mrehkopf/sd2snes/www/themes/editor/img/1.png

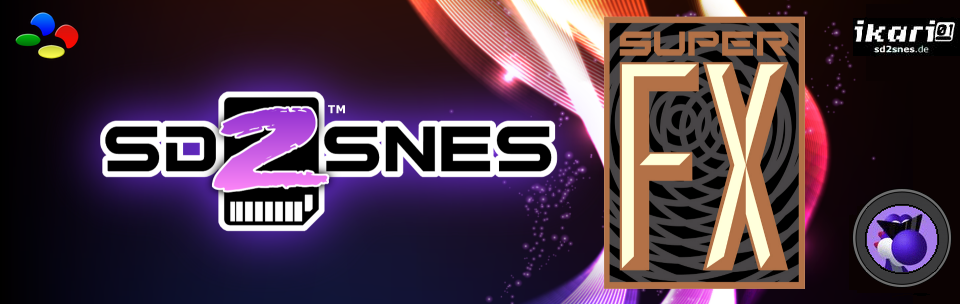
www/themes/editor/img/1.png
