mrehkopf/sd2snes/cic/supercic/1chip-5060-back.jpg

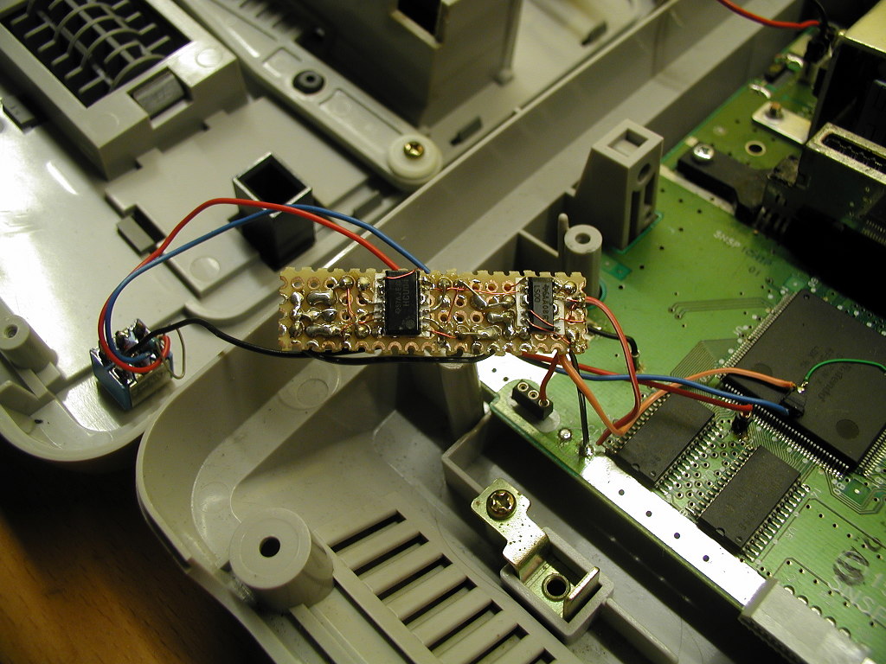
cic/supercic/1chip-5060-back.jpg
