mrehkopf/sd2snes/README.md

sd2snes
=======

SD card based multi-purpose cartridge for the SNES

See [FURiOUS's README](README.Savestates.FURiOUS.md) for information on Save States!
