mrehkopf/sd2snes/pcb/kicad/prod/sd2snes2A_2NEW/README.txt

sd2snes-PCB_Edges.gbr is the PCB outline file.
