mrehkopf/sd2snes/cic/supercic/1chip-5060-front.jpg

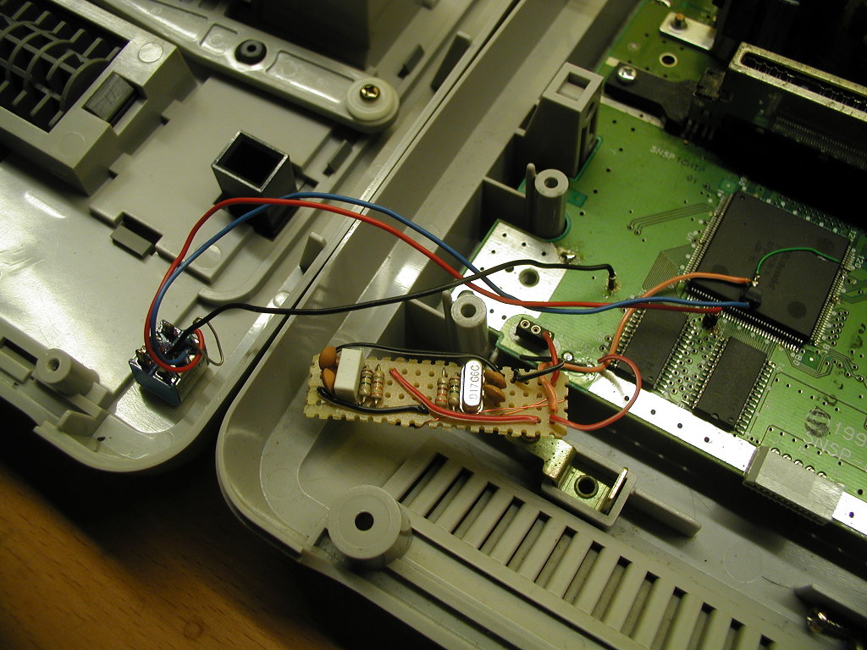
cic/supercic/1chip-5060-front.jpg
