mrehkopf/sd2snes/cic/supercic/supercic-snes.jpg

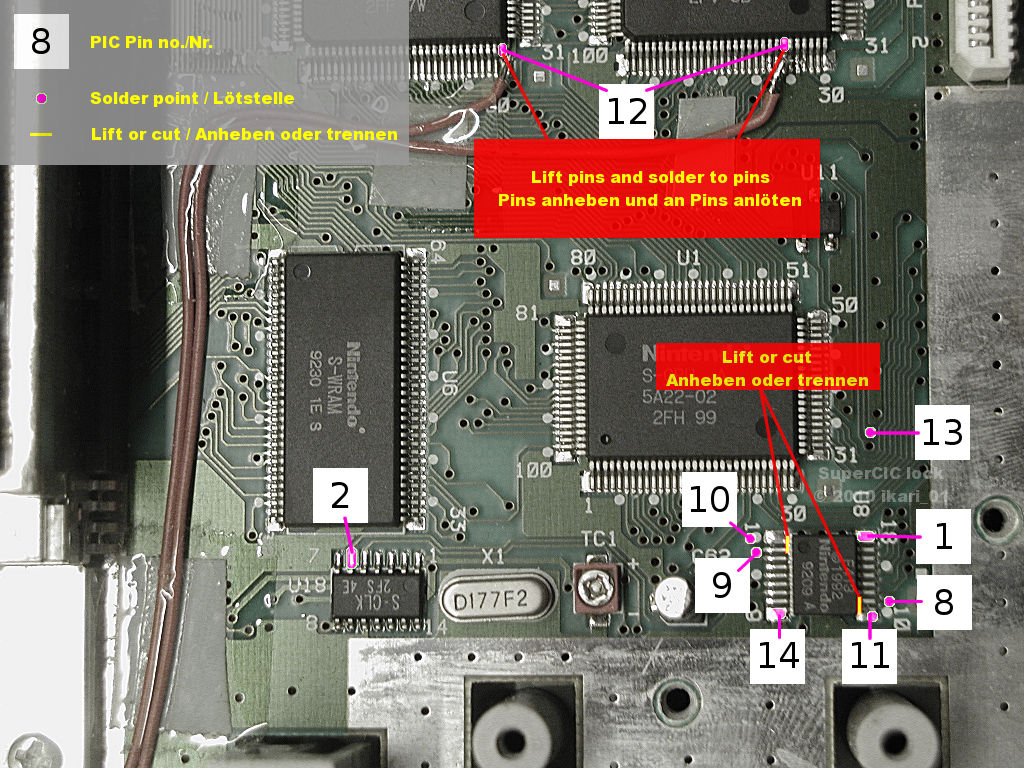
cic/supercic/supercic-snes.jpg
