mrehkopf/sd2snes/cic/supercic/supercic.png

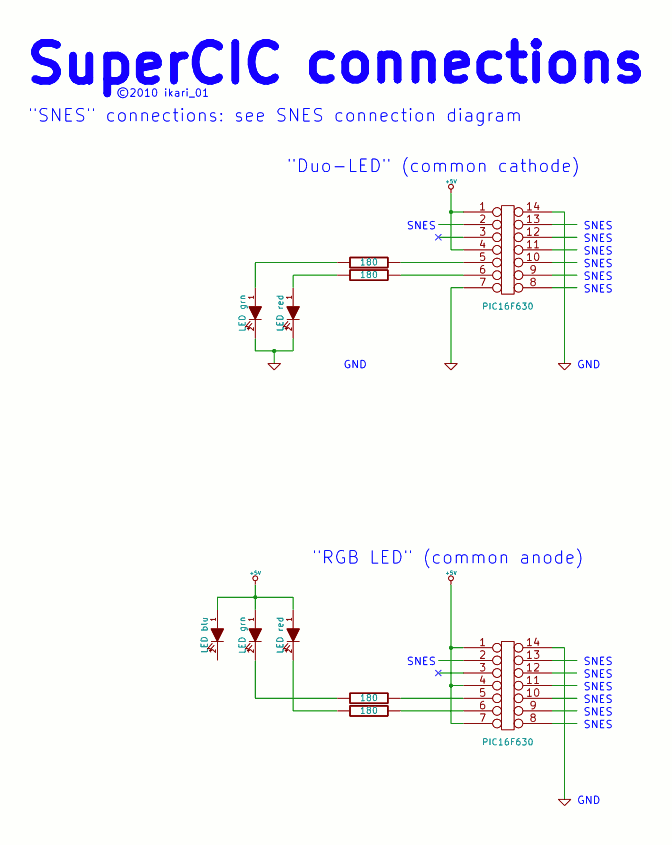
cic/supercic/supercic.png
