mrehkopf/sd2snes/www/themes/editor/img/3.jpg

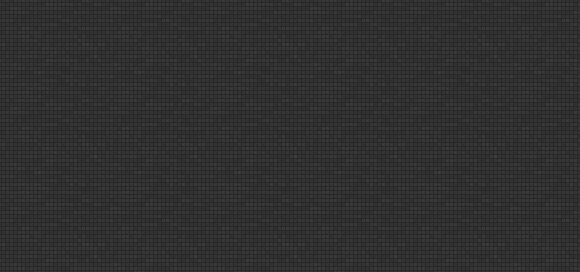
www/themes/editor/img/3.jpg
