mrehkopf/sd2snes/www/themes/editor/img/text_file_1.png

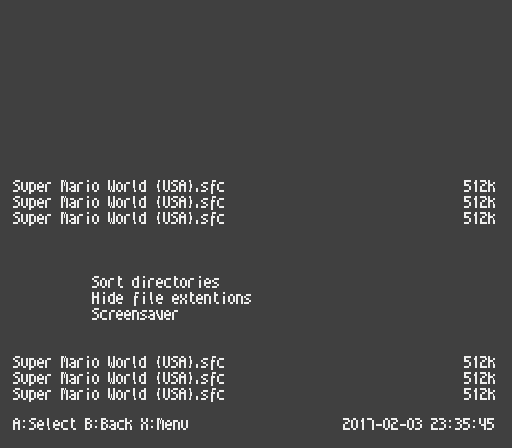
www/themes/editor/img/text_file_1.png
