mrehkopf/sd2snes/www/themes/editor/img/text_folder_1.png

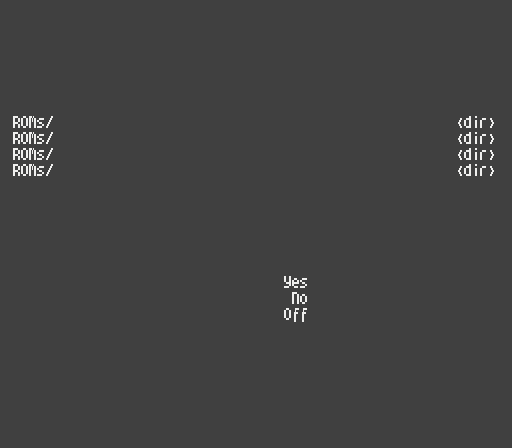
www/themes/editor/img/text_folder_1.png
