mrehkopf/sd2snes/www/themes/editor/img/text_menu_1.png

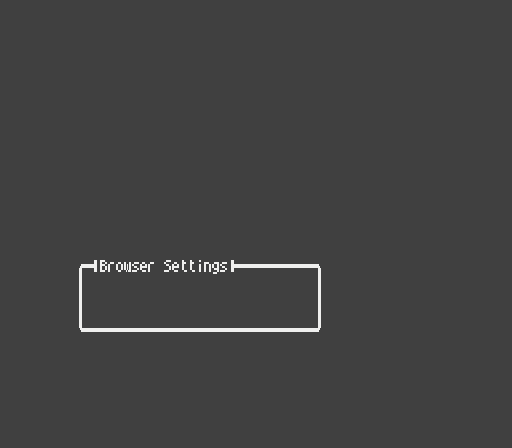
www/themes/editor/img/text_menu_1.png
