mrehkopf/sd2snes/www/themes/editor/img/text_unfocused_3.png

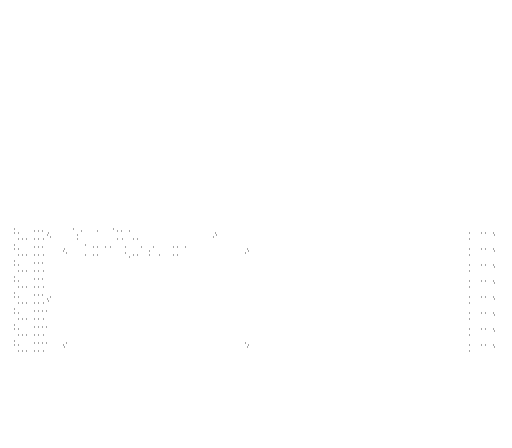
www/themes/editor/img/text_unfocused_3.png
