mrehkopf/sd2snes/www/themes/img/2.png

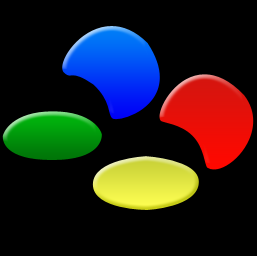
www/themes/img/2.png
