mrehkopf/sd2snes/pcb/kicad/RevF/sd2snes-BOM.ods

sd2snes – bill of materials |  |  |  | Rev.F
open | Suppliers: | CSD | http://www.csd-electronics.de |  |  |  |  | Enter Qty:
in cart |  | Digikey | http://digikey.com
ordered |  | FutE | http://www.futureelectronics.com |  |  |  |  | 1
shipped |  | Reichelt | http://www.reichelt.de
in stock |  | RS | http://rsonline.de
 |  | PCBCart | http://www.pcbcart.com
Designator | Package | Quantity | Designation | Manufacturer | Supplier1 | Ref1 | Supplier2 | Ref2 | Qty (1 pcs.)
BT351 | BT_KEYSTONE_1059_20MM | 1 | Keystone_1059 | Keystone or other | Reichelt | KZH20PCB | Digikey | 1059K-ND | 1
C128,C127,C126,C125,C124,C123,C122,C121,C408,C409 | SM0805_FIXEDMASK | 10 | 10p | * | CSD | 115-08C010 |  |  | 10
C301,C303,C304,C322,C312,C321,C311 | SM0805_FIXEDMASK | 7 | 4.7u X5R/X7R | * | Reichelt | X7R-G0805 4,7/16 |  |  | 7
C302,C347,C349 | SM0805_FIXEDMASK | 3 | 10n | * | CSD | 115-08N010 |  |  | 3
C333,C332 | SM0805_FIXEDMASK | 2 | 100p | * | CSD | 115-08C100 |  |  | 2
C342 | SM0805_FIXEDMASK | 1 | 1u X5R/X7R | * | CSD | 115-08R001 |  |  | 1
C348,C346 | SM0805_FIXEDMASK | 2 | 3.3u X5R/X7R | * | RS | 698-3560 |  |  | 2
C407,C406 | SM0805_FIXEDMASK | 2 | 33p | * | CSD | 115-08C033 |  |  | 2
C411,C344,C345 | SM0805_FIXEDMASK | 3 | 10u X5R | * | Reichelt | X5R-G0805 10/16 |  |  | 3
C412,C405,C502,C511,C501,C116,C115,C114,C103,C102,C101,C341,C331,C222,C221,C213,C212,C211,C210,C208,C207,C206,C205,C204,C203,C202,C201,C223,C224,C401,C402,C403,C404,C343,C104,C105,C106,C113,C112,C111,C214,C209,C231,C215,C232,C233,C234 | SM0805_FIXEDMASK | 47 | 100n | * | CSD | 115-08N100 |  |  | 47
D401 | LED-3MM-FIXED | 1 | LED_2mA_1.9V,_green | Kingbright | Reichelt | LED 3MM 2MA GN | other low current types ok |  | 1
D402 | LED-3MM-FIXED | 1 | LED_2mA_1.8V,_yellow | Kingbright | Reichelt | LED 3MM 2MA GE | other low current types ok |  | 1
D403 | LED-3MM-FIXED | 1 | LED_2mA_1.7V,_red | Kingbright | Reichelt | LED 3MM 2MA RT | other low current types ok |  | 1
D401, D402, D403 | SPACER | 3 | LED SPACER .250“ T1 | Keystone or other | Digikey | 7358K-ND |  |  | 3
D511 | SOT23EBC | 1 | BAT54C | Fairchild or other | Reichelt | BAT 54C SMD |  |  | 1
FB341 | SM0805_FIXEDMASK | 1 | LF0805A252R-10 | Laird | Digikey | 240-2563-1-ND |  |  | 1
J411 | HRS-DM1AA | 1 | DM1AA-SF-PEJ(21) | Hirose | RS | 502-5004 |  |  | 1
J421 | USB-MINIB | 1 | 690-005-299-043 | EDAC | Digikey | 151-1206-1-ND | Reichelt | USB BWM SMD | 1
JP341 | SM0603 (Ferrite bead!) | 1 | HZ0603A252R-10 | Laird | Digikey | 240-2561-1-ND |  |  | 1
L302,L301 | SM1210L_NEW | 2 | LQH32PN1R0NN0L | Murata | Digikey | 490-5334-1-ND |  |  | 2
Q301 | SOT23DGS | 1 | IRLML6402PbF | IR | FutE | 1012640 |  |  | 1
Q511,Q101 | SOT23EBC | 2 | MMBT2222A | Fairchild or other | Reichelt | 2N 2222A SMD |  |  | 2
R101 | SM0805_FIXEDMASK | 1 | 270 | * | CSD | 10-080270 |  |  | 1
R301,R511 | SM0805_FIXEDMASK | 2 | 20k | * | CSD | 10-08K020 |  |  | 2
R331,R403,R401,R402,R332,R333 | SM0805_FIXEDMASK | 6 | 680 | * | CSD | 10-080680 |  |  | 6
R343,R341 | SM0805_FIXEDMASK | 2 | 470 | * | CSD | 10-080470 |  |  | 2
R404,R344,R342,R407 | SM0805_FIXEDMASK | 4 | 10k | * | CSD | 10-08K010 (reel) |  |  | 4
R406,R405 | SM0805_FIXEDMASK | 2 | 100 | * | CSD | 10-080100 |  |  | 2
R421,R422 | SM0805_FIXEDMASK | 2 | 33 | * | CSD | 10-080033 |  |  | 2
R423 | SM0805_FIXEDMASK | 1 | 1.5k | * | CSD | 10-08K001,5 |  |  | 1
R512,R103 | SM0805_FIXEDMASK | 2 | 4k7 | * | CSD | 10-08K004,7 |  |  | 2
R513,R102 | SM0805_FIXEDMASK | 2 | 100k | * | CSD | 10-08K100 (reel) |  |  | 2
RA101,RA102,RA105,RA106,RA107,RA108,RA109,RA110,RA111,RA112,RA113,RA114 | RA4_1206 | 12 | 4x100R_parallel | e.g. Rohm | Digikey | RHM1594CT-ND |  |  | 12
RA103,RA104 | FB4_1206 | 2 | BK32164M241-T | Taiyo Yuden | Digikey | 587-2690-1-ND |  |  | 2
U101,U103,U102 | TSSOP48 | 3 | 74ALVC164245DGG | TI, NXP | Digikey | 568-1377-5-ND | RS | 662-6374 | 3
U201 | PQFP208 | 1 | XC3S400-PQ208 | Xilinx | Digikey | 122-1519-ND |  |  | 1
U301 | QFN10-2x2 | 1 | MIC23250-S4YMT | Micrel | FutE | 5760004 | Digikey | 576-3561-1-ND | 1
U311 | SOT23-5 | 1 | MCP1824T-1802E/OT | Microchip | Digikey | MCP1824T-1802E/OTCT-ND |  |  | 1
U321 | SOT23-5 | 1 | MCP1824T-2502E/OT | Microchip | Digikey | MCP1824T-2502E/OTCT-ND |  |  | 1
U331 | DIP-8__300 | 1 | PIC12F629I/P | Microchip | Reichelt | PIC 12F629-I/P |  |  | 1
U341 | TSSOP10 | 1 | CS4344-CZZ | Cirrus | Digikey | 598-1051-5-ND | CSD | 21455 | 1
U401 | LQFP80-.5 | 1 | LPC1754FBD80 | NXP | Digikey | 568-4790-ND | FutE |  | 1
U501 | VFBGA54 | 1 | MT45W8MW16BGX-701WT/IT | Micron | Digikey | 557-1444-1-ND |  |  | 1
U511 | TSOPII-32 | 1 | CY62148EV30LL-45ZSXI | Cypress | FutE |  |  |  | 1
X401 | HC49USMD | 1 | ATS12ASM-1 | CTS-Frequency Controls or other | Digikey | CTX1079CT-ND | Reichelt | 12,0000- HC49-SMD | 1
X402 | XTAL_SMD_05019 | 1 | ABS10-32.768KHZ-9-T | Abracon Corporation or other 9pF | Digikey | 535-9538-1-ND | Reichelt | 32,768 CC4V-9 | 1
L391 | SM1210L_NEW | 1 | LQH32CN100K23 | Murata | Digikey | 587-2679-1-ND |  |  | 1
C391 | SM1210 | 1 | GRM31CR60J107ME39L | Murata | Digikey | 490-4539-1-ND |  |  | 1
