mrehkopf/sd2snes/(threads)

Thread 11 (2012-04-04):

Satellaview hardware seems to interfere with compatibility.

KiddoCabbusses, 2012-04-04:
I've discussed this with ikari_01 over IRC already, but here it is up here so anyone else who wants to discuss it may know.

Certain ROMs may behave differently depending on whether or not the sd2snes is connected to a Super Famicom with a Satellaview hardware base attached, or a more standard setup.
Currently the known examples are the "BS The Legend of Zelda: Ancient Stone Tablets" ROM hacks, where they operate as expected on a sd2snes, but bug out when a Satellaview hardware base is plugged in.
I will note that on my previous ROM loader, the SFC Neo Myth, whether or not the Satellaview hardware was plugged in had no effect on the compatibility.

http://z9.invisionfree.com/bszelda/index.php?showtopic=1275&view=findpost&p=22000060

mrehkopf, 2016-06-20:
Super Bomberman has been fixed in the meantime, the cause being that the BSX BIOS itself crashes when attempting to load games to PSRAM from Type 2 packs (seriously).
The fix was to implement Type 1 packs instead. The light on the base unit lighting up was probably just a rogue write carried out by the crashing BIOS.
Do any issues remain with the base unit attached? The only thing I could do about it would be to disable all base unit related features on the sd2snes when a real base unit is detected. It will affect compatibility though (clock packets etc.)

mrehkopf, 2018-04-13:
Bump

mrehkopf, 2018-12-19:
#106

Closed 2018-12-19.

Thread 28 (2012-09-23):

Part-size BS-X games might not have their checksum calculated correctly

redeemer665, 2012-09-23:
When checking and calculating the checksum of BS-X software upon booting it should be done only on the data banks indicated by the size byte at 0x7FD0 (or 0xFFD0), instead of simply summing all bytes in the ROM image. This is especially crucial with 8M cartridge images which have more than one program.

However there might be something else as well as I did a quick test with "BS Satesupo  DX Dai-4-Gou" (MD5: 442384ED70AF69F594C8CEC93E6DE81E) which has a size byte of 07h meaning the data is in the first three banks (3 Mb). Checksum is correct but it won't boot on sd2snes, it isn't giving me "Error 09" though.

When I change the internal size (0x7FD0) to FFh, ROM type byte (0x7FD9) to Full size (10h) and calculate a new checksum (5AD2, inverse A52D) everything works perfectly.

mrehkopf, 2016-09-21:
The standalone 3ji no Wide Shou dump is an interesting case - it has a seemingly invalid header (vector table is filled with 0xffff) but the BSX BIOS knows how to run it anyway. sd2snes currently doesn't detect a valid header (every possible header locations gets a score of 0 due to the invalid vector table) and runs it as fallback (plain LoROM, no BSX). Needless to say that doesn't work either. ;) I tweaked header detection a bit to allow for detection, hopefully with no impact on other (mostly PD) ROM detection.

@LuigiBlood - have you seen something like it? How does the BSX BIOS know how to run such a game?

LuigiBlood, 2016-09-21:
It's a ROM that runs on BS-X's script system.
The header has the info, after "01", you see 0x00000100 (in little endian). That's what tells the BS-X it is a script-based software.

Closed 2018-11-20.

Thread 31 (2012-10-20):

Feature request: Favorites list

magu, 2012-10-20:
It would be awesome to have the possibility to flag certain roms as favorites, and then to be able to filter by that. This would significantly help when browsing a large rom collection, so you could just flag what you for example currently play to find it quickly in the list instead of moving stuff around physically on the file system to a "currently playing" or favorites folder.

Easy way to implement this UI-wise would be to for example toggle favorite status with one button in the file browser, and then have another button switch between the file browser and a sorted list of favorites. Favorite status could be indicated with anything subtile in the file browser, like a small asterisk next to rom size, or anything similar. Toggling favorite status wile browsing the favorites list would also remove the rom from the list instantaneously.

(By the way, the sd2snes is awesome! Got mine yesterday and couldn't be more satisfied.)

mrehkopf, 2021-08-02:
Integrated in v1.11.0b1 :)

Closed 2021-08-02.

Thread 32 (2012-10-20):

Feature request: Force region of sd2snes menu

magu, 2012-10-20:
My SNES is a PAL one with SuperCIC and IGR installed. The SuperCIC is wired with REG_TIMEOUT set to high, and i normally use it with force 60 Hz. Since the sd2snes detects the SNES as being a PAL one (I assume) it identifies as a PAL game, thus making the timeout trigger and show the sd2snes menu in 50 Hz for ~9 seconds on every boot.

This is quite annoying, and it would be awesome to be able to force the sd2snes menu to identify as a particular region, through a menu item or the like. (I could of course open the SNES up and rewire REG_TIMEOUT to low, but I quite like it this way when playing original cassettes.)

I assume this is sort of related to "supports software 50/60Hz switching on SuperCIC enhanced consoles only (to be performed by sd2snes firmware, not yet implemented there)", and perhaps will get added when that is implemented.

magu, 2015-09-19:
Am I correct in noting that this is now implemented in 0.1.7pre4? I've set the config file to force 60 Hz/60 Hz, and never see the abominable 50 Hz stripes any more.

mrehkopf, 2015-09-20:
Yes, if you also set PairModeAllowed to true it will do that exactly. ;)

magu, 2015-09-20:
Yup, I had done that. This makes me happy, and my 5 years old son less confused. Thanks a bunch!

mrehkopf, 2016-06-20:
Implemented and integrated in v0.1.7b

Closed 2016-06-20.

Thread 33 (2012-10-22):

Disable automatic region patching on Ultra16 consoles

mrehkopf, 2012-10-22:
The Ultra16 has its own region patching circuitry that the sd2snes interferes with, producing an Error 6 or Error 7 on startup. This does not harm normal operation and can be safely ignored, but is annoying.
Detect the Ultra16 hardware and disable the sd2snes's region patching accordingly.

mrehkopf, 2016-09-09:
AFAIK we have this in working condition now? U16 doesn't spew any more errors. :)

Closed 2016-09-09.

Thread 39 (2013-08-06):

Feature request: cheat code support

sammargh, 2013-08-06:
It would be nice if SD2SNES would support PAR/GG codes on games. Krikzz has been also implementing a load cheats from txt file on his everdrives as of recent which is extremely handy for lengthy codes. What would be ideal would be to setup a large flat file with identifiers such as the CRC or the header content and use YAML or something similar to have something much easier to manage.

mrehkopf, 2015-06-22:
Actually there seem to be two different versions of the CHT format. The one that says "FE FC" has 20 character descriptions. There is another one with different values that only has 13 character descriptions. I never saw that one in the wild but zsnes source code suggests its existence.

sammargh, 2015-06-22:
Maybe it'd be better to use the DSTwo CHT format as it's more human-readable and won't require hex editors to create:
https://gbatemp.net/threads/guide-make-snes-cht-files-for-the-dstwo.263113/

Would require manually converting GG codes but it would at least allow for a single file for all roms. This also would get around the limitation of figuring out which rom to use as it is up to the user to identify or to add a CRC field in the GameInfo portion if you want to limit the usage.

sammargh, 2015-06-22:
Ah, whoops. Looks like the emulator CATSFC switched to BSNES-style cheats. Pretty clean format, XML driven using SHA256 for rom identification:
```xml
<cartridge sha256="44428a3d1c796fbd41da7620e321c45f11cd80a0e5f4ab8c48177106cb960d77">
<name>Wolverine - Adamantium Rage (USA)</name>
<cheat>
<description>Invincibility</description>
<code>7E00B8FF</code>
</cheat>
</cartridge>
```

mrehkopf, 2015-06-22:
Checksum driven auto game matching isn't very feasible on the sd2snes. Finding cheats for a given ROM might be ok as you only need to calc the ROM checksum (but still need to scan through the whole cheats file).
Finding a ROM based on a given checksum is impossible, all ROMs would have to be scanned and calculated. Takes hours at best ;)
I think I'll stick with the "one file per ROM" method. I'm not a big fan of the SNES .CHT format anymore though - the description text is so limited, and it doesn't support multiple codes per cheat.
I like a format like this, it's simple to parse and still somewhat editable by hand:
```
7e00b8ff Invincibility
7e0f34ff, 7e0f35ff, 7e0f36ff Highscore On
ec8ad793 Jump
```
I could also stick to an existing format used by a flash cart but I think neither SNES Powerpak nor Super Everdrive actually save codes to card?

sammargh, 2015-06-22:
I know the super everdrive supports loading cheats from a txt file however it's GG only and pretty limited in how it works. Basically you make a text file with only the GG code in it and the Everdrive loads it. Not very elegant and your solution would work better plus those codes could easily be converted and adapted to your format.

One thing that would be nice but not necessary is if you could have a sub-directory to your roms for the cheats to be loaded from to keep things organized

mrehkopf, 2015-06-23:
I see. I might release an intermediate version with a "text-file only" cheat interface and of course I'd like to re-use that format for the GUI controlled cheats later. Another proposal, this would be a disabled cheat:
```
#7e00b8ff Invincibility
```
Actually I would regard any line that doesn't start with a parseable hex number as disabled/invalid.
Also I would like to support both GG and PAR codes for manual input. They can be distinguished by the '-' character in the middle.
I also want to allow GG and PAR codes in the GUI but always handle them as PAR codes internally (and save them to the text file that way too).
Oh, and I forgot to mention - I was actually going to put the cheat files in a separate folder (like /sd2snes/cheats) with <romname.cht> or similar.
As I am now going to use my own format for the cheats, do you think it would be better to choose a different file extension, too? .cht is kind of reserved for the original CHT format. Just .txt maybe? But then it's not very clear that the files are meant to contain cheats.... hm.

sammargh, 2015-06-23:
Probably would be wise to use a different format for the extension so people don't confuse the type. One last consideration which may or may not be possible is to use YAML for the codes as that would make editing them and reading them quite easy for a human as well as parsing but I'm not sure how powerful the FPGA is or if it is even capable of parsing/editing YAML. An example could be as such:

Filename: Example Rom (USA).sfc
Cheat name: cheats/Example Rom (USA).yml
```yaml
---
- Name: Invincibility
  Code:
   AAAA-AAAA
   BBBB-BBBB
  Enabled:
   True
- Name: Infinite Money
  Code:
   12345678
  Enabled:
   False
```

Then to enable/disable it requires changing the boolean flag on each code.

Also be sure that whatever filename matching you are using is not prone to the 8.3 bug that SRAM lookup has where if you have multiple files it doesn't assume the first of multiple files by not using the long name.

mrehkopf, 2015-06-23:
YAML seems like a sane choice, very readable (as opposed to say XML) and easy to parse. I think I'll go for that. Also it has been suggested by two people now ;)
I have proper LFN support in place so there should never be any file name mismatches.

magu, 2015-06-24:
+1 YAML, makes it three.

mrehkopf, 2015-06-24:
YAML it is, then.

mrehkopf, 2015-06-24:
The parser/generator will be minimalist, probably even supporting only even a subset of the eYAML parser proposed here: https://github.com/yaml/YAML2/wiki/eYAML
Advanced features of YAML aren't required for storing the cheat data.

sammargh, 2015-06-24:
Sounds good! When you have the support finalized I'd like to know so I can begin work on some python scripts to handle creating codes.

Using BSNES' system I should be able to handle implementing codes from existing packs pretty easily for any game regardless of knowing the file name since they're identified by sha256 and reformat codes accordingly.

mrehkopf, 2015-07-10:
Generic parser is done, now to bolt on the specifics for cheat files.

mrehkopf, 2016-06-20:
Cheats via YAML files are implemented since v0.1.7. Stay tuned for the cheat menu in v0.1.8 ;)

Closed 2016-06-20.

Thread 51 (2015-03-31):

Acoustic warning on in-game file system errors

mrehkopf, 2015-03-31:
Many sd2snes sold on the market have shells that conceal the LEDs so the LED blink codes cannot be seen. Attempt to play an acoustic warning when auto-saving fails for some reason.

TheShadowRunner, 2017-03-28:
I think this would be most suited :)
[LTTP_Error.zip](https://github.com/mrehkopf/sd2snes/files/876929/LTTP_Error.zip)

ramapcsx2, 2017-04-12:
On that note ( :p ), some kind of SRAM backup would be nice to have as well. When saving fails for some reason, it can wipe out hours of gameplay. It'd be great to have some backup then to go back to.

Thread 53 (2015-04-20):

No sound in MSU1 video player on higan 094 + fix ;-)

Ramsis-SNES, 2015-04-20:
I noticed that the MSU1 video player included in the sd2snes source package doesn't work correctly on higan 094 (there's no sound to be heard). This seems due to the fact that the code doesn't set the volume.

Adding these lines somewhere in the `msu1init` routine (e.g. after line 15) fixed it:

```
    lda #$FF
    sta MSU_VOLUME
```

We should be aware that this means there exists a discrepancy in MSU1 implementation between sd2snes (where the music is played even without the volume register being set) and higan 094. ;-)

mrehkopf, 2015-04-20:
http://forums.nesdev.com/viewtopic.php?p=125863&sid=9d0f832d4cee24791dae503c8187089b#p125863
1st paragraph
Initial volume is kind of mushy in the standard. ;)

mrehkopf, 2015-04-20:
Nevertheless, I agreed upon initial volume 0 and the player will be fixed accordingly

Ramsis-SNES, 2015-04-20:
Cool, thank you! :-)

mrehkopf, 2015-06-22:
This change is now implemented on sd2snes and will be in the 0.1.7 release.

Ramsis-SNES, 2015-06-22:
Sounds good! :D

borti4938, 2015-09-01:
There are several MSU1 videos out there who are not setting the volume register. Hence, with the current implementation you hear nothing as the initial volume is 0.
This 'opposed issue' was reported to me by a snesfreaks-user. I undo commit 412127ed5f71848490c0ac73486f0348d44ae619 for him which resolves his 'problem'.
Maybe it could be useful to set the initial volume using the sd2snes-config

mrehkopf, 2015-09-02:
I'm sort of opposed to going the MS way of supporting all old cruft :D But I'll see to getting a fixed version of my player binary out in a timely manner. So far I know only of my code being affected.

mrehkopf, 2016-10-06:
"timely manner" he said 👍 💯 With the sample rate now fixed at 44100Hz the audio tracks would need to be resampled too! Oh, what to do...

Closed 2018-11-20.

Thread 55 (2015-05-12):

tetris attack, flickering in 1 player stage clear mode

mrbrianedwards, 2015-05-12:
n Tetris Attack, in 1 Player Stage Clear mode, there is a wild flickering while you play, it’s strange, ’cause some foreground elements stay normal, while the background and other parts flicker. Only happens in this 1 Player Stage Clear.

All other modes look fine.

It’s reproducible.

I don’t have a real Tetris Attack cart to compare.

Seems strange, this is the only game I’ve play on SD2SNES that has weird flicker issues.

I'm using this firmware:
Firmware v0.1.7 preview 3

mrehkopf, 2015-05-12:
Thanks for reporting. I'm quite sure it is caused by the IRQ hook routines for in-game buttons and cheats. I'm going to publish a less invasive version shortly which should improve it. Ultimately some games won't like the hook routines at all so I will make an option to disable them.
Meanwhile they can be disabled by pressing L+R+Start+Y at runtime (at least 10 seconds into the game).

crispycritter911, 2015-05-14:
It is because of the in game routines. I've been only able to play it by using an older firmware or disabling the in game routines.

mrehkopf, 2015-06-22:
Cannot be ultimately fixed as long as the in-game routines are in place. v0.1.7 will have an option to disable them by default.

mrehkopf, 2016-02-23:
Menu option to disable in-game hooks has been implemented in 10e9429 and 926673e.

Closed 2016-02-23.

Thread 58 (2015-06-22):

Reset line pulling does not work with Nintendo Super System

mrehkopf, 2015-06-22:
The sd2snes currently resets the SNES after loading a game (and at reset before it is ready) by pulling the /RESET line low on the cartridge slot. This does not successfully reset the Nintendo Super System, crashing it instead. It works after another manual reset carried out on the system itself.
Maybe come up with a different way of resetting into the game (and back into the sd2snes menu) so sd2snes becomes usable on the NSS.

Thread 59 (2015-07-02):

Mario Kart run off course when it is not off course

RockinKat, 2015-07-02:
In Mario Kart, if you get too far off the course, a turtle in a flying cloud will hook you on a fishing line and return you to the center of the track. Playing the game on the sd2snes, the game activates this even if you're still within the track or just over the border. Comparing it to playing with the regular game cartridge, it is not working properly as when playing from the regular game cartridge it is no where near as sensitive letting you drive off-road along the track a lot more.

running 0.1.6

mrehkopf, 2015-07-02:
I've had rare occurrences of this behavior. v0.1.7 will have a reworked bus sampling which looks promising in development stage.

mrehkopf, 2015-08-20:
Please check if this has improved with v0.1.7pre4.

mrehkopf, 2016-02-23:
Very likely finally fixed in 688bd5d.

RockinKat, 2016-04-27:
Hi,

I had to pack up all my things due to a move and haven't had a lot of time to deal with other things...

I recently broke out my SNES and SD2SNES and I updated to v0.1.7b today and tried out Mario Kart and it's still doing it.

https://youtu.be/ltJY250CS_w

crash at 1:55: https://youtu.be/ltJY250CS_w?t=1m55s

off course at 2:38, followed by a crash later on same race. https://youtu.be/ltJY250CS_w?t=2m38s
https://youtu.be/ltJY250CS_w?t=2m58s

crash at 3:50 https://youtu.be/ltJY250CS_w?t=3m50s

off course on first corner repeated at 4:50 https://youtu.be/ltJY250CS_w?t=4m50s
followed by crash at 5:10 https://youtu.be/ltJY250CS_w?t=5m10s

mrehkopf, 2016-04-27:
Just to be sure, is your dsp1b.bin completely intact? ;)

RockinKat, 2016-04-28:
Yes, dsp1b.bin is present in the sd2snes folder.

This is the file copied from the SD card: http://www.thecowsaysmoo.org/rockinkat/files/dsp1b.bin

ramapcsx2, 2016-06-01:
From your video, it looks like you're running a PAL rom?
You can see a glitch on Toad in the intro. That happens when you run the wrong region of the game.

RockinKat, 2016-07-05:
Ah. PAL vs NTSC... I found a different rom set and the issues are gone. Derp. Thank you.

Closed 2016-02-23.

Thread 61 (2015-08-04):

SSF2 glitchy sprites

dasi, 2015-08-04:
Hello. I'm getting jerky, glitchy character graphics on SSF2. I'm using an unmodified 1CHIP-03 Super Famicom with SD2SNES #123 (which I bought back in 2012 but have only just got around to trying out). It happens in both firmware 1.6 and 1.7 preview 3. I've checked the ROM and it's good. Strangely, sometimes if I load another game first and then load SSF2 after, it'll run without glitching. I haven't seen anything similar occur in the dozen or so other games I've tried.

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

mrehkopf, 2015-08-05:
Oh dear, that sure looks like the SNES DMA engine is acting up again. Nawww.
I still don't know why exactly but sometimes the SNES just doesn't carry out DMA transfers (CPU is halted for a few cycles after DMA is triggered, then just continues normal execution as if nothing happened).
This seemed to happen when initializing DMA registers without using them, then pulling the /RESET line to reset the console.(there was severe sprite corruption in Super Ghouls N Ghosts because of that - you might want to check on it, it will occur as soon as level 1 starts.). Using HDMA together with general purpose DMA seems to play a role as well. I'm not sure how I can solve this, the sd2snes menu itself makes heavy use of (H)DMA so hm. Guess I'll try and reproduce it at first.

dasi, 2015-08-05:
)-: Yes, I see the same thing in Super Ghouls'n Ghosts and SF2 Turbo as well. If I can help with testing in any way let me know.

dasi, 2015-08-14:
Hmm. There's sometimes also glitching of the file name text as it appears on screen when using the d-pad to scroll through or switch pages in the sd2snes menu.

mrehkopf, 2015-08-15:
Yes, that is part of the same issue. DMA updates just don't work sometimes. I kind of hate to ask but did you double-check that the firmware upgrade actually worked? Firmware version is displayed in the "System Information" screen, accessible via menu (X button). This should really have been fixed since v0.1.4a.

dasi, 2015-08-15:
Hi mrehkopf . Yes, "Firmware version: 0.1.6".

I bought another Super Famicom last week, a 1CHIP-02 this time, and after some testing the 1CHIP-02 doesn't appear to suffer from the glitching/DMA issue. Another thing I noticed was that the 1CHIP-02 doesn't suffer from the RF-like interference pattern that I see on my 1CHIP-03, either. As presumably you haven't had any other reports of this issue since it was fixed in 0.1.4a, perhaps it's just this particular 1CHIP-03 Super Famicom that's a bit finicky, but then it appears to work fine otherwise. What I ought to do is test it with an actual SSF2 cart and see if it still occurs.

DoctorDan1986, 2015-08-15:
I'm wondering if there's an actual hardware issue with your particular SNES.  Just as an idle curiosity, have you run the SNES test cartridge ROM on that system, and seen if all the checks pass?  I've come across a few SNESes that have failed the APU, and one that had bad work RAM.

dasi, 2015-08-16:
Hi Doc. I've run the SNES Test Cart Ver1.03 burn-in test on my 1CHIP-03 for an hour and everything passes.

mrehkopf, 2015-08-31:
I moved some DMA stuff around and reverted it to "after the 0.1.4a fix, before cleaning up":
https://sd2snes.de/files/v0.1.7pre4-dma-201508311325/menu.bin
Can you overwrite your menu.bin with this and retest?

mrehkopf, 2015-09-03:
Another user who just reported the same problem with a Jr. reported that it has been fixed with the menu.bin posted above. So I'm closing this issue for the time being, please re-test when you get around to it :)

dasi, 2015-09-03:
Hi mrehkopf. I haven't been able to reproduce the problem when using the new menu.bin. Nice work.

mrehkopf, 2015-10-02:
I needed to change the DMA init a bit and would like to make sure it doesn't break this issue again.
Could you re-test for sprite corruption with this menu.bin?
https://sd2snes.de/files/v0.1.7pre4-dma-201510021116/menu.bin
That would be great :)

dasi, 2015-10-10:
Hi mrehkopf. Sorry for the delay. I haven't seen any glitching while testing with the menu.bin above.

mrehkopf, 2015-10-21:
Thanks :)
Hopefully finally fixed in a81dffd.

Closed 2015-10-21.

Thread 62 (2015-08-19):

cx4 register file error / glitchy megaman x2

hippie131, 2015-08-19:
Im using a 1chip-01 north american snes. When I run Megaman x2 on my sd2snes rev F i get glitchy sprites as well as a glitchy title screen and the health bar as well. I also get the register file error when I load the game. On 0.1.6 i still got the error but the game played fine but on 0.1.7 preview 4 i get these glitchy graphics. I got my sd2snes from stoneagegamer almost a year ago.

mrehkopf, 2015-08-20:
I added some multi-cycle constraints to the Cx4 core so it would meet timing. I guess one or more of them are still hazardous.

mrehkopf, 2015-08-20:
Can you replace sd2snes/fpga_cx4.bit with this file and see if it works better?
https://sd2snes.de/files/v0.1.7pre4-cx4-201508200644/fpga_cx4.bit
I tightened a constraint regarding transfer to the register file.

hippie131, 2015-08-20:
Just tried the replacement fpga_cx4.bit file and it fixed the register file error but now I get an immediate rom error (tested on multiple cx4 roms) and the graphics are even more glitchy

mrehkopf, 2015-08-20:
Bugger :) OK, I'll try something else...

hippie131, 2015-08-20:
ah i got the revision wrong. Sorry, it is rev E1 but that is just the sticker on  the back of the cartrage stoneagegamer put on. does that matter at all? is there an easy way to determine this info from the GUI or would I need to open it?

hippie131, 2015-08-20:
Just did more research. I see rev F fixed some 1chip issues. Could this be the problem?

mrehkopf, 2015-08-21:
Most likely not, it was a fix for some analog noise but otherwise shouldn't have any impact.

mrehkopf, 2015-08-21:
https://sd2snes.de/files/v0.1.7pre4-cx4-201508210642/fpga_cx4.bit
Try again please? ;)

hippie131, 2015-08-21:
that fixes the glitchy graphics on both x2 and x3. Thanks. I still get the register file error on both and the immediate rom error on x3 only.

mrehkopf, 2015-08-21:
Hm, better than nothing I guess... going to look further.

mrehkopf, 2015-08-21:
What SNES master clock frequency is shown on the "System Information" screen?

hippie131, 2015-08-21:
21477746Hz

mrehkopf, 2015-08-21:
Good, so it's not like the FPGA is running faster than spec (due to detuned quartz or something).
Still trying to achieve timing closure...

mrehkopf, 2015-08-22:
https://sd2snes.de/files/v0.1.7pre4-cx4-201508221116/fpga_cx4.bit
This one meets timing with some margin, without any multicycle constraints in the Cx4 core. If this doesn't work properly something else must be wrong =)

hippie131, 2015-08-22:
That fixed the immediate rom error on x3 still no glitchy graphics. Both x2 and x3 still have the register file error. Thanks for all the help. The register file error was there in 0.1.6 so do you think its fixable?

mrehkopf, 2015-08-23:
Honestly I don't know at this point :) I need to determine possible causes for the error but I cannot reproduce it on any of my sd2sneses or SNESes. So it might take a while. Do the games work perfectly otherwise?

hippie131, 2015-08-23:
They do seem to

Ripthorn, 2015-08-23:
SNES 1CHIP-03 and SD2SNES Rev E here.
No issues for me on both games with the preview 4.
Faulty SD2SNES maybe?

hippie131, 2015-08-23:
Could be but i cant dish out another 300 bucks to get another. Dont think i can get an exchange either since ive had it over a year. Plus everything seems to work fine. Just that error. Game plays fine.

hippie131, 2015-08-23:
Also the first replacment fpga file fixed the register file error but the glitchy stuff remained

mrehkopf, 2015-08-24:
Do you get a "REGISTER FILE ERROR" on every boot or just when you run the full Cx4 test (hold B on controller 2)? I think the game only runs the IMMEDIATE REGISTER and IMMEDIATE ROM tests otherwise but I'm not 100% sure...

hippie131, 2015-08-24:
Every time i boot a cx4 game

mrehkopf, 2015-08-26:
https://sd2snes.de/files/sd2snes_firmware_v0.1.7pre4cx4_1.zip
I changed more stuff around so multiple files are affected this time... please unpack this like installing a regular firmware update.

mrehkopf, 2015-08-26:
(please verify version "0.1.7 preview 4cx4_1" in system information)

hippie131, 2015-08-26:
that fixes megaman x2 and x3. they both work perfectly without errors. I noticed that obc1 was also altered so i tested metal combat too. it seems there are no sprites. I can hear the music and see the background moving and can hear and see myself getting damaged but no enemies.

mrehkopf, 2015-08-26:
Well, that's good to hear about Cx4 at least :)
Hm. Can you confirm that fpga_obc1.bit is present and intact on card (some 70kB) and that OBC1 works with "vanilla" v0.1.7pre4?

hippie131, 2015-08-26:
confirmed fpga_obc1.bit is indeed on the card at 71kb. obc1 does work with the vanilla v0.1.7pre4.

mrehkopf, 2015-08-27:
I see... maybe I should use the amended data line sampling on the other fpga files too.
Does Mario Kart work properly? Or are the drivers disappearing, jumping around, etc.?

hippie131, 2015-08-27:
Whoa its working fine now. Obc1 works cx4 works perfectly. Everything is good now. Mustve not copied properly. Sorry and thanks for all your help and work on this.

Closed 2015-08-27.

Thread 64 (2015-10-08):

Intermittent SPC playback problems

BMF54123, 2015-10-08:
After upgrading to 0.1.7 pre4 recently, I've experienced some intermittent issues when playing SPCs with the built-in player that, as far as I'm aware, did not exist in 0.1.6. I've observed notes playing at the wrong pitch and samples looping improperly (e.g. a drum sample loops when it shouldn't, causing a machine gun-like effect), primarily in the U.N. Squadron set. Backing out and reloading the SPC (or loading another one) usually fixes the problem, though I believe there was one instance where switching to a different game's set caused the issue to reoccur. This was observed on both an SNS-CPU-RGB-02 and an SNS-CPU-GPM-?? (don't recall the number, and the console is currently in use so I can't check). I haven't experienced any problems loading actual games.

Could this be related to the uninitialized APU RAM issue that was fixed recently?

mrehkopf, 2015-10-08:
The APU init commit is ahead of v0.1.7pre4 so it must be something else... I'll check for any potentially harmful changes.

mrehkopf, 2015-10-08:
APU RAM init might fix the issue though, or at least make it more reproducible. Can you test with this menu.bin? https://sd2snes.de/files/v0.1.7pre4-dma-201510021116/menu.bin

mrehkopf, 2016-10-03:
Figured it out most likely, it was a bug in the bulk RAM transfer routine in the SPC player code. It didn't account for the SNES CPU getting stalled by HDMA and has been present ever since the SPC player has been around ;)

mrehkopf, 2016-10-03:
5335990 addresses this issue and hopefully fixes it.

mrehkopf, 2016-10-06:
Integrated in v0.1.7d

Closed 2016-10-06.

Thread 65 (2015-11-11):

Saves folder for .SRM Files

OverloadedRAM, 2015-11-11:
I was wondering if it would be possible to make the .srm files save to and load from a specific folder instead of the same location of the rom and if the folder doesn't exist it creates one automatically. This feature would be nice if it's possible because things can get a bit cluttered after a while.

xadox-1st, 2015-11-12:
I would also like such an option.

Ramsis-SNES, 2015-11-12:
Seconded. :-)

mrehkopf, 2015-11-12:
Can we implement this statically or do we need it as an option?

Am 12. Nov. 2015 19:45, um 19:45, Ramsis <notifications@github.com> schrieb:
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

MatthewCallis, 2015-11-12:
Sounds like a breaking change for anyone already using saves if you went with it statically. It would leave a much cleaner directory structure though, :+1: statically.

magu, 2015-11-12:
Indeed statically!

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

OverloadedRAM, 2015-11-12:
Statically.

Ramsis-SNES, 2015-11-12:
Make it an option. (Don't get me wrong -- I'd prefer it implemented statically myself, but you'd definitely set the cat among the pigeons if you did. ;-) )

borti4938, 2015-11-13:
Nice idea :)
+1 for a static

Maybe a useful and very userfriendly implementation could be something like:
* look for *filename*.srm in /sd2snes/srm/
  * if present:
    * load it
    * end here
  * if not present:
    * look in folder of loaded game file for *filename*.srm
      * if present:
        * copy it to /sd2snes/srm/
        * delete old file
        * load the new one
        * end here
      * if not present:
        * create new *filename*.srm in /sd2snes/srm/

Quite a long checking chain, but the user don't have to copy all of his save games spreaded over the entiere SD card to a single folder. He don't have to care about this change and proceed as always with a firmware update.

mrehkopf, 2015-11-13:
Get out of my head :D

borti4938, 2015-11-13:
:grin: :sweat_smile:

xadox-1st, 2015-11-13:
An automatic move function would be great, but for start I would already be happy with a non automatic static srm folder.

borti4938, 2015-11-27:
My trail: [Downloadlink] (https://dl.dropboxusercontent.com/u/18680455/SNES-Projects/sd2snes_nightly/sd2snes_v017pre4.3.zip)
If somebody wants to test it, go ahead. *Please forward any bugs regarding the common srm-folder to me.*
It's a current build of my fork with some minor changes as discussed here. (just seven lines of new code: new SRM-Files are created in /sd2snes/saves/ and if not present old ones are tried to move)

xadox-1st, 2015-12-14:
Tested with around 10-20 games. Working fine for me.

OverloadedRAM, 2015-12-24:
same here

Ramsis-SNES, 2016-01-04:
@borti4938, I've only tried your build with a couple games, but it seems to work as expected. :D

I wonder though what happens if there are multiple ROMs with the same name spread over several directories, e.g. like this:

\mama\zelda3.sfc
\papa\zelda3.sfc
\kevin tigris\zelda3.sfc
\vanessa lavinia\zelda3.sfc

In case everyone shares the SRM that was loaded last, I could imagine a domestic occurring rather soon. :D

mrehkopf, 2016-01-04:
An alternative would be to recreate the full ROM path under the SRM
folder. But would that really still be an advantage over putting the
SRMs with the ROMs?

borti4938, 2016-02-12:
Reproducing the folder structure within the /sdsnes/saves/ folder would be nonsense in my point of view.
Actually I do like the option to share SRM-files with my implementation. Now I do have multiple copies of some games in different folders because I can fit it in multiple categories (my folder structure).
If a family uses the same sd2snes with the same SD card (how often does that appear???) and if they don't want to share the SRM file, they do have the option to slightly rename their game copies.

mrehkopf, 2016-02-15:
Requesting pull request :D

mrehkopf, 2016-06-20:
Implemented in v0.1.7b. (with bug #77)

Closed 2016-06-20.

Thread 68 (2016-02-11):

Freeze when user attempts to load a game from the "Recent Games" list that was deleted or moved

Ramsis-SNES, 2016-02-11:
Title says it all, the system just freezes on the "Loading" message. Tapping Reset will mess up the menu, a real power-cycle is needed.

One solution would be to just display a "File not found" error message. Or even more convenient, have no longer valid entries simply vanish from the list. :)

borti4938, 2016-02-11:
you are right - good find on that. I would prefer a validity check after each new power cycle before the list is dumped for the SNES. Not that hard to implement. I gave that one a try ;)

mrehkopf, 2016-02-11:
How slow is it? ;)

borti4938, 2016-02-11:
I don't feel a difference between with and without that check even with a full list.

borti4938, 2016-02-11:
I see: one could change the running order in the middle loop: https://github.com/borti4938/sd2snes/commit/1150572944bf3b79eae54277772b23506735929d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
Might be confusing if someone think about why to run backwards there. It was from my first idea, where I wanted to reuse the cfg_add_last_game()-function.
Should be no differnce though.

Ramsis-SNES, 2016-02-11:
I hardly understand a word that's been said, but I'm glad this is being taken care of, anyway. :D

mrehkopf, 2016-02-15:
Requesting pull request ;)

mrehkopf, 2016-03-14:
There might be an off-by-one in there :D
`file_open (/demos/elix-smashit-pal.sfc, 01) = 0
[...]
file_open (/msu1/[krom]/Touhou-BadApple!30FPS4ColInterlace/Touhou-BadApple!30FPS4ColInterlace.sfc, 01) = 0
file_open (/msu1/sndtest/msu1snd.sfc, 01) = 0
file_open («Ý¿ï‚Wp]µÙÝ;L¤þznÿ¨!)j_óÿe«Md_ëýû¨%B§Í{•äð`Þ+ÿO‚@îbîŸxdˆ„Ÿ¿}¹, 01) = 6`

borti4938, 2016-03-21:
I had something like that implemented incl. a backup-file creation (just in case). But I never tested it so far. I'll try to do that this evening.

Closed 2016-06-20.

Thread 74 (2016-04-27):

USB Mini Type B THT in BOM file, but revF appears to be SMD/SMT

zeruel85, 2016-04-27:
Reading the BOM file in revF directory, it appears that we have to use a Mini USB Type B Through-Hole Technology, but viewing the design in KiCad or in Gerber View, it appears to be a SMD/SMT one.

ccoulton, 2016-09-30:
Also the BOM has a obsolete part that has no optional part, it's the sram, digikey 557-1444-1-ND.

Closed 2016-10-03.

Thread 75 (2016-05-17):

Random characters flashing on the System Information screen

Ramsis-SNES, 2016-05-17:
Go to Main Menu/Settings, wait 'til it's finished calculating disk space and measuring SD access time, and then just stare at your TV without blinking. ;)
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

Tested with a 2-PPU-SNES (PAL, SuperCIC-modded, 50 and 60 Hz mode).

mrehkopf, 2016-06-20:
A little race condition between the string creation (MCU side) and printing (SNES side). Fixed by reordering the string creation.

Closed 2016-09-10.

Thread 78 (2016-07-18):

NES backward-compatibility

eadmaster, 2016-07-18:
A [software solution for this was discussed some years ago in this forum](http://forums.nesdev.com/viewtopic.php?t=5826).

Btw recently many NES implementations in FPGA come up, so it may possible to reuse some of their code and add NES backward-compatibility by emulating the missing chips in hardware?

mrehkopf, 2016-07-23:
I wouldn't say this is generally impossible, though it might be impossible to reach 100% compatibility. Using the 65816 emulation mode should work in most cases unless a game uses 6502 illegal opcodes.
APU can be emulated by the FPGA and output directly via the sd2snes DAC (normally used for MSU1 audio) so that is out of the way.
The trickiest part is getting any picture out of the system. When using the FPGA to emulate a NES PPU and render the picture, the SNES data bus bandwidth becomes the bottleneck. It is impossible to stream a NES resolution picture to VRAM at 60fps.
Alternatively the FPGA could provide a sort of compatibility layer, acting as a PPU to NES code but translating the PPU state so it becomes usable by the S-PPU. In this case it would be necessary to periodically interrupt the CPU to update sprite tables, possible preload some HDMA tables for the upcoming frame, map the rest of the registers accordingly etc. I do not know enough about the NES architecture to answer this thoroughly right now, though ;)

ramapcsx2, 2016-07-23:
Hmm, didn't SuperFX games render on the cartridge and the SNES just pulled the picture in intervals?

mrehkopf, 2016-07-23:
Yes, and so does the Super Gameboy. But both use either lower number of colors, lower resolution, lower framerate, or any combination of the three ;)

mrehkopf, 2016-07-23:
CHR bank switching will probably kill the idea (there are games with more CHR ROM than the SNES has VRAM).

eadmaster, 2016-07-26:
Having 100% compabilibility is not really important for me.
if i get it right, it would be possible to suuport only games having CHR<=128kb in [this list](http://tuxnes.sourceforge.net/nesmapper.txt).
Alternatively, can't you store CHR in the FPGA?

juef17, 2021-08-02:
So this is not exactly a sd2snes feature, but still related to this request: https://github.com/Myself086/Project-Nested

Thread 80 (2016-07-23):

Fix saving for MSU games.

DieKatzchen, 2016-07-23:
I've noticed that all the MSU enhanced games I've seen have required you to reset the system to write the saves to disk. I assume this is because the MSU is using save ram as work ram. Is it possible to add the ability to force a write via some signal the game modder can add to the save code? It could also be used to patch in support for original games which require this workaround.

mrehkopf, 2016-07-23:
The reason it can't save is that the MSU1 system claims the SD Card at all times. (Especially for the MSU data extension it is important that a game can be served data at any time because the MSU1 standard has no flow control mechanism).
I'm not opposed to a feature like this at all but I doubt byuu will allow something like it into the MSU1 standard (which he de-facto "owns")...

DoctorDan1986, 2016-07-24:
I’m going to assume that saving works more or less the same in all games.  So why not have it set up so that when saving occurs, MSU-1 functionality is suspended or stopped until the save is complete, whereupon it is restored?  Yeah, the best that we can hope for is to restart the MSU-1 track, but it’s still a thought.
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

qwertymodo, 2016-08-05:
Would it be possible to wait until bits 6 and 7 of the status register were clear, set both of those bits to mark the MSU-1 as busy, write the save, then clear those flags, and allow the MSU-1 to continue?  Granted, this would basically mean you could only save between track changes, which isn't ideal, but it's a thought.  Or, I believe you currently have the "last game loaded" saved in a config file, would it be possible to use that to have it save the battery-backed SRAM out to the last loaded game file upon power up?  Or is the CMOS battery only used for the RTC and not for the SRAM?  Just a few ideas...

mrehkopf, 2016-09-12:
The secondary RAM on the sd2snes is battery backed but currently unused =) It is intended to serve exactly the purpose you describe.

The other method can be unreliable. Occasional audio dropouts aren't that much of a problem, it's the data extension where things get ugly.
Once a data offset has been requested and the busy flag is cleared, it can never be set again because the MSU1 is designed that way - the SNES program will NEVER check again if data is ready for reading, it just assumes it can go on forever at full DMA speed. This means that if data has been requested even once it will hog the card forever. If we save inbetween and the game decides to continue streaming data just then, it will run into a buffer underrun, reading old buffer contents repeatedly. Depending on the kind of data this might result in anything from an intermittent graphical glitch to a full crash.

I can think of some heuristics however. If the MSU file size is 0 bytes the data extension will never be used. If a game only uses the data extension to play an opening FMV and nothing else, the file read pointer will be at the end of the MSU file when it's done. These are cases when we can assume that the data extension is not going to be used subsequently.
Super Road Blaster frequently requests new data offsets for each corresponding video clip so that can actually work "by design".

qwertymodo, 2018-03-22:
Would it at least be possible to commit the SRAM to the card on a short reset, and not just the long reset that takes you back to the menu?  I've lost more than one save due to forgetting that it has to be the long reset, so I short reset, confirm that the save is there, and power off, only to discover that it never actually wrote the save to the card.

mrehkopf, 2019-06-18:
Surprised I didn't reply to this yet... you're making valid points. I fear Super Road Blaster will have to increase its MSU1 failure timeout from 100ms to something longer ;)
I'll need to make a checklist with all the occasions to sneak in a save.

codemann8, 2020-01-02:
I noticed a couple commits were made around this issue.  Is this close to release-ready?

qwertymodo, 2020-03-14:
I had a couple of thoughts about this today. If the .msu file is 0 bytes, then you can commit the save file on every write to $2005 while the audio busy flag is high, and if no track is currently playing, you can commit it on any write to $2003 while the data busy flag is high. Now there's a chance that a track has been loaded but not started, or else paused when the second case occurs, but that can be mitigated by just latching any writes to $2007 during the save commit and executing them as soon as it's done.

mrehkopf, 2023-03-07:
I did something to that effect but now some games don't like it :) Super Road Blaster actually fails with an MSU1 timeout; Also #155. Appears to need some polish still.

Thread 82 (2016-09-30):

Micron SRAM Obsolete :PCB Question:

ccoulton, 2016-09-30:
I have a Digikey cart I can share of the whole SMT components, however, there is a small hitch.  The SRAM is no seems to be unavailable.  I can share this for anyone in the US for a build, however i'm not sure if any 8x10 pin ram should work, or if there is a reason for that chip directly.

mrehkopf, 2016-10-03:
Unfortunately there is no drop-in replacement for the PSRAM part used. Sorry about that!
ISSI started making PSRAM chips but they are only half the capacity so two would have to be used, requiring new PCB layout and FPGA code.
Alternatively SDRAM could be used but that too would require a new PCB design and significant changes to the FPGA cores, with increased resource requirements.
That said, chip brokers (and alibaba dealers) still seem to have the part available.

ccoulton, 2016-10-04:
found it on alibaba as well soon after... I need to decide if i'm jump off and try and hand solder this project... or learn how to dyi reflow.

Closed 2016-10-03.

Thread 83 (2016-11-29):

0.1.7.d background corruption in Justice League Task Force

rimaille, 2016-11-29:
Hi Ikari, (thanks for your hard and amazing work, really appreciate my sd2snes!)

Using 0.1.7d, i noticed a corruption of background in Justice League Task Force , this issue always occure after a full combat, and return on player selection screen. Sometimes this affects character selection screen, sometimes it is battle background that is flickering.
After choosing character / finishing the round, everything turn back OK. This is not really a problem, the game is  still very playable.

(comments are closed on your site, that's why i post here instead of in game hook compatibility page)

respects,
ekyo

mrehkopf, 2016-11-29:
Thanks for reporting, I'll check and add it to the list!
On a side note, comments aren't closed generally. But the spam filter seems eager to sieve out old user agents, more specifically IE8 on Windows XP. Are you using that? If not, please let me know.

rimaille, 2016-11-30:
You probably found the problem : my user agent is "Mozilla/5.0 (X11; Linux x86_64; rv:50.0) Gecko/20100101 Firefox/50.0" maybe this is too new or too anecdotal for the spam plugin :)
I'll try with a user agent changer plugin to find if it's OK with that (when i'll have something to say)

mrehkopf, 2016-12-03:
Would you mind posting another comment? Anything will do. I enabled temporary logging of blocked comments so I can get a reason code for your comment being blocked.

rimaille, 2016-12-04:
Just did, 2015/12/04 17h57 on the https://sd2snes.de/blog/compatibility/in-game-hook-compatibility#respond page.
Got "ERROR: Comments have been temporarily disabled to prevent spam. Please try again later."
My only addon uBlock Origin was disabled.

rimaille, 2016-12-04:
I changed my referer to send a chrome / windows string, same result.

mrehkopf, 2016-12-04:
Got it:
```
Failed Test Codes:      ['REVD4110']
```
Plugin source:
```
        $banned_tor_exit_nodes = array(
                /* Banned Tor Exit Nodes */
[...]
        "REVD4110" => "~\.proxad\.net$~",
[...]
```
Looks like the spam filter don't like proxad one bit. 😅 IMHO it's a bit far-fetched to consider all proxad.net IPs Tor exit nodes but they seem to be notorious for spam or worse.

rimaille, 2016-12-04:
Thanks for watching your spam plugin traces.
Proxad, is the 2nd internet provider in France (via Free), and they also provide rented servers (via online.net).
I agree with you, it's a bit far fetched =)

mrehkopf, 2016-12-05:
Can you try posting again? I disabled that specific filter.

rimaille, 2016-12-05:
Thanks Ikari, i left a comment successfully (no error message), but as coments are moderated, i can't see yet if it worked.

Closed 2018-11-20.

Thread 85 (2017-03-22):

Autoboot feature for a pre-selected ROM

mrehkopf, 2017-03-22:
Implement a feature to have the sd2snes boot a pre-selected ROM automatically on boot, without user interaction and without showing the menu.
Possible scenarios:
- Interactively select a file for subsequent auto-booting with a bail-out button combination to go back to the menu (more complex solution)
- Just expect a fixed filename (e.g. `autoboot.sfc`) and always boot that file if it exists (simple solution)

MatthewCallis, 2017-03-22:
The second / simple solution leaves the user with no possible way to get out of that game without access to a machine that can read and manipulate the filesystem to change the name of the `autoboot.sfc` or remove it.

mrehkopf, 2017-03-22:
To be fair they'd also need access to such a machine to put the file there in the first place though.

MatthewCallis, 2017-03-22:
Sure, but going to an Expo or something where you want it to autoboot then its over and you just want free play you're stuck.

magu, 2017-03-22:
With the bailout key combination, do you mean escaping from mid game out to menu or sequence to press while booting?

Simplest solution I can figure out would be just turning the SNES on with the A—or even just any—button pressed to clear the auto boot setting and revert to menu. Doesn't have to be any more sophisticated than that.

Optiroc, 2017-03-23:
This is actually a feature I would want to use at home since I usually play just one title until I'm done with it, and skipping going through the menu at each "cold start" would be a win.

Here's my simple suggestion: Have a toggle in settings called "autoboot into latest file" (or preferably something more succinct! "autoboot", "kiosk mode", "kids mode"...). When that is set SD2SNES will always automatically load the last file except when holding a certain button combination. Preferably something easy enough to press using only the right hand so you simultaneously can press `reset` without using your foot. `R + X` or possibly `R + X + A` are my suggestions.

ramapcsx2, 2017-03-28:
Simple solution is the autoboot.sfc + force enabled ingame key hooks + a memory resident flag that an autoboot game ran once. A user that enabled the feature is surely able to remember the back to menu key combo.
May I also suggest mapping the start button to acknowledge, so that starting the last loaded game is a simple double tap on start? This works great in Everdrives :)

DieKatzchen, 2017-08-06:
I dunno, I like Magu's suggestion best. Forcing ingame hooks obviously prevents using this feature with any game that has trouble with ingame hooks. Nintendo has a long tradition of holding a button while booting, though.

rarn, 2017-08-10:
Someone using autoboot will not go back to the menu often. In fact going back often means changing rom, which contradicts the need of autoboot. So I'd say there's no need for fancy bailout thing.
If the long reset could ignore the autoboot flag that would be the easiest, I think.

dhincardoso, 2017-09-25:
Man! Implement the simple solution, it's enough for now for most of us, leave the complicated stuff for later, better have an option, even a simple one, than none. I absolutely agree with @rarn

DhinCardoso, 2017-09-25:
Man! Implement the simple solution, it's enough for now for most of us, leave the complicated stuff for later, better have an option, even a simple one, than none. I absolutely agree with @rarn

DhinCardoso, 2017-10-11:
@tandraschko why you referenced this request to the #86 and then referenced #86 back to #85? =/

2dcomplex, 2020-07-13:
It looks like it's been a couple years since any activity has been posted. Just wanted to chime in and say this would still be a great feature and am in full support of it getting implemented if at all possible.

DhinCardoso, 2020-07-14:
> It looks like it's been a couple years since any activity has been posted. Just wanted to chime in and say this would still be a great feature and am in full support of it getting implemented if at all possible.

Agreed!

CianMclennan, 2023-12-10:
Just to keep this alive. I would also like this feature.

masterquest91, 2024-07-09:
2024 checkpoint. I would use this feature.

AkimSALADIN, 2025-03-22:
Hello! I need this feature, please !

@mrehkopf, can you contact me via Twitter or Discord? I need your help creating this feature.
Just give me the path to and I make the changes.

Basically, load "autoboot.sfc" located in the root of the storage and boot it directly without going through the SD2SNES menu.

Thank you !

Ramsis-SNES, 2025-03-23:
> The second / simple solution leaves the user with no possible way to get out of that game without access to a machine that can read and manipulate the filesystem to change the name of the `autoboot.sfc` or remove it.

8 years later, I strongly agree with @MatthewCallis. :-)

AkimSALADIN, 2025-03-23:
Yes, I know, but I need this functionality for personal purposes, so I would like to know where (in the source code) should go to add this feature please ?

Btw, It's just a suggestion but to avoid being stuck with the "autoboot.sfc" file, we can imagine doing a manipulation that allows you to skip the automatic loading of "autoboot.sfc", for example, start the console and hold the R button on SLOT1 (or SLOT2).
This would allow you to load the SD2SNES menu and then disable the feature in the menu.

mektrix, 2025-06-19:
This would be useful for the Burn-in Test diagnostics rom, I'd love to use my sd2snes for this so I don't have to buy another cart.

Thread 86 (2017-07-06):

Feature request

marvelus10, 2017-07-06:
A one time boot of a rom image, select rom in menu - power off - power on and rom is booted instead of SD2SNES menu. This would be beneficial for loading test roms on broken consoles that will not load games or SD2SNES for that matter. You could select test rom for one time boot and after power off place SD2SNES in broken console and power on.

tandraschko, 2017-10-11:
Sounds like https://github.com/mrehkopf/sd2snes/issues/85

Closed 2017-10-12.

Thread 87 (2017-12-09):

Continue in previous directory instead of dropping to root directory on reset to menu

mrehkopf, 2017-12-09:

TheShadowRunner, 2018-03-20:
Oh nice, nifty request, seconded!

tjstogy, 2018-06-25:
Thirded!

James-F2, 2018-07-25:
With hundreds of roms in one folder, "standing on" the last rom after reset is also important.
The implementation needs to be bug free, in case the user powers off the console in the middle gameplay and deletes the folder/rom from the SD.

This is indeed and important and overlooked feature, hope to see it soon on the SD2SNES.

impetus-maximus, 2021-12-30:
can we please get this implemented? it's hard coming from a Everdrive-N8 Pro with the feature (highlights last ROM), to the FXPAK Pro without it.

Thread 88 (2018-02-11):

LED Brightness

kylophone, 2018-02-11:
The LEDs can be overbearingly bright during use. It'd be nice if there was a configuration to either control the brightness of the LEDs, or to turn them off completely.

mrehkopf, 2018-07-17:
Conveniently the firmware can already do this. Now I just need to expose it via a configuration option.

kylophone, 2018-07-18:
Awesome. This is a simple little feature, and it would be much appreciated!

ramapcsx2, 2018-07-18:
In some cases (cart shells I mean :p), the LED is not exposed and has to shine through the plastic.
If I wanted to make it brighter, I realize I would have to change the current limiting resistor.
Is there some value on how low one can go for these?

@kylophone If the LED is too bright on a product, may I suggest the good old CD marker? :)

mrehkopf, 2018-07-18:
I am not sure what type of LED krikzz is using, I think he recently switched to a very bright type with no diffusion (clear body).
Resistors are 680 Ohms by default, I had originally used low power LEDs @2mA each.
You could also thin the cart shell a bit from the inside =)

mrehkopf, 2018-07-18:
Seems that fairly bright LEDs (900-2800mcd) have a forward voltage of around 1.85-2V at 20mA, so if you calculate your resistor to drop 1.5V (3.3V-1.5V=1.8V) you should be fine. So the smallest "safe" resistor should be around 1.5V/.02A = 75 Ohms.
However, at the full 20mA the LEDs will contribute significantly to the total power consumption of the sd2snes (~100-120mA).

ramapcsx2, 2018-07-18:
Thanks!
I appreciate the formula and ballpark figure for the resistor :)
The shell has already been thinned out and it only helped a little. The LED can be seen in low light conditions now.
I'll try to get the LED current to maybe 5 to 10mA and see if that's enough for daylight visibility.
By the way, I'm only interested in the save / load LED. It's nice to see at what point a game actually writes out a save game :)

kylophone, 2018-08-14:
@mrehkopf, I can take a crack at this myself. Is there a place in the code I should be looking at?

Closed 2018-12-18.

Thread 90 (2018-03-21):

Feature request: auto-play a .spc in the menu from cold boot

TheShadowRunner, 2018-03-21:
As I'd love to switch on the SD2SNES to the tune of the Nintendo Power menu music xD
In this case the spc player wouldn't be displayed, the track just playing in the background.
I hope this is eventually possible (especially if it only takes 3 seconds to load... ^^)

devinacker, 2018-03-23:
I wonder if this could be combined with the auto-boot feature proposed in #85? i.e. instead of automatically loading a ROM, just load a SPC but keep the normal player GUI hidden.

vince94, 2018-04-04:
Relevant: https://www.youtube.com/watch?v=K1Jgv78WCOA

Ramsis-SNES, 2018-04-04:
@vince94
Ooooh, awesome, thanks for posting a link! Matthew Valente is a true genius indeed. :D

Thread 91 (2018-04-01):

MSU-1 seek to current offset cache behavior

qwertymodo, 2018-04-01:
I haven't had a chance to dig into the verilog to determine whether or not this is already implemented this way, so if it is, I apologize. Executing an MSU-1 data seek to the same offset that is currently loaded should essentially be a no-op that immediately returns ready, or else if the read buffer isn't full, it should report busy but continue filling the buffer from its current position and not flush the buffer (i.e. don't actually perform a seek, but just report the buffer busy state as if you did). The reason for this is to allow re-syncing video DMA in the case of a buffer underflow by keeping track of the expected offset in the video player code and executing a seek every single frame. This method would not be feasible if seeking to the current offset actually performed a full seek with buffer flush because you'd incur the full seek and buffer time penalty every time, but if the cache was smart enough not to do that, the best case scenario of performing that seek when no desync had occurred would be essentially free, and so it would be able to continue normally.

mrehkopf, 2018-04-01:
Such optimizations are in place :) See src/msu1.c, function prepare_data (ll. 66)
Cache is only refilled if the address requested is outside the range represented by the current cache page. The busy flag is set by the FPGA and reset by the MCU upon completion so it will remain set for a very short time (probably a couple of S-CPU cycles only).

qwertymodo, 2018-04-01:
Fantastic. I'll try modifying my Chrono Trigger FMV player to implement this.  It's always a bummer trying to show it off only to have it crash halfway through into a seizure-inducing acid trip.

mrehkopf, 2018-04-02:
I don't recall the FMV patch well - are you using your own player or my example player? The latter got an update to hopefully help with erratic DMA behaviour.
If you are using your own - are you using HDMA to set forced blanking ($2100)? The DMA engine doesn't seem to like that very much, dropping DMA transfers at random...

qwertymodo, 2018-04-02:
I'm using my own player code which just sets the forced blanking on a busy loop that just reads the current scanline to wait for the start and end of the force blank period.  Probably not the most efficient way of doing it, but the CPU isn't doing anything else...

I've never had any issues on my smaller (~4GB) SD cards, so I just have one of those dedicated to my FMV games, but I'd like to figure out a solution for the larger cards, and I think this just might do it.

Closed 2018-04-02.

Thread 93 (2018-05-15):

Make default reset behaviour configurable

mrehkopf, 2018-05-15:
Add an option so tapping the reset button can either reset to the game or back to the sd2snes menu.

borti4938, 2018-05-19:
Suggestion: https://github.com/borti4938/sd2snes/commit/5e2da6a78f997372a148542a0aeca2f07540f485

mrehkopf, 2018-07-17:
Cherry-picked, thanks :)

Closed 2018-12-18.

Thread 98 (2018-06-29):

Fire Emblem Issues

mbreeding3, 2018-06-29:
To whom it may concern,

I am trying attempting to play Fire Emblem: Genealogy of the Holy War on my SD2SNES. It works fine up until the prologue is about to begin, at which time the screen goes to black. Is there anything that I can do to fix this?

DieKatzchen, 2018-06-29:
Have you tried disabling in-game hooks? That's always the best place to start.

Optiroc, 2018-06-29:
And remember: if you're playing an old unfinished fan translation *all bets are off*. More often than not these are not properly tested on real hardware.

mbreeding3, 2018-06-29:
@DieKatzchen Yes, that is what I tried first. It still goes out right as the text introducing the Prologue appears on the screen. The text disappears, and then the map never appears. The music continues to play, but nothing happens. The rom works fine on snes9x, just not on SD2SNES.

@Optiroc Right; this is an original Japanese rom that has been patched with the project Naga translation, which is the only completed English translation of the game. Just to make sure that it was not something wrong with the patch, I tried the Japanese rom without the patch, and it still messes up at the same place.

Would it help you guys if I recorded a video of the issue?

mbreeding3, 2018-06-29:
Here is a clip of me running into the issue during a stream yesterday: https://clips.twitch.tv/BoredMiniatureOrcaNotATK

Ramsis-SNES, 2018-06-30:
Hi, I tried the original Japanese ROM just now, and it seems to work just fine. My guess would be that you might have a corrupt ROM file. Have you tried it on higan/bsnes? Also, you might want to post the MD5 sum of your file for comparison (don't forget to remove any 512-byte-long copier header, if present). Mine is d044f97be5fc00bd5e02c935f7e88058.

mbreeding3, 2018-06-30:
Here is my MD5 sum: d044f97be5fc00bd5e02c935f7e88058. It looks identical. Did you try going to the specific point in the game that I am talking about? My rom works perfectly up until then. And there are no issues at all when I play it on snes9x.

Ramsis-SNES, 2018-06-30:
Hi, yes, I started a new game and it got past the prologue screen without issue. Another thing to check would be your SD file system. If you have a different card on hand, try that as well. Also, remove/rename the SRM file of the game and see if that changes anything. Lastly, make sure you have all files from the current v1.8.0 firmware correctly installed in the sd2snes system folder. If if still doesn't work, I'd check out the SD2SNES diagnostics firmware on ikari's website as your PSRAM could be faulty. (Is FE4 the only game that causes trouble?)

mbreeding3, 2018-06-30:
Gotcha, that gives me some stuff to try. I did update to the v1.8.0 firmware last night, but I have not tried any of the other things that you mentioned. Yes, FE4 is the only game that causes trouble.

Thank you for your help; I will try to delve further into this issue tonight. I have plenty of different things to try now, and for that reason I am going to go ahead and close this thread.

Closed 2018-06-30.

Thread 99 (2018-07-04):

Super CIC pair mode not fully working on 0.1.8

josete2k, 2018-07-04:
There are some issues in pair mode with this firmware.

0.1.7e is OK

TheLordkahless214, 2018-07-04:
Also having this issue, system Information reports "SuperCIC Detected, not used" "enhanced" or Pair mode last working correctly for me on 1.7 Preview 4 firmware.

mrehkopf, 2018-07-14:
Thanks for checking @Ramsis-SNES, works fine for me, too.
@josete2k @TheLordkahless214 Are you using a menu.bin from a previous firmware release (due to the custom theme hack)? Did you enable SuperCIC in the configuration menu -> SuperCIC settings?

Ramsis-SNES, 2018-07-14:
Das macht alles keinen Sinn.

TheLordkahless214, 2018-07-14:
I have tried a fresh installation, with new SD card and nothing but the new firmware folder, enabled SuperCIC from the configuration menu still shows "SuperCIC detected, not used"

mrehkopf, 2018-07-14:
Even after another power cycle?

TheLordkahless214, 2018-07-14:
Yes, and it still doesn't work I'm not sure what else to try

mrehkopf, 2018-07-14:
Might be a good idea to downgrade the firmware step by step and see if it actually still works with an older version (unless you did exactly that recently to determine it worked with 0.1.7b).

TheLordkahless214, 2018-07-14:
I updated my post above with photos, I did exactly that and it stops working at 1.7c

mrehkopf, 2018-07-14:
Thanks, I'll see what I can make of that.

TheLordkahless214, 2018-07-14:
You're welcome, and thanks for looking into this, hopefully it's an easy fix

mrehkopf, 2018-07-14:
What exact model is your SNES?

mrehkopf, 2018-07-14:
Found the problem.
In v0.1.7c the CPU clock was raised back from 86MHz to 96MHz. There is a count loop to determine the CIC status (it measures the toggle frequency of a status output pin on the SuperCIC key). It is a simple loop with a fixed number of iterations without any real time control.
The value read back depends on the CPU frequency of the sd2snes and also on the CIC clock frequency coming from the SNES.
The SNES CIC frequency can be:

- 4.000MHz (first models)
- 3.58MHz (NTSC models that run the CIC on the chroma subcarrier frequency)
- 3.54MHz (PAL models that run the CIC on a "fake" chroma subcarrier frequency)
- 3.072MHz (models that run the CIC on a clock output of the SPC700 sound chip)

The firmware needs at least 2500 toggles per measurement to detect SuperCIC enhanced mode.
On a "3.54MHz" sd2snes that I have, the measured toggles at 96MHz CPU frequency are around 2775.
I do not have a SuperCIC modded "3.072MHz" SNES but in proportion I am expecting the readout to be 2775 * 3.072 / 3.54 = **2408** which is less than 2500 and will prevent SuperCIC pair mode detection.
I need to make some more measurements and will then adjust the threshold value so it can detect reliably.

mrehkopf, 2018-07-16:
Fixed in b702b16

Closed 2018-12-18.

Thread 101 (2018-07-17):

"blue flash" when moving my character ...

theDarkFrenchy, 2018-07-17:
Hi !
First my configuration

- 32 inch Samsung 1080p TV set,
- a super nt analogue (last firmware 4.5)
- an SD2SNES (last firmware 1.8.0).
- an SD with roms + MSU 1 versions

trouble : **"blue flash" when you move your character. you can see this flash when go up and down in the game. No blue flash when you stop character.**  the colour of "decor" is correct, only when you are not moving. It's "subtle but the " blue effect" is there !

Which games ?
- secret of evemore (when you move your character in the jungle, up and down...)
- Shadowrun  (when you move your character, up and down, in the near the park, in the beginning of the game...)

I tried the normal rom  and also the MSU 1 version of the games. I didn't try other games (I own physically secret of evemore  and shadowrun..).
I post this issues on the super NT analogue  forums.
Since Sd2snes changed its firmware , I guess it's maybe coming from the new firmware ???

I don't know if I can "degrade" my sd2snes from 1.8.0 to previous one (0.1.7e ) ?

I didn't try to use the EXPERIMENTAL brightness patching for S-CPUN based consoles (1CHIP/Jr).
My system is a super nt analogue  and not a 1CHIP (I sold mine .. so i can't compare or try on a real SNES...).

mrehkopf, 2018-07-17:
It's very likely to be an artifact of your TV's LCD screen (overshoot from overdrive to improve response time). sd2snes couldn't cause this by accident, much less in multiple games.

FiZiX, 2018-07-17:
> I tried the normal rom and also the MSU 1 version of the games. I didn't try other games (I own physically secret of evemore and shadowrun..).

Do you have the same issue when playing the physical copies?

theDarkFrenchy, 2018-07-17:
Ok, first I want to say : my Issue is gone.
my Problem is SOLVED !

Yes I had the same issue with my physical copies !
Everything came from **the settings of  TV Set** : one of  friend who is "geek" , tweaked the settings , "in order to improve the picture quality" .
I'm no geek regarding TV LCD, so....
My problems came from the the "**100 Hz Motion +**" setting...
As soon as I reverted the setting to "OFF" everything was ok ! no more "blue flash"....  :-)

Sorry to bother you...   :-(
Thanks for your help !

mrehkopf, 2018-07-17:
Case closed, issue closed ;-)

Closed 2018-07-17.

Thread 102 (2018-07-17):

S-RTC not detected by homebrew software

Ramsis-SNES, 2018-07-17:
In my [current homebrew RPG build](https://github.com/Ramsis-SNES/furryrpg/blob/ded9a32a167a2f4c0ffd32b871bb80a0877799a1/furryrpg.sfc), S-RTC is ignored, although it all works fine on higan (with a proper manifest.bml, of course). What am I doing wrong?

mrehkopf, 2018-07-17:
Cartridge type 02 does not enable S-RTC - try using 55 :)

Ramsis-SNES, 2018-07-18:
Ouch, totally forgot about the internal SNES ROM "header". ;-) Still no luck though ... What's even more strange, even higan ignores the RTC with cart type $55 (and without the manifest.bml). This is weird ...

Ramsis-SNES, 2018-07-19:
Converting the ROM to ExHiROM (48 Mbit) at least seems to satisfy icarus' heuristics, i. e. the ROM runs correctly on higan even without a manifest file. Gonna test the expanded ROM on my sd2snes later tonight and report back if it makes any change there, too. :)

Ramsis-SNES, 2018-07-19:
And sadly, sd2snes does not acknowledge the S-RTC with the 48 Mbit ROM (and cart type $55), either. :( So apparently, either one of the implementations of detecting S-RTC presence is bugged:

- higan doesn't detect S-RTC in cart type $55, unless ROM makeup is $35 (ExHiROM) (no manifest.bml in both cases)
- sd2snes never detects/supports S-RTC, regardless of cart type/ROM makeup bytes

According to Fullsnes,

> The sequence for setting, and then reading the time is

... something. Why on earth would I want to set the time **before** reading it, anyway?

I did a tracelog on the DKmono 2 intro, and a) it revealed a considerably different codeflow than what Fullsnes suggests, and b) in sd2snes's time.a65 (``gettime`` function), a #$0D command is issued to $2801 right before reading the time, which I duplicated for my own project (even though Fullsnes never mentions it) and which was what it made it work on higan in the first place.

This is silly (just like DKmono 2's intro tune). -_-

For testing purposes, I created a save with DKmono 2 on higan, and sure enough, it works just fine on sd2snes too (i. e., after the "Press Start" screen I get a save selection screen with the RTC running as it should).

Please don't get me wrong @mrehkopf -- not trying to blame your implementation here, but for a developer, it's just so frustrating to see completely opposite results on accurate emus like higan, and real hardware implementations like yours.

Apart from that, I still think that the problem sits in front of the workstation here. XD It'd be nice though if any of you SNES hardware gurus could chime in (BTW, is byuu even on GitHub?), and point me in the right direction.

Thanks, as always! :D

Ramsis-SNES, 2018-07-19:
Okay, quick and interesting correction/update:

- With a ROM bloated to 48 Mbit with Lunar Address, the RTC seems to work, but MSU1 is broken (no bird singing in area $0003)
- With an expanded ROM with my manual workaround (which might be faulty, as Fullsnes is extremely court on ExHiROM, but which is necessary as WLA DX doesn't support ExHiROM natively [yet?]), MSU1 still works but S-RTC is ignored.

Yay.

This is still very silly. :D

mrehkopf, 2018-07-19:
Well for one thing ExHiROM has two headers (one per A23 selected ROM) so make sure to set the cart type byte in both. (sd2snes prefers the one at 0x40ffc0 in the ROM file if it's present)

mrehkopf, 2018-07-19:
How can I check for S-RTC in the build you linked?

Ramsis-SNES, 2018-07-20:
> Well for one thing ExHiROM has two headers

Yep, I was/am aware of that.

> How can I check for S-RTC in the build you linked?

Sorry for my dumbness, but can you please rephrase the question?

BTW, I did some more testing, and it appears the Lunar Expand version 64M indeed behaves as described in my previous comment, but ... the Ramsis™ one actually behaves like this:

1. Upon loading the ROM, no RTC support, but full MSU1 support
2. Upon issuing a reset (either via LRSelStart or the Reset button when in-game hooks are disabled) both RTC and MSU1 support
3. Upon issuing a second reset ... Repeat from step 1.

This isn't just silly, this is absolutely stunning. :D

Here are the two different ROMs in case you don't believe me and/or still have the patience to try it out for yourself:

[https://manuloewe.de/snestuff/temp/furry64.7z](url)

Ramsis-SNES, 2018-07-22:
I did some (read: a ton) more testing/research, and by now I'm pretty sure it's all to do with the way how sd2snes detects MSU1/(and/or)SpecialChip™ presence. Proof-of-concept: Have two identcal ExHiROM ROMs with identical SRM files, but one has a 0-byte .MSU file and at least one PCM track to go with it while the other doesn't, and S-RTC support will oscillate between resets as described above.

Ramsis-SNES, 2018-07-23:
Okay, just to see if my presumption was right, I created a 0-byte MSU file for DKmono2, and tadaa, the RTC on the save selection screen remains at 0:0:0. :) After a reset, it seems to work (it took me to the stupid clock setting screen instead of the save selection though), and after another reset, it didn't work again (0:0:0).

mrehkopf, 2018-07-23:
Nice find! I assume that the reset handler for the MSU1 game loop doesn't reset the S-RTC state as opposed to the "normal" game loop...

Ramsis-SNES, 2018-07-23:
Should be an easy fix, right?

Ramsis-SNES, 2018-07-24:
Yay, thank you so much! :D

Ramsis-SNES, 2018-08-02:
Redguys SA-1 beta firmware incorporates your fix, and it's still kind of broken: When you launch the game from the menu, the RTC isn't detected/working. After 1+ resets, it works (and stays working).

Ramsis-SNES, 2018-12-23:
With the v1.9.0 release, it's still broken, as described in my last post. (Short version: On a 48 Mbit ExHiROM game with MSU-1 and S-RTC, the latter is only detected/used after at least one console reset either via in-game-hook-based button combo or plain old Reset button.)

mrehkopf, 2019-01-15:
I'll scrap the intermediate stuff and do the final FPGA side resetting... could you give me your current test ROM (that presumably somehow displays whether RTC was detected)?

Ramsis-SNES, 2019-01-16:
Sure, just grab the ROM from here: https://github.com/Ramsis-SNES/furryrpg/raw/master/furryrpg.sfc

On first start-up without an SRM file, the game will perform a CRC check, so you might have to wait for that to complete. As soon as the debug menu appears, it should immediately show the current time in the lower right corner of the screen.

mrehkopf, 2021-08-02:
Sorry I was behind the curve for a while. The time shows correctly for me (last tested on v1.11.0b1); are there still any issues?

Ramsis-SNES, 2021-08-02:
Thanks, it seems to have been working as expected since v1.10-ish, so I guess it's time to close this at last. ;-)

Closed 2021-08-02.

Thread 104 (2018-08-03):

Tales of Phantasia random freezes

josete2k, 2018-08-03:
I can play this game with no issues in 0.1.7c but in 1.8.0 it freezes at the intro or in battle.

Jap, Dejap and spanish translation have been tested with same results.

1chip pal supercic console and REV E2 -> REV H moded sd2snes.

Ramsis-SNES, 2018-08-03:
You do realize that with your ridiculous opening random issues just because YOU are having problems, you're effectively thwarting any real progress, do you?

josete2k, 2018-08-04:
I'm not the one with this issues.

0.1.7c is working fine.

Why newer firmwares doesn't?

mrehkopf, 2018-08-04:
So it breaks from v0.1.7c to v0.1.7d, correct?
Did you try the diagnostic firmware already? https://sd2snes.de/blog/cool-stuff/sd2snes-diagnostics

mrehkopf, 2018-08-04:
I just noticed: Rev. E2? Is there a hand written serial number (s/n) on the circuit board? Or does it say manufactured by sd2snes.net on the circuit board?

josete2k, 2018-08-04:
The diagnostics are all passed except CIC not use, USB and DAC.

I had RTC issues once I moded the cart to REVH with Borti's pcb but they're gone by resoldering some components. I have the inductor and capacitor for REVF too.

As I said, the 0.1.7c is fully working and maybe not all pcbs are affected by this issue but I have some friends with same issues and same results.

A fullfilled 00 sram may help but it's strange that some carts are affected a other aren't.

If it was a faulty Drive, it shouldn't work in older firmwares, I think...

And about downgrading, there are some firmwares that can ve reverted for from an actual firmware. If I install 0.1.7 from 0.1.8sa1 I get (not always) an error code on screen, but if I install 0.1.6 and then 0.1.7 there are no problems.

mrehkopf, 2018-08-04:
What error message are you getting? Usually anything to anything should work fine...

Ramsis-SNES, 2018-08-04:
Maybe it's the new voltage regulator in the SNES ...?

josete2k, 2018-08-04:
Not sure... The 0.1.7c still works fine

josete2k, 2018-08-04:
The code (only happen with 0.1.7)

[img]https://www.subeimagenes.com/img/img-20180804-232737-249-1920822.jpg[/img]

I've also made a few videos with firmware 0.1.7e, 0.1.7c and the sa-1 beta.

Let me a few minutes to upload them

josete2k, 2018-08-04:
0.1.7e without any srm files in saves folder...

https://youtu.be/BVsK1N7xrWg

ToP starts the intro sequence, you ca hear some of the first Worlds and freezes.

Star Ocean freezes at the Enix logo (its brighter just at the freeze).

josete2k, 2018-08-04:
0.1.7c

https://youtu.be/nvqzacrXNc0

All working fine. Even with the saves folder empty.

josete2k, 2018-08-04:
0.1.8 sa-1 beta

https://youtu.be/FXdmfQ35Z0o

srm files (00) in saves folder.

Star Ocean seems to be ok.
Tales of Phantasia freezes at the intro (not shown in the video, sorry... it freezes at the end).

josete2k, 2018-08-05:
Yes I hope so.

Some people in forums had same problem with DKC and they fixed it with the 00 srm file.

Maybe is a faulty hardware, but as the 0.1.7c is working I think it can be fixed with software.

josete2k, 2018-08-05:
Little update.

I've tested two NTSC-U snes.

First one has glitches on Mario rpg and Tales Refuse to run...

As this con el nsole has glitches on sa-1 games I think that this is not the best testing console I can use.

The Second one is a snes mini tha has same problem that my 1chip pal.

https://youtu.be/NJTJlb2eMCk

Ramsis-SNES, 2018-08-05:
Oh really. :D

josete2k, 2018-08-05:
test_log

https://pastebin.com/26WjaYg1

ramapcsx2, 2018-08-06:
So it's the SD2SNES itself, probably related to what goes on on SRAM accesses.

Funky how that Tales hang causes that "dynamic audio driver" to not update. It creates a similar sound to really old SNES emulators that didn't implement this properly: Sound effects become a barking dog xD

josete2k, 2018-08-06:
Yes, it seems that it's an sd2snes issue... But where?

I hope it could be fixed in new firmwares as the 0.1.7c is working fine.

PD: I've been playing SMRPG about 2 hours without any issue. So I asume my sd2snes is not "much" faulty. XD

Oh, I forgot to mention... Star Ocean freezes at all too, after the intro sequence.

mrehkopf, 2018-08-06:
[fpga_base.zip](https://github.com/mrehkopf/sd2snes/files/2264002/fpga_base.zip)
Does this work any better? (Copy over a v1.8.0 firmware install, overwrite fpga_base.bit in the sd2snes folder. Only for non-custom-chip games at the moment.)

josete2k, 2018-08-06:
@DoctorDan1986  thanks for the tip.
I've formatted the SD whith SDformatter and I have same results (in a few SD and microSD cards).

@mrehkopf, sorry same issue. I've placed a new sd2snes folder with 1.8.0 files and your fpga_base.bit...

https://www.youtube.com/watch?v=W7jVl2mXZdA

The new srm file is all FF except offset 1F00: 9407070707070707070700303F00FFFF
I don't know if it helps.

josete2k, 2018-08-06:
Is there any way to disable the autosave sram like the MSU games do?

You know, Save to srm when reset is pressed.

I think it should be a good thing to test.

josete2k, 2018-08-07:
Little update.

My friend magno has been checking the Sram access in Top and Star Ocean (he did both spanish translations for each game) and there are some sound variables stored in Sram that may cause the error (access speed maybe?).

The strange thing is that the 0.1.7c hasn't got this issue.

I remember that ikari said that there were changes in the autosave feature in newer firmwares (0.1.7d?) so, is it possible that changes are affecting my sd2snes?

Is possible to add an "autosave option: ON/OFF" in the main menu?

Thanks again.

mrehkopf, 2018-08-07:
@josete2k you could "disable" autosave by removing the SD Card after loading 🤓 but it would still keep monitoring the SRAM contents. But you could place a dummy file (e.g. "tales of phantasia.msu") in the same directory as your ROM (and with the real filename of the ROM). It can have any contents or even 0 bytes.
Then it will go to the MSU loop and stop monitoring the SRAM.

There was a change between v0.1.7c and v0.1.7e regarding the processing of the SNES ROM select line (you didn't tell me yet if it works with v0.1.7d ;) ) I reverted that change in the bitfile attached above.

I'm going to upload another bitfile later. There have been no changes in autosave or access speed, but the glitch filtering and SNES signal sampling points have been slightly adjusted. If that helps I'll blame your SNES for having extremely noisy address lines (or bad contacts). 🤣

josete2k, 2018-08-07:
Nice shot, I'll try tonight.

THANK YOU.

XD remember that I have an usa mini tha has same problem...

mrehkopf, 2018-08-07:
Another thought: It could even be a contact problem on the sd2snes itself, maybe a suboptimal solder joint on some line somewhere between the slot contacts and FPGA, where the contact is "almost good". A high resistance could work well with the v0.1.7c timing but not with the later versions. If I had to guess I would suspect A23 or ROMSEL. ;)

mrehkopf, 2018-08-07:
Hypothesis: It doesn't get one of the address lines right for address decoding, and creates a transition between two addresses on the PSRAM bus mid-cycle, switching between a SaveRAM address (incorrect) and a ROM address (correct). The data delivered by PSRAM then also changes mid-cycle. Based on the data contents of the incorrect memory location this could work better or worse during the transition, which would explain why the SRAM contents matter at all in this equation.

josete2k, 2018-08-07:
Checked lines and they seem all fine, contacts are clean and shiny.

But...msu file has solved the issue!!!!!

Tested with the last 1.0.8 SA-1 V3

josete2k, 2018-08-08:
Tested 0.1.7d

Games not launching :( even with sram or not. NONE OF THEM!!!!

Note that pair cic mode is not working... it seems that system crashes just when pressing A button in the rom.

https://www.youtube.com/watch?v=POpLz4byI48

Back to 0.1.7c (or 1.8.0 sa1v4 with msu file) and they're working again.

I think it's time to think about to get a new cart in the everdrive store. Even so, I think it's a "problem" that should be solved.

Thanks for your support, ikari.

mrehkopf, 2018-08-08:
Interesting. v0.1.7d has a slower ROM access cycle (8 clocks delay instead of 7 in both v0.1.7c and e)
Anyway here's a new bitfile to try. This combines the faster ROM access cycle with the pre-0.1.7e edge detection settings.
[fpga_base2.zip](https://github.com/mrehkopf/sd2snes/files/2272330/fpga_base2.zip)

josete2k, 2018-08-08:
YEAHHHH it works!!!!!!

josete2k, 2018-08-13:
After a few days of testing I can confirm that this fpga_base solves the issue (even in SA-1 beta firmwares).

THANK YOU!!!

Closed 2018-12-18.

Thread 107 (2018-08-22):

some games are not working when is this fixed

wolfenkraft, 2018-08-22:
title says it all, expecting be resolved in one week (08/31/2018)

borti4938, 2018-08-22:
title says nothing. This issue is spam and rediculous imo. reported

wolfenkraft, 2018-08-22:
there are games that are not working, see the official website and stop hating

magu, 2018-08-22:
🤦‍♂️

Ereza, 2018-08-22:
Why don't you fix the issues yourself? I expect you to have fixed all of them by 08/31/2018...

Really, you should close this issue immediately and go learn some manners.

wolfenkraft, 2018-08-22:
you've lost a customer, I'm getting a everdrive now
and the community of it is way friendlier, thanks

magu, 2018-08-22:
If that solves your issue: good for you. To each his own.

As helpful advice, you need some practice in filing actionable support issues though.

wolfenkraft, 2018-08-22:
and you need to do your work and enable support for the unsupported games instead of posting hateful comments

borti4938, 2018-08-22:
You should read first and get to know what the sd2snes project is first instead of opening rediculous issues. Then you may get usefull answers.
sd2snes is an open source project and free to everyone in the community.

> you've lost a customer, I'm getting a everdrive now
> and the community of it is way friendlier, thanks
Ikari is the creator and a hobbiest, not a seller. I guess Krikzz has lost a customer and won back the same customer in one step. And btw: the list of unsupported games for the Super Everdrive is a bit larger than the one for the sd2snes. Also the hardware is not as powerful.

wolfenkraft, 2018-08-22:
please tell me how to reach ikari, I want to talk to himself about this issue and how you handle issues here

sylverb, 2018-08-22:
OMG, is this real ? O_o

magu, 2018-08-22:
*looks around for hidden camera*
🙈🙉🙊

hedgehog1029, 2018-08-22:
this is the funniest issue I've seen in my entire life
how did this person become so entitled???
what do they think they're gonna say to the project leader???

DoctorDan1986, 2018-08-22:
*deep breath*

Wolfenkrant, you are not being particularly clear.  What games do you claim are not working?  Have you updated the firmware to the most recent version?  Are you aware that some games are KNOWN to not work yet?

As we cannot see inside your head to divine your meaning, you will have to be explicit when it comes to the issues you are having.  Take a few minutes, think about how best to describe the issue, and then write it out.  The community is more than willing to lend a hand, but you have to meet us at least halfway.

devinacker, 2018-08-22:
> Wolfenkrant, you are not being particularly clear. What games do you claim are not working? Have you updated the firmware to the most recent version? Are you aware that some games are KNOWN to not work yet?

Based on the discussion so far, I'm pretty sure they're aware of this, and yet are demanding that the single maintainer of the project add support for _every SNES game ever released_ by the end of next week.

Or else they'll, you know, take their business elsewhere and buy an Everdrive (from the same manufacturer) and be able to play even fewer games instead.

Ramsis-SNES, 2018-08-22:
Ri-di-cu-lous. Wolfenkrant, get your Wolfen ass outta here and see a doctor. Please!

magu, 2018-08-22:
@doctordan I see your point, but I don't think he even has any actual problems, since he doesn't appear to even have bought an sd2snes yet, he just seems grumpy that not all games work.

Don't get me wrong here, but I just expect your current endeavour to be fruitless.

magu, 2018-08-22:
Help yourself ...

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

wolfenkraft, 2018-08-22:
thanks

wolfenkraft, 2018-08-22:
i've tried to update the firmware now nothing is working. this is outrageous

justindarc, 2018-08-22:
Your abrasive, entitled, smug attitude is outrageous.

joeydumont, 2018-08-22:
@wolfenkraft "Nothing is working" is not very descriptive. If the sd2snes doesn't boot at all, there is a good chance you didn't put the firmware files in the right place on the SD card. If the sd2snes boots but specific games won't start, please state the problematic games and we'll go from there.

wolfenkraft, 2018-08-22:
I tried to update the firmware now it says FLASH CHECK ERROR (clone?)

magu, 2018-08-22:
Where did you buy your sd2snes from?

wolfenkraft, 2018-08-22:
I don't know why that's important to solve my issue. I got it at a Russian website where I buy all my video games. For a pretty good price krikkz can't compete with

magu, 2018-08-22:
Because that points to it being a cheap clone, which might explain some problems you are having.

magu, 2018-08-22:
Krikkz charges the price he does mainly not out of greed, but because quality costs money to produce.

Also, the error you get "FLASH CHECK ERROR (clone?)" does seem like the firmware detects something funky with your (probably) clone hardware.

wolfenkraft, 2018-08-22:
deelete this

Closed 2018-08-22.

Thread 111 (2018-09-12):

DKC 3 - random black screens with v1.8.0, works on 0.1.7d

robinhedwards, 2018-09-12:
I'm getting random hangs with a black screen (the music continues playing) with Donkey Kong Country 3 (USA) on the current firmware (v1.8.0). Typically the hang occurs before I even manage to play the first level.

Other games seem to work fine on the SD2SNES (though I've only tested a handful), and it also passes all the tests in the diagnostic firmware.

Console is a Super Famicom (2/1/3).

I discovered that by reverting the firmware to 0.1.7d, the game plays fine - I played as far as the second level with no problems. 0.1.7e fails like 1.8.0, so the problem seems to have been introduced between 0.1.7d & e, and persists to the current firmware.

Interesting the same ROM plays fine with v1.8.0 on a Super NT with the same SD2SNES.

I'm happy enough to leave my cartridge on 0.1.7d, but thought it was worthwhile reporting this issue, which may be related to #104.

mrehkopf, 2018-09-12:
Does it help if you use the fpga_base.bit from the file fpga_base2.zip that I attached to the issue that you linked?

robinhedwards, 2018-09-12:
Yes - that seems to fix the issue with v1.8.0 - Only had a quick playthough up to the 2nd level, but I don't think I've ever got that far with the stock v1.8.0 firmware.

Closed 2018-12-18.

Thread 113 (2018-10-05):

Reset to Menu not working at the moment (04. Oct. 2018)

borti4938, 2018-10-05:
I made a build from current sources yesterday. It seems that the reset to menu does not work at the moment - neither short reset (with option short reset to menu enabled). nor long reset nor double reset. Using the reset to menu using in-game hooks gives a black screen (game stops, sound is still running). In this state an additional tap on the reset button returns my sd2snes back to the menu.

I wasn't able to quickly figure out what causes the behaviour. I hope that this is reproducible and this report helps to figure out what's wrong!
Or did I do something wrong?

James-F2, 2018-10-06:
Try to compile redguys sa1b fork, it should be exactly the same up to this point:
https://github.com/RedGuyyyy/sd2snes/tree/sa1b

The latest sa1b fork works correctly with more than a few consoles that I and a few others have tried.

borti4938, 2018-10-06:
Tested today on another console. This time it's working fine.
- console where it does not work anymore: Ultra16 modded (serial 87)
- console where it works: SuperCIC modded
Both consoles SNSP-1Chip-02

Thread 114 (2018-10-23):

Rev. H PCB data?

DevLaTron, 2018-10-23:
Hi,
 I was looking for a Revision H. PCB KiCad or Gerber set, but the repository only contains up to Rev. F. I'd like to construct my own SD2SNES, and of I'd like the OpAmp circuit on board if possible.

Could someone point me in the right direction for the Files?

devinacker, 2018-10-23:
No idea about the origin, but this fork has Altium (but not KiCad) files for Rev. H:
https://github.com/gargan26/sd2snes/tree/develop/pcb/altium/rev_h

DevLaTron, 2018-10-25:
@devinacker Thanks, I managed to pull the board and create Gerber X2 files from it. It seems to be correct from what I can read.

Sadly I haven't managed to convert it to a sensible KiCAD version to create a pull request from. :-/

DevLaTron, 2018-12-27:
Hey together... it's been a while...

since my last post, I've spent quite some time with the schematics of the SD2SNES and its PCB layout.

I've "kobbled" together a Rev. K. branch (WIP, feel free to have a look and tell me how bad it is):

https://github.com/DevLaTron/sd2snes/tree/devlatron/RevKWork

It contains:
- Added OpAmp TS922 + Resistors to AUDIO_R and AUDIO_L output.
- GNDed pin 28 of MC to set HardwareID.
- Changed PCB layout to fit Hirose DM3AT MicroSD  instead of large SD Cards. Rerouted traces to fit new size.
- Fixed and added Library and Footprint files, also converted files to KiCAD 5 format where appropriate.
- Fixed broken Footprints all over the board because of Version and library hickups.
- Make it pass KiCAD DRC.

Open:
- Postion component descriptions in a more sensible way.
- Final logic and design checks. (E.g: Is this sane?)

Closed 2023-03-07.

Thread 126 (2019-06-10):

Super Mario World - Graphics Glitch During Iggy & Larry Battles

shiggypoo, 2019-06-10:
**_Super Mario World_** as well as **_Super Mario All Stars + SMW_** both exhibit this glitch during Iggy’s battle.  It also happens during Larry's (same scene with added fireballs)

It seems that at least two other users on Krikzz forum experienced this.  It happens intermittently, one user claims disabling in-game hooks fixed it but it happens off and on for me either way... more often occurring than not.

**Original forum post:** http://krikzz.com/forum/index.php?topic=7421.15

**Video of issue:** https://youtu.be/AuiWbzxyiqM

- Using latest 1.10.3 firmware on a brand new SD2SNES Pro

- In-game hooks are off (tried with them on, once it didn't happen, but subsequent events it occurred)

- US/Canada NTSC SNES is version 2/1/3 (serial # beginning NU2)

- SD2SNES Pro passes diagnostic firmware and the console passes the burn-in rev D test.

- Recently cleaned pin connector of console with a credit card, 99% isopropyl on a microfibre cloth and canned air.

- ROMs sourced from a no-intro compilation.

mrehkopf, 2019-06-25:
Hmm. Could it be a 1CHIP console despite the serial number?

shiggypoo, 2019-07-02:
Sorry for the delay, I didn’t get a notification and just happened to check in and see your response over the weekend.  I just took it apart and confirmed it is not a 1CHIP model. Board model # is SNS-CPU-GPM-01.

mrehkopf, 2019-07-11:
Now I've seen it too on my GPM-02, doesn't seem to happen every time. Would you check if turning on the setting "Reset patch for clock phase" in the In-game settings helps?

shiggypoo, 2019-07-11:
Aha! Enabling it seems to have done the trick. For me I would experience the glitch around 80% of the time. Now it’s been three times and has not occurred.

I notice that this setting is kept off by default.  Will keeping it enabled have any adverse side effects with other games?

I’ll report back if it happens again. Thanks for your help! :-)

Closed 2020-04-16.

Thread 128 (2019-06-28):

Support for sfroms

piratk, 2019-06-28:
Some emulators and the SNES Mini use "sfrom" rom file format. It would be nice if sd2nes would support these out of the box, so there would be no need to use tools to convert sfrom to SFC.

mrehkopf, 2020-10-13:
This might be of limited use, sfrom files seem to have their BRR audio samples converted to PCM and stored separately so it won't be able to run with audio on a real SNES. But I'm not sure what percentage of sfroms actually uses this format?

piratk, 2020-10-14:
To be honest, I've only seen these roms in the use case I described, when dumping them from one of the mini-consoles. But that said, as there are two mini out there, [with 26 roms in total](https://en.wikipedia.org/wiki/Super_NES_Classic_Edition#Games).

mrehkopf, 2020-10-14:
https://www.reddit.com/r/miniSNES/comments/7p2lzw/discussion_how_do_i_convert_sfrom_to_sfc/
Here DarkAkuma points out that the SFC Mini dumps must have audio converted back from PCM to BRR (the format that the SNES audio chip understands) which entails a loss of sound quality. Also the conversion itself does involve some operations that are computationally expensive on the sd2snes's embedded hardware which will slow down loading a lot.
All things considered I don't think the outcome would be satisfactory, nor justify the effort...

Thread 129 (2019-08-08):

Code for InputViewer/MemoryViewer/FileViewer?

codemann8, 2019-08-08:
I have a couple issues to report for these apps that are included in the release of Usb2Snes, but these apps don't seem to have any source code in both this repository or RedGuyyyy's repository.  Would anyone be able to point me to where the source code exists for these apps, so I can either look into the issues or report the issues?

codemann8, 2020-01-02:
@mrehkopf

Closed 2020-01-03.

Thread 132 (2019-11-28):

SuperCIC 1.13 Not working

LittleRainGames, 2019-11-28:
I've been trying to get it working for a couple days now.

My custom cart wasn't working, so I got an original cic from SMW to see if it was something else, but my cart started working after that.
I also tested the supercic in my SMW cart to no avail.

I just compiled v1.10, and my cic superchip is now working.

I didn't test any versions between 1.10.3 and 1.10.0,
Also I'm using an NTSC console if that makes any difference, cant get console version at the moment, but can if you would like me to.
[Here is picture from my logic analyzer for v1.13](https://forums.nesdev.com/download/file.php?id=16431&mode=view)
It hangs after the first response.

Better take it off the SD2SNES website!

Edit: Since I have my SNES on the bench and it would only take a second I tested v1.10.2 and its also working.

mrehkopf, 2019-12-03:
Hmm, that's interesting because there are no changes to supercic-key.asm between v1.10.2 and v1.10.3. I had a similar problem when prototyping SuperCIC on the MK3 PCBs but it was due to pull-ups I forgot to disable on the I/O pins of the ARM MCU connected to the CIC pins.

LittleRainGames, 2019-12-13:
Hmm, well maybe its worth noting the v1.10.3 that wasn't working for me was downloaded from the SD2Snes website, while the other ones I compiled.

mrehkopf, 2021-08-02:
I updated the precompiled hex archive at https://sd2snes.de/files/supercic.zip which is confirmed working so far. Feel free to re-open if you encounter any issues :)

Closed 2021-08-02.

Thread 133 (2020-01-30):

How to use the FT2232

ImUrX, 2020-01-30:
I'm very sorry to post this here ;-;, i didnt find any way of communicating someone privately so this is the only way I thought I could use effectively.
So I'm gathering the materials to make this but I have the problem that I have never flashed an ARM, how is it done and what I should do. I'm going to get this development board https://i.imgur.com/PXUKYgz.jpg which is a FT2232HL, can I flash it with this? If I can, can you plsplspls tell me how to connect it to the 14 pin header? I read the table but I dont have a JTAG cable included in the board and somewhere to connect it, but I'm sure it's possible somehow. I found this for example https://dzone.com/articles/open-source-ftdi-ft2232-jtag-and-uart-adapter-boar and https://www.allaboutcircuits.com/technical-articles/getting-started-with-openocd-using-ft2232h-adapter-for-swd-debugging/ but I still dont understand ;-;.
Im very sorry to bother anyone who ends up in here replying, I dont have experience in flashing.

Closed 2020-02-01.

Thread 135 (2020-03-01):

please help pic 12f629 it is very expensive. build 12f675?

darleiv, 2020-03-01:
how do I recompile super cic to use the pic 12f675 ??? don't you have this compilation? the 12f629 is too expensive

magu, 2020-03-01:
Using the lock.asm as template and modifying the key file should get you there.
[supercic_12f675.patch.txt](https://github.com/mrehkopf/sd2snes/files/4272229/supercic_12f675.patch.txt)

magu, 2020-03-01:
Haven't got the slightest clue if it works, but it compiles fine. YMMV.

darleiv, 2020-03-01:
> Haven't got the slightest clue if it works, but it compiles fine. YMMV.

I only know how to use vhdl and C # c ++ [] [] BUT I don't know anything
does make file create the file in hex?

darleiv, 2020-03-01:
> Haven't got the slightest clue if it works, but it compiles fine. YMMV.

if you can send the file I test it here at px675

magu, 2020-03-01:
[supercic-key.hex.zip](https://github.com/mrehkopf/sd2snes/files/4272273/supercic-key.hex.zip)

darleiv, 2020-03-01:
at first no work kkk

darleiv, 2020-03-01:
but thanks for the help

darleiv, 2020-03-01:
PIC12F629 and PIC12F675 are 8-Pin Flash-Based 8-Bit CMOS Microcontrollers. The PIC12F629 and PIC12F675 devices are identical, except the PIC12F675 has a 10-bit A/D converter. They come in 8-pin PDIP, SOIC, MLF-S and DFN packages.

mrehkopf, 2020-03-02:
I think for 12F675 the analog pins are enabled as a default and must be set as digital GPIO pins in some place where register bank 1 is selected (below a `bsf STATUS, RP0` instruction):
```
clrf ANSEL
```

darleiv, 2020-03-02:
mrehkopf digital conversion to digital analog. because the 12f675 is not standard for using the firmware already compiled. unfortunately i already spoke with some programmers only that i would be able to do it does not have the tools installed. if you feel like trying to get people to have this option. I am willing to test the compilation. I have all pics of several microchip models here. I tried to compile in MPLAB IDE unfortunately the compilation is not accepted hehe - many people asked me for this on my super IC site 12f675

magu, 2020-03-02:
Just get https://gputils.sourceforge.io and you should be able to compile it yourself.

darleiv, 2020-03-04:
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
too complicated to do? if you can recompile it makes it available to people

cetics, 2020-05-08:
here my hex converted.
https://atariage.com/forums/topic/306540-supercic-for-12f675-here/

mrehkopf, 2021-08-02:
Commit 02873c0594171b95c75514379068b26cd784e0c1 adds support for more PIC models to the compilation.
Pre-compiled hex files can be found here: https://sd2snes.de/files/supercic.zip

darleiv, 2021-11-15:
mrehkopf pic 683 and 675 nowork in GPM one chip 03

Closed 2021-08-02.

Thread 137 (2020-05-23):

Bug while DMA from msu to vram.

gizaha, 2020-05-23:
Test1: I have vram graphics in msu file, address $34d3. I dma them to vram but sends only $b2d length (34d3+b2d=4000).
Test2: I move the data to msu address $4000 and dma is working ok.

Other times (ingame), i set address to $2000-$2003 wait for data busy, dma data and (sometimes) it reads from wrong (advance) address.

Both problems at vblank. I tried f-blank and close hdma, no difference.
No MSU music is playing to lighten the load.
US sd2snes 1.10.3, pal snes 2/1/3
SD card has avg 1.275ms  and max 1.696ms

mrehkopf, 2020-06-01:
Hi,
1. what happens after copying $b2d bytes?
2. can you estimate how much the address is advanced after the busy loop?
Could you provide example code?

gizaha, 2020-06-02:
1) Dma stops.
2) Because one picture is a thousand words, check it yourself to see the
buffer overflow.
Use left right and keys.
Jump from address 200 to 4000 (keys X-A) to see what happens. If you press
A again, its correct.
If you have access to uart for read printf you will gain time.

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

;sd2snes test rom

hirom
;vectors
	org $ffc0
		db "sd2snes test rom"
	org $ffd5
		db $31		;3.58mhz hirom map mode 21
		db 0		;without coprocessor
		db $9		;32mbit (9=4mbit, c=32)
		db 0		;no ram
		db $14		;region=other
		db $33		;fixed value

	org $ffea
		dw nmi_code

	org $fffc
		dw reset

org $8000
reset:
;set cpu native mode
	sei
	lda #$01
	sta $4200
	stz $420c
	lda #$8f
	sta $2100
	clc
	xce
;setup stack
	rep #$10
	ldx #$01ff
	txs
;setup bank
	phk
	plb
;setup direct page
	rep #$20
	lda #$0000
	tcd

;setup screen mode
	sep #$30
	lda #$01
	sta $2105		;screen mode
	stz $2106		;mosaic
	lda #$f8/2
	sta $2107
	lda #$f0/2
	sta $2108
	sta $2109

	stz $210b		;bg1/2 char address
	stz $210c		;bg3/4 char address
	stz $210d
	stz $210d		;bg1 hor scroll
	stz $210e
	stz $210e		;bg1 vertical scroll

	lda #$80
	sta $2115		;video port control (2118/9 inc)

	stz $2121		;cgram address
	stz $2122		;first color in palette=black
	stz $2122

	stz $2123		;bg12 window disable
	stz $2124		;bg34 window disable
	stz $2125		;oam window disable

	stz $212a		;mask
	stz $212b		;mask
	lda #$01
	sta $212c		;bg1 mainscreen
	sta $212d		;subscreen
	stz $212e		;mainscreen window disable
	stz $212f		;subscreen window disable

	stz $2130		;color addition
	lda #$01
	sta $2131		;color math
	lda #$e0
	sta $2132		;bg color
	stz $2133		;disable pseudohires
;set linear tilemap
	rep #$20
	lda #$f800/2
	sta $2116
	lda #$2000
-	sta $2118
	inc
	cmp #$2400
	bne -
;enable nmi
	ldx #$80
	stx $4200
;reset ram positions
	stz $10
	stz $12
	stz $14
	stz $16
	stz $18
;loop forever
- 	;nop
	;bra -

--	lda $18
	beq --

	;wait line 0
-	ldx $4212
	bmi -
	;read keypresses
	rep #$20
	stz $14
	lda $4218
	sta $10			;current keypress
	cmp $12			;previous keypress
	beq +
	sta $12
	sta $14			;one frame keypress
+
	stz $18
	bra --

nmi_code:
	sep #$20
	lda $4210		;clear nmi flag
	lda #$8f
	sta $2100		;close beam
	lda #$81
	sta $4200		;80=enable nmi, 1=joypad read

	inc $18

.check_keypresses	;that latched in previous frame nmi
	rep #$20
	lda $14
	bne +
	jmp .exit

	;RIGHT
+	cmp #$100
	bne +
	lda $16
	cmp.w #(.keys_end-.keys)-2/2
	beq ++
	inc $16
	bra ++

+	;LEFT
	cmp #$200
	bne +
	lda $16
	beq ++
	dec $16
	bra ++

	;L
+	cmp #$0020
	bne +
	tdc
	bra +++
	;R
+	cmp #$0010
	bne +
	lda #$4200
	bra +++
	;Y
+	cmp #$4000
	bne +
	lda #$100
	bra +++
	;X
+	cmp #$0040
	bne +
	lda #$200
	bra +++
	;A
+	cmp #$0080
	bne +
	lda #$4000
	bra +++
	;B
+	cmp #$8000
	bne .exit
	lda #$3400
	bra +++

;set msu address
++	lda $16
	asl
	tax
	lda .keys,x
+++	sta $2000
	stz $2002
;dma tiles
	stz $2116
	lda #$1809		;read from msu file
	sta $4300
	lda #$2001
	sta $4302
	ldx #$00
	stx $4304
	lda #$3000
	sta $4305
-	ldx $2000
	bmi -
	ldx #$01
	stx $420b

.exit
	ldx #$0f
	stx $2100		;open beam
	rti

.keys
	dw 0, $800, $1000, $1800, $2000, $2800, $3000, $3800, $4000, $4800
.keys_end

gizaha, 2020-06-02:
I forgot:
1) When the bug occurs, dma stops. If i read 4305 is zero. Also it's NOT at
"data busy".
So i couldn't detect when the bug occurs to make a workaround. I cannot
predict how advance is, i see advance frames from next videos but couldn't
calculate the address.

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

gizaha, 2020-06-23:
It's not DMA problem but sd2snes msu buffer.
Instead of DMA, i upload byte by byte reading 2001 and writing to 2118-2119. I have the same result.
This took 3 frames, so it's not read speed error. msu1.c has bug at creating it's data buffer.

mrehkopf, 2020-10-10:
Indeed there was a bug where the read offset status flag wasn't updated correctly on a buffer hit optimization case.
47bd526f should fix this.

gizaha, 2021-04-25:
Any update on this?
How can i use the 47bd526 changes? Shall i compile the firmware myself?
I work at sfa2 msu1 and this bug is holding me back again.

mrehkopf, 2021-08-02:
Fixed in v1.11.0b1.
On a semi-related note, some performance improvements may still be required for data seeking in general.
Unfortunately MSU1 doesn't provide a way to tell the hardware how much data the program needs in advance so it always buffers the entire 16384 bytes which makes it uneconomical to try and load from multiple offsets per VBlank.
I have some ideas for optimization but want to sort out bugs of the current beta release first.

Closed 2021-08-02.

Thread 138 (2020-06-17):

MSU-1 Check State bug (affects both PRO and OG models)

Conn79, 2020-06-17:
Hi,

just wanted to know whether this bug may already been addressed?
http://krikzz.com/forum/index.php?topic=9737.0

The author says
> It was also fine in 0.1.7d, but was broken again with the release of 0.1.7e

So I looked into msu.h and found this difference between these versions:

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

Maybe here was mixed something up and lead to that issue? I do not know what this code exactly does but if audio error refers to bit 8, audio playing should be bit 10 and not bit 2 (that is however wild guessing. If I look into snes9x git https://github.com/snes9xgit/snes9x/blob/master/msu1.h , the entries are the following:

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

which corresponds to the flags in https://helmet.kafuka.org/msu1.htm

7 | 6 | 5 | 4 | 3 | 2 | 1 | 0
-- | -- | -- | -- | -- | -- | -- | --
Data busy | Audio busy | Audio repeat | Audio playing | Track missing | Revision

This could be however something completely else...

gizaha, 2020-06-18:
I guess these bits have internal usage. That's why it has SET_DATA_BUSY and CLEAR_DATA_BUSY. There unrelated with the usual msu status bits. Also, msu status bits are 8bit while these are 16bit.

mrehkopf, 2020-06-24:
@gizaha 's assumption is correct, the MSU<->SNES interface bits are not mapped the same way as the Microcontroller<->FPGA interface bits.
How much time passes between sending the PLAY command before the AudioPlaying bit is tested? There is a certain round trip time before the AudioPlaying bit is set after receiving a PLAY command (because the FPGA signals it to the MCU which needs to take note of it, start audio playback, and set the corresponding status bit in the FPGA again). So if it's tested immediately (less than say 20µs) it might not yet be set.

mrehkopf, 2020-06-24:
(Right now I don't see any harm in setting the playback flags directly by the FPGA after the command has been written, without the round trip through the MCU. Error checking should have taken place already by the track request itself...)

mrehkopf, 2020-10-13:
@Conn79 the relevant change is probably this one: 88d876d
Track change is supposed to clear the play/repeat status flags which is fixed by the above commit.
As I mentioned the PLAY flag takes a while (probably a couple of µs) to be set after the PLAY command is sent. If you check the PLAY flag too soon after sending the PLAY command it might not yet be set, so a distinction would have to be made between "not playing yet" and "not playing anymore".

Closed 2021-07-08.

Thread 140 (2020-07-28):

Feature request: change default SGB colour palette.

wezlyons, 2020-07-28:
Currently the SGB defaults to colour palette A1 when starting a gameboy game.
Could it be possible to add the option to change the default palette to one of the user's preference in the .cfg file?

wezlyons, 2020-07-28:
Sorry, posted in wrong section.

Closed 2020-07-28.

Thread 141 (2020-09-16):

Trying to compile Makefile, missing executables

AddioElectronics, 2020-09-16:
Trying to compile the \snes makefile, and of course the system cannot find the file specified.

Just wondering, where do I get rm.exe, cat.exe, snescom.exe, and sneslink.exe for windows?
Thanks

Edit: Ok I'm currently compiling snescom/sneslink (https://github.com/manz/snescom), but still need rm.exe and cat.exe.
Edit2: Never mind, found out those are linux commands, I did look before posting this I swear, just worded it wrong.

cat can be replaced with type,
rm with rd,
tee you can replace with >>

Edit3: For some reason I'm getting these errors.
Not sure why its trying to compile a comment, I tried removing it but the rest of the errors still appear.
Am I using a wrong version of snescom, and sneslink?

`snescom -J -Wall -o reset.o65 reset.a65 2>&1 >> reset.o65.log
Error: What is '; NMI - called on VBlank' - previous token: ''? (1)
Error: What is '(#$01, #40*64, #^BG1_TILE_BUF, #!BG1_TILE_BUF+64*9, #$18)' - previous token: ''? (10)
Error: Label 'DMA7' already defined
Error: What is '(#$01, #40*64, #^BG2_TILE_BUF, #!BG2_TILE_BUF+64*9, #$18)' - previous token: ''? (14)
Error: Label 'DMA7' already defined
Error: What is '(#$01, #64*9, #^BG2_TILE_BUF, #!BG2_TILE_BUF, #$18)' - previous token: ''? (18)
Error: 'bar_y     ; physical pos = logical pos * 8 - 8' is invalid parameter for 'sta' in current context (0 choices). (25)
Error: 'bar_xl    ; get logical cursor X pos' is invalid parameter for 'lda' in current context (0 choices). (43)
Error: 'bar_x     ; physical pos = logical pos * 4 - 2' is invalid parameter for 'sta' in current context (0 choices). (47)
Error: '$2126     ; window 1 left' is invalid parameter for 'sta' in current context (0 choices). (48)
Error: 'bar_wl    ; get logical cursor width' is invalid parameter for 'lda' in current context (0 choices). (49)
Error: '; pixel width = logical width * 4 + 1' is invalid parameter for 'asl' in current context (0 choices). (51)
Error: 'bar_w     ; = physical width' is invalid parameter for 'sta' in current context (0 choices). (53)
Error: 'bar_x     ; + X start coord' is invalid parameter for 'adc' in current context (0 choices). (55)
Error: '$2127     ; window 1 right' is invalid parameter for 'sta' in current context (0 choices). (56)
Error: What is '; no input for a long time' - previous token: ''? (79)
Error: What is '; IRQ_ROUTINE - called when IRQ triggered' - previous token: ''? (108)
Error: '$4211     ; Acknowledge IRQ' is invalid parameter for 'lda' in current context (0 choices). (111)
make: *** [reset.o65] Error 1`

Edit4: Ok so "none" at Nesdev.com helped me out, it's not confirmed yet but the github version of snescom does not include the GCC pre-processor, my problem should be fixed once I am able to compile snescom from bisqwit's site, which I believe does include that.

Closed 2020-09-18.

Thread 145 (2020-10-18):

Feature request: don't ask for date and time

juef17, 2020-10-18:
My sd2snes battery seems to be dead as I'm prompted to enter the date and time every time I boot it. I don't have a use for those at the moment, so I don't intend to change the battery just to get rid of a dialog (not just because I am lazy, but mostly for environmental reasons). Would it be a reasonable feature request to have a config option to skip said dialog?

mrehkopf, 2020-10-31:
Yeah, absolutely :) Originally the "USE_BATT" jumper on the board was intended for that. But a software options seems more practical.

Thread 147 (2020-10-31):

Feature request: SRM file management

mrehkopf, 2020-10-31:
Quoting a blog comment:
> A simple feature I’d personally love would be the capacity to create .srm backups from the main menu.
> Understand, I’m not talking about save states; I mean simply having the capacity to copy, load, and otherwise manipulate .srm files directly from the menu.

Thread 149 (2020-12-21):

Mortal Kombat II hangs, black screen, important info here for the future.

Nashismo, 2020-12-21:
Dear mrehkopf:

Here is the deal, your Firmware 1.10.3 is the greatest, what happens to me is that when using any firmware version besides yours, which in this case would be Furious version with savestate support, then this game, Mortal Kombat II (REV1, USA), hangs and displays all sort of issues.

The problem is fixed if reverted to your firmware 1.10.3!

I could not find a Github to inform Furious about this, the problem started when he added save state support. I am telling you so you consider to test this "specific game" if you ever add this feature in your main firmware.

The game hangs even if a disable in game hooks, cheats and savestates on Furious firmware, in yours it works as it should.

My best regards! And thank you for your amazing work.
Nashismo.

mrehkopf, 2021-01-05:
Thank you!! I will take this into account when preparing the first beta of the new release.

Nashismo, 2021-01-06:
Thank you mrehkopf, in fact it is the only game that has ever crashed on me on the Furious firmware, but it does it consistently. I think it is a timing issue probably, but it would be good for testing.

I aslo tested this same ROM on a cheap chinese everdrive, and it worked perfectly for many hours.

Ok, won't take away from your time anymore, thanks again.

mrehkopf, 2021-07-08:
I did some testing on the current beta 1 build and it seems to work well. The build is finished, I'm writing the post for it as we speak. Please look forward to it :)

mrehkopf, 2021-08-02:
@Nashismo can you check if it works better on v1.11.0b1?

Nashismo, 2021-08-02:
>
>
> @Nashismo can you check if it works better on v1.11.0b1?

Yes, I did not see this message. I will be checking today! Thank you Mrehkopf!

Nashismo, 2021-08-02:
Yes!! Mortal Kombat 2 working great here!! I played for about an hour.

I also saw a memorial for Near. It seems it only plays one time. I do not want to get into scandal, but Near's death hasn't been confirmed yet or proved to have actually happened. Hopefully Near only did this to disapear as on online persona.

Thank you dear Mrehkopf!

Closed 2021-08-04.

Thread 150 (2021-04-13):

The Auto Region patch doesn't work on EU console

Telecrab, 2021-04-13:
**SNES model:** SNSP-001A(FRG) - 1CHIP - PAL.
**Cartridge:** SD2SNES Mk.II Rev. H
**Firmware**: v1.10.3

**Steps to reproduce**

1. Turn on "Auto Region patch" in settings.
2. Try to launch Kirby’s Dream Land 3.

**Expected result**

Game starts.

**Actual result**

Wrong region message is displayed.

**Additional info**

Resetting/power cycling the console after the setting change doesn't work.

mrehkopf, 2021-08-02:
It should generally work. I've had one sd2snes where it didn't work but it was a fairly old build (Rev.E2). The cause was wrong values of the ferrite arrays on the data lines (RA103, RA104).
Can you check if it works better with the recent beta release (v1.11.0b1)? Otherwise would be cool if I could send you a bunch of FPGA files with tweaked timings to see if any of them helps.

ICEknigh7, 2021-08-03:
I can confirm that it doesn't work on the latest version, trying games such as "Ganbare Daiku no Gen-san".

mrehkopf, 2021-08-10:
I looked at it through the logic analyzer and indeed the patched data appears quite late on the bus, maybe too late for some CPUs. I'll prepare an FPGA file for testing that responds a bit earlier on the data bus.

Telecrab, 2021-09-12:
Big thank you for the update and sorry to hear about Near.

Checked this FW https://sd2snes.de/files/sd2snes_firmware_v1.11.0b1.zip
"Kirby’s Dream Land 3" works now. :heavy_check_mark:
"Super Metroid (Japan, USA) (En,Ja)" doesn't work. :x:
"Peace Keepers, The (USA)" doesn't work. :x: (Worked before, but hanged up at the copyright/logo screen half of the time. Didn't have any bugs during gameplay though.)

Overall compatibility is improved compared to the previous version. Many more games started to work. For example "Ghost Chaser Densei (Japan)".

wirehack7, 2023-05-26:
Sorry to open this again. But the error is back: even with auto patch I get the region error message from the cartridge (testing Secret of Mana (Germany) dump).
My SuperNT runs as NTSC, SOM is PAL: getting wrong region error

Used firmware version: 1.11.0

ICEknigh7, 2023-05-26:
Also doesn't work when trying PAL games on a Super Famicom.

Romain80200, 2023-06-05:
Hello,
I copy my message from another thread:

"Hello, please look at this thread:
https://github.com/mrehkopf/sd2snes/issues/186

Use this file:
https://github.com/mrehkopf/sd2snes/files/10778271/issue186-try2.zip

It solves the problem with cic and the missing leds."

ICEknigh7, 2023-06-05:
> Use this file:
https://github.com/mrehkopf/sd2snes/files/10778271/issue186-try2.zip

Just tried `Super Mario All-Stars + Super Mario World (Europe)` with this version and it still displays the region lockout message.

Now it also randomly fails to reboot when I press Reset, with all leds blinking at once.

Romain80200, 2023-06-05:
Maybe try the one at thebottom of this thread:

https://github.com/mrehkopf/sd2snes/issues/201

bitrot-alpha, 2023-08-30:
**Console:** 2/1/3 (USA SNES)
**Cartridge:** Chinese "Rev. X"

Tried 1.10.3 FW. Terranigma (EUR) worked after toggling Reset Patch, SuperCIC, and of course Auto Region Patching.
Then tried 1.11.0 FW. Tried same toggling of settings. Terranigma then booted up fine. I'm guessing timing is still not *perfect*, especially with dubious quality :smiley: of Chinese SD2SNES cartridges..

Always a good idea to try the basic troubleshooting steps:
- Power off and wait a little while before powering on again
- Reseat cartridge
- Clean cartridge contacts
- Blow out SNES cartridge slot with some kind of compressed air

bitrot-alpha, 2023-08-31:
Posting MD5 checksums of the files I have since some games have multiple revisions.
@ICEknigh7 can you tell us what version of SFC you have? The numbers I posted in my last comment are from the "System Information" menu on the SD2SNES.

All the games I tested work fine. I tried disabling Auto Region patch just to check the files I have aren't pre-patched, and DKC3 correctly showed the wrong region message on startup.

Donkey Kong Country 3 (EUR) :heavy_check_mark:
MD5: `fc3333af2f93d7dd0a4190a01d49a69e`  Donkey Kong Country 3 - Dixie Kong's Double Trouble! (Europe) (En,Fr,De).sfc

Secret of Mana (EUR) :heavy_check_mark:
MD5: `0194f74c93b0edf3e4a7672a448572ad`  Secret of Mana (Europe).sfc

Super Mario All Stars combo ROM (EUR) :heavy_check_mark:
MD5: `4941387e96ed2841ee3c2de6d1899509`  Super Mario All-Stars and Super Mario World (Europe).sfc
Problem with the background flashing pretty badly on SMB 1985, but it boots without the out of region message. Probably due to the fact that my SNES and TV are USA 60hz (No SuperCIC on SNES side)

ICEknigh7, 2023-08-31:
My current console is also 2/1/3 and DKC3 always shows the region lock screen. The difference I can see is that it's a Japanese one, maybe this only works on US systems?

Thread 155 (2021-07-28):

[beta regression] MSU-1 games freeze for ~1 second when switching audio tracks

bkoropoff, 2021-07-28:
This does not occur on 1.10.3.  I recall seeing this on an unofficial firmware, so I think it came in with the SGB support, but I'm not 100% certain.

mrehkopf, 2021-07-28:
Could you name a specific game/hack for me to test? I've added a feature where MSU games can have their SRAM auto-saved when the game is known to be waiting on the MSU busy flag anyway (e.g. on track change). It will check SRAM content and save the SRM file to card but should never take a whole second to do that...

bkoropoff, 2021-07-28:
I saw it on the Gradius III SA-1/MSU-1 merged patch [from here](https://www.zeldix.net/t1522-gradius-iii).  I'll try to grab a video capture.

bkoropoff, 2021-07-29:
Here's a comparison.  It's the same setup, just swapping firmware versions.

## Stable (1.10.3) behavior

https://user-images.githubusercontent.com/2101303/127419713-a171a9cb-1b92-4e0b-9264-9ab2816a5f2f.mp4

## Beta behavior

https://user-images.githubusercontent.com/2101303/127419744-94519f0e-b8cf-4cc5-96fd-524d6b7adf2f.mp4

bkoropoff, 2021-07-29:
@mrehkopf let me know if you need more details

bkoropoff, 2021-07-29:
I tried some other MSU-1 hacks.  Hacks with both MSU-1 and SA-1 demonstrate the freezing, but MSU-1 hacks with no expansion chip seem fine.

mrehkopf, 2021-08-02:
I see. Yes, it is probably due to the new firmware being able to save SRAM during track changes. As an SA-1 hack it 1) probably uses a lot of SRAM (to replicate WRAM for use with the SA1), and 2) changes SRAM content a lot since it is now being used as active working area by the SA-1 and not just for saved games.
That said, **MSU-1 hacks should never lock up when waiting for the busy flag after an audio or data request.** MSU-1 wasn't designed with a requirement for fast random access media in mind but even something like CDDA media where seeking to a new audio track could take a lot of time.
I can add an option to disable the SRAM handling feature for MSU-1 but ultimately the author of the MSU-1 hack should implement a proper asynchronous wait for the MSU audio busy flag ;)

bkoropoff, 2021-08-02:
Yeah, I suspected the hack was depending on implementation behavior.  An option would be helpful since most hacks were tested against emulators and prior SD2SNES firmware, all of which have nearly instantaneous switching in all circumstances.

It would be interesting if there were a way for the hack to specify that only a portion of SRAM really needs to be saved, perhaps squeezed into the internal ROM header somewhere.  That's beyond the scope of working around this problem, though.

Nashismo, 2021-08-04:
I can confirm that the stutter does not exist for me on a SDNES on v1.11.0b1 firmware. This using Gradius 3 MSU-1 version (No SA1).

I am wondering though

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

I can confirm that the stutter does not exist for me on a SDNES on v1.11.0b1 firmware. This using Gradius 3 MSU-1 version (No SA1).

I am wondering though bkoropoff, are you using FXPAKPRO? Because a normal SD2SNES is not able to use both MSU-1 and SA1 at the same time, at least according to Krikkz forum.

codemann8, 2023-01-30:
This still occurs in v1.11.0, doesn't occur in 1.10.3. The game I test this on, LTTP Rando. Here is my initial report: https://sd2snes.de/blog/archives/1157#comment-992382 There is a linked video example there of it occurring.

mrehkopf, 2023-06-20:
Apparently this happens when a game requests a track change without stopping playback first. The firmware does stop playback implicitly when changing the track but the opportunistic SRAM check took place *before* stopping playback 🙄 resulting in the FPGA repeating the same buffer over and over.

mrehkopf, 2023-06-21:
#224

cyraid, 2025-02-10:
Is this issue fixed? Was that the only thing holding the new firmware from being released? I don't play other ROMs on the fxpak pro, it's just used for development. Good job with all your hard work btw!

Thread 158 (2021-08-08):

Bad video output since Firmware 1.10.3! Only now I realize!! (Interesting phenomenon)

Nashismo, 2021-08-08:
Dear mrehkopf:

I will try to make it short. I have a Super Famicom for 1 year now. Since I have it, I have only used the SD2SNES with Firmware 1.10.3.

Here is the thing, ever since I've got it I have had issues with video quality, because I have this interference noise in the image output. I have gone crazy, replaced all the capacitors, the voltage regulator and I even added the 470uf capacitor in the new voltage regulator!

I indeed eliminated some jailbars, the sound even seems a bit better, but that "noise" in the image, I could never get rid of!!

I have the 1st model of the Super Famicom. Reading all over the Internet I found people with the same issue on the same model of the Super Famicom.

So, the last thing I did was removing the RF Modulator from the SNES. It did not fix the problem, I cleaned the AV Multi out, it did not fix the problem.

BUT! While I was at it, I thought HEY! I should play an original USA game on it now that the console is disassembled (because you cannot play USA games on a Japanese SNES). And LOW AND BEHOLD, the games played perfectly!! No noise in the image! No strange interference in the video!!

It was the SD2SNES!!

I put the same games on the SD2SNES, and I was BACK with the same interference and strange wavy lines in the video output!

So I said, what if I go BACK in the firmware?? (I had never used any other than 1.10.3 mind you).

I installed Firmware 1.10.2 and BAM!! All my problems where FIXED!!

NO MORE WAVY LINES!! I almost cried :)

Dear mrehkopf, don't know why no one else has come out to you with this issue, but it's true!!

If you ask me to test anything please let me know!! One thing I noticed in the newest firmwares is that the "games" image looks "brighter" than in an original game or firmware 1.10.2.

Thank you for reading mrehkopf and I hope something can be done for future releases of the firmware, I would also be happy to assist you in anything,

Best regards,
Nashismo

ICEknigh7, 2021-08-10:
Hey, so I'm not the only one with picture problems on a Super Famicom?

I have a 1/1/1 Super Famicom with four rubber feet (first batch?) which also starts getting wavy output after a few minutes of using the SD2SNES, and after some more time even the colors go wrong if using composite video (they don't change through RGB).

Here's some pics I took of the issue: https://imgur.com/a/xXcRzBn

Observations:
-I'm using an official Mega Drive power adapter.
-Same problems happen even with a 2A power adapter (a 3A one is on the way).
-This doesn't happen with regular official cartridges (played Yoshi's Island for a while and looked perfect), except for a small amount of interference after using the Super Game Boy for some time.
-I've opened (and cleaned) the console and nothing inside looked busted.
-My PAL 2/1/3 SNES doesn't show any of these problems, no matter how long I've been playing with the SD2SNES.

If it's an effect of the oldest Super Famicom models struggling with the SD2SNES' power consumption, maybe some kind of an "energy saving" mode could help fixing this, even if it's only for games which don't use special chips?

mrehkopf, 2021-08-10:
Well that doesn't look so great... what revision of sd2snes/FXPAK are you both using?

Nashismo, 2021-08-10:
>
>
> Well that doesn't look so great... what revision of sd2snes/FXPAK are you both using?

I opened my SD2SNES and it says Revision X, made in 2020. And like I said, now that I am using your Firmware 1.10.2, everything seems to be working great!

If you want to I can test any other new revisions of your Firmware, so that anyone using my SD2SNES version/Super Famicom Model 1 combo, doesn't have problems in the future :)

Nashismo, 2021-08-10:
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

That's weird, it is not what I was having! Yours is too much and it seems like a different problem. In fact I remember I once bought a crappy chinese Power supply for my Gamecube, and those wavy lines look EXACTLY like my Gamecube did using that PSU.

Check the PSU! It might be original, but it might be going bad!

FiZiX, 2021-08-10:
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

Sounds like your SNES needs a re-cap; especially because it starts after a few minutes of use. My guess is the SD2SNES is putting additional strain on capacitors that are already beginning to fail due to its higher power consumption (compared to original games).

ICEknigh7, 2021-08-10:
> > Well that doesn't look so great... what revision of sd2snes/FXPAK are you both using?
>
> I opened my SD2SNES and it says Revision X, made in 2020.

Same as mine, got it second hand but it seems to be like new.

> Also you say "I've opened (and cleaned) the console and nothing inside looked busted" Wrong, nothing looked busted in mine either, but the sound was horrible and the jailbars were bad

Thing is, everything looks and sounds perfect even after hours playing an official cartridge of Yoshi's Island.

Nashismo, 2021-08-10:
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

I understand, but I assure you that replacing capacitors and voltage regulator will help tremendously. It is actually easy when you look at consoles like the genesis that has like 40 capacitors to replace! The SNES has like 8 ot 10 if I remember correctly. Your capacitors might "work" but that doesn't mean they are in their best years, specially when working with a device they were never intended to work with. At least replace the voltage regulator, I would start there, because it is a power issue you have.

symbios24, 2021-08-30:
Hi,as far as i know the sd2snes revision x is a chinese clone not the original,always buy from the official site.

ICEknigh7, 2021-08-31:
> Hi,as far as i know the sd2snes revision x is a chinese clone not the original,always buy from the official site.

You could at least show some evidence that the version sold elsewhere would work better in these cases. Else, your reply isn't helping anyone here at all.

symbios24, 2021-08-31:
Is this enough for you to believe its not authentic??

https://m.aliexpress.com/i/4001147366106.html

https://m.aliexpress.com/item/4000377747886.html

Nashismo, 2021-08-31:
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

Actually you are into something here, if we could only have someone with the 1st Super Famicom model with a NON revision X firmware. Then we could see if it is the SD2SNES revision or the SNES model.

Nonetheless, I do understand that this is a non-Krikzz version, but that does NOT mean mrehkopf cannot help us! That I know of, SD2SNES was open sourced at some point and that's why other people started to make their own versions.

If this was Krikzz forum I would understand. I have also purchased Krikzz stuff, directly from Ukraine, but this is the only cart that is not made by Krikzz, excuses or not, I live in south america, so I prefer to eat and if I can save 100 dollars I am going to.

symbios24, 2021-08-31:
No problem,but still its a low quality cart,unknown how it performs in special chip games,and has an old fpga i thing cyclone 2 you could just wait for black friday.

Nashismo, 2021-08-31:
>
>
> No problem,but still its a low quality cart,unknown how it performs in special chip games,and has an old fpga i thing cyclone 2 you could just wait for black friday.

Do you make things up on a regular basis? Yet, you do not know and just speak. The cart is well built, the soldering is great, has voltage regulators built in, it has a Cyclone 2 yes, but so what? The Spartan on the original SD2SNES is slower, actually the Cyclone 2 can be 2x times faster than the Spartan according to Intel:
https://www.intel.cn/content/dam/www/programmable/us/en/pdfs/literature/wp/wp_dsp_comp.pdf

Here you have pictures of the Revision X SD2SNES https://photos.google.com/share/AF1QipOScTDE7bzsQg9ZnM17pv0LuFj3-IpFpFM4Eg2MOQFLBKzMl8aDUZXcLkwb9dmV8g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

All special chips work perfectly fine, even the MSU-1 games, everything works exceptionally well. So, you speak in ignorance. But now you now.

ICEknigh7, 2021-08-31:
> if we could only have someone with the 1st Super Famicom model with a NON revision X firmware. Then we could see if it is the SD2SNES revision or the SNES model.

Exactly what I meant, that would be helpful.

I myself didn't know what version it was since I got it second hand, but it might be irrelevant to the case anyway.

symbios24, 2021-08-31:
Then we should all buy clones 😂

Nashismo, 2021-08-31:
>
>
> Im talking in general if you think you are insulted its not my problem, we should all buy clones coz nashismo says are better joy

Insulted? I don't understand your thinking pattern honestly. You are wrong and I am right, as simply as that, I don't feel insulted, I called you what you are, an ignorant, you seem to feel insulted for that it seems. But I don't care, because we are not here for that, let's try to stay on topic, this is still not a chat, we are here to ask mrehkopf for assistance.

Nashismo, 2021-08-31:
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

It clearly has to do with this 1st models of SNES. Remember also you said your PAL version worked with no issues. We are at the mercy of mrehkopf for now, hopefully he can take our issue in consideration for his next firmware update.

symbios24, 2021-08-31:
Try the beta firmware maybe it works

https://sd2snes.de/blog/archives/1157

Nashismo, 2021-08-31:
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

That I remember I already tried that one, because  I got the Near message at the beginning. Again, another thing that my mind cannot grasp as Near's death hasn't been confirmed by any authority, only the Internet. In this irrational times I try to keep myself always investigating for real facts.

symbios24, 2021-08-31:
Did you try the tape fix?

https://krikzz.com/forum/index.php?topic=9725.0

Nashismo, 2021-08-31:
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

No I haven't tried the tape thing, thank you, I don't believe it has to do with my issue, but it is always good to try new things! Near is another name for Byuu, the creator of the MSU-1 patching and the developer of the Higan emulator (Highly accurate SNES emu).

He was supposedly a resident in Japan, he also seems to be a person with X gender (I don't understand those things, blame my nationality if you want) and he supposedly commited suicide while speaking on the phone with a friend playing a specific song he liked.
I won't go into details, but nothing makes any sense in his supposed death. And there are no Japanese authority that confirms it.

My theory is the "Near" did this (made this up) to "disappear" from public/internet, as he had many problems with lots of people. I hope that is the case because he was extremely talented.

symbios24, 2021-08-31:
A senario from movie who knows what happen
Tried older firmwares?

Nashismo, 2021-08-31:
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

Yes! I tried Frimware 1.10.2 and my SNES works without issue there! And that is one of the many reasons why I think my SD2SNES version is a good quality one, clone or not. Actually when I showed you the pics is for you to check how good the quality is on this specific revision X. I cannot speak for other "clone" revisions.

And yes, seems like the scenario from a movie, it took me quite some time to find that short info I gave you on "Near" supposed death, after investigating A LOT. It happens with me, sometimes I go out of my very rational mindset, and my "guts" tells me when something "might be" bullshit hahhaha, and that is why I investigated, because Byuu has nothing to do with me, but, it caught my atention and after investigating, I knew why I had the "gut" feeling about it.

symbios24, 2021-08-31:
better to stay with the older firmware for a while if it works ok,Maybe he owns a lot of money and decide to go in the shadows 😂
Do you have a retrogen adapter on snes?

Nashismo, 2021-08-31:
Yes that firmware 1.10.2 works with all its features on my SD2SNES so no need to panic for me, at least for now hahahhha.

And no I don't have that adapter, it's to play Genesis games right? I just got a Genesis recently and modded it for "jailbar free" RGB. If you want tips for that, I'll be glad to give them to you (in other words, I don't need the Retrogen hehe). Best regards.

symbios24, 2021-08-31:
I dont have a megadrive thats why i took the retrogen its was cheaper for me,and saves space they my retro corner,the image for composite is quite good and the compatibility its high too from all the games i tried only altered beast was showing artifacts,chakan rocks!!! Works flawless with mega ed x3

symbios24, 2021-08-31:
No problem.continue your issue sorry for the off topic thing

ICEknigh7, 2021-11-14:
> No problem.continue your whatever issue I doubt you find any answers

Nice edit history, from polite to rude in less than two weeks.

ICEknigh7, 2021-12-06:
> At least replace the voltage regulator, I would start there, because it is a power issue you have.

Just did that and all the video interference problems are gone, thanks for the suggestion! :smile:

Nashismo, 2021-12-07:
> > At least replace the voltage regulator, I would start there, because it is a power issue you have.
>
> Just did that and all the video interference problems are gone, thanks for the suggestion! smile

REALLY!! I am so glad for you ICEknigh7! But my question is, did you replace the voltage regulators on the console or the small voltage regulators on the SD2SNES itself?

Thank you, and I am really glad you took notice of my advice!

ICEknigh7, 2021-12-07:
> did you replace the voltage regulators on the console or the small voltage regulators on the SD2SNES itself?

Just replaced the one inside the Super Famicom with a L78S05CV which cost me less than 0,2€, so it was also a pretty cheap fix.

Nashismo, 2021-12-08:
> > did you replace the voltage regulators on the console or the small voltage regulators on the SD2SNES itself?
>
> Just replaced the one inside the Super Famicom with a L78S05CV which cost me less than 0,2€, so it was also a pretty cheap fix.

That's great! Then my last question would be, what Firmware are you using? 1.10.2 or later ones? Ok, take care then :)

ICEknigh7, 2021-12-08:
I'm using "1.10.3_sgb07".

Nashismo, 2021-12-08:
> I'm using "1.10.3_sgb07".

 Ok, very interesting. This info will help me :)

fjsj, 2023-03-25:
FYI, I have video noise on 3 different SNES, 2 of them 1-chip-01, 1 APU. I have a sd2snes rev. x (the Chinese one). Tried 3 different PSUs for SNES, the OEM one gives me less noise, but still there. I use OSSC, so I tried a different PSU for it too, noise got even worse. Tried different monitors, different wall plugs, nothing solved it. Original cartridges don't have that noise. The noise is present even on sd2snes menu.

The noise is mostly horizontal and diagonal, random, and it's not the checkering noise from composite or sync-on-composite video cables. I use a csync properly shielded SCART.

Noise is on firmware 1.10.2, 1.10.3, 1.11.0, perhaps a bit worse in 1.11.0.

Finally, I got a SNES Mini with RGB-bypass and full-recap: no noise in it! The only remaining noise I have is the [1-chip ghosting issue](https://www.retrorgb.com/1chipghosting.html), which is also present in original cartridges (I tested with SMW).

Therefore, as others stated in the thread, it's perhaps old capacitors, voltage regulators, and other components can cause noise only on sd2snes.

Nashismo, 2023-03-25:
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

I am sorry but as you describe, which I thank you so much, all consoles have problems with this cart!! On the opposite your RGB mod was the one that got rid of the noise. It is not because any capacitor or voltage regulator in bad condition! You see I also fixed my issue by using and RGB to Component box that my brother had, somehow this box gets rid of the noise, as others didn't. BUT, the noise will always be an issue on a all unmodified SNES's using these chinese SD2SNES's. This thread is useful to advice people to try to stay away from these chinese products if they can.

lanotlab, 2023-06-22:
Guys, I was having the same problem. Tried all firmwares and no luck. Turns out it was my psu cable that was faulty.
Now everything works fine even for long playing hours.
It's a cheap china version btw

Thread 160 (2021-08-22):

Some commands with Stack produce Crashes

weierstrass1, 2021-08-22:
I did a routine that works on all emulators but not in sd2snes, i was doing tests and could be the use of some stack commands:

;HB 1
;$00 = Left
;$02 = Right
;$08 = Top
;$0C = Bottom

;HB 2
;$04 = X (16 bits)
;$0A = Y (16 bits)
;$8D = Hitboxes Data Table

?DyzenInteraction:

;$15,s = HitboxAdder
;$13,s = FrameHitboxesIndexer
;$11,s = FrameHitBoxes
;$0F,s = HitboxType
;$0D,s = HitboxXOffset
;$0B,s = HitboxYOffset
;$09,s = HitboxWidth
;$07,s = HitboxHeight
;$05,s = HitboxAction1
;$03,s = HitboxAction2
;$01,s = Actions
	PHX
	TYX

	STZ $50
	STZ $4F
	REP #$20

	LDA $04
	CLC
	ADC $51
	STA $04			;$04 = X offset + X position of sprite

	LDA $0A
	CLC
	ADC $53
	STA $0A 		;$0A = X offset + X position of sprite

	LDY #$00
	LDA ($8D),y
	PHA
	;dw HitboxAdder
	LDY #$02
	LDA ($8D),y
	PHA
	;dw FrameHitboxesIndexer
	LDY #$04
	LDA ($8D),y
	PHA
	;dw FrameHitBoxes
	LDY #$06
	LDA ($8D),y
	PHA
	;dw HitboxType
	LDY #$08
	LDA ($8D),y
	PHA
	;dw HitboxXOffset
	LDY #$0A
	LDA ($8D),y
	PHA
	;dw HitboxYOffset
	LDY #$0C
	LDA ($8D),y
	PHA
	;dw HitboxWidth
	LDY #$0E
	LDA ($8D),y
	PHA
	;dw HitboxHeight
	LDY #$10
	LDA ($8D),y
	PHA
	;dw HitboxAction1
	LDY #$12
	LDA ($8D),y
	PHA
	;dw HitboxAction2
	LDY #$14
	LDA ($8D),y
	PHA
	;dw Actions

	TXA
	REP #$10
	ASL				;A = 2*Flip
	TAY				;Y = 2*Flip

	LDA $06
	ASL
	CLC
	ADC ($15,s),y		;A = HBAdder[Y]
	TAY					;Y = HBAdder[Y]

    LDA ($13,s),y		;X = FrameHitboxesIndexer[Y]
    TAX
    SEP #$20

?-
	STX $06
	TXY					;Y = FrameHitboxesIndexer[Y]
	LDA #$00
	XBA
	LDA ($11,s),y		;FrameHitBoxes[Y]
	CMP #$FF
	BNE ?+
	SEP #$10

	REP #$20
	TSC
	CLC
	ADC #$0016
	TCS
	SEP #$20
	PLX

	LDA $4F
	BEQ ?.clear
?.set
	SEC
RTL
?.clear
	CLC
RTL

?+
	REP #$20
	ASL
	TAY

	LDA ($0D,s),y		;Hitboxes[Y].XOffset
	CLC
	ADC $04				;A = Hitboxes[Y].XOffset + X
	STA $45				;$45 = Hitboxes[Y].XOffset + X

	LDA ($0B,s),y		;Hitboxes[Y].YOffset
	CLC
	ADC $0A				;A = Hitboxes[Y].YOffset + Y
	STA $47				;$47 = Hitboxes[Y].YOffset + Y

	LDA ($09,s),y		;Hitboxes+2[Y].Width
	CLC
	ADC $45				;A = Hitboxes+2[Y].XOffset + X + Hitboxes[Y].Width
	STA $49				;$49 = Hitboxes+2[Y].XOffset + X + Hitboxes+2[Y].Width

	LDA ($07,s),y		;Hitboxes[Y].Height
	CLC
	ADC $47				;A = Hitboxes[Y].YOffset + X + Hitboxes[Y].Height
	STA $4B				;$4B = Hitboxes[Y].YOffset + X + Hitboxes[Y].Height

	;HB 1
	;$00 = Left
	;$02 = Right
	;$08 = Top
	;$0C = Bottom

	;HB 2
	;$45 = Left
	;$47 = Top
	;$49 = Right
	;$4B = Bottom
?.checkXAxys
	LDA $49
	CMP $00
	BCC ?.left			;if HB 2 is at the left of HB 1

	LDA $02
	CMP $45
	BCC ?.right			;if HB 2 is at the right of HB 1

?.touchingHorizontal		;HB2 is touching HB1 in X axys
	LDA #$0003
	BRA ?+
?.left
	LDA #$0002
	BRA ?+
?.right
	LDA #$0001
?+
	STA $4D

?.checkYAxys
	LDA $4B
	CMP $08
	BCC ?.up				;if HB 2 is above of HB 1

	LDA $0C
	CMP $47
	BCC ?.down			;if HB 2 is below of HB 1

?.touchingVertical		;HB 2 is touching HB2 in Y axys
	LDA #$000C
	BRA ?+
?.up
	LDA #$0008
	BRA ?+
?.down
	LDA #$0004
?+
	ORA $4D
	STA $4D

	PHY
?.contact				;HB 2 is touching HB 1
	LDA $4D
	CMP #$000F
	BNE ?.ThereIsntContact

?.ThereIsContact

	LDA ($07,s),y
	TAY

	BRA ?.execRoutine

?.ThereIsntContact

	LDA ($05,s),y
	TAY

?.execRoutine
	LDA ($03,s),y
	STA $8A

	PLA
	LSR
	SEP #$30
	TAY						;Y = Hitbox ID

	LDA $17,s
	TAX						;X = load sprite index

	PHB
	PLA
	STA $8C

	PHK
	LDA.b #(?.returnRoutine-1)>>8
	PHA
	LDA.b #(?.returnRoutine-1)
	PHA
	JML [$008A|!dp]
?.returnRoutine

	REP #$10
	LDX $06
	INX
	JMP ?-

For example this zone of code:

	REP #$20
	TSC
	CLC
	ADC #$0016
	TCS
	SEP #$20

if i replace it by:

	REP #$20
	PLA
	PLA
	PLA
	PLA

	PLA
	PLA
	PLA
	PLA

	PLA
	PLA
	PLA
	SEP #$20

This doesn't crash instantly (the game still crash but i can play some seconds), I really don't know why this happend only in sd2snes maybe could be a bug. This works on all emulators, includes bsnes, higan, snes9x ,etc...

mrehkopf, 2023-02-05:
sd2snes does not do anything special depending on instructions; given that most commercial software also uses lots of stack operations I would be surprised if it would cause problems with your code. Maybe there is an obfuscated dependency on initialized memory or the stack pointer exceeds $2000?

weierstrass1, 2023-02-06:
Memory addesses used by the code are set up before use it also it was tested in all emulators that all starts with different data in RAM Address then shouldn't be that.

About stack pointer, that doesn't happend, the routine is not recursive and i dont use any recursive routine, also in emulators with luck the stack surpass like 40 bytes, this only fails in sd2snes. At the end i changed the code to use scratch ram address instead of stack.

Thread 161 (2021-08-31):

MSU1 games with motion video glitches on 1.11.0b1

kimbapslice, 2021-08-31:
MSU1 games with motion video glitches on 1.11.0b1 and not on 1.10.3. I am using 2/1/3 snes (ntsc/usa). Switch back to 1.10.3 works fine.

Mega Man IV intro's
Akira Trailer
Super Road Blaster
etc

Tried it with PNY 16gb microsd class 10 and a Samsung Evo 32GB micro sd.

kimbapslice, 2021-09-05:
I tested Super Road Blaster today on 3 fully working (as far as I can tell) USA snes with configuration 2/1/3 snes (ntsc/usa). I have disabled all in-game menu and gamesaves. Snes burn-in test v1.03 reports all pass on all 3 systems.

Results for Super Road Blaster with 1.11.0b1 video glitches on all 3 snes.
Results for Super Road Blaster with 1.10.3 NO video glitches on all 3 snes.

My sd2snes is an old official E1b revision that I have upgraded to revision H.

manwithouties, 2022-04-15:
I know this post is old... well, I'm experiencing the same issue. Have you found a solution?
I don't want to keep using 1.10.3 because I love the save state and SGB features.

kimbapslice, 2022-04-16:
Ok, so here's an update on further testing. I recently acquired a snes 1chip-01 and snes mini/jr. Both the 1chip-01 and snes mini/jr report 2/1/3 configuration. Both are NTSC/USA revisions.

Super Road Blaster with 1.11.0b1 on snes 1chip-01 = video glitches
Super Road Blaster with 1.11.0b1 on **snes mini/jr = normal, correct video**

New findings!

manwithouties, 2022-04-17:
@kimbapslice Thanks for your reply and testing! So, no easy fix! I tried manipulating some files on the sd2snes folder with no success. Anyway, it's a firmware issue and needs a fix... let's hope developers can solve it on next update. Meanwhile I'm using two SD cards, one with 1.11.0 and other one with 1.10.3.

mrehkopf, 2023-02-27:
SNES mini/jr and 1chip are technically identical. Could either of you provide a recording of the glitches?
Do the glitches recover at all on the MSU1 video demos (e.g. Akira)?
Are the glitches still present in the 1.11.0 final? Can you let the SD card access time measurement complete on the System Information screen and post the results?

mrehkopf, 2023-03-07:
Thank you 🙇‍♂️ So far I've been unable to reproduce the issue here. The only thing that caused intermittent glitches was a very slow card with a max access time of 11ms... However there seems to be an issue with bus timing on 1.11.0 (#204, #184), maybe the underlying cause is similar.
Can you run Illusion of Gaia and check for flickering of the Nintendo/Enix logos and corrupted graphics?

kimbapslice, 2023-03-07:
Hello,

So today I tested the 1.11.0 release with 2 snes (1chip-01, and not a 1chip), 2 snes jr. All four systems are 2/1/3, running composite video. First tested with my sd2snes upgraded to 1.11.0

Results on 1.11.0:
Snes (not 1chip, stock), snes 1chip-01(brightness fix+vertical band fix) = MSU1 videos GLITCH
Snes JR (stock): MSU1 works
Snes JR (rgb mod, brightness fix): MSU1 works

Results on firmware 1.10.3
MSU1 videos work on all consoles

I hope this helps!

Thank you so much for your work!

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

https://user-images.githubusercontent.com/58018661/223561377-7df4587b-527a-4802-884b-4cf5c32f426f.mp4

https://user-images.githubusercontent.com/58018661/223561402-c653811a-9a31-4b3b-8d7f-ea301367dafa.mp4

mrehkopf, 2023-03-07:
Thanks! Looks like it's missing one byte of data pointer increment at the beginning of each DMA transfer... will need to check how recent changes might have caused that.

mrehkopf, 2023-03-08:
Can you try this (only for OG sd2snes)? Just replace the fpga_base.bit in your sd2snes folder with the one from the zip file.
It's not a final fix, just changed the way MSU address is incremented to close in on the issue.
[fpga_base_msu1_address_inc.zip](https://github.com/mrehkopf/sd2snes/files/10925532/fpga_base_msu1_address_inc.zip)

kimbapslice, 2023-03-08:
Wonderful news! The fpga_base.bit did the trick and now firmware 1.11.0 works on all of the 4 snes tested. I was able to run through the entire trailer of Akira, Super Road Blaster works. Thank you!

mrehkopf, 2023-03-09:
Ah that's good to know, thanks! I'd like to try different approaches (due to interaction with other issues) so would be great if you could try maybe 1-2 other fpga_base.bit files that I'm going to attach here :)

kimbapslice, 2023-03-09:
Yes, I can do that and report back. Thanks!

mrehkopf, 2023-03-12:
Awesome! Here is another one:
[fpga_base_new_address_sampling.zip](https://github.com/mrehkopf/sd2snes/files/10951891/fpga_base_new_address_sampling.zip)

kimbapslice, 2023-03-12:
The new address sampling returned to the only snes working was the snes jr systems.

1chip-01 and non-1chip = msu1 video glitches
snes jr stock = works

https://user-images.githubusercontent.com/58018661/224580554-1dd25cd5-4b95-45da-b539-1e1f1d14efdb.mp4

https://user-images.githubusercontent.com/58018661/224580555-5824fce1-d974-4d07-aea6-0ff5a6b03f56.mp4

https://user-images.githubusercontent.com/58018661/224580556-9fb253a7-6fc8-43ac-96c6-714ec939d530.mp4

mrehkopf, 2023-03-13:
Another try 😅
[fpga_base_new_address_sampling2.zip](https://github.com/mrehkopf/sd2snes/files/10952695/fpga_base_new_address_sampling2.zip)

kimbapslice, 2023-03-13:
Sampling2 results:

non1chip and 1chip-01: glitches, but sometimes shows briefly correctly the first 1-5 seconds of akira/music videos. Super Road Blaster glitches much less but it's still messes up on and off.

snes jr: works perfectly

mrehkopf, 2023-03-13:
Yet another try 🙏
[fpga_base_new_address_sampling3.zip](https://github.com/mrehkopf/sd2snes/files/10955548/fpga_base_new_address_sampling3.zip)
If this doesn't work I'll probably stick with the MSU specific fix for now.

kimbapslice, 2023-03-13:
Sampling3 results:

non1chip and 1chip-01: glitches
snes jr: works perfectly

mrehkopf, 2023-04-10:
OK, went with the first approach for the time being. Thanks for all the testing :) v1.11.1 is around the corner, feel free to re-open the issue if any issues persist.

Closed 2023-04-10.

Thread 167 (2021-11-01):

SuperCIC Key on PIC12f629 working only as NTSC

edgarCarrasquilla, 2021-11-01:
Hi all,

I'm having a strange issue with SuperCIC Key, programmed in a PIC12F629. I have programmed many of them in several and different roms, all PAL roms in JAP cartridges, always desoldering original CIC and soldering PIC12F629 following official schema, and soldering PAIR pin to VCC to deactivate PAIR mode, as my SNES is modded.

Most of them works correctly: my modded PAL SNES detects them as PAL cartridges, but in some cases, it detects them as NTSC. For example: Terranigma Spanish version. Orogrammed this game as usual, soldering the PIC12f629 with last version of key .hex file, but my SNES detects it as NTSC. Powering up SNES as 50hz forced, it starts as 60hz and after 9 seconds turns to 50hz. In auto and 60hz forced modes, starts as 60hz.

The problem with this game is that is software region protected, so although the rom is PAL (tested in emulator and in a everdrive), it starts as 60hz and software protection blocks it.

At the moment, I have:
- Double-checked all soldering points
- Assured that the PIC is labeled correctly (12F629)
- Programmed a new PIC and soldered again (same result)
- Reseted several times and tried in all modes
- Tested many other games in which I used the same PICs and code, and worked correctly
- Tested other games for which I used the same PCB (1J3M-20), that also works correctly

Any ideas?

Thanks!

edgarCarrasquilla, 2021-11-02:
I have made another test: I used a PIC from another working multiregion cart (works as expected), desoldering from it and soldering to Terranigma PCB, with same result; in Terranigma PCB (1J3M-20), it works like a NTSC CIC always.

edgarCarrasquilla, 2021-11-07:
After some more (much more) trial and error, I think I found what my problem was.

Supercic Key agree the region with Supercic Lock when I turn up my SNES. When, for the first time (a new cart with a supercic key recently programmed), as 60hz, both parts agree they are 60hz. If later I turn up my SNES in 50hz mode, as the PIC was previously set to 60hz, it detects it as so.

So, my ultimate doubt is: is it possible to force a supercic key to change region on a supercic lock modded Super Nes?

mrehkopf, 2023-02-06:
That's true; there is no way to force the detected region when a SuperCIC communicates with a SuperCIC. A SuperCIC key powered cartridge will always adjust to the region of the last unmodded console it was connected to. The SuperCIC lock in turn will also adjust to the SuperCIC key's region. Thus, there is no actor governing the region.
Forcing the region *might* work if pair mode is allowed (SuperCIC key pin 4 to GND) and the CIC D0 an D1 lines are pulled to the desired levels (NTSC=0V; PAL=5V) with resistors (~4.7k-10k). In that case the SuperCIC lock would change its behaviour though and act more like a normal console (no switching using Reset button etc.); the cartridge would have total control over the region. Also it might trigger an error during authentication with an unmodded console (stock CIC) because of the resistors.

Maybe I should add a CIC key with a configurable region?

Thread 169 (2021-11-19):

RAD2X + FXPAK Pro video issue with firmware V1.11.0 BETA 1

ShiroTheSniper, 2021-11-19:
Hi! I would like to report an issue with the firmware v1.11.0 beta 1.
My setup:
SNES SNS-CPU-GPM-01
RAD2X (smoothing filter off)
FXPAK PRO (brand new)

Video issue:
[https://youtu.be/hEnnJrJCGu4](url)

I don't have the problem with these setups:
- RAD2X + firmware 1.10.3
or
- Standard AV cables + firmware v1.11.0 beta1
or
- RAD2X + Any real game carts

jon-nielsen, 2021-11-19:
I have a similar issue with a FXPAK Pro but only on my 2-chip SNSP-CPU-02.  On my 1-chip SNES mini there's no problem. The interesting thing is that a SD2SNES from AliExpress works just fine on both systems.

bkoropoff, 2022-01-08:
It looks like transient voltage drops due to the combined extra current drawn by the RAD2X and the FXPAK on the beta firmware.  Things you could look into:

1. Make sure you have an adequate power supply.  The OEM AC adapter is rated for 850mA, but you might want more than that since that rating wasn't chosen with flash carts and active AV cables in mind.
2. Replace the aging electrolytic capacitors in the SNES, particularly the main power smoothing cap(s).
3. Replace the old 7805 regulator, maybe with a 78S05 for the additional current capacity.

Thread 171 (2021-12-10):

Maerchen Adventure Cotton 100% won't run in 60 Hz Mode on PAL consoles

pseiler, 2021-12-10:
Hi Ikari,

I just tried to play "Maerchen Adventure Cotton 100%" on my FXPak Pro and it just won't load.
I tried the SNES burn-in test and my PAL SNES with a SuperCIC seems fine. I also didn't face other issues. The diagnostics firmware (please merge the zip provided on your website as it took me way too long finding the version for the FXPak pro in the comments) passed all tests.

It seems that other people (maybe with the old FXPak model) don't have issues running the game (at first I tried a english translation romhack and people confirmed it worked on their system).
I'm on firmware 1.11.0beta but also tried 1.10.3 and both firmware won't run the game.

I haven't faced a single issue beside this one. I ran many romhacks and roms that matches the no-intro database without any issues.
I also ruled out a bad dump on this specific title.

Greetings from germany and keep on the good work!

symbios24, 2021-12-10:
Hi there try an older firmware until the game works finat

pseiler, 2021-12-10:
> Hi there try an older firmware until the game works finally

I have an FXpak pro. I cannot use firmwares older than 1.10.0.
I tried 1.10.1 - 1.11.0 beta and none of them works.

symbios24, 2021-12-11:
Did you try or you just saying??

pseiler, 2021-12-11:
I also found a comment on your website that mentioned this issue:
https://sd2snes.de/blog/archives/1076#comment-991899

I test if reseting helps.
Also I wanted to link the romhacking.net topic (maybe this helps too)
https://www.romhacking.net/forum/index.php?topic=33888

pseiler, 2021-12-15:
I now tried to reset a lot and didn't get it to run. I tried both. Resetting to menu and simply reset the game itself.
Was the same result.

mrehkopf, 2021-12-15:
Hm, strange. I could imagine that the game has some sort of timing-sensitive code regarding the APU (audio processor). The PAL SNES has a slightly different clock ratio of CPU:APU than the NTSC SNES so maybe it trips on that somehow. Does it make any difference if you run the game in 50Hz or 60Hz?
Have you tried running the "SNES Burn-In Test Cartridge Rev. D" to check for issues that your SNES itself might have? (Turn off in-game hooks before you run it or the HV Timer test will sometimes fail. ^^)

pseiler, 2021-12-15:
Thank you for the fast answer.

I haven't tried it in 50 Hz. Just used Auto setting from the SD2SNES superCIC settings. But I'll try.
But regarding all other settings (I disabled everything else (hooks, cheats, auto-region-patching, etc...)

But yes I tried the burn-in test with the exact Rom you mentioned and found out to disable In-Game hooks for the HV Timer test.  Maybe I should've clearified it better in the start post. So the SNES itself works absolutely fine.
But I have a friend who owns a SD2SNES and uses a SuperCIC PAL SNES and it runs fine for him (but I don't know which firmware, but it seems he uses 1.11.0 beta or the fork which enables SGB as he mentioned playing SGB with the SD2SNES).

pseiler, 2021-12-15:
@mrehkopf in 50 Hz mode it works flawlessly. Only when running in 60 Hz mode it won't start.
Having the menu in 60Hz or 50Hz doesn't affect it in any way.

I ask my friend if he activated the SuperCIC in the SD2SNES and if the game runs on his SNES without an issue.
Is this something thats fixable by the SD2SNES or would it also affect a real / repro cartridge?

mrehkopf, 2021-12-16:
I came to the same conclusion yesterday - it works in 50Hz mode but not in 60Hz mode except on a console with NTSC master clock (21.477MHz instead of 21.282MHz). It's very like some sort of race condition inside the game's code itself. Almost sounds like they got lucky it actually boots on NTSC consoles at all. :D
I'd expect it to fail in the same way with a simple repro/ROM cartridge. I'm going to trace the game later using a logic analyzer to see where it hangs specifically and maybe put it on a repro cart to verify :)

pseiler, 2021-12-16:
Awesome. Thank you very much for your effort. I'm looking forward to your findings and news. I'm sorry that I'm not a capable of helping you as it seems quite a complicated task.

mrehkopf, 2022-02-01:
It boils down to the game using a buggy RAM clearing routine.
They forget to prepare a small portion of RAM, then subsequently expect certain values which aren't always there. The game then crashes a number of times before booting successfully (or sometimes doesn't). I found that it often manages to boot after 12 seconds of waiting or so.
Apparently in 50Hz mode the CPU is interrupted at different times while executing from undefined address space so it might recover faster because of that.
The "proper" fix would be to fix the game (it is a single byte patch - must have been a typo in the original code) but I will capture a bunch of RAM dumps after cold boot from a number of SNESes to mimic the initial state of original hardware better.

pseiler, 2022-02-01:
Thats awesome to hear. And I'm very thankful that you investigate into this even it's not a fxpak issue. Looking forward to the patch.

mrehkopf, 2022-02-01:
As a quick patch if you have a hex editor you could try the following - load the ROM and, at offset 0x65-0x66, change "10 00" to "00 01".
Basically the correct instruction should read "stz $0100" but they put "stz $0010" instead. (The byte order is reversed on the 65c816 so "10 00" means $0010 and "00 01" means $0100.)

mrehkopf, 2022-02-01:
(I lied - it's a two byte patch.)

pseiler, 2022-02-01:
Awesome! I'll try it on Thursday and report if it works for me too!
Thank you again.

pseiler, 2022-02-07:
It worked but not as stable as I've thought. When moving around the cursos in the title menu it freezes after a while and ingame had similiar issues in the pause menu.
I'll test again today and also play a longer session (trying also to disable ingame hooks) to see if I can reproduce the errors.

But thank you very much for your effort!
I'll leave it open till I have further news. I will also buy the release from Strictly Limited Games to see if those issue got fixed and check the differences.

pseiler, 2022-05-11:
I think this can be closed. I also modded another SNES to have a true NTSC master clock / DFO which fixes all the issues I had.
But the patch works so far that you can still play the game on PAL consoles with just the 50/60 Hz Switch/Mod with a few hiccups or freezes.

Closed 2022-05-11.

Thread 172 (2022-01-02):

Randomly lost the ability to use previously working firmware + games

shadowofdarkness, 2022-01-02:
I have a strange problem that just started today. I went to turn my Fxpak Pro (with the latest beta firmware) on and it came up to a scrambled screen when it was working last time I turned it on. I checked the memory card for errors and found some so I reformatted it and put fresh files on from the original release zip and got the same problem of a scrambled menu, although the Near memorial screen was fine.

After some testing on 3 different SD cards I find them all to have the same issue. Downgrading to the last stable release works and I can start games with the exception of the only 2 games I put real time into playing which can't be a coincidence any other ROM quickly tested works.

The non working games are a Super Mario World romhack and SMRPG I have tested the files hashes against the originals and they are the same so it shouldn't be file corruption. They just go to a black screen when started.

How can this happen, other then the memory card does anything get saved to the cartridge that could be corrupted I have only had it for a few months with only around 15 hours playtime and it always worked fine before.

Considering it only affects the one firmware version which before today was the only one ever used on it and it also only affects the games I was playing. I don't think it could be bad capacitors or bad hardware.

No old files were used when setting up the 3 cards and all got setup separate. So it has to be a problem with something else.

Edit Both the official burn in test rom and the Faxpak Pro diagnostic firmware report no problems with the system.

shadowofdarkness, 2022-01-03:
I may have narrowed down the problem. I found out that the specific SMW rom hack I was playing actually required the SA1 enhancement chip that the plain game didn't and that same chip was used by SMRPG. I spot tested a game from every other chip I could and they worked but just SA1 seemed to be a problem.
Of the SA1 games I tested I found a Kirby game that also just starts to a black screen but then the other 2 I tested did work so it is not completely gone.

shadowofdarkness, 2022-01-08:
Turns out my problem is the console not the Fxpak Pro. It took a bit but I found a second console to borrow for a test and it had no problems both the latest firmware and all 3 problem games worked again.

I'm hoping it is just a power issue and new caps will fix it I just find it strange that the newest firmware release has a problem but not older versions. I could understand the games as maybe SA1 uses more power then other enhancement chips.

Closed 2022-02-20.

Thread 173 (2022-01-11):

Save States not working at all on FXPAK Pro

zkat, 2022-01-11:
Using the latest beta (1.11.0b1) on a brand new FXPAK Pro + SuperNT, save states don't seem to work at all. I've double-checked that in-game hooks are disabled, and this happens whether I have save slots enabled or not.

I've tried multiple games, including:

* Donkey Kong Country
* Aladdin
* Final Fantasy III

Is there any way I can help debug this further, or any other clues as to what might be going on? I don't know any assembly stuff but I'm happy to help QA this one.

mrehkopf, 2022-01-11:
In-game hooks must be enabled for the savestates to work. The built-in save state handler is now called from the in-game hook as opposed to the USB hook to free it up for whatever USB features may be used.

zkat, 2022-01-11:
Enabling in-game hooks does not seem to work either, unfortunately.

zkat, 2022-01-11:
Update: After putzing around a bit, I found that if I mash the button combinations a bunch, they eventually stick. So pressing Start+R a bunch of times eventually makes my screen flash with a save state :)

I guess there's a timing issue? Or maybe my (bluetooth) controller is causing problems?

DoctorDan1986, 2022-01-11:
Have you tried pressing and holding the button Combo?  That might help narrow down a timing issue.

Sent from my iPhone

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

zkat, 2022-01-11:
pretty sure this is just an issue with my controller, so I'm going to close this. I'll reopen if I have reason to believe it's not just a controller timing thing.

Closed 2022-01-11.

Thread 174 (2022-04-09):

i want to compile this code

gizaha, 2022-04-09:
Hello. I clone this code in visual studio and i'm serarching a way to compile it and make some tweaks/experiments.

I can't run it in VS because the run button says "select startup item".
Can anyone help me? It will gain time.
Thanks.

Skarsnik, 2022-05-20:
Information on how to build the firmware are in https://github.com/mrehkopf/sd2snes/blob/develop/src/README

mrehkopf, 2022-05-20:
The code isn't organized as a Visual Studio project (it might be possible but it uses other tools instead).
I think the easiest way would be to download arm-none-eabi-gcc (C compiler for ARM - depending on your OS this may be available as a ready-made package) and build from the command line using make inside the `src` folder, e.g. `make CONFIG=config-mk2`
A shell with assorted tools is definitely required. I use msys2-mingw64 on Windows (https://www.msys2.org/).
An FPGA configuration file is baked into the firmware image at some point, so it will likely complain that it doesn't know how to build `../verilog/sd2snes_mini/fpga_mini.bit` or similar. This file is not mandatory for firmware operation, just for convenience so it can display some error message in case the SD card is unusable. For this purpose you can just replace it with some small text file, just so the make process can find it.

gizaha, 2022-05-21:
Thank you very much for you answer. Howerver i'm too old to dive into this.
Thanks again for your time.

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

gizaha, 2022-07-28:
> https://github.com/alttpo/sd2snes-build-docker
>
> I made a docker image that can compile the firmware code and the verilog code. Hope it helps someone.

Any easy guide of how to use docker in visual studio? I have this project opened in visual studio, i want to edit it, compile and test it in sd2snes.
I'm no programmer, i'm having a hard time with visual studio and I learn of docker today.

JamesDunne, 2022-07-28:
Assuming by Visual Studio you mean Visual Studio Code, I can help. First, let's skip the IDE and go straight to a WSL linux shell and compile the code with the repo I linked above.

Start by installing WSL (windows subsystem for linux) on your Windows machine and then set up Docker `sudo apt install docker.io` within WSL. Google around for guides on how to do all that.

From there, `git clone` the sd2snes-build-docker repo I linked earlier and run the build script. It should clone the sd2snes repository to a working copy and then start building a docker container which contains all the compilers and tools needed to build the code. It should take about 10-20 minutes to complete the first time and then be cached for subsequent builds. The time is mostly dominated by the fpga / verilog toolset download and installation. From there it will copy in the sd2snes working copy code and compile most of it (excluding the extra FPGA bi3 files). The final result should be a couple of .bi3 files that you can copy to your sd2snes SD card's `/sd2snes/` folder. Details in the README.

VS Code and IDE usage is outside the scope of the sd2snes-build-docker repo I put together, but it should be easily accomplished:
1. install VS Code
2. install the "Remote - WSL" extension (Id: `ms-vscode-remote.remote-wsl`) - this extension allows VS Code running on Windows to work on files that live in WSL (linux).
3. open the sd2snes repo working copy
4. edit code as desired
5. change the `src/VERSION` file to make sure the firmware code gets updated
6. run the build.sh script to recompile the .bi3 files

HTH

gizaha, 2022-07-28:
No, i mean visual studio (2017).

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

JamesDunne, 2022-07-28:
I'm sure you can create your own C/C++ solution for VS2017 containing the firmware C code and edit the code that way to get nice features like auto-completion but beyond that VS2017 won't help you with this project since it needs to be compiled for an ARM Cortex M7 microcontroller. As far as I know, VS2017 C/C++ primarily targets Windows environments and ABIs; you probably won't find much support for the `arm-none-eabi` triplet in VS2017.

Anyway, I suggest you abandon hope for VS2017 and instead try what I posted above to at least be able to compile the firmware and verilog code and get it running on the sd2snes device. I know it works otherwise I would not have created and shared the repo 😄. From there you can worry about your editor of choice.

RandalLinden, 2022-08-01:
@JamesDunne Thank you for the repo -- I found it helpful!

On Windows 11 Ubuntu I found that it requires starting a second shell and doing a "sudo dockerd" to get the daemon running.

Then doing a "sudo ./build.sh" works as expected.

Unfortunately, I'm not familiar with Docker so I would really appreciate a quick example of extending the Docker file to support compilation of the GSU firmware!

Thanks in advance!

Thread 175 (2022-05-20):

FX Pak Pro Savestates not working with Shadowrun ROM.

pecodeguile, 2022-05-20:
The game seems to save the state just fine, but then freezes when I try to load the state.  The game utilizes all of the buttons, so with Start, Select, L, or R you are bringing up some sort of menu engagement.

I also tried this game with savestate2snes and that didn't work either.

If there's any more info I can provide, I'd be more than happy to!

pecodeguile, 2022-06-23:
Does this mean that with the latest update it will work? or still a work in progress?  Either way, thank you for your effort!

mrehkopf, 2023-01-30:
Can you try with v1.11.0? I fixed a general issue with freezing when loading a state. If it doesn't, there's a chance it can be fixed with an entry in the savestate_fixes.yml file that I can figure out for you.

pecodeguile, 2023-01-30:
Hello!  And thank you for your work on this!

In Shadowrun, the START button brings up a menu, while the SELECT button
brings up your stats. With the original savestate button mapping (START +
R), the game would freeze when trying to exit the menu after loading a
savestate (START + L).

I altered the config.yml file so that saving a state would be SELECT + R
and loading would be SELECT + L.  This seemed to work at first! I would
save a state, and then load a state, exit out of the status menu and all
looked well!  However, the game then froze whenever combat was initiated.
I could run around in safe areas for seemingly however long I wanted to,
but the second that I got near an enemy, the game would freeze.

Hope this helps!  Thank you again for your effort, and please let me know
if I can be of any further assistance!

-peco

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

redacted173, 2023-02-04:
Try adding the following line to sd2snes/savestate_fixes.yml on the SD card:

F834: 001D00,2140 # Shadowrun (US)

pecodeguile, 2023-02-06:
We are definitely getting closer!  This time the game went into combat just
fine!  In fact, I played for 10 minutes and was still able to load an early
and late savestate.  However, when I used L+R+Select+Start to reset the
game and then load a new game, it would no longer load the previous
savestate.

It would show the loaded savestate for a brief second, then go completely
black screen and unresponsive.  It was unplayable after that.

Thank you for your continued effort on this!

On Sat, Feb 4, 2023 at 10:24 AM redacted173 ***@***.***>
wrote:

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

redacted173, 2023-02-06:
I'm not able to reproduce it.  I suggest:
- disabling save state slots in the menu.  I'm not sure if an empty slot loads uninitialized memory or something useful.
- mapping save,load to at least one additional button from the reset/restart in-game buttons.  It's unfortunate that there is overlap.  For example B+R,B+L

Try using it more and seeing where it fails and where it doesn't consistently.  Ikari may have other ideas since he knows the implementation better.

mrehkopf, 2023-02-07:
About overlap: Is it really necessary to allow the non-exclusive button combinations (i.e. allow other buttons to be pressed) for the save state features? It compromises a lot of the other button commands...

mrehkopf, 2023-02-07:
And yes, the handler will still attempt to load an uninitialized save state, so that can be either just zeros or an existing save state of a game played earlier. Both will lead to undesired behavior :) But in this case I think it could be the overlap - since the "reset game" combination also contains the "save state" combination it might attempt saving a state while the microcontroller is already in the process of resetting the SNES.

redacted173, 2023-02-07:
Complete overlap may be functional.  The suggestions are trying to eliminate some possible races with button presses.

It certainly could lead to an undesirable situation where the state is saved over when someone tries to reset.  It all depends on how strict the button checking is done and the order the buttons are pressed.  I typically disable in-game buttons and reset using the console buttons.

redacted173, 2023-02-07:
Would it possible to only perform one check per interrupt and have a jump table or self modifying code to change what is checked each time?  Seems like that could help eliminate the complexity of the offload and also reduce overhead.  Not sure it's necessary to check all conditions on every interrupt.

mrehkopf, 2023-02-07:
Sure but I intend to to it using the FPGA instead of 65816 code to save cycles. The current in-game hook implementation (except the save state handler, which is my TODO) uses the FPGA to make decisions about branching and inject branch offsets. Doing everything in 65816 consumed too many cycles which led to compatibility problems with some games.

pecodeguile, 2023-02-08:
Hello!

I remapped the savestate button commands to BR and BL and it works!  I was
able to turn off the console, remove the fxpak, then start the game over
and load a savestate directly where I had last saved it!

Great job!  Well done!  And thank you ever so much for all of your work on
this!

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

lauuurent, 2025-03-14:
Hello !

### I encountered the same problem on Donkey Kong Country: the game freezes when loading a game, probably because of a conflict with the "START" button.

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

Thanks in advance !

Thread 176 (2022-05-21):

Front mission v1.0b english patched black screen

f3bandit, 2022-05-21:
FIRMWARE V1.11.0 BETA 1 causes black screen when starting Front mission v1.0b english patched.
locks system up, have to manually power cycle to return to menu. Regressing back to v1.10.3 fixes
the loading issue.

f3bandit, 2022-05-24:
Cancel, apparently upon doing further research on the internet I discovered that my AV to HDMI adaptor was sucking alot of power. After plugging in the external power to the hdmi adapter, and updating to v1.11.0 B1 I have no issues. sorry about that! but hopefully this will help others as well. :)

Closed 2022-05-24.

Thread 183 (2023-01-05):

Bad MSU-1 and SGB audio channel balance on SNES Jr

seankhl, 2023-01-05:
I've tested this on two SNES Jrs and had the same result on both: the right channel's audio is much quieter than the left's (maybe by about 8db). Was super frustrating to find that my second console had the same issue as the first, and I began wondering if it's really an issue with the console at all.

But, I tested on my friend's Analogue Super NT and did not have the issue. Maybe I got extremely bad luck with my SNES Jrs, or maybe it's something to do with the SNES Jr revision itself?

Would be happy to provide any other info as necessary to help solve this. Even if it ends up being a strange idiosyncrasy with SNES Jr only, having an option to adjust the on-cart audio channel balance would be greatly appreciated. Obviously I can't just balance the audio output myself because it will affect the console audio balance.

mrehkopf, 2023-01-05:
I have multiple SNES Jr. and cannot confirm this issue at least for my units. Which sd2snes/FXPAK hardware revision are you using?

My current guess is this: The SNES has pretty low impediance on the Line input pins on the cart slot - 200 Ohms per channel. If for some reason one of the audio outputs on the FXPAK has become high impedance (caused by, e.g. a faulty ferrite bead on one of the channels, or some passive surrounding the opamp, or the opamp itself), the load resistor in the SNES on that channel will reduce the voltage of the audio signal more than on the other channel.

The Super Nt, not having low-impedance line inputs - I just measured around 4 Megaohms, which is parasitic, so basically open line - would not affect the signal in the same way, therefore the difference would be less noticeable, if at all.

seankhl, 2023-01-05:
Hi, it's an FXPAK Pro bough about 2 years ago.

That seems like a good guess. I have some notes from the last time I was debugging this (a couple months after I bought it) and I did test another sd2snes which didn't have the issue. So, I think it may be sensible to pin it down to the cart, and your explanation sounds like a great match for what I'm seeing. Is there anything actionable I can do to confirm or fix this? I know this is a issue board for the firmware, and I posted here with the thought that it could be firmware-related, but regardless any advice would be greatly appreciated.

mrehkopf, 2023-01-06:
If you have a multimeter you could do some measurements. I've attached a picture but I don't know if it's readable very well ^^;
On the measurements between the chip and C391 (the fat capacitor) the line colors denote the probe polarity (i.e., negative probe to the IC pin, positive probe to the end of the capacitor). Polarity doesn't matter for the other measurements.
On the two coupling capacitors (C351, C352) the resistance will be low initially (probably measures around 50kOhms), but will rise increasingly as the capacitors charge. If the resistance stays low (like, below a few kOhms) then that capacitor is bad.

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

Closed 2023-06-25.

Thread 184 (2023-01-28):

1.10.3 OK 1.11.0 KO

josete2k, 2023-01-28:
After the Near's splash screen the sd2snes freezes or have graphical glitches and freezes...

Back to 1.10.3 and it's all ok again.

1CHIP PAL supercic snes (LM78S05 regulator too)

REVH modded board.

josete2k, 2023-01-28:
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

1.11.0b1 same issue

josete2k, 2023-01-28:
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

1.10.3 working

mrehkopf, 2023-01-29:
Wild. Can you run the diagnostic firmware (https://sd2snes.de/files/sd2snes_diagnostic_firmware.zip) and attach the entire log? You can find instructions for running the firmware at https://sd2snes.de/blog/cool-stuff/sd2snes-diagnostics
The new firmware depends more on a specific clock signal from the SNES and I want to check if it arrives at the FPGA properly.

NOTE to anyone else reading this issue: the diagnostics I linked is only for the OG sd2snes.

josete2k, 2023-01-29:
Here you have:

https://pastebin.com/xqjuH3rK

`===log opened===
derp
SD test... please insert card
=============================
data=111133b04504
crc1 = d805a1bf crc2 = d805a1bf   PASSED

RTC Test
========
setting clock to 2011-01-01 00:00:00
2011-01-01 00:00:00
waiting 5 seconds
new time: 2011-01-01 00:00:04
PASSED

FPGA test
=========
configuring fpga...
fpga_pgm: 212501 bytes programmed
FPGA configured
basic communication test...PASSED

RAM test
========
Testing RAM0 (128Mbit) - clearing RAM - writing RAM - verifying RAM -RAM0 PASSED

Testing RAM1 (4Mbit) - writing RAM - verifying RAM...RAM1 PASSED

SD DMA test
===========
clearing RAM - loading test file - verifying -PASSED

Loading SNES test ROM
=====================

sysclk test
===========
measuring SNES clock...
21475787 Hz
21475788 Hz diff = 1  max = 1
21475788 Hz diff = 0  max = 1
21475788 Hz diff = 0  max = 1
   CPUCLK: 3420045
  READCLK: 3094326
 WRITECLK: 162859
  PARDCLK: 162859
  PAWRCLK: 162859
  REFRCLK: 78725
ROMSELCLK: 488578
PASSED

SNES test status: IRQ: 00   PA: 00   MEM: 00/00
SNES test status: IRQ: 5a   PA: 5a   MEM: 00/00
SNES test status: IRQ: 5a   PA: 5a   MEM: 00/01
SNES test status: IRQ: 5a   PA: 5a   MEM: 00/02
SNES test status: IRQ: 5a   PA: 5a   MEM: 00/03
SNES test status: IRQ: 5a   PA: 5a   MEM: 00/04
SNES test status: IRQ: 5a   PA: 5a   MEM: 00/05
SNES test status: IRQ: 5a   PA: 5a   MEM: 00/06
SNES test status: IRQ: 5a   PA: 5a   MEM: 00/07
SNES test status: IRQ: 5a   PA: 5a   MEM: 00/08
SNES test status: IRQ: 5a   PA: 5a   MEM: 00/09
SNES test status: IRQ: 5a   PA: 5a   MEM: 00/0a
SNES test status: IRQ: 5a   PA: 5a   MEM: 00/0b
SNES test status: IRQ: 5a   PA: 5a   MEM: 00/0c
SNES test status: IRQ: 5a   PA: 5a   MEM: 00/0d
SNES test status: IRQ: 5a   PA: 5a   MEM: 00/0e
SNES test status: IRQ: 5a   PA: 5a   MEM: 00/0f
SNES test status: IRQ: 5a   PA: 5a   MEM: 00/10
SNES test status: IRQ: 5a   PA: 5a   MEM: 00/11
SNES test status: IRQ: 5a   PA: 5a   MEM: 00/12
SNES test status: IRQ: 5a   PA: 5a   MEM: 00/13
SNES test status: IRQ: 5a   PA: 5a   MEM: 00/14
SNES test status: IRQ: 5a   PA: 5a   MEM: 00/15
SNES test status: IRQ: 5a   PA: 5a   MEM: 00/16
SNES test status: IRQ: 5a   PA: 5a   MEM: 00/17
SNES test status: IRQ: 5a   PA: 5a   MEM: 00/18
SNES test status: IRQ: 5a   PA: 5a   MEM: 00/19
SNES test status: IRQ: 5a   PA: 5a   MEM: 00/1a
SNES test status: IRQ: 5a   PA: 5a   MEM: 00/1b
SNES test status: IRQ: 5a   PA: 5a   MEM: 00/1c
SNES test status: IRQ: 5a   PA: 5a   MEM: 00/1d
SNES test status: IRQ: 5a   PA: 5a   MEM: 00/1e
SNES test status: IRQ: 5a   PA: 5a   MEM: 00/1f
SNES test status: IRQ: 5a   PA: 5a   MEM: 00/20
SNES test status: IRQ: 5a   PA: 5a   MEM: 00/21
SNES test status: IRQ: 5a   PA: 5a   MEM: 00/22
SNES test status: IRQ: 5a   PA: 5a   MEM: 00/23
SNES test status: IRQ: 5a   PA: 5a   MEM: 00/24
SNES test status: IRQ: 5a   PA: 5a   MEM: 00/25
SNES test status: IRQ: 5a   PA: 5a   MEM: 00/26
SNES test status: IRQ: 5a   PA: 5a   MEM: 00/27
SNES test status: IRQ: 5a   PA: 5a   MEM: 00/28
SNES test status: IRQ: 5a   PA: 5a   MEM: 00/29
SNES test status: IRQ: 5a   PA: 5a   MEM: 00/2a
SNES test status: IRQ: 5a   PA: 5a   MEM: 00/2b
SNES test status: IRQ: 5a   PA: 5a   MEM: 00/2c
SNES test status: IRQ: 5a   PA: 5a   MEM: 00/2d
SNES test status: IRQ: 5a   PA: 5a   MEM: 00/2e
SNES test status: IRQ: 5a   PA: 5a   MEM: 00/2f
SNES test status: IRQ: 5a   PA: 5a   MEM: 00/30
SNES test status: IRQ: 5a   PA: 5a   MEM: 00/31
SNES test status: IRQ: 5a   PA: 5a   MEM: 00/32
SNES test status: IRQ: 5a   PA: 5a   MEM: 00/33
SNES test status: IRQ: 5a   PA: 5a   MEM: 00/34
SNES test status: IRQ: 5a   PA: 5a   MEM: 00/35
SNES test status: IRQ: 5a   PA: 5a   MEM: 00/36
SNES test status: IRQ: 5a   PA: 5a   MEM: 00/37
SNES test status: IRQ: 5a   PA: 5a   MEM: 00/38
SNES test status: IRQ: 5a   PA: 5a   MEM: 00/39
SNES test status: IRQ: 5a   PA: 5a   MEM: 00/3a
SNES test status: IRQ: 5a   PA: 5a   MEM: 00/3b
SNES test status: IRQ: 5a   PA: 5a   MEM: 00/3c
SNES test status: IRQ: 5a   PA: 5a   MEM: 00/3d
SNES test status: IRQ: 5a   PA: 5a   MEM: 00/40
SNES test status: IRQ: 5a   PA: 5a   MEM: 00/41
SNES test status: IRQ: 5a   PA: 5a   MEM: 00/42
SNES test status: IRQ: 5a   PA: 5a   MEM: 00/43
SNES test status: IRQ: 5a   PA: 5a   MEM: 00/44
SNES test status: IRQ: 5a   PA: 5a   MEM: 00/45
SNES test status: IRQ: 5a   PA: 5a   MEM: 00/46
SNES test status: IRQ: 5a   PA: 5a   MEM: 00/47
SNES test status: IRQ: 5a   PA: 5a   MEM: 00/48
SNES test status: IRQ: 5a   PA: 5a   MEM: 00/49
SNES test status: IRQ: 5a   PA: 5a   MEM: 00/4a
SNES test status: IRQ: 5a   PA: 5a   MEM: 00/4b
SNES test status: IRQ: 5a   PA: 5a   MEM: 00/4c
SNES test status: IRQ: 5a   PA: 5a   MEM: 00/4d
SNES test status: IRQ: 5a   PA: 5a   MEM: 00/4e
SNES test status: IRQ: 5a   PA: 5a   MEM: 00/4f
SNES test status: IRQ: 5a   PA: 5a   MEM: 00/50
SNES test status: IRQ: 5a   PA: 5a   MEM: 00/51
SNES test status: IRQ: 5a   PA: 5a   MEM: 00/52
SNES test status: IRQ: 5a   PA: 5a   MEM: 00/53
SNES test status: IRQ: 5a   PA: 5a   MEM: 00/54
SNES test status: IRQ: 5a   PA: 5a   MEM: 00/55
SNES test status: IRQ: 5a   PA: 5a   MEM: 00/56
SNES test status: IRQ: 5a   PA: 5a   MEM: 00/57
SNES test status: IRQ: 5a   PA: 5a   MEM: 00/58
SNES test status: IRQ: 5a   PA: 5a   MEM: 00/59
SNES test status: IRQ: 5a   PA: 5a   MEM: 00/5a
SNES test status: IRQ: 5a   PA: 5a   MEM: 00/5b
SNES test status: IRQ: 5a   PA: 5a   MEM: 00/5c
SNES test status: IRQ: 5a   PA: 5a   MEM: 00/5d
SNES test status: IRQ: 5a   PA: 5a   MEM: 00/5e
SNES test status: IRQ: 5a   PA: 5a   MEM: 00/5f
SNES test status: IRQ: 5a   PA: 5a   MEM: 00/60
SNES test status: IRQ: 5a   PA: 5a   MEM: 00/61
SNES test status: IRQ: 5a   PA: 5a   MEM: 00/62
SNES test status: IRQ: 5a   PA: 5a   MEM: 00/63
SNES test status: IRQ: 5a   PA: 5a   MEM: 00/64
SNES test status: IRQ: 5a   PA: 5a   MEM: 00/65
SNES test status: IRQ: 5a   PA: 5a   MEM: 00/66
SNES test status: IRQ: 5a   PA: 5a   MEM: 00/67
SNES test status: IRQ: 5a   PA: 5a   MEM: 00/68
SNES test status: IRQ: 5a   PA: 5a   MEM: 00/69
SNES test status: IRQ: 5a   PA: 5a   MEM: 00/6a
SNES test status: IRQ: 5a   PA: 5a   MEM: 00/6b
SNES test status: IRQ: 5a   PA: 5a   MEM: 00/6c
SNES test status: IRQ: 5a   PA: 5a   MEM: 00/6d
SNES test status: IRQ: 5a   PA: 5a   MEM: 00/6e
SNES test status: IRQ: 5a   PA: 5a   MEM: 00/6f
SNES test status: IRQ: 5a   PA: 5a   MEM: 00/70
SNES test status: IRQ: 5a   PA: 5a   MEM: 00/71
SNES test status: IRQ: 5a   PA: 5a   MEM: 00/72
SNES test status: IRQ: 5a   PA: 5a   MEM: 00/73
SNES test status: IRQ: 5a   PA: 5a   MEM: 00/74
SNES test status: IRQ: 5a   PA: 5a   MEM: 00/75
SNES test status: IRQ: 5a   PA: 5a   MEM: 00/76
SNES test status: IRQ: 5a   PA: 5a   MEM: 00/77
SNES test status: IRQ: 5a   PA: 5a   MEM: 00/78
SNES test status: IRQ: 5a   PA: 5a   MEM: 00/79
SNES test status: IRQ: 5a   PA: 5a   MEM: 00/7a
SNES test status: IRQ: 5a   PA: 5a   MEM: 00/7b
SNES test status: IRQ: 5a   PA: 5a   MEM: 00/7c
SNES test status: IRQ: 5a   PA: 5a   MEM: 00/7d
SNES test status: IRQ: 5a   PA: 5a   MEM: 00/7e
SNES test status: IRQ: 5a   PA: 5a   MEM: 00/81
SNES test status: IRQ: 5a   PA: 5a   MEM: 00/82
SNES test status: IRQ: 5a   PA: 5a   MEM: 00/83
SNES test status: IRQ: 5a   PA: 5a   MEM: 00/84
SNES test status: IRQ: 5a   PA: 5a   MEM: 00/85
SNES test status: IRQ: 5a   PA: 5a   MEM: 00/86
SNES test status: IRQ: 5a   PA: 5a   MEM: 00/87
SNES test status: IRQ: 5a   PA: 5a   MEM: 00/88
SNES test status: IRQ: 5a   PA: 5a   MEM: 00/89
SNES test status: IRQ: 5a   PA: 5a   MEM: 00/8a
SNES test status: IRQ: 5a   PA: 5a   MEM: 00/8b
SNES test status: IRQ: 5a   PA: 5a   MEM: 00/8c
SNES test status: IRQ: 5a   PA: 5a   MEM: 00/8d
SNES test status: IRQ: 5a   PA: 5a   MEM: 00/8e
SNES test status: IRQ: 5a   PA: 5a   MEM: 00/8f
SNES test status: IRQ: 5a   PA: 5a   MEM: 00/90
SNES test status: IRQ: 5a   PA: 5a   MEM: 00/91
SNES test status: IRQ: 5a   PA: 5a   MEM: 00/92
SNES test status: IRQ: 5a   PA: 5a   MEM: 00/93
SNES test status: IRQ: 5a   PA: 5a   MEM: 00/94
SNES test status: IRQ: 5a   PA: 5a   MEM: 00/95
SNES test status: IRQ: 5a   PA: 5a   MEM: 00/96
SNES test status: IRQ: 5a   PA: 5a   MEM: 00/97
SNES test status: IRQ: 5a   PA: 5a   MEM: 00/98
SNES test status: IRQ: 5a   PA: 5a   MEM: 00/99
SNES test status: IRQ: 5a   PA: 5a   MEM: 00/9a
SNES test status: IRQ: 5a   PA: 5a   MEM: 00/9b
SNES test status: IRQ: 5a   PA: 5a   MEM: 00/9c
SNES test status: IRQ: 5a   PA: 5a   MEM: 00/9d
SNES test status: IRQ: 5a   PA: 5a   MEM: 00/9e
SNES test status: IRQ: 5a   PA: 5a   MEM: 00/9f
SNES test status: IRQ: 5a   PA: 5a   MEM: 00/a0
SNES test status: IRQ: 5a   PA: 5a   MEM: 00/a1
SNES test status: IRQ: 5a   PA: 5a   MEM: 00/a2
SNES test status: IRQ: 5a   PA: 5a   MEM: 00/a3
SNES test status: IRQ: 5a   PA: 5a   MEM: 00/a4
SNES test status: IRQ: 5a   PA: 5a   MEM: 00/a5
SNES test status: IRQ: 5a   PA: 5a   MEM: 00/a6
SNES test status: IRQ: 5a   PA: 5a   MEM: 00/a7
SNES test status: IRQ: 5a   PA: 5a   MEM: 00/a8
SNES test status: IRQ: 5a   PA: 5a   MEM: 00/a9
SNES test status: IRQ: 5a   PA: 5a   MEM: 00/aa
SNES test status: IRQ: 5a   PA: 5a   MEM: 00/ab
SNES test status: IRQ: 5a   PA: 5a   MEM: 00/ac
SNES test status: IRQ: 5a   PA: 5a   MEM: 00/ad
SNES test status: IRQ: 5a   PA: 5a   MEM: 00/ae
SNES test status: IRQ: 5a   PA: 5a   MEM: 00/af
SNES test status: IRQ: 5a   PA: 5a   MEM: 00/b0
SNES test status: IRQ: 5a   PA: 5a   MEM: 00/b1
SNES test status: IRQ: 5a   PA: 5a   MEM: 00/b2
SNES test status: IRQ: 5a   PA: 5a   MEM: 00/b3
SNES test status: IRQ: 5a   PA: 5a   MEM: 00/b4
SNES test status: IRQ: 5a   PA: 5a   MEM: 00/b5
SNES test status: IRQ: 5a   PA: 5a   MEM: 00/b6
SNES test status: IRQ: 5a   PA: 5a   MEM: 00/b7
SNES test status: IRQ: 5a   PA: 5a   MEM: 00/b8
SNES test status: IRQ: 5a   PA: 5a   MEM: 00/b9
SNES test status: IRQ: 5a   PA: 5a   MEM: 00/ba
SNES test status: IRQ: 5a   PA: 5a   MEM: 00/bb
SNES test status: IRQ: 5a   PA: 5a   MEM: 00/bc
SNES test status: IRQ: 5a   PA: 5a   MEM: 00/bd
SNES test status: IRQ: 5a   PA: 5a   MEM: 00/be
SNES test status: IRQ: 5a   PA: 5a   MEM: 00/bf
SNES test status: IRQ: 5a   PA: 5a   MEM: 00/c0
SNES test status: IRQ: 5a   PA: 5a   MEM: 00/c1
SNES test status: IRQ: 5a   PA: 5a   MEM: 00/c2
SNES test status: IRQ: 5a   PA: 5a   MEM: 00/c3
SNES test status: IRQ: 5a   PA: 5a   MEM: 00/c4
SNES test status: IRQ: 5a   PA: 5a   MEM: 00/c5
SNES test status: IRQ: 5a   PA: 5a   MEM: 00/c6
SNES test status: IRQ: 5a   PA: 5a   MEM: 00/c7
SNES test status: IRQ: 5a   PA: 5a   MEM: 00/c8
SNES test status: IRQ: 5a   PA: 5a   MEM: 00/c9
SNES test status: IRQ: 5a   PA: 5a   MEM: 00/ca
SNES test status: IRQ: 5a   PA: 5a   MEM: 00/cb
SNES test status: IRQ: 5a   PA: 5a   MEM: 00/cc
SNES test status: IRQ: 5a   PA: 5a   MEM: 00/cd
SNES test status: IRQ: 5a   PA: 5a   MEM: 00/ce
SNES test status: IRQ: 5a   PA: 5a   MEM: 00/cf
SNES test status: IRQ: 5a   PA: 5a   MEM: 00/d0
SNES test status: IRQ: 5a   PA: 5a   MEM: 00/d1
SNES test status: IRQ: 5a   PA: 5a   MEM: 00/d2
SNES test status: IRQ: 5a   PA: 5a   MEM: 00/d3
SNES test status: IRQ: 5a   PA: 5a   MEM: 00/d4
SNES test status: IRQ: 5a   PA: 5a   MEM: 00/d5
SNES test status: IRQ: 5a   PA: 5a   MEM: 00/d6
SNES test status: IRQ: 5a   PA: 5a   MEM: 00/d7
SNES test status: IRQ: 5a   PA: 5a   MEM: 00/d8
SNES test status: IRQ: 5a   PA: 5a   MEM: 00/d9
SNES test status: IRQ: 5a   PA: 5a   MEM: 00/da
SNES test status: IRQ: 5a   PA: 5a   MEM: 00/db
SNES test status: IRQ: 5a   PA: 5a   MEM: 00/dc
SNES test status: IRQ: 5a   PA: 5a   MEM: 00/dd
SNES test status: IRQ: 5a   PA: 5a   MEM: 00/de
SNES test status: IRQ: 5a   PA: 5a   MEM: 00/df
SNES test status: IRQ: 5a   PA: 5a   MEM: 00/e0
SNES test status: IRQ: 5a   PA: 5a   MEM: 00/e1
SNES test status: IRQ: 5a   PA: 5a   MEM: 00/e2
SNES test status: IRQ: 5a   PA: 5a   MEM: 00/e3
SNES test status: IRQ: 5a   PA: 5a   MEM: 00/e4
SNES test status: IRQ: 5a   PA: 5a   MEM: 00/e5
SNES test status: IRQ: 5a   PA: 5a   MEM: 00/e6
SNES test status: IRQ: 5a   PA: 5a   MEM: 00/e7
SNES test status: IRQ: 5a   PA: 5a   MEM: 00/e8
SNES test status: IRQ: 5a   PA: 5a   MEM: 00/e9
SNES test status: IRQ: 5a   PA: 5a   MEM: 00/ea
SNES test status: IRQ: 5a   PA: 5a   MEM: 00/eb
SNES test status: IRQ: 5a   PA: 5a   MEM: 00/ec
SNES test status: IRQ: 5a   PA: 5a   MEM: 00/ed
SNES test status: IRQ: 5a   PA: 5a   MEM: 00/ee
SNES test status: IRQ: 5a   PA: 5a   MEM: 00/ef
SNES test status: IRQ: 5a   PA: 5a   MEM: 00/f0
SNES test status: IRQ: 5a   PA: 5a   MEM: 00/f1
SNES test status: IRQ: 5a   PA: 5a   MEM: 00/f2
SNES test status: IRQ: 5a   PA: 5a   MEM: 00/f3
SNES test status: IRQ: 5a   PA: 5a   MEM: 00/f4
SNES test status: IRQ: 5a   PA: 5a   MEM: 00/f5
SNES test status: IRQ: 5a   PA: 5a   MEM: 00/f6
SNES test status: IRQ: 5a   PA: 5a   MEM: 00/f7
SNES test status: IRQ: 5a   PA: 5a   MEM: 00/f8
SNES test status: IRQ: 5a   PA: 5a   MEM: 00/f9
SNES test status: IRQ: 5a   PA: 5a   MEM: 00/fa
SNES test status: IRQ: 5a   PA: 5a   MEM: 00/fb
SNES test status: IRQ: 5a   PA: 5a   MEM: 00/fc
SNES test status: IRQ: 5a   PA: 5a   MEM: 00/fd
SNES test status: IRQ: 5a   PA: 5a   MEM: 00/fe
SNES test status: IRQ: 5a   PA: 5a   MEM: 00/ff
SNES test status: IRQ: 5a   PA: 5a   MEM: 00/00
SNES test status: IRQ: 5a   PA: 5a   MEM: 01/00
SNES test status: IRQ: 5a   PA: 5a   MEM: 01/01
SNES test status: IRQ: 5a   PA: 5a   MEM: 01/02
SNES test status: IRQ: 5a   PA: 5a   MEM: 01/03
SNES test status: IRQ: 5a   PA: 5a   MEM: 01/04
SNES test status: IRQ: 5a   PA: 5a   MEM: 01/05
SNES test status: IRQ: 5a   PA: 5a   MEM: 01/06
SNES test status: IRQ: 5a   PA: 5a   MEM: 01/07
SNES test status: IRQ: 5a   PA: 5a   MEM: 01/08
SNES test status: IRQ: 5a   PA: 5a   MEM: 01/09
SNES test status: IRQ: 5a   PA: 5a   MEM: 01/0a
SNES test status: IRQ: 5a   PA: 5a   MEM: 01/0b
SNES test status: IRQ: 5a   PA: 5a   MEM: 01/0c
SNES test status: IRQ: 5a   PA: 5a   MEM: 01/0d
SNES test status: IRQ: 5a   PA: 5a   MEM: 01/0e
SNES test status: IRQ: 5a   PA: 5a   MEM: 01/0f
SNES test status: IRQ: 5a   PA: 5a   MEM: 01/10
SNES test status: IRQ: 5a   PA: 5a   MEM: 01/11
SNES test status: IRQ: 5a   PA: 5a   MEM: 01/12
SNES test status: IRQ: 5a   PA: 5a   MEM: 01/13
SNES test status: IRQ: 5a   PA: 5a   MEM: 01/14
SNES test status: IRQ: 5a   PA: 5a   MEM: 01/15
SNES test status: IRQ: 5a   PA: 5a   MEM: 01/16
SNES test status: IRQ: 5a   PA: 5a   MEM: 01/17
SNES test status: IRQ: 5a   PA: 5a   MEM: 01/18
SNES test status: IRQ: 5a   PA: 5a   MEM: 01/19
SNES test status: IRQ: 5a   PA: 5a   MEM: 01/1a
SNES test status: IRQ: 5a   PA: 5a   MEM: 01/1b
SNES test status: IRQ: 5a   PA: 5a   MEM: 01/1c
SNES test status: IRQ: 5a   PA: 5a   MEM: 01/1d
SNES test status: IRQ: 5a   PA: 5a   MEM: 01/1e
SNES test status: IRQ: 5a   PA: 5a   MEM: 01/1f
SNES test status: IRQ: 5a   PA: 5a   MEM: 01/20
SNES test status: IRQ: 5a   PA: 5a   MEM: 01/21
SNES test status: IRQ: 5a   PA: 5a   MEM: 01/22
SNES test status: IRQ: 5a   PA: 5a   MEM: 01/23
SNES test status: IRQ: 5a   PA: 5a   MEM: 01/24
SNES test status: IRQ: 5a   PA: 5a   MEM: 01/25
SNES test status: IRQ: 5a   PA: 5a   MEM: 01/26
SNES test status: IRQ: 5a   PA: 5a   MEM: 01/27
SNES test status: IRQ: 5a   PA: 5a   MEM: 01/28
SNES test status: IRQ: 5a   PA: 5a   MEM: 01/29
SNES test status: IRQ: 5a   PA: 5a   MEM: 01/2a
SNES test status: IRQ: 5a   PA: 5a   MEM: 01/2b
SNES test status: IRQ: 5a   PA: 5a   MEM: 01/2c
SNES test status: IRQ: 5a   PA: 5a   MEM: 01/2d
SNES test status: IRQ: 5a   PA: 5a   MEM: 01/2e
SNES test status: IRQ: 5a   PA: 5a   MEM: 01/2f
SNES test status: IRQ: 5a   PA: 5a   MEM: 01/30
SNES test status: IRQ: 5a   PA: 5a   MEM: 01/31
SNES test status: IRQ: 5a   PA: 5a   MEM: 01/32
SNES test status: IRQ: 5a   PA: 5a   MEM: 01/33
SNES test status: IRQ: 5a   PA: 5a   MEM: 01/34
SNES test status: IRQ: 5a   PA: 5a   MEM: 01/35
SNES test status: IRQ: 5a   PA: 5a   MEM: 01/36
SNES test status: IRQ: 5a   PA: 5a   MEM: 01/37
SNES test status: IRQ: 5a   PA: 5a   MEM: 01/38
SNES test status: IRQ: 5a   PA: 5a   MEM: 01/39
SNES test status: IRQ: 5a   PA: 5a   MEM: 01/3a
SNES test status: IRQ: 5a   PA: 5a   MEM: 01/3b
SNES test status: IRQ: 5a   PA: 5a   MEM: 01/3c
SNES test status: IRQ: 5a   PA: 5a   MEM: 01/3d
SNES test status: IRQ: 5a   PA: 5a   MEM: 01/3e
SNES test status: IRQ: 5a   PA: 5a   MEM: 01/3f
SNES test status: IRQ: 5a   PA: 5a   MEM: 01/40
SNES test status: IRQ: 5a   PA: 5a   MEM: 01/41
SNES test status: IRQ: 5a   PA: 5a   MEM: 01/42
SNES test status: IRQ: 5a   PA: 5a   MEM: 01/43
SNES test status: IRQ: 5a   PA: 5a   MEM: 01/44
SNES test status: IRQ: 5a   PA: 5a   MEM: 01/45
SNES test status: IRQ: 5a   PA: 5a   MEM: 01/46
SNES test status: IRQ: 5a   PA: 5a   MEM: 01/47
SNES test status: IRQ: 5a   PA: 5a   MEM: 01/48
SNES test status: IRQ: 5a   PA: 5a   MEM: 01/49
SNES test status: IRQ: 5a   PA: 5a   MEM: 01/4a
SNES test status: IRQ: 5a   PA: 5a   MEM: 01/4b
SNES test status: IRQ: 5a   PA: 5a   MEM: 01/4c
SNES test status: IRQ: 5a   PA: 5a   MEM: 01/4d
SNES test status: IRQ: 5a   PA: 5a   MEM: 01/4e
SNES test status: IRQ: 5a   PA: 5a   MEM: 01/4f
SNES test status: IRQ: 5a   PA: 5a   MEM: 01/50
SNES test status: IRQ: 5a   PA: 5a   MEM: 01/51
SNES test status: IRQ: 5a   PA: 5a   MEM: 01/52
SNES test status: IRQ: 5a   PA: 5a   MEM: 01/53
SNES test status: IRQ: 5a   PA: 5a   MEM: 01/54
SNES test status: IRQ: 5a   PA: 5a   MEM: 01/55
SNES test status: IRQ: 5a   PA: 5a   MEM: 01/56
SNES test status: IRQ: 5a   PA: 5a   MEM: 01/57
SNES test status: IRQ: 5a   PA: 5a   MEM: 01/58
SNES test status: IRQ: 5a   PA: 5a   MEM: 01/59
SNES test status: IRQ: 5a   PA: 5a   MEM: 01/5a
SNES test status: IRQ: 5a   PA: 5a   MEM: 01/5b
SNES test status: IRQ: 5a   PA: 5a   MEM: 01/5c
SNES test status: IRQ: 5a   PA: 5a   MEM: 01/5d
SNES test status: IRQ: 5a   PA: 5a   MEM: 01/5e
SNES test status: IRQ: 5a   PA: 5a   MEM: 01/5f
SNES test status: IRQ: 5a   PA: 5a   MEM: 01/60
SNES test status: IRQ: 5a   PA: 5a   MEM: 01/61
SNES test status: IRQ: 5a   PA: 5a   MEM: 01/62
SNES test status: IRQ: 5a   PA: 5a   MEM: 01/63
SNES test status: IRQ: 5a   PA: 5a   MEM: 01/64
SNES test status: IRQ: 5a   PA: 5a   MEM: 01/65
SNES test status: IRQ: 5a   PA: 5a   MEM: 01/66
SNES test status: IRQ: 5a   PA: 5a   MEM: 01/67
SNES test status: IRQ: 5a   PA: 5a   MEM: 01/68
SNES test status: IRQ: 5a   PA: 5a   MEM: 01/69
SNES test status: IRQ: 5a   PA: 5a   MEM: 01/6a
SNES test status: IRQ: 5a   PA: 5a   MEM: 01/6b
SNES test status: IRQ: 5a   PA: 5a   MEM: 01/6c
SNES test status: IRQ: 5a   PA: 5a   MEM: 01/6d
SNES test status: IRQ: 5a   PA: 5a   MEM: 01/6e
SNES test status: IRQ: 5a   PA: 5a   MEM: 01/6f
SNES test status: IRQ: 5a   PA: 5a   MEM: 01/70
SNES test status: IRQ: 5a   PA: 5a   MEM: 01/71
SNES test status: IRQ: 5a   PA: 5a   MEM: 01/72
SNES test status: IRQ: 5a   PA: 5a   MEM: 01/73
SNES test status: IRQ: 5a   PA: 5a   MEM: 01/74
SNES test status: IRQ: 5a   PA: 5a   MEM: 01/75
SNES test status: IRQ: 5a   PA: 5a   MEM: 01/76
SNES test status: IRQ: 5a   PA: 5a   MEM: 01/77
SNES test status: IRQ: 5a   PA: 5a   MEM: 01/78
SNES test status: IRQ: 5a   PA: 5a   MEM: 01/79
SNES test status: IRQ: 5a   PA: 5a   MEM: 01/7a
SNES test status: IRQ: 5a   PA: 5a   MEM: 01/7b
SNES test status: IRQ: 5a   PA: 5a   MEM: 01/7c
SNES test status: IRQ: 5a   PA: 5a   MEM: 01/7d
SNES test status: IRQ: 5a   PA: 5a   MEM: 01/7e
SNES test status: IRQ: 5a   PA: 5a   MEM: 01/81
SNES test status: IRQ: 5a   PA: 5a   MEM: 01/82
SNES test status: IRQ: 5a   PA: 5a   MEM: 01/83
SNES test status: IRQ: 5a   PA: 5a   MEM: 01/84
SNES test status: IRQ: 5a   PA: 5a   MEM: 01/85
SNES test status: IRQ: 5a   PA: 5a   MEM: 01/86
SNES test status: IRQ: 5a   PA: 5a   MEM: 01/87
SNES test status: IRQ: 5a   PA: 5a   MEM: 01/88
SNES test status: IRQ: 5a   PA: 5a   MEM: 01/89
SNES test status: IRQ: 5a   PA: 5a   MEM: 01/8a
SNES test status: IRQ: 5a   PA: 5a   MEM: 01/8b
SNES test status: IRQ: 5a   PA: 5a   MEM: 01/8c
SNES test status: IRQ: 5a   PA: 5a   MEM: 01/8d
SNES test status: IRQ: 5a   PA: 5a   MEM: 01/8e
SNES test status: IRQ: 5a   PA: 5a   MEM: 01/8f
SNES test status: IRQ: 5a   PA: 5a   MEM: 01/90
SNES test status: IRQ: 5a   PA: 5a   MEM: 01/91
SNES test status: IRQ: 5a   PA: 5a   MEM: 01/92
SNES test status: IRQ: 5a   PA: 5a   MEM: 01/93
SNES test status: IRQ: 5a   PA: 5a   MEM: 01/94
SNES test status: IRQ: 5a   PA: 5a   MEM: 01/95
SNES test status: IRQ: 5a   PA: 5a   MEM: 01/96
SNES test status: IRQ: 5a   PA: 5a   MEM: 01/97
SNES test status: IRQ: 5a   PA: 5a   MEM: 01/98
SNES test status: IRQ: 5a   PA: 5a   MEM: 01/99
SNES test status: IRQ: 5a   PA: 5a   MEM: 01/9a
SNES test status: IRQ: 5a   PA: 5a   MEM: 01/9b
SNES test status: IRQ: 5a   PA: 5a   MEM: 01/9c
SNES test status: IRQ: 5a   PA: 5a   MEM: 01/9d
SNES test status: IRQ: 5a   PA: 5a   MEM: 01/9e
SNES test status: IRQ: 5a   PA: 5a   MEM: 01/9f
SNES test status: IRQ: 5a   PA: 5a   MEM: 01/a0
SNES test status: IRQ: 5a   PA: 5a   MEM: 01/a1
SNES test status: IRQ: 5a   PA: 5a   MEM: 01/a2
SNES test status: IRQ: 5a   PA: 5a   MEM: 01/a3
SNES test status: IRQ: 5a   PA: 5a   MEM: 01/a4
SNES test status: IRQ: 5a   PA: 5a   MEM: 01/a5
SNES test status: IRQ: 5a   PA: 5a   MEM: 01/a6
SNES test status: IRQ: 5a   PA: 5a   MEM: 01/a7
SNES test status: IRQ: 5a   PA: 5a   MEM: 01/a8
SNES test status: IRQ: 5a   PA: 5a   MEM: 01/a9
SNES test status: IRQ: 5a   PA: 5a   MEM: 01/aa
SNES test status: IRQ: 5a   PA: 5a   MEM: 01/ab
SNES test status: IRQ: 5a   PA: 5a   MEM: 01/ac
SNES test status: IRQ: 5a   PA: 5a   MEM: 01/ad
SNES test status: IRQ: 5a   PA: 5a   MEM: 01/ae
SNES test status: IRQ: 5a   PA: 5a   MEM: 01/af
SNES test status: IRQ: 5a   PA: 5a   MEM: 01/b0
SNES test status: IRQ: 5a   PA: 5a   MEM: 01/b1
SNES test status: IRQ: 5a   PA: 5a   MEM: 01/b2
SNES test status: IRQ: 5a   PA: 5a   MEM: 01/b3
SNES test status: IRQ: 5a   PA: 5a   MEM: 01/b4
SNES test status: IRQ: 5a   PA: 5a   MEM: 01/b5
SNES test status: IRQ: 5a   PA: 5a   MEM: 01/b6
SNES test status: IRQ: 5a   PA: 5a   MEM: 01/b7
SNES test status: IRQ: 5a   PA: 5a   MEM: 01/b8
SNES test status: IRQ: 5a   PA: 5a   MEM: 01/b9
SNES test status: IRQ: 5a   PA: 5a   MEM: 01/ba
SNES test status: IRQ: 5a   PA: 5a   MEM: 01/bb
SNES test status: IRQ: 5a   PA: 5a   MEM: 01/bc
SNES test status: IRQ: 5a   PA: 5a   MEM: 01/bd
SNES test status: IRQ: 5a   PA: 5a   MEM: 01/be
SNES test status: IRQ: 5a   PA: 5a   MEM: 01/bf
SNES test status: IRQ: 5a   PA: 5a   MEM: 01/c0
SNES test status: IRQ: 5a   PA: 5a   MEM: 01/c1
SNES test status: IRQ: 5a   PA: 5a   MEM: 01/c2
SNES test status: IRQ: 5a   PA: 5a   MEM: 01/c3
SNES test status: IRQ: 5a   PA: 5a   MEM: 01/c4
SNES test status: IRQ: 5a   PA: 5a   MEM: 01/c5
SNES test status: IRQ: 5a   PA: 5a   MEM: 01/c6
SNES test status: IRQ: 5a   PA: 5a   MEM: 01/c7
SNES test status: IRQ: 5a   PA: 5a   MEM: 01/c8
SNES test status: IRQ: 5a   PA: 5a   MEM: 01/c9
SNES test status: IRQ: 5a   PA: 5a   MEM: 01/ca
SNES test status: IRQ: 5a   PA: 5a   MEM: 01/cb
SNES test status: IRQ: 5a   PA: 5a   MEM: 01/cc
SNES test status: IRQ: 5a   PA: 5a   MEM: 01/cd
SNES test status: IRQ: 5a   PA: 5a   MEM: 01/ce
SNES test status: IRQ: 5a   PA: 5a   MEM: 01/cf
SNES test status: IRQ: 5a   PA: 5a   MEM: 01/d0
`

shadowofdarkness, 2023-01-29:
A year ago I had the same problem where the 1.11.0 beta would start up corrupted or just a black screen but I could run 1.10.3 and play basic non extra chip games. Turns out that my caps where just starting to go bad and I was told the 1.11.0 version actually used more power even just at the menu and that is why it had more problems.
A full capacitor replacement fixed all my problems.

You could have the same issue. Assuming you just upgraded the regulator and left the original caps in.

josete2k, 2023-01-29:
I can play every extra chips (yoshi's Island MSU too) in 10.3

I only replaced the regulator. But, do you Really think that it is a capacitor issue? I'll take a look if this issue cannot be solved by software...

Thanks.

mrehkopf, 2023-01-29:
It could be related to the whole save state logic running along, now triggering some underlying defect; unfortunately your diagnostic log is incomplete, it is missing part of the SNES memory test and the test summary. Did you wait until the LEDs made a running light and the screen turned (hopefully) green?
But the clocks are listed in the log, I think they are a bit high but I need to confirm with reference values.
It is a Brazilian SNES, correct?

mrehkopf, 2023-01-29:
Oh, was just guessing from the unusual system clock (21.45MHz).

josete2k, 2023-01-29:
Well... That's maybe because the supercic mod (with 17.734476Mhz Crystal and a 21.47727Mhz Crystal), isn't it?

josete2k, 2023-01-29:
Full log

https://pastebin.com/xY7JmDLn

===log opened===
derp
SD test... please insert card
=============================
data=111133b04504
crc1 = d805a1bf crc2 = d805a1bf   PASSED

RTC Test
========
setting clock to 2011-01-01 00:00:00
2011-01-01 00:00:00
waiting 5 seconds
new time: 2011-01-01 00:00:04
PASSED

FPGA test
=========
configuring fpga...
fpga_pgm: 212501 bytes programmed
FPGA configured
basic communication test...PASSED

RAM test
========
Testing RAM0 (128Mbit) - clearing RAM - writing RAM - verifying RAM -RAM0 PASSED

Testing RAM1 (4Mbit) - writing RAM - verifying RAM...RAM1 PASSED

SD DMA test
===========
clearing RAM - loading test file - verifying -PASSED

Loading SNES test ROM
=====================

sysclk test
===========
measuring SNES clock...
21475788 Hz
21475787 Hz diff = 1  max = 1
21475788 Hz diff = 1  max = 1
21475787 Hz diff = 1  max = 1
   CPUCLK: 3420044
  READCLK: 3094326
 WRITECLK: 162859
  PARDCLK: 162859
  PAWRCLK: 162859
  REFRCLK: 78725
ROMSELCLK: 488578
PASSED

SNES test status: IRQ: 00   PA: 00   MEM: 00/00
...
SNES test status: IRQ: 5a   PA: 5a   MEM: 5a/00

TEST SUMMARY
============

flash check:   1111-4-33b04504-dfb09a7f-08-11-0
Test      Result
----------------
SD        Passed
USB       not implemented
RTC       Passed
CIC       no run
FPGA      Passed
RAM       Passed
SD DMA    Passed
CLK       Passed
DAC       not implemented
SNES IRQ  Passed
SNES RAM  Passed
SNES PA   Passed

mrehkopf, 2023-02-06:
Can you check if the v1.10.3-frs firmware https://github.com/furious/sd2snes/releases/tag/savestate_v12
Or the https://github.com/RedGuyyyy/sd2snes/releases/tag/usb2snes_v11 works?
Both need to be installed over an existing v1.10.3.

josete2k, 2023-02-06:
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

Yes

mrehkopf, 2023-03-12:
Could you try this FPGA bit file? Just overwrite your original fpga_base.bit in your sd2snes folder with the one from the ZIP file. (Only for OG sd2snes and no expansion chips for now)
[fpga_base_new_address_sampling.zip](https://github.com/mrehkopf/sd2snes/files/10951983/fpga_base_new_address_sampling.zip)

josete2k, 2023-03-12:
I'll test it tomorrow.

Thanks in advance.

josete2k, 2023-03-26:
> Could you try this FPGA bit file? Just overwrite your original fpga_base.bit in your sd2snes folder with the one from the ZIP file. (Only for OG sd2snes and no expansion chips for now) Firmware v1.11.0 needs to be installed first. [fpga_base_new_address_sampling.zip](https://github.com/mrehkopf/sd2snes/files/10951983/fpga_base_new_address_sampling.zip)

Nothing. Black screen.

mrehkopf, 2023-09-17:
https://sd2snes.de/files/sd2snes_v1.11.0-testsampling.zip
Can you extract this over your current v1.11.0 installation (so that fpga_base.bi3 and fpga_base.bit are overwritten) and try if it works better?

josete2k, 2023-10-21:
> https://sd2snes.de/files/sd2snes_v1.11.0-testsampling.zip Can you extract this over your current v1.11.0 installation (so that fpga_base.bi3 and fpga_base.bit are overwritten) and try if it works better? This basically brings back the old sampling as it was in 1.10.3.

Sorry for the later reply

It works!!! But some games like Batman returns PAL show the region warning: "this game is not designed for your console"

Same rom is working with 1.10.3

SuperCIC enhanced ON
menu 60Hz
game auto

I've tested with menu 50 and game 50 and same issue... the console
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

Thread 185 (2023-01-29):

D4 patch doesn't work with v1.11.0 final

Romain80200, 2023-01-29:
I’ve got a bug with d4 patch with this release but it work with the beta.
D4 patch doesn’t work with this release.

With the beta, i turn off patch region and i can launch game like secret of mana (europe) in 60hz with non problem.
But with the new release, i've got the wrong region message at boot.

I use a european SNES with a super CIC and with d4 patch.

mrehkopf, 2023-01-29:
FXPAK and SuperCIC don't play well together if SuperCIC enhanced mode is disabled and other SuperCIC related mods are built into the console.
The reason is that the console SuperCIC can never know the correct region of the game; it guesses it based on the cartridge CIC's region. This only works well with original games. On the sd2snes/FXPAK the cartridge CIC can change region based on the console it is inserted to. Also, the region that the cartridge CIC signals to the console cannot change per game. Probably you got lucky before since your cartridge's CIC was set to PAL but due to some contact issue is now switched to NTSC. Therefore now the SuperCIC in your console will always think that the game is NTSC, and the D4 mod itself will patch to NTSC even though the game expects PAL.

Bottom line: The only sane way to run a SuperCIC cartridge combined with a SuperCIC console is to enable SuperCIC enhanced mode in the menu; you will then have the possibility to change the screen mode independent of the game's region, and it will always signal the correct region to your D4 mod as well.

mistepien, 2023-02-18:
To cut the chase: if SuperCIC mode is turn on in FXPAK menu then should we turn off D4 patch in SuperCIC hardware mod?

mrehkopf, 2023-02-18:
Kinda vice versa - if a D4 mod is installed in the SNES then the SuperCIC mode should be enabled in the FXPAK menu.
If you do not wish to use the SuperCIC mode then the D4 patch of the SuperCIC mod should be disabled.

Romain80200, 2023-02-26:
Hello,
With the [issue186-try2.zip](https://github.com/mrehkopf/sd2snes/files/10778271/issue186-try2.zip) firmware patch, everything is working ok, region patch, video mode, cic ehanced mode, even the led are working again.

Closed 2023-03-12.

Thread 186 (2023-01-29):

[v1.11.0] Dead LEDs and missing card error message

Ramsis-SNES, 2023-01-29:
First of all, thanks for the new firmware release, ikari. :+1:

Two small (?) issues:

- The green and yellow LEDs are dead. Upon power-up (with an SD card inserted), the green LED turns on very briefly, never to light up again afterwards. The yellow LED never shows any sign of life at all. Without an SD card inserted, the green LED lights up, and the red LED flashes. That one (the red LED) at least seems to operate normally.
- With no card inserted, the "No SD Card found!" message won't show up anymore (gray screen).

Tested on both Super Nt and a SuperCIC-enhanced PAL SNES, the results are the same in both cases. I even deleted my config.yml file to rule out any potential issues with that, to no avail. The LED brightness setting doesn't make a difference either, apart from affecting the red LED, obviously.

Edit: My cart is a non-pro version.

mrehkopf, 2023-01-29:
Oh, and here I thought my old weathered MK.II's LEDs were just broken... :sweat_smile:

mrehkopf, 2023-02-17:
Made some fixes in #196 - this also contains another fix which addresses an issue where the wrong video mode is set in SuperCIC pair mode. Please give it a try :)
(Only firmware flash images are included - copy on top of an existing v1.11.0 firmware)
Download: [issue186.zip](https://github.com/mrehkopf/sd2snes/files/10765998/issue186.zip)

mrehkopf, 2023-02-17:
Oh, forgot to mention - I can't reproduce the boot error message problem, always shows for me even on Super Nt :/

Ramsis-SNES, 2023-02-17:
> Made some fixes in #196 - this also contains another fix which addresses an issue where the wrong video mode is set in SuperCIC pair mode. Please give it a try :)

Awesome! I just tested it and the LEDs do indeed light up again. Thanks! :-)

> Oh, forgot to mention - I can't reproduce the boot error message problem, always shows for me even on Super Nt :/

Hmm, weird. It's no big deal of course, but it kind of bothers me as it used to work just fine ... I'm going to try it on at least one other console with different chip revisions to see if that makes a difference.

mistepien, 2023-02-18:
> Made some fixes in #196 - this also contains another fix which addresses an issue where the wrong video mode is set in SuperCIC pair mode. Please give it a try :) (Only firmware flash images are included - copy on top of an existing v1.11.0 firmware) Download: [issue186.zip](https://github.com/mrehkopf/sd2snes/files/10765998/issue186.zip)

It changes nothing with my SuperCIC-only-NTSC issue.

mrehkopf, 2023-02-19:
I cannot find any mention of the issue by you before - what exactly is the issue? Maybe reference or open a new one. Thanks.

mistepien, 2023-02-19:
Sorry, I thought that by " wrong video mode is set in SuperCIC pair mode" you mean https://krikzz.com/forum/index.php?topic=12376.msg88164#msg88164

mrehkopf, 2023-02-19:
Ah, yes, that's the one. So pair mode is enabled (you can change the menu video mode using the SuperCIC settings menu) but a game always runs at 60Hz despite the setting?
(Two SuperCICs (both in console and on cart) aren't really deterministic regarding the detected region and should not be used outside of pair mode, especially when a D4 mod is also involved inside the console)

mistepien, 2023-02-19:
Exactly that happens. How can I turn off one SuperCIC? I have FFVIMAN mod on 1CHIP PAL SNES.

mrehkopf, 2023-02-19:
If you do not wish to use the pair mode but control video mode using the reset button, you can disable SuperCIC in the SuperCIC settings (needs power cycle). However if your SNES SuperCIC mod has a D4 mod integrated it will try patching to constant region reported by the SuperCIC which may not reflect the game being played. The pair mode is designed to circumvent this limitation.
Which sd2snes or fxpak are you using, and did you confirm that the firmware linked above was actually installed? (Check System Information screen, it should say "Firmware version: issue186".

mrehkopf, 2023-02-19:
Found a problem with the Mk.3 (FXPAK Pro) firmware build, the header magic was wrong due to a copy&paste error (see 13a4af4) so it wouldn't update itself...
Please try again with this if you have an FXPAK Pro:
[issue186-try2.zip](https://github.com/mrehkopf/sd2snes/files/10778271/issue186-try2.zip)

mistepien, 2023-02-19:
Great! Actually I was wondering why the version was still 1.11 even if I copied files. I will check out morning. Thanks!

mrehkopf, 2023-02-20:
Yes, the Super Nt has a modified SuperCIC built in. But sadly it does nothing with it, there's no way to do region switching, it is simply ignored by the firmware.

mistepien, 2023-02-20:
>Please try again with this if you have an FXPAK Pro: [issue186-try2.zip](https://github.com/mrehkopf/sd2snes/files/10778271/issue186-try2.zip)

It works like a charm. FXPAK PRO switches NTSC/PAL as it should.

mrehkopf, 2023-02-20:
Ah, I'm relieved. Closing this issue then, next firmware release will have the fix built in :)

mistepien, 2023-02-20:
BTW, did you encounter situation like that with SNES: sometimes FXPAK PRO does not want to boot (green led is blinking) or sometimes gamepad 1 does not work while gamepad 2. If it happens after turning off and turning on FXPAK does not boot. Is it a case of so-called Freak SNES (https://sd2snes.de/blog/faq)?

mrehkopf, 2023-02-20:
Green LED blinking usually means that no firmware was found inside flash. Should never occur when a firmware has been used on the FXPAK at any point in time :) It could be a power supply related issue, the controller thing too.

mistepien, 2023-02-20:
Thank you very much! You and Krikzz are doing great job! FXPAK PRO + SuperCIC + MSU-1 is just mind blowing.

Ramsis-SNES, 2023-02-20:
> Oh, forgot to mention - I can't reproduce the boot error message problem, always shows for me even on Super Nt :/

I just tested the cart with no SD card inserted (and with firmware "issue186" as well as the latest menu.bin with the favorite games fix installed) on three different consoles. Surprisingly, the behavior seems to have changed when compared to firmware v1.11.0 (2-PPU SNES):

- Super Nt: Card error message won't show up (solid gray screen, same as with official v1.11.0); pressing the Reset button makes no difference, and the "Show video mode" option in Debug settings doesn't do anything at all (if that helps/matters)
- 1CHIP Ultra16: Card error message appears, but only in Autoboot mode (skipping U16 menu) (not tested with official v1.11.0); running the cartridge from the menu results in a solid gray screen
- 2-PPU SuperCIC-modded PAL SNES: Card error message appears (as opposed to official v1.11.0, where it wouldn't show up on this exact same console), but only upon cold boot; pressing the Reset button results in a solid gray screen.

@mrehkopf On a regular SNES, does the error message still appear after pressing Reset? (Super Nt might be a different story altogether due to custom system settings, so let's just ignore that for now ... if you'd like to pursue this at all.)

Thanks!

mrehkopf, 2023-02-20:
Resetting never shows the text again since the ROM cleans up the text buffer for the MCU to fill in.
When you run the cart from the Ultra16 menu the MCU will already have filled in the text at that point, only for the ROM to clear it again. ^^

mrehkopf, 2023-02-20:
Actually that would also explain the behaviour on Super Nt. I wonder why it's been working for me 🤔

mrehkopf, 2023-02-21:
Couldn't resist and opened #201. xD Revamping the display a bit.

Ramsis-SNES, 2023-02-21:
> Resetting never shows the text again since the ROM cleans up the text buffer for the MCU to fill in. When you run the cart from the Ultra16 menu the MCU will already have filled in the text at that point, only for the ROM to clear it again. ^^

Ah, I see, that makes sense. Thanks for explaining!

Closed 2023-02-20.

Thread 189 (2023-02-02):

Save State issue - Dragon Quest 5 Translation Patch

skins4thewin, 2023-02-02:
After loading a saved state, the sound effects stop & the game freezes after you take pretty much any action.  Aka making a menu choice, talking to someone, changing rooms, etc.  This has been an ongoing issue with this game since Save States were first introduced.

redacted173, 2023-02-10:
Try adding the following to sd2snes/savestate_fixes.yml on the SD card.  The sound engine has a lot of state controlled by multiple functions which make this complicated.  The fix attempts to reset some of this state so it doesn't lock up.

You'll have to test it out to see if it works for you.  If it locks up in a dialog, try saving again to see if it unlocks itself.  If it doesn't work at all you may have a different checksum in your ROM that needs to replace the "E3DA".

E3DA: # Dragon Quest V (T+Eng 2.01F)
  - 002140,00
  - 0008D8,00
  - 0008DA,00
  - 0008DC,00
BAF9: # Dragon Quest V (JP)
  - 002140,00
  - 0008D8,00
  - 0008DA,00
  - 0008DC,00

skins4thewin, 2023-02-11:
Thanks for looking into this!  However you may as well be talking a foreign language lol as I really am not sure what any of that means...  what exactly am I adding to where?

Sent from my Verizon, Samsung Galaxy smartphone
Get Outlook for Android<https://aka.ms/AAb9ysg>
________________________________
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

redacted173, 2023-02-11:
Let me know if these directions aren't clear:
(1) Insert your SD2SNES's SD memory card into your computer.  Let's assume it shows up as E: drive in windows.

Now you have two choices:
(2a) Download the attached savestate_fixes.zip at the bottom of this comment.  Unzip it.  Copy the savestate_fixes.yml file into the E:\sd2snes\ directory.  Save yes to copying over the existing file.
-or-
(2b) Open the file E:\sd2snes\savestate_fixes.yml in notepad.  It's a text file and you should see text that looks similar to what I put in my previous comment.
(2c) Copy all 10 lines of text starting on the line with "E3DA: ..." in my previous comment to the end of the file and save it.

(3) Insert the SD card back into your SD2SNES and try savestates.

[savestate_fixes.zip](https://github.com/mrehkopf/sd2snes/files/10712108/savestate_fixes.zip)

skins4thewin, 2023-02-11:
Ahh I see, I didn't see the attached file in the last email.  I get it now.  Thanks, I will definitely try this out next time I boot up the game.  Thanks a bunch for giving this issue some attention! :)

Sent from my Verizon, Samsung Galaxy smartphone
Get Outlook for Android<https://aka.ms/AAb9ysg>
________________________________
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

Thread 191 (2023-02-04):

[v1.11.0] Final Fantasy 3/6 - Black/corrupt equip screen with or without in-game hooks

jami3rez, 2023-02-04:
When accessing menus the screen is mostly black and is typically missing information. Sometimes random garbage characters are in the place of letters and numbers.

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

This happens irrespective of whether in-game hooks are turned on or off.

No other games have exhibited any problems with my SD2SNES cart and my SNES console passed all suggested testing suites I have thrown at it.

This problem persists across all firmware I have tried and multiple different ROMs, both official and those with hacked ‘fixes’.

mrehkopf, 2023-02-04:
Thanks for reporting; this increases the number of reports with this issue to three, so there seems to be some consistency to it. So far I haven't been able to reproduce the issue myself...
Does it happen every time you enter the equip menu, or just sometimes? Is it possible to reproduce (for me) when entering the equip menu even in the intro sequence (when Terra is still named "?????")?
Finally, what type of SNES are you using, and do you have 1CHIP Transient Fixes or Brightness Limit enabled in the menu?

jami3rez, 2023-02-05:
Hi, thanks for the replies.

I am not using a PAL, non-1CHIP console.

These problems occur with every single option in the SD2SNES Config menu disabled, that includes Save States, Brightness Limit etc. They occur every time I access the Item, Skills, Equip and Relic menus without fail. Status, Config and Save display normally.

I have recreated the issue from a new game with Terra named ????? below.

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

The following are from a save game about an hour in. This is as far as I have played.

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

Ramsis-SNES, 2023-02-05:
Possibly a 50/60 Hz issue, this is known even with an original cart.

mrehkopf, 2023-02-05:
Oh dear, you're right - it's been such a long time that I had completely forgotten about this issue. Yes, it's indeed a game "bug" when run at 50Hz on a PAL console.

jami3rez, 2023-02-05:
> Possibly a 50/60 Hz issue, this is known to happen even with an original cart.
>
> Edit 2: Try this: [FF6 PAL fix](https://www.romhacking.net/hacks/106/)

Fantastic stuff! This does seem to have done the trick as the menus I mentioned do display normally now.

Couple of caveats.

1. On the intro sequence of the mechs walking through the snow the ground looks like a chess board. Alternating big black squares. Otherwise fine. Could be an issue with the patched ROM I guess, but not a massive issue.
2. With in-game hooks enabled the overworld map flickers constantly. The menus however continue to display fine.

Thanks again for the help.

mrehkopf, 2023-02-05:
Hm! I don't know how the patch works but maybe it just "wastes" cycles to mimic the NTSC timing, up to the point that not enough are left for the in-game hook - in that case it might be possible to loosen the timing of the patch itself a little.

Ramsis-SNES, 2023-02-06:
>     1. On the intro sequence of the mechs walking through the snow the ground looks like a chess board. Alternating big black squares. Otherwise fine. Could be an issue with the patched ROM I guess, but not a massive issue.
Definitely neither an issue with the PAL fix patch nor the sd2snes. Be sure to try the patch on a fresh ROM to rule out any hack incompatibilities. ;-)

> Hm! I don't know how the patch works but maybe it just "wastes" cycles to mimic the NTSC timing, up to the point that not enough are left for the in-game hook - in that case it might be possible to loosen the timing of the patch itself a little.

From my memory, all the PAL fix patch does is re-enable one of the BGs in the menu, and have the sound driver wait for the game engine to catch up in the ending sequence so it won't crash with a black screen. I could be mistaken though ...

StrikerMan780, 2023-05-01:
I get this corruption (but worse) in an NTSC FF3/6 ROM. So, I don't think it's a pal-specific issue. I can't seem to remedy it aside from turning off hooks.

Closed 2023-02-05.

Thread 192 (2023-02-07):

Yoshi's Island Glitches with Big Sprites and 3D elements

rafadorock4, 2023-02-07:
This only happens in the Boss Stages, or other states where big enemies and / or big 3D elements appears. This have always happened with my cart with any firmware version. Such thing only happens in Yoshi's Island, other SuperFX games are fine and other special chip games works just fine too. This has been just a visual / cosmetic issue though, the game does not crashes or gives blank screen, it works perfectly and I could even beat the entire game even with visual glitches going on. I inform that with the genuine cartridge of the game, this does not happens, so it is not my console that is faulty or something...

I'll post screenshots soon.

mrehkopf, 2023-02-07:
Are you possibly running a version of a game that is not matched to your console region? Sounds like a typical 50/60Hz issue :)

rafadorock4, 2023-02-07:
Hi man, maybe I possibly figured out the issue.....

I'm Brazilian, and my console is PAL-M which is the unique color / video type in the World (shits of Brazil...) PAL-M is same as PAL from Europe, but with 60Hz from NTSC.

Below is a test with the 3 regions... First with the EU version:
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

Then, with the Japanese version (same as the one I have in the genuine cartridge) - no issues:
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

Then, I tested with USA version and, it worked :P ....  - no issues...

And then I retested again and again, over and over, and I found the problem... IPS patched ROM for MSU1 is the thing....
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

Look at these lines:
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

I've fought with this for years and finally I discovered the issue on mine... Thank you for your help. I think we can close this, because IPS patched ROMs are not the issue with the cart. I'll try to realize myself what is going on with the patched ROMs because it shouldn't corrupt like that and cause artefacts on screen.

paulofloresjunior, 2023-02-07:
Hi Rafa, here is Paulo from Brazil also. Did you try another MSU version?

Closed 2023-02-07.

Thread 194 (2023-02-16):

1.11.0 - Creating save state causing black screen & music continues

viarurla, 2023-02-16:
Using the FXPAK Pro (not the latest rev) I am having no luck actually creating save states for any games without the screen cutting to black while the music continues in the background.

I've wiped everything including the existing config file and tried games such as Super Metroid (JA/US) and DKC1(US) to no avail. I've tried a multitude of turning game hooks/save states on and off. Are there additional steps I should take to ensure it's not just user error on my part? Everything else with the cart appears to operate flawlessly.

mrehkopf, 2023-02-17:
Did you use a m3nu.bin from a different firmware version? Does it work with Super Mario World?
There's a chance that the state cannot be captured correctly (and restored after saving) because of connection issues; may be worth running https://sd2snes.de/files/sd3snes_diagnostic_firmware.zip as a firmware and checking sd2snes\test_log.txt after completion. (The test will start out with a black screen and not show anything for a minute, then flash the screen a bit and should end in a solid green picture.)

viarurla, 2023-02-17:
Hi! Apologies for the delay but here is the resulting output:
```log

===log opened===
flash check:   1d62b458-b82d6850-c2-11-0
SD test... please insert card
=============================
crc1 = 8a0b9767 crc2 = 8a0b9767   PASSED

RTC Test
========
setting clock to 2019-02-23 00:00:00
2019-02-23 00:00:00
waiting 2 seconds
new time: 2019-02-23 00:00:02
PASSED

FPGA test
=========
configuring fpga...
basic communication test...PASSED

RAM connection test
===================

Testing RAM0.1 (U501)...

Testing RAM0.2 (U502)...

Testing RAM1 (U511)...
PASSED

SD DMA test
===========
clearing RAM - loading test file - verifying -PASSED

Loading SNES test ROM
=====================

sysclk test
===========
measuring SNES clock...
21442821 Hz
21442944 Hz diff = 123  max = 123
21441979 Hz diff = 965  max = 965
21451058 Hz diff = 9079  max = 9079
   CPUCLK: 3357861
  READCLK: 3038064
 WRITECLK: 159898
  PARDCLK: 159899
  PAWRCLK: 159898
  REFRCLK: 78500
ROMSELCLK: 479695
   CICCLK: 3579593
PASSED

SNES test status: IRQ: 00   PA: 00   MEM: 00/00
SNES test status: IRQ: 5a   PA: 5a   MEM: 5a/00

TEST SUMMARY
============

flash check:   1d62b458-b82d6850-c2-11-0
Test      Result
----------------
SD        Passed
USB       not implemented
RTC       Passed
CIC       no run
FPGA      Passed
RAM       Passed
SD DMA    Passed
CLK       Passed
DAC       not implemented
SNES IRQ  Passed
SNES RAM  Passed
SNES PA   Passed
```

I had previously been using a custom menu purely because I only just found out they exist, but the same behaviour is exhibited regardless of that it seems. Interestingly Super Mario World exhibits a slightly different result when attempting to create a save, where there are some green bars along the top third of the screen and the music seems to simply stop altogether.

mrehkopf, 2023-02-17:
Thanks! Test seems to check out; I was going to ask if you are using a Super Nt because the 21MHz clock is moving around a lot, typical for the Zero Delay mode, then I saw your edit :) It's not an issue though.

Can you try setting your Super Nt to boot directly to cartridge and skip the startup animation? There's a slight chance of data corruption when the Super Nt holds the FXPAK in reset too long on bootup, which could also affect the code of the savestate handler.

viarurla, 2023-02-18:
Sadly no luck, really not sure why but I can live without the functionality given that everything else works fine. That said I'll still try a few things on my end but unfortunately it's a lot lower level stuff than I'm used to.

mrehkopf, 2023-02-18:
Sorry to hear that :( I have two Super Nts, maybe I can get the problem to show on either, so far I have only been using one of them (at Firmware 5.0, no JB)

redacted173, 2023-02-20:
Some other things you can try:
1) Furious' savestate firmware based on 1.10.3.  Install to a fresh SD card and run SMW (X+R to save, X+L to load).
https://github.com/furious/sd2snes/releases/download/savestate_v12/sd2snes_v1.10.3-frs-v12.zip
2) Reset SuperNT to default settings.
3) With 1.11.0 start up the first level (to the left) in SMW and immediately try to save (X+R).  Wait a few seconds and then reset to the SD2SNES menu by holding reset for several seconds.  Attach the SMW state from sd2snes/states/<ROMName>.state here.  Save executing successfully shouldn't be dependent on the majority of state, but the contents of the file may suggest how it's failing.

mrehkopf, 2023-02-20:
Now that you mention it I had a problem reported once where savestates were crashing for no apparent reason. Turned out there was a connection problem between the FPGA and PSRAM so it could only do 16-bit writes. Diagnostics didn't catch this error. Cartridge worked surprisingly well otherwise.
I added a corresponding test to the diagnostics for the new Rev.D but still need to backport it and finally roll a unified source for all revisions...

viarurla, 2023-02-20:
Gave the above a try but sadly no states ever seem to get written to the SD card at all, always comes up empty. Knowing my luck it is probably as @mrehkopf has theorised but thank you for the suggestions @redacted173 . I just hope at worst this just means the save states might be off limits but everything else will operate normally. I'll be curious about that new test when available though!

viarurla, 2023-02-20:
Hold the phone... I'm playing ALTTP and already did a normal save, and was like "might as well do a save state even though it'll crash, but who knows" and it inexplicably works... I think I might need to test more games but that seem odd to me

kencald, 2024-03-09:
> Hold the phone... I'm playing ALTTP and already did a normal save, and was like "might as well do a save state even though it'll crash, but who knows" and it inexplicably works... I think I might need to test more games but that seem odd to me

@viarurla  did you ever find a resolution? I seem to be experiencing the same issue using Super NT and SD2SNES 1.11.0 (non-pro). Attempting to create a save state causes a black screen. All other functions with my setup work fine.

Thread 195 (2023-02-17):

RevF advice

jamesgawne, 2023-02-17:
Hi I have a inherited revF board, two pads have been lifted from the SD slot, but looking at the diagram the pin outs dont match to an SD card pin out, so i am a little confussed. can I have some advice on how I can mod the pins as I have tracked them from sd_dat3 to pin55 LPC1754 and sd_cmd to pin61 LPC1754, My issue is when checking the sd card pin outs nothing matches these pin outs for the sd specs. so either im reading it wrong or the schematic is marked up wrong.

I could just make new pads in the locations on the sd card holder but wanted to make absolutely sure its worth my time
by putting a couple of mod wires in to see if it even works.

thx in advance

J
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

mrehkopf, 2023-02-17:
Hi, the SD card's pins can assume different functions based on it's operating mode (SDIO vs. SPI). The wiring you tracked is correct!

| Pin Number | SD Mode | SPI Mode |
| - | - | - |
| 9 | DAT2 | - |
| 1 | DAT3 | - |
| 2 | CMD | MOSI |
| 3 | GND | GND |
| 4 | VDD | VDD |
| 5 | CLK | SCLK |
| 6 | GND | GND |
| 7 | DAT0 | MISO |
| 8 | DAT1 | - |

jamesgawne, 2023-02-17:
Hi sorry been at work all day, thank you for the quick reply, CMD I am thinking of making a new pad from the via right next to it and will try the same from DAT3 there is a via on the way to pin 59 of the LPC infact there are 2, just my soldering skills aren't as they were 20 years ago :), But thank you for confirming the pinout for me.

regards

J

Closed 2023-06-21.

Thread 201 (2023-02-21):

Early error message display unreliable

mrehkopf, 2023-02-21:
Early error messages, like "SD Card not found!", do now show reliably on Super Nt and Ultra16 consoles due to reset timing. Also, resetting the system will cause the message to not show again.

mrehkopf, 2023-02-22:
@Ramsis-SNES feel free to test ;) [issue201.zip](https://github.com/mrehkopf/sd2snes/files/10799011/issue201.zip)

Ramsis-SNES, 2023-02-22:
Good job, ikari! I tried my best but couldn't get the error message to _not_ show up with this firmware. I also like the new, more verbose error messages presented. :+1:

Under very specific circumstances, one issue popped up though: If the sd2snes directory is missing on the SD card **and** the card is write-protected, the respective error message flickers heavily. On one occasion, parts of the system info message (with "SGB ... ok" even) appeared in the lower right corner of the screen after a few seconds. This however only happened one single time (with the flickering message, as described) and I couldn't reproduce it after 10 or so more tries.

I used multiple different SNES consoles for testing this time (Super Nt, 1CHIP Ultra16, stock US 1CHIP, US 1/1/1, US 2/1/1 and even US 2/1/2). Results were consistent across all of them. :-)

mrehkopf, 2023-02-22:
Yay, thanks for testing :) Strange issue though, could it have been a hardware glitch? (I think it's likely)
Do you remember which console it was on?

mrehkopf, 2023-02-22:
Never mind, getting the same. 😂

https://user-images.githubusercontent.com/238664/220615811-1be4ee0a-c71f-4fd6-9b83-30daeebc73a5.mp4

Ramsis-SNES, 2023-02-22:
Right, the flickering was always reproducible, while parts of the system info message appearing was not (should have worded that part more clearly). ;-) I guess it's one and the same issue anyway, no?

mrehkopf, 2023-02-23:
Yeah, the garbage characters are artifacts of the rapid refreshing. The flickering occurred because after displaying the message, the firmware waits for the card to be removed before doing another status refresh; it does so by waiting for a status byte to become non-zero. Not taking into account that the "write protect" flag also makes it non-zero =)
Should be fixed now: [issue201-2.zip](https://github.com/mrehkopf/sd2snes/files/10818675/issue201-2.zip)
I also added printing of the hardware model and revision since that's very useful for support.

Ramsis-SNES, 2023-02-25:
Very nice, thanks! :D The flickering is gone, and I didn't encounter any other problems (tested on 1CHIP Ultra16 and Super Nt for now).

Absoluc4s, 2023-05-11:
This fixed my LED issue with my SD2SNES MKII Rev. F but now whenever I toggle in-game hooks, the screen goes blank for me and I have to power cycle twice for the menu to show again when it happens.

mrehkopf, 2023-05-11:
Can you confirm that this issue goes away when you revert to the previous 1.11.0 release and earlier firmwares?
I've experienced it on an old sd2snes and it was basically caused by a peak in power consumption caused by the SD Card writing throwing off CIC communications; it went away when I swapped cards.

Absoluc4s, 2023-05-11:
It doesn't happen in 1.11.0 or the earlier firmwares.

Closed 2023-02-25.

Thread 203 (2023-02-26):

Leds not working

caio1007, 2023-02-26:
led lights not working on my china s2snes cartridge with last update 11.0 final

mrehkopf, 2023-02-26:
Duplicate of #186

Closed 2023-02-26.

Thread 205 (2023-03-01):

Super Mario RPG Chinese translate on SD2SNES has some problem

hlkencn, 2023-03-01:
Title: Hello, I'm HLKEN, a member of SNES games Chinese Translation Team. Feedback a SA-1 chip control problem encountered in the localization process of a Super Mario RPG game.

Asked the SD2SNES firmware development team for help, our Chinese version ran into problems running on SD2SNES. During the problem location process, we suspected that the firmware of sd2snes simulated the SA-1 chip, and several interface commands may be missing.
[use SA1 wait , like
SA1 WAIT
LDA #$40
STA $002200

s-cpu work

SA1 START
LDA #$00
STA $002200 ]

We did some tests, and passed on multiple simulators in the Chinese version, but failed on sd2snes. [please attach a list of simulators that passed the test].

There are lots of retro game enthusiasts in China who love SNES, many of them are SD2SNES fans, and we hope to solve this problem for them. Looking forward to a response, Best Wishes.

mrehkopf, 2023-03-01:
Hi! I think if such basic things would not work then no commercial games would work at all... could you provide a small test ROM that shows the problem?
One thing to note is that the SA-1 core on the sd2snes/FXPAK Pro currently does not run at original speed but a bit slower. Could that be a cause of the problem?

redacted173, 2023-03-01:
Based on the bit in the description above for $2200 it looks like the SW emulators OR $40 (RDYB) and $20 (RESB) to keep the SA-1 in reset.  But the SD2SNES implementation only looks at $20.  It would be simple enough to OR in $40 in the two places, but is the function identical like the SW emulators assume?  Not clear.

My guess is all commercial games use $20 to get the SA-1 in and out of reset.  SMRPG does.  Is there a reason the translation can't use $20?

mrehkopf, 2023-03-01:
Ah, good find; strange implementation by the emulators. I'd like to run some test code on a real SA-1 to observe its behaviour but the official docs also state only #$20 (RESB) to setup the SA-1 for execution and run it subsequently, and to stop it again. However I guess it should be possible to pause and resume SA-1 execution (in case it's running a poll loop or similar) and resume it using #$40 (RDYB)? Though I don't see why the SA-1 would need to be paused since concurrent S-CPU access is possible at any time anyway.
Also, maybe in case of RDYB it does not heed the contents of the RV and just keeps running from where it was?

redacted173, 2023-03-01:
Yes, quite possible it's a halt as opposed to a reset.  Like you said, synchronization is best done on the fly through variables in I-RAM or BW-RAM.  No reason to halt or reset the SA-1 to accomplish this.  Both the SA-1 and S-CPU often are frequently found in spin loops on variables in those places.

As an aside, one of the hacks (Armageddon?, I think) had a bad pointer to some text which would cause the SA-1 to run through most of its address space.  For some reason S9X was able to recover, but others, including the SD2SNES, would hang.  Not sure if this was ever fixed in the hack.  That's probably not the problem encountered here.

redacted173, 2023-03-01:
Correction: bsnes treats RDYB like a halt as you suggested.  Either bit puts the SA-1 to sleep.

mrehkopf, 2023-03-01:
In a way that it starts from the reset vector again after the bit is cleared?

redacted173, 2023-03-01:
Only RESB starts from the reset vector: https://github.com/devinacker/bsnes-plus/blob/17818367f6832269006989de600e64cda0a16bf4/bsnes/snes/chip/sa1/mmio/mmio.cpp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

Both bits cause the SA-1 to go idle: https://github.com/devinacker/bsnes-plus/blob/17818367f6832269006989de600e64cda0a16bf4/bsnes/snes/chip/sa1/sa1.cpp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

That's one emulator's definition of it.  I don't think there is an official document describing it.

I'm still confused what the problem is with the translation.  I don't understand how these two major control bits are related to it.  An IPS based on some source ROM, save game srm, and explanation of expected behavior would help.

hlkencn, 2023-03-02:
In my Chinese version of Super Mario RPG game, due to the expansion of ROM, I need to pause SA1 and then switch to BANK when reading the expansion of ROM space. If SA1 reads the contents of the BANK during switching, an error will occur. This is why I suspended SA1.

hlkencn, 2023-03-02:
Because the laws of different countries are different, I don't know whether it is appropriate to send ROM links.
Link: https://pan.baidu.com/s/1z-lyp3XjaASV8Chln2UlOw?pwd=smrc
If there is a problem, please let us know.

hlkencn, 2023-03-02:
This Chinese-version game, in China, has been modified by a friend using the original SA1 game cartoon and can run the Chinese-version game normally, so I guess this operation is feasible.

hlkencn, 2023-03-02:
Please forgive me for using automatic translation tools

mrehkopf, 2023-03-02:
Thank you! Unfortunately I cannot create a Baidu account because they do not accept German phone numbers (
+49). But I'll try to find a way.

hlkencn, 2023-03-02:
> Thank you! Unfortunately I cannot create a Baidu account because they do not accept German phone numbers ( +49). But I'll try to find a way.

I can email you ROM. Please give me the EMAIL address

redacted173, 2023-03-02:
I also don't have access.  You can try the attached fpga_sa1.* bit files copied over 1.11.0.  The changes barely fit on SD2SNES mk2.  It only halts execute so you'll have to make sure all the other state machines are idle.

I'm not sure if this would actually work on a real SA-1.  Seems a spin-loop in I-RAM would be a safer solution.

[sd2snes_sa1_waitbit.zip](https://github.com/mrehkopf/sd2snes/files/10871879/sd2snes_sa1_waitbit.zip)

hlkencn, 2023-03-02:
Thank you. I will try.

hlkencn, 2023-03-10:
After testing by friends with sd2snes, this patch does not seem to solve the problem. I tried to modify the NMI of SA1 and use NMI to replace the waiting of SA1. After testing, it is normal. Thank you very much for your suggestion.

hlkencn, 2023-03-11:
After testing by friends with sd2snes, this patch  is effective.
On the other hand I tried to modify the NMI of SA1 and use NMI to replace the waiting of SA1. After testing, it is normal. Thank you very much for your suggestion.

hlkencn, 2023-03-11:
After testing by friends with sd2snes, this patch is effective.
On the other hand I tried to modify the NMI of SA1 and use NMI to replace the waiting of SA1. After testing, it is normal.
Thank you very much for your suggestion and help.

redacted173, 2023-03-12:
Thanks for trying it and I'm happy you were able to get the translation working on sd2snes.

r0g1nh0, 2024-09-09:
@hlkencn Could you send me the files with the modification? I have problems running super mario rpg on my sd2snes rev x2. The game freezes quickly after starting.

Closed 2023-03-13.

Thread 210 (2023-03-15):

fixes yml file for in-game button joypad address

redacted173, 2023-03-15:
As you are already aware, there are several games where in-game buttons either (a) don't work at all (final fight 2?) or (b) only work on some frames even with an optimized in-game hook (savestates disabled).  One solution would be to have a fixes file that maps checksums to WRAM button state addresses which can be read of out of the mirrored WRAM state in PSRAM.  The M3 can overwrite the button address when loading the hook handler and starting the game.  The downside is this is another file to distribute and it's a hack.  You may have other solutions so feel free to close out this issue.

mrehkopf, 2023-03-15:
I just had the same idea while brushing my teeth earlier :> Let's keep this in mind.

Thread 214 (2023-03-24):

Bad MSU-1 Audio with FXPak Pro (December 2022 revision)

speedyrules, 2023-03-24:
Hi
I am having issues with SNES MSU-1 Games Audio. Anyone else?
One example is Battletoads in Battlemaniacs, where the sound is all garbled.

I did try a bit around with different setups. i used:
- 1 FXPak Pro (latest revision, ordered it in december 2022 at krikkz.com), running Firmware v1.11.0
- 2 different PAL Super Nes
- 3 different video cables: multiout-composite, multiout-rgb and multiout/rad2x
- 2 tvs (LG Oled C1, hdmi / Sony Bravia Lcd, hdmi, rgb and composite)
- 3 different sd-cards: 1gb, 64gb and 128gb
- 2 msu enhanced games
-- Battletoads in Battlemaniacs (CRC 617ac925), patched and extended (Zeldix as source)
-- Battletoads in Battlemaniacs (USA) (MSU1) [Hack by Conn & Kurrono v3].zip

https://user-images.githubusercontent.com/25831136/227468916-5bbea036-ccb5-41b0-b2c9-80c606505b27.mp4

https://user-images.githubusercontent.com/25831136/227468997-a91386d6-3c8a-4d60-a67c-4c6c378cf373.mp4

speedyrules, 2023-03-25:
i will check 👍
just give me some days, because i won't have access to my stuff the next few days.
but i will do as soon as i can!

speedyrules, 2023-03-26:
@mrehkopf , thank you for your patience :)

So, volume boost is set to "off".
i turned it on to try (+3.5db) and it did - as expected - not get better.
i also turned it off again and tried again, with no better results (i was hoping maybe my turning it on an off to trigger something.. but it didn't)

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

mrehkopf, 2023-03-30:
Weird. I guess you aren't using any pre-boosted PCM packs? I'll check the DAC timing for any quirks... if the samples are shifted by one bit they might clip in a similar fashion.

mrehkopf, 2023-03-30:
Oh, right - can you check if Super Gameboy audio is distorted in the same way?

speedyrules, 2023-04-20:
i did some more testing
- lots of msu-1 sets sound ok
- some don't: another example Top Gear (Intro Sound)

It might be that the PCMs are pre-boosted as you said.
is there any easy-to-use pcm player i can test them myself?

and i was not able to get any super gameboy msu-1 games

it's annyoing to be a noob and not being able to do more technical research, sorry :(

mrehkopf, 2023-04-24:
Hm, I did check the packs you linked and found nothing wrong with them, not pre-boosted either; certainly high amplitude but no clipping. Generally it seems like your audio signal is a bit hot 🤔 I got another bunch of PAL consoles to check if something might be happening in the audio path (e.g. a failing capacitor might happen on two consoles independently, albeit unlikely...)

mrehkopf, 2023-04-24:
It might also be worth checking this out: https://www.zeldix.net/t2068-msu-1-re-normalization-lower-pcm-volume
However even with the PCM files at full blast (but not clipping) the audio should not distort, just be very loud... 🤔

qwertymodo, 2023-04-24:
That Battletoads pack definitely looks like a boosted one.  It's not clipping, but the title track is normalized to 0dB peak, or around -9dBFS RMS, which is almost certainly way too loud.  If that pack is linked somewhere like zeldix, please comment to tell the author they need to properly normalize their tracks.  Since you said it's fine on other packs, this definitely looks like an issue of a bad pack, and not a problem with the FXPAK.

mrehkopf, 2023-04-24:
Still I tried the same pack and don't get any distortion. Maybe my audio path is more forgiving (like I'm using a mixer with 10dB of headroom I think...)

qwertymodo, 2023-04-24:
Yeah, the fact that there's no clipping in the actual files means it's probably possible to tame it down with attenuation in your audio chain, but they definitely don't look correct to me.

speedyrules, 2023-04-25:
thanks for all the input!
so, i will try:
- another snes (if i can find one.. even as we said it would be a big coincidence having the same broken capacitors on 2 sness)
- audacity import and playback
- normalize with the exe file from zeldix (link above)
- contact the zeldix thread directly
i'll be back :)

speedyrules, 2023-04-25:
furhter reply:
Relikk
[Re: Battletoads in Battlemaniacs](https://www.zeldix.net/t1693p75-battletoads-in-battlemaniacs#43288)

    Reply with quote

Post Today at 18:06 by [Relikk](https://www.zeldix.net/u917) (Online)
The amp is purely speculation, as I have no technical knowledge of the workings of it where an SD2SNES is concerned, but it seems like it's sensitive to higher amplitudes.

I have an SD2SNES version of the Pro. It'd be one of the first run Pro's that wouldn't fit into a US cartridge shell, as I got it when it was originally announced.

mrehkopf, 2023-04-25:
Hmm, I guess to rule out or confirm a bad DAC or amp on the FXPak some measurements would need to be done...
I think I can rule out a DAC timing bug; I just shifted all samples left by one bit and the distortion is much much worse even than your initial recordings.

speedyrules, 2023-04-25:
how would i make this measurements on the DAC or amp?

mrehkopf, 2023-04-26:
It would involve taking a multimeter or oscilloscope to some points on the FXPak PCB while it's running - the top shell of the SNES also needs to be removed to be able to reach the points (unless you have some sort of plug-in adapter for playing imports).

speedyrules, 2023-04-26:
ufff.. i am afraid this is out of my reach of abilities :(

i will try the different power bricks though ..and hope there will be a difference..

but else if that does not help, what is your suggestion?
contact krikkz and and for repair?

mrehkopf, 2023-04-26:
If you live in the EU I could take a look at your FXPak personally, probably easier and faster than shipping to and from krikzz.
However we should explore the other possibilities first so please try your other power supplies and I'm going to rig up a SNES to simulate a weak 9V DC supply / failed capacitor.

speedyrules, 2023-04-26:
+1
i live in switzerland :)

- i will check different original power bricks
- and just found another pal snes, with cables and power brick. so i will try that one soonish too

will report after i got that additional snes

mrehkopf, 2023-04-27:
Hmm, Switzerland is geographically convenient but I'd still need to pay import tax when you send it to Germany 😅
I tinkered around a bit yesterday and could provoke the same distortion when running the audio amp rail (which is supposed to be 12V, not 9V, sorry) at around 3.5V. I haven't been able to reach that low a voltage even by removing a bunch of capacitors entirely so I'm wondering if it's even possible to reach that voltage by "natural" causes like aging.
Some other failure modes are possible, like a specific transistor or one of 2-3 resistors failing but how likely is that to happen on two independent consoles?
So my current bet is on the power supply 🤞 Looking forward to your results :)

speedyrules, 2023-05-01:
back amd reporting :)

i did a few things:
- i managed to get an extra PAL snes
- i got some power bricks and measured their output
- created a small SD card just to check the issue i am having
- checked all the power bricks with all the snes
- i checked the pcm files also now on foobar with pcm plugin
- checked import tax issues

let me begin:

now i have 3 PAL snes to test:
A. my yellow one: SNSP-001A (FRG), input AC9V 1.3A, power brick to use NES-002E
B. my mint one: SNSP-001A (FRG), input 9V~ 1.3A, power brick to useNES-002E
C. my buddy's one: SNSP-001A (UKV), input AC9V 1.3 A, power brick to useNES-002-GBR

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

the power bricks:
1. SNES power brick, NES-002EU, output 9V~1.3 A, measured 10.8V
2. SNES power brick, NES-002E, output AC9/9.4V 1.3A, measured 10.7V
3. NES power brick, NES-002ED, output AC 9V 1.3A, measured 11.3V
4. NES power brick, NES-002ED, output AC 9V 1.3A, measured 11.3V
5. NES power brick, NES-002ED, output AC 9V 1.3A, measured 11.3V
6. SNES power brick, NES-002E, output AC9/9.4V 1.3A, measured 10.7V

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

I copied Battledoads and the firmware on a new 1GB SD-Card.
I also found another game with issues: Killer Instinct (Arcade Version): This one has video issues on the left of the screen.
Also copied on that SD Card to test.

Results:
- Console A with all the 6 power bricks: NOK
- Console B with all the 6 power bricks: NOK
- Console C with all the 6 power bricks: NOK

Then i installed foobar2000 (32-bit) with the pcm plugin to check the pcm:
same result as with audacity: the pcm plays well.

last but not least, i did check about import taxes: there are none to pay if it is declared properly as "repair" or "return":

https://www.bazg.admin.ch/bazg/de/home/information-private/interneteinkauf--post--und-kuriersendungen/einfuhr-in-die-schweiz/ruecksendung--reparatur--veredelung.html

oh.. and i also consulted chatGPT: here is its anwer: :)
Hello! I'd be happy to help you with your question.

Super Nintendo consoles can experience a variety of failure scenarios, including sound issues. The likelihood of specific components failing on two independent consoles can vary based on a number of factors, such as age, usage, and environmental conditions.

However, it is not uncommon for electronic components to fail over time due to various factors such as heat, voltage surges, and general wear and tear. Some components, such as transistors and resistors, are more prone to failure than others. In addition, manufacturing defects can also contribute to failures.

That being said, it's important to note that the likelihood of two independent consoles experiencing the exact same failure scenario is relatively low, especially if the consoles were manufactured at different times or in different locations.

If you are experiencing sound issues on your Super Nintendo console, it's best to troubleshoot the issue by checking the console's connections, trying different cables or TV inputs, and testing the console with different games. If the issue persists, it may be necessary to have the console professionally repaired or replaced.

speedyrules, 2023-05-01:
looking forward to your results and opinion :)

mrehkopf, 2023-05-10:
👀 very thorough testing, really doesn't leave anything to be desired. Thank you 🙏
As expected after seeing your results, Variac test did not lead to any new conclusions. 😅 I was able to lower the line voltage to about 160V (~7V secondary) at which point the console started crashing, without any changes in audio.
It must be the FXPak.
Soo hit me up on Discord or Twitter I guess and we can discuss the further details :)

speedyrules, 2023-05-13:
Contacted you on discord 👍

mrehkopf, 2023-06-16:
Turned out to be a broken op-amp IC. Works great after replacing a 20ct part. ;)

speedyrules, 2023-08-10:
And we might have found an issues with the "last run super nt"
Thanks @mrehkopf for the awesome help!

Closed 2023-08-10.

Thread 216 (2023-04-03):

Save states don't work well in Chrono Trigger

FoxLisk, 2023-04-03:
Does anyone know why this is? As far as I can tell, it doesn't use an expansion chip. Loading a save state often immediately messes up graphics, even just saving a state and then loading it without doing anything in between. I'm also getting stuck on just like a full orange screen sometimes.

redacted173, 2023-04-11:
Try the attached fpga_base.bi* files by copying them into your SD card's sd2snes/ directory over the 1.11.0 files of the same name.

Chrono Trigger uses the PPU $2134 register as a source to zero out WRAM using a DMA.  The CTX state machine captures the WRAM write then immediately overwrites the shadow address with the PPU register.  This means we lose the zeroing of WRAM in the save state.  These locations for WRAM are used for indirect HDMA source data to PPU registers which causes graphics to mess up when the save state is loaded.  I'm sure this isn't the only game which does this kind of DMA so hopefully others are working now, too.  The fix blocks the PARD snoop when there is a write.

[sd2snes_ctx_blockpardonwrite.zip](https://github.com/mrehkopf/sd2snes/files/11195516/sd2snes_ctx_blockpardonwrite.zip)

FoxLisk, 2023-04-11:
@redacted173 heyyy it seems to work! I don't have time to test it super thoroughly now, but the very simple stuff that was crashing before no longer does. Thanks so much!

Will this make it into the official sd2snes release at some point?

Closed 2023-04-11.

Thread 217 (2023-04-05):

Miscolored SGB boarder after soft (in game hook) reset

CrispyBuns, 2023-04-05:
After resetting Pokemon silver (MSU1) using the in-game hooks the SGB Border gets miscolored in the prosess

redacted173, 2023-04-29:
Are you using the latest version of the patch?  r2021.04.09?

Does it happen for the unmodified (non-MSU) ROM?

Are you using an unmodified sgb_snes.bin files?

Does it always happen when you reset (L+select+start+R) or just in certain cases?

I tried resetting with the in-game buttons from the title screen and from inside the game in the both the unmodified and MSU ROM and the border colors always look fine.  The only thing I noticed is a few second delay for reset, maybe because of the save RAM?, on the MSU version.

CrispyBuns, 2023-06-14:
Sorry for the late replay Yes I am using an unmodified sgb2_snes.bin. and No I haven't tested with Non MSU-1 games. and yes it only happens when I to a in-game hook reset

Thread 218 (2023-04-09):

SuperCIC not switching 50/60hz

msimplay, 2023-04-09:
I upgraded to FX PAK from an older SD2SNES cart and almost everything is working.

However I did notice that SuperCIC is not working the way it did on the old cart it's actually doing nothing no matter what the setting is in the options menu it stays at 60hz

I can imagine most people don't care about 50hz but it's kinds of nostalgic for me so it would be nice if the SuperCIC option in the cart works as intended

Romain80200, 2023-04-10:
Hello, please try the file in this thread:
https://github.com/mrehkopf/sd2snes/issues/186

It solves the problem with cic and the missing leds.

msimplay, 2023-04-10:
Yes that totally fixed the issue thanks very much

mrehkopf, 2023-04-10:
Thanks. Still busy with family obligations due to Easter break.

Romain80200, 2023-04-10:
Family first.

jamieshaw, 2024-05-01:
Apologies to dig up an old thread, but I've got an SD2SNES that exhibits the same issue with 1.11.0, and having tried the "issue182-try2" firmware, can confirm it does bring back the cart LEDs, but only _sometimes_ properly sets the video mode on the SNES.

There doesn't appear to be any specific pattern that allows me to get into pair mode, just sporadically when turning on the SNES, the light will appear green for PAL (SNSP-CPU-02 console), and it'll work as expected. Maybe 1 in every 20 power-ups.

Most of the time, powering on results in an NTSC signal and appears to not react to pair mode.

jamieshaw, 2024-05-02:
Just to debug further, have tried FW 1.10.3, as well as both variants of "issue186" FW to no avail — the problem is still intermittent.

It seems that for the most part, if it does boot into PAL 50Hz mode, the menu is garbled until reset.  Wondering if it's a timing issue or dodgy SD2SNES cart, it _isn't_ a FXPAK Pro (but now potentially thinking about investing…) 🤔

msimplay, 2024-05-02:
Hmm it depends on your installation of the SuperCIC.

I've had a newer version of SuperCIC snes work fine with new FXPAK pro.

However my old Snes with Super CIC.
Only works properly with Sd2snes.

Also with FXPAK pro I've had some issues with compatibility of some games not working.
I don't know for what reason but i went back to using Sd2snes because I had 2 Snes's with Super CIC and I only needed one.

The main difference is that on fxpak you can use msu1 on SA1 chip games.

But the code base on the old sd2snes is very mature its very stable and works with every game I have thrown at it.

Fxpak is relatively new.

This my personal experience but I thought to just let you know to not sell your sd2snes straight away if you want to buy th Fxpak

jamieshaw, 2024-05-02:
> Hmm it depends on your installation of the SuperCIC.

It's the [SuperCIC AIO board](https://www.retroupgrades.co.uk/product/snes-multi-aio/).

And the SD2SNES I have is an AliExpress clone, which probably doesn't help — but then being open source and all, I thought I'd take the plunge.

Ideally, I'd love to be able to narrow down if it's a software bug, or a hardware issue, as it's easy enough for me to return the SD2SNES and look at alternatives. But I'd begrudge spending twice the amount for a FXPAK Pro, and hit the same problem, or as you say, _other_ issues.

msimplay, 2024-05-02:
There's numerous revisions of the original Sd2snes or I should say fixes.

Now that its a clone I wonder which version of the sd2snes it cloned.

I have an early revision that has numerous issues but issues were worked around in firmware a lot of the time.

Closed 2023-04-10.

Thread 220 (2023-04-21):

More sd2snes save state issues on Chrono Trigger

FoxLisk, 2023-04-21:
please let me know if there's a better place to discuss this

Here's a 5 minute (sorry) highlight with some bugs in it:

* at the beginning i'm in a savestate where, after i win an encounter, my characters are just stuck; the fight doesn't end properly.
* at 2:25 I load an earlier save state to try to correct it. this has messed up graphics on the overworld
* after proceeding back through, i still couldn't finish the fight properly - presumably whatever got 'stuck' was already stuck in the earlier save state; i was hoping some more context might be useful

and here's a clip where i load the wrong savestate, then swap slots and load the one i meant to, and get very corrupted graphics until another savestate reload:

https://clips.twitch.tv/ObeseOddPicklesANELE-uInFO10VmWlGQn8r

full vod can be found here if it's helpful (and i can highlight it for preservation if that's helpful, too) https://www.twitch.tv/videos/1798514926

Romain80200, 2023-04-21:
Hello,
Do you try the fixe in this topic?
https://github.com/mrehkopf/sd2snes/issues/216

FoxLisk, 2023-04-21:
yes, I am using the patched firmware linked in that issue.

redacted173, 2023-04-21:
savestate slots look like they may have several races which allow you to load or save state when the saved state isn't ready.  This can cause random corruption.  But I'm not really an expert on how slots work.  Do you think this occurs if you start from a known, good point in the game and use save states without using slots?  Maybe turn them off in the sd2snes menu just to be safe.

I don't have much time to look at this right now.  Maybe ikari has time.  It's very hard to debug it without something like the following:
- a fast, simple, and repeatable way to reproduce from the beginning of the game
- a fast, simple, and repeatable way to reproduce from a game save (.srm).  Attach the srm to the bug report

You could also try attaching the one of the save states (.state) that is bad, but that may not be enough to debug it.

FoxLisk, 2023-04-22:
> savestate slots look like they may have several races which allow you to load or save state when the saved state isn't ready.

That's good to know, but I doubt I'm triggering it - I'm not like slamming save over and over, or reloading saves instantly or anything.

> a fast, simple, and repeatable way to reproduce from a game save (.srm). Attach the srm to the bug report

I can't literally attach an .srm file to a github issue but you can find it here: https://www.foxlisk.com/public/ct.srm

I assume you have access to a Chrono Trigger rom.

I also recorded a video showing the steps I took to reproduce. https://www.youtube.com/watch?v=YWj1hTJy390

I don't have a repro case for the can't-finish-combat error I reported above. I will let you know if I come up with one.

redacted173, 2023-04-22:
Thanks.  I took a quick look - maybe in another 1-2 weeks I can look more closely.  The freeze is probably audio related.  Try adding the following to the end of sd2snes/savestate_fixes.yml:

788C: 001E84,2140 # Chrono Trigger (US)

My guess is the graphics corruption is a race with savestate slots.  I don't see a feedback mechanism for the SNES code to know that the savestate has been fully loaded into PSRAM before state is loaded.  The M3 can be anywhere in its code and it can take some time before it gets to doing that which includes reading the file from SD.  If the slot hasn't changed then it doesn't matter since the contents are the same, but if it is changed then you get part of the new slot state and part of the old slot.  Would be good for someone else to confirm I'm not reading it wrong, though.

FoxLisk, 2023-04-22:
Thanks, I'll try this! Let me know if you have any updates, or if I can provide anything else useful to the investigation 🙏

redacted173, 2023-04-26:
Try the attached firmware and menu files by copying them into your SD card's sd2snes/ directory over the 1.11.0 files of the same name.  The fix requires both type of files.  System Information should list the version as 1.11.1slot.

This change sets the highest bit in the slot byte when changing slot to prevent a load or save from happening while the MCU is still restoring it.  After the restore is complete the MCU clears the bit.  I believe Ikari said he was going to rewrite the savestate code in a future version so hopefully he can fix this, too.

If you need to attach things in the future, try zipping them first.  Github should accept that.

[sd2snes_slotfix_try1.zip](https://github.com/mrehkopf/sd2snes/files/11331660/sd2snes_slotfix_try1.zip)

FoxLisk, 2023-04-28:
Well, I didn't see any graphical corruption today, so i think this worked, thank you!

Thread 226 (2023-06-21):

Building using MK3 config is currently broken

codemann8, 2023-06-21:
It seems `CONFIG_MK3_STM32 = n` was added to config-mk3 but uart.h is sending it down the wrong path with this line: `#if defined CONFIG_MK3_STM32`

However, even after fixing that line, there are places later on that also seem to fail.

mrehkopf, 2023-06-21:
Weird, I'm compiling with CONFIG=config-mk3 on a regular basis. conf2h.awk should not output any `#define`s for properties set to `n`. What does your obj-mk3/autoconf.h look like? There should be something like this near the top:
```
// CONFIG_MK2 = n
#define CONFIG_MK3
// CONFIG_MK3_STM32 = n
```

codemann8, 2023-06-21:
I don't seem to have that file anywhere

codemann8, 2023-06-21:
Oh...this: https://github.com/mrehkopf/sd2snes/blob/f5c28d83a884f317c32a7c8205f716e91dceceef/.gitignore#L19

mrehkopf, 2023-06-23:
I tried the Docker image on an x86_64 Debian bullseye and it built without problems. I used the prepared build.sh from the repository.

codemann8, 2023-06-24:
As in you used the build.sh from the repo instead of the build.sh from the docker repo?

mrehkopf, 2023-06-24:
Like this:
```
user@host:~/src$ git clone https://github.com/alttpo/sd2snes-build-docker.git
Cloning into 'sd2snes-build-docker'...
remote: Enumerating objects: 38, done.
remote: Counting objects: 100% (38/38), done.
remote: Compressing objects: 100% (29/29), done.
remote: Total 38 (delta 15), reused 28 (delta 7), pack-reused 0
Receiving objects: 100% (38/38), 4.85 MiB | 22.00 MiB/s, done.
Resolving deltas: 100% (15/15), done.
user@host:~/src$ cd sd2snes-build-docker/
user@host:~/src/sd2snes-build-docker$ sudo ./build.sh
Cloning sd2snes repository into sd2snes/
Cloning into 'sd2snes'...
remote: Enumerating objects: 12946, done.
remote: Counting objects: 100% (1772/1772), done.
remote: Compressing objects: 100% (555/555), done.
remote: Total 12946 (delta 1272), reused 1661 (delta 1211), pack-reused 11174
Receiving objects: 100% (12946/12946), 14.81 MiB | 7.40 MiB/s, done.
Resolving deltas: 100% (9294/9294), done.
Building docker image which compiles the sd2snes firmware and FPGA
[+] Building 3764.9s (23/23) FINISHED
 => [internal] load .dockerignore                                                                                                   0.5s
 => => transferring context: 2B                                                                                                     0.1s
 => [internal] load build definition from Dockerfile                                                                                0.6s
 => => transferring dockerfile: 2.50kB                                                                                              0.2s
 => [internal] load metadata for docker.io/stronglytyped/arm-none-eabi-gcc:latest                                                   1.8s
 => [internal] load build context                                                                                                   3.9s
 => => transferring context: 48.18MB                                                                                                3.2s
 => CACHED [install 1/4] FROM docker.io/stronglytyped/arm-none-eabi-gcc:latest@sha256:0a5cf4a7122848d8e1b677695f0ae16891d76a018b82  1.2s
 => CACHED [install 2/4] WORKDIR /work/quartus                                                                                      0.0s
 => [install 3/4] RUN wget https://download.altera.com/akdlm/software/acdsinst/20.1std.1/720/ib_tar/Quartus-lite-20.1.1.720-linu  338.8s
 => [install 4/4] RUN tar xf Quartus-lite-20.1.1.720-linux.tar &&  ./setup.sh --mode unattended --accept_eula 1 --installdir /op  835.0s
 => [stage-1  2/15] COPY --from=install /opt /opt                                                                                 862.4s
 => [stage-1  3/15] WORKDIR /work                                                                                                   2.1s
 => [stage-1  4/15] RUN apt update && apt install -y gawk unzip curl libglib2.0-0 libtcmalloc-minimal4                            110.5s
 => [stage-1  5/15] RUN curl https://getmic.ro | bash ; cp micro /usr/local/bin/                                                   15.3s
 => [stage-1  6/15] RUN mv /opt/intelFPGA_lite/20.1/quartus/linux64/libboost_system.so /opt/intelFPGA_lite/20.1/quartus/linux64/li  3.2s
 => [stage-1  7/15] ADD ./sd2snes /work/sd2snes                                                                                    18.9s
 => [stage-1  8/15] WORKDIR /work/sd2snes                                                                                           1.5s
 => [stage-1  9/15] ADD ./verilog-settings.mk verilog/settings.mk                                                                   1.3s
 => [stage-1 10/15] RUN cd ./utils && make                                                                                          7.2s
 => [stage-1 11/15] RUN cd ./src/utils && make                                                                                      2.7s
 => [stage-1 12/15] RUN cd ./verilog/sd2snes_base && make mk3                                                                     490.1s
 => [stage-1 13/15] RUN cd ./verilog/sd2snes_mini && make mk3                                                                      65.6s
 => [stage-1 14/15] RUN sed -i '27 i #include <ctype.h>' ./src/sgb.c                                                                3.0s
 => [stage-1 15/15] RUN cd ./src && make CONFIG=config-mk3                                                                         22.2s
 => exporting to image                                                                                                            443.8s
 => => exporting layers                                                                                                           443.0s
 => => writing image sha256:e9ebb51b6f03d843e8e5c7fd4316e7a06a58fc932e1af5622d884672be3ffb17                                        0.3s
 => => naming to docker.io/library/sd2snes-fpga                                                                                     0.3s
Creating docker container from the built image to extract im3 files
Extracting im3 files
Successfully copied 146kB to /home/user/src/sd2snes-build-docker/.
Successfully copied 169kB to /home/user/src/sd2snes-build-docker/.
Successfully copied 58.9kB to /home/user/src/sd2snes-build-docker/.
Removing temporary container
ead75e5876c0e2ad8658994a807b9f016741228682b4b99ba9ff3abf36d5af4b
Successfully built firmware and FPGA images for MK3
```

codemann8, 2023-06-25:
Alright, figured out the issue. Turns out that downloading that docker repo's source as a zip file from GitHub's site was stripping out something. Running git clone from MinGW seems to have resolved it.

Closed 2023-06-25.

Thread 230 (2023-07-15):

1.10.3 OK 1.11.0 KO  (Very similar to 184)

jjnetcn, 2023-07-15:
Me and https://github.com/mrehkopf/sd2snes/issues/184 has Almost the same problem
Our test_ Log.txt is very similar, except for the slightly lower clock
His https://pastebin.com/xY7JmDLn My https://pastebin.com/ca5Dsm99

I have tried v.10.3. frs https://github.com/furious/sd2snes/releases/tag/savestate_v12 And USB 2snes_ V11,
https://github.com/RedGuyyyy/sd2snes/releases/tag/usb2snes_v11 They can all work

The main purpose of i upgrading from 1.10.3 to 1.11.0 is to use the savestate function,
but v.10.3. frs does not work well, and there are often problems when loadstage after save,
nd it also damaged my saves xxx.SRM file.

I have tried the firmware v11.0, 1.11.0b2-RevD, v1.11.0b1 that I can find, all likes v.11.0
there are all frozen when the main menu appears,

According to the post, https://github.com/mrehkopf/sd2snes/issues/161 In the environment of v11.0,
When replacing the sampling's base. bit, the system starts with a black screen,
When replacing the sampling1 or sampling2, now can enter the main menu,
but most games cannot start normally (some cannot start, some only have sound and no images, while v.10.3 is fine)

Here is the picture of my sd2snes device:
https://ibb.co/NpBWSC9
https://ibb.co/tDNY2rx
https://ibb.co/CBTqqQz

How should I solve it the problem? thanks advanced

mrehkopf, 2023-09-14:
Hi, sorry for the late reply. Your issue sound much the same like #184 indeed. I found that my new sampling method for stability improvement could have adverse effects on some consoles. I do not know why since I don't own such a console but I will prepare an FPGA bit file for troubleshooting shortly to see if the old method works better for you.

mrehkopf, 2023-09-15:
That said, I looked at your pictures and it seems you have a clone cartridge. So in your case it might be the cartridge.

mrehkopf, 2023-09-17:
https://sd2snes.de/files/sd2snes_v1.11.0-testsampling.zip
Can you extract this over your current v1.11.0 installation (so that fpga_base.bi3 and fpga_base.bit are overwritten) and try if it works better?

Thread 234 (2023-07-31):

[Hardware] Aliexpress clone cart: RTC not ticking

bitrot-alpha, 2023-07-31:
Hi,

Sorry in advance if you don't support Chinese clones.

Board info
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

I bought a clone cart from Aliexpress, and it appears to work fine except that the RTC does not tick when the cart is powered off. It seems to hold whatever time I set it to, but it resets to that exact set time when the cart is powered off or SNES reset is triggered.

The test firmware showed no problems with the cartridge except for the RTC.

I took apart the cartridge to check the battery voltage, and it is at 3.0 volts (Not a CR2032, they used the smaller CR1220 instead). I tried removing the battery and waiting 30 seconds before re-installing it. Is there some other troubleshooting steps I could do? I can send photos of the board.

I am somewhat proficient in SMD soldering. Would replacing the RTC chip do anything useful?

Test firmware log:
```
===log opened===
derp
SD test... please insert card
=============================
data=111133b04504
crc1 = d805a1bf crc2 = d805a1bf   PASSED

RTC Test
========
setting clock to 2011-01-01 00:00:00
2011-01-01 00:00:00
waiting 5 seconds
new time: 2011-01-01 00:00:00
FAILED

FPGA test
=========
configuring fpga...
fpga_pgm: 212501 bytes programmed
FPGA configured
basic communication test...PASSED

RAM test
========
Testing RAM0 (128Mbit) - clearing RAM - writing RAM - verifying RAM -RAM0 PASSED

Testing RAM1 (4Mbit) - writing RAM - verifying RAM...RAM1 PASSED

SD DMA test
===========
clearing RAM - loading test file - verifying -PASSED

Loading SNES test ROM
=====================

sysclk test
===========
measuring SNES clock...
21478008 Hz
21478008 Hz diff = 0  max = 0
21478008 Hz diff = 0  max = 0
21478008 Hz diff = 0  max = 0
   CPUCLK: 3420396
  READCLK: 3094644
 WRITECLK: 162876
  PARDCLK: 162876
  PAWRCLK: 162876
  REFRCLK: 78735
ROMSELCLK: 488628
PASSED

SNES test status: IRQ: 00   PA: 00   MEM: 00/00
SNES test status: IRQ: 00   PA: 5a   MEM: 00/00
SNES test status: IRQ: 5a   PA: 5a   MEM: 00/00
SNES test status: IRQ: 5a   PA: 5a   MEM: 00/01
SNES test status: IRQ: 5a   PA: 5a   MEM: 00/02
SNES test status: IRQ: 5a   PA: 5a   MEM: 00/03
SNES test status: IRQ: 5a   PA: 5a   MEM: 00/04
SNES test status: IRQ: 5a   PA: 5a   MEM: 00/05
SNES test status: IRQ: 5a   PA: 5a   MEM: 00/06
SNES test status: IRQ: 5a   PA: 5a   MEM: 00/07
SNES test status: IRQ: 5a   PA: 5a   MEM: 00/08
SNES test status: IRQ: 5a   PA: 5a   MEM: 00/09
SNES test status: IRQ: 5a   PA: 5a   MEM: 00/0a
SNES test status: IRQ: 5a   PA: 5a   MEM: 00/0b
SNES test status: IRQ: 5a   PA: 5a   MEM: 00/0c
SNES test status: IRQ: 5a   PA: 5a   MEM: 00/0d
SNES test status: IRQ: 5a   PA: 5a   MEM: 00/0e
SNES test status: IRQ: 5a   PA: 5a   MEM: 00/0f
SNES test status: IRQ: 5a   PA: 5a   MEM: 00/10
SNES test status: IRQ: 5a   PA: 5a   MEM: 00/11
SNES test status: IRQ: 5a   PA: 5a   MEM: 00/12
SNES test status: IRQ: 5a   PA: 5a   MEM: 00/13
SNES test status: IRQ: 5a   PA: 5a   MEM: 00/14
SNES test status: IRQ: 5a   PA: 5a   MEM: 00/15
SNES test status: IRQ: 5a   PA: 5a   MEM: 00/16
SNES test status: IRQ: 5a   PA: 5a   MEM: 00/17
SNES test status: IRQ: 5a   PA: 5a   MEM: 00/18
SNES test status: IRQ: 5a   PA: 5a   MEM: 00/19
SNES test status: IRQ: 5a   PA: 5a   MEM: 00/1a
SNES test status: IRQ: 5a   PA: 5a   MEM: 00/1b
SNES test status: IRQ: 5a   PA: 5a   MEM: 00/1c
SNES test status: IRQ: 5a   PA: 5a   MEM: 00/1d
SNES test status: IRQ: 5a   PA: 5a   MEM: 00/1e
SNES test status: IRQ: 5a   PA: 5a   MEM: 00/1f
SNES test status: IRQ: 5a   PA: 5a   MEM: 00/20
SNES test status: IRQ: 5a   PA: 5a   MEM: 00/21
SNES test status: IRQ: 5a   PA: 5a   MEM: 00/22
SNES test status: IRQ: 5a   PA: 5a   MEM: 00/23
SNES test status: IRQ: 5a   PA: 5a   MEM: 00/24
SNES test status: IRQ: 5a   PA: 5a   MEM: 00/25
SNES test status: IRQ: 5a   PA: 5a   MEM: 00/26
SNES test status: IRQ: 5a   PA: 5a   MEM: 00/27
SNES test status: IRQ: 5a   PA: 5a   MEM: 00/28
SNES test status: IRQ: 5a   PA: 5a   MEM: 00/29
SNES test status: IRQ: 5a   PA: 5a   MEM: 00/2a
SNES test status: IRQ: 5a   PA: 5a   MEM: 00/2b
SNES test status: IRQ: 5a   PA: 5a   MEM: 00/2c
SNES test status: IRQ: 5a   PA: 5a   MEM: 00/2d
SNES test status: IRQ: 5a   PA: 5a   MEM: 00/2e
SNES test status: IRQ: 5a   PA: 5a   MEM: 00/2f
SNES test status: IRQ: 5a   PA: 5a   MEM: 00/30
SNES test status: IRQ: 5a   PA: 5a   MEM: 00/31
SNES test status: IRQ: 5a   PA: 5a   MEM: 00/32
SNES test status: IRQ: 5a   PA: 5a   MEM: 00/33
SNES test status: IRQ: 5a   PA: 5a   MEM: 00/34
SNES test status: IRQ: 5a   PA: 5a   MEM: 00/35
SNES test status: IRQ: 5a   PA: 5a   MEM: 00/36
SNES test status: IRQ: 5a   PA: 5a   MEM: 00/37
SNES test status: IRQ: 5a   PA: 5a   MEM: 00/38
SNES test status: IRQ: 5a   PA: 5a   MEM: 00/39
SNES test status: IRQ: 5a   PA: 5a   MEM: 00/3a
SNES test status: IRQ: 5a   PA: 5a   MEM: 00/3b
SNES test status: IRQ: 5a   PA: 5a   MEM: 00/3c
SNES test status: IRQ: 5a   PA: 5a   MEM: 00/3d
SNES test status: IRQ: 5a   PA: 5a   MEM: 00/3e
SNES test status: IRQ: 5a   PA: 5a   MEM: 00/3f
SNES test status: IRQ: 5a   PA: 5a   MEM: 00/40
SNES test status: IRQ: 5a   PA: 5a   MEM: 00/41
SNES test status: IRQ: 5a   PA: 5a   MEM: 00/42
SNES test status: IRQ: 5a   PA: 5a   MEM: 00/43
SNES test status: IRQ: 5a   PA: 5a   MEM: 00/44
SNES test status: IRQ: 5a   PA: 5a   MEM: 00/45
SNES test status: IRQ: 5a   PA: 5a   MEM: 00/46
SNES test status: IRQ: 5a   PA: 5a   MEM: 00/47
SNES test status: IRQ: 5a   PA: 5a   MEM: 00/48
SNES test status: IRQ: 5a   PA: 5a   MEM: 00/49
SNES test status: IRQ: 5a   PA: 5a   MEM: 00/4a
SNES test status: IRQ: 5a   PA: 5a   MEM: 00/4b
SNES test status: IRQ: 5a   PA: 5a   MEM: 00/4c
SNES test status: IRQ: 5a   PA: 5a   MEM: 00/4d
SNES test status: IRQ: 5a   PA: 5a   MEM: 00/4e
SNES test status: IRQ: 5a   PA: 5a   MEM: 00/4f
SNES test status: IRQ: 5a   PA: 5a   MEM: 00/50
SNES test status: IRQ: 5a   PA: 5a   MEM: 00/51
SNES test status: IRQ: 5a   PA: 5a   MEM: 00/52
SNES test status: IRQ: 5a   PA: 5a   MEM: 00/53
SNES test status: IRQ: 5a   PA: 5a   MEM: 00/54
SNES test status: IRQ: 5a   PA: 5a   MEM: 00/55
SNES test status: IRQ: 5a   PA: 5a   MEM: 00/56
SNES test status: IRQ: 5a   PA: 5a   MEM: 00/57
SNES test status: IRQ: 5a   PA: 5a   MEM: 00/58
SNES test status: IRQ: 5a   PA: 5a   MEM: 00/59
SNES test status: IRQ: 5a   PA: 5a   MEM: 00/5a
SNES test status: IRQ: 5a   PA: 5a   MEM: 00/5b
SNES test status: IRQ: 5a   PA: 5a   MEM: 00/5c
SNES test status: IRQ: 5a   PA: 5a   MEM: 00/5d
SNES test status: IRQ: 5a   PA: 5a   MEM: 00/5e
SNES test status: IRQ: 5a   PA: 5a   MEM: 00/5f
SNES test status: IRQ: 5a   PA: 5a   MEM: 00/60
SNES test status: IRQ: 5a   PA: 5a   MEM: 00/61
SNES test status: IRQ: 5a   PA: 5a   MEM: 00/62
SNES test status: IRQ: 5a   PA: 5a   MEM: 00/63
SNES test status: IRQ: 5a   PA: 5a   MEM: 00/64
SNES test status: IRQ: 5a   PA: 5a   MEM: 00/65
SNES test status: IRQ: 5a   PA: 5a   MEM: 00/66
SNES test status: IRQ: 5a   PA: 5a   MEM: 00/67
SNES test status: IRQ: 5a   PA: 5a   MEM: 00/68
SNES test status: IRQ: 5a   PA: 5a   MEM: 00/69
SNES test status: IRQ: 5a   PA: 5a   MEM: 00/6a
SNES test status: IRQ: 5a   PA: 5a   MEM: 00/6b
SNES test status: IRQ: 5a   PA: 5a   MEM: 00/6c
SNES test status: IRQ: 5a   PA: 5a   MEM: 00/6d
SNES test status: IRQ: 5a   PA: 5a   MEM: 00/6e
SNES test status: IRQ: 5a   PA: 5a   MEM: 00/6f
SNES test status: IRQ: 5a   PA: 5a   MEM: 00/70
SNES test status: IRQ: 5a   PA: 5a   MEM: 00/71
SNES test status: IRQ: 5a   PA: 5a   MEM: 00/72
SNES test status: IRQ: 5a   PA: 5a   MEM: 00/73
SNES test status: IRQ: 5a   PA: 5a   MEM: 00/74
SNES test status: IRQ: 5a   PA: 5a   MEM: 00/75
SNES test status: IRQ: 5a   PA: 5a   MEM: 00/76
SNES test status: IRQ: 5a   PA: 5a   MEM: 00/77
SNES test status: IRQ: 5a   PA: 5a   MEM: 00/78
SNES test status: IRQ: 5a   PA: 5a   MEM: 00/79
SNES test status: IRQ: 5a   PA: 5a   MEM: 00/7a
SNES test status: IRQ: 5a   PA: 5a   MEM: 00/7b
SNES test status: IRQ: 5a   PA: 5a   MEM: 00/7c
SNES test status: IRQ: 5a   PA: 5a   MEM: 00/7d
SNES test status: IRQ: 5a   PA: 5a   MEM: 00/7e
SNES test status: IRQ: 5a   PA: 5a   MEM: 00/81
SNES test status: IRQ: 5a   PA: 5a   MEM: 00/82
SNES test status: IRQ: 5a   PA: 5a   MEM: 00/83
SNES test status: IRQ: 5a   PA: 5a   MEM: 00/84
SNES test status: IRQ: 5a   PA: 5a   MEM: 00/85
SNES test status: IRQ: 5a   PA: 5a   MEM: 00/86
SNES test status: IRQ: 5a   PA: 5a   MEM: 00/87
SNES test status: IRQ: 5a   PA: 5a   MEM: 00/88
SNES test status: IRQ: 5a   PA: 5a   MEM: 00/89
SNES test status: IRQ: 5a   PA: 5a   MEM: 00/8a
SNES test status: IRQ: 5a   PA: 5a   MEM: 00/8b
SNES test status: IRQ: 5a   PA: 5a   MEM: 00/8c
SNES test status: IRQ: 5a   PA: 5a   MEM: 00/8d
SNES test status: IRQ: 5a   PA: 5a   MEM: 00/8e
SNES test status: IRQ: 5a   PA: 5a   MEM: 00/8f
SNES test status: IRQ: 5a   PA: 5a   MEM: 00/90
SNES test status: IRQ: 5a   PA: 5a   MEM: 00/91
SNES test status: IRQ: 5a   PA: 5a   MEM: 00/92
SNES test status: IRQ: 5a   PA: 5a   MEM: 00/93
SNES test status: IRQ: 5a   PA: 5a   MEM: 00/94
SNES test status: IRQ: 5a   PA: 5a   MEM: 00/95
SNES test status: IRQ: 5a   PA: 5a   MEM: 00/96
SNES test status: IRQ: 5a   PA: 5a   MEM: 00/97
SNES test status: IRQ: 5a   PA: 5a   MEM: 00/98
SNES test status: IRQ: 5a   PA: 5a   MEM: 00/99
SNES test status: IRQ: 5a   PA: 5a   MEM: 00/9a
SNES test status: IRQ: 5a   PA: 5a   MEM: 00/9b
SNES test status: IRQ: 5a   PA: 5a   MEM: 00/9c
SNES test status: IRQ: 5a   PA: 5a   MEM: 00/9d
SNES test status: IRQ: 5a   PA: 5a   MEM: 00/9e
SNES test status: IRQ: 5a   PA: 5a   MEM: 00/9f
SNES test status: IRQ: 5a   PA: 5a   MEM: 00/a0
SNES test status: IRQ: 5a   PA: 5a   MEM: 00/a1
SNES test status: IRQ: 5a   PA: 5a   MEM: 00/a2
SNES test status: IRQ: 5a   PA: 5a   MEM: 00/a3
SNES test status: IRQ: 5a   PA: 5a   MEM: 00/a4
SNES test status: IRQ: 5a   PA: 5a   MEM: 00/a5
SNES test status: IRQ: 5a   PA: 5a   MEM: 00/a6
SNES test status: IRQ: 5a   PA: 5a   MEM: 00/a7
SNES test status: IRQ: 5a   PA: 5a   MEM: 00/a8
SNES test status: IRQ: 5a   PA: 5a   MEM: 00/a9
SNES test status: IRQ: 5a   PA: 5a   MEM: 00/aa
SNES test status: IRQ: 5a   PA: 5a   MEM: 00/ab
SNES test status: IRQ: 5a   PA: 5a   MEM: 00/ac
SNES test status: IRQ: 5a   PA: 5a   MEM: 00/ad
SNES test status: IRQ: 5a   PA: 5a   MEM: 00/ae
SNES test status: IRQ: 5a   PA: 5a   MEM: 00/af
SNES test status: IRQ: 5a   PA: 5a   MEM: 00/b0
SNES test status: IRQ: 5a   PA: 5a   MEM: 00/b1
SNES test status: IRQ: 5a   PA: 5a   MEM: 00/b2
SNES test status: IRQ: 5a   PA: 5a   MEM: 00/b3
SNES test status: IRQ: 5a   PA: 5a   MEM: 00/b4
SNES test status: IRQ: 5a   PA: 5a   MEM: 00/b5
SNES test status: IRQ: 5a   PA: 5a   MEM: 00/b6
SNES test status: IRQ: 5a   PA: 5a   MEM: 00/b7
SNES test status: IRQ: 5a   PA: 5a   MEM: 00/b8
SNES test status: IRQ: 5a   PA: 5a   MEM: 00/b9
SNES test status: IRQ: 5a   PA: 5a   MEM: 00/ba
SNES test status: IRQ: 5a   PA: 5a   MEM: 00/bb
SNES test status: IRQ: 5a   PA: 5a   MEM: 00/bc
SNES test status: IRQ: 5a   PA: 5a   MEM: 00/bd
SNES test status: IRQ: 5a   PA: 5a   MEM: 00/be
SNES test status: IRQ: 5a   PA: 5a   MEM: 00/bf
SNES test status: IRQ: 5a   PA: 5a   MEM: 00/c0
SNES test status: IRQ: 5a   PA: 5a   MEM: 00/c1
SNES test status: IRQ: 5a   PA: 5a   MEM: 00/c2
SNES test status: IRQ: 5a   PA: 5a   MEM: 00/c3
SNES test status: IRQ: 5a   PA: 5a   MEM: 00/c4
SNES test status: IRQ: 5a   PA: 5a   MEM: 00/c5
SNES test status: IRQ: 5a   PA: 5a   MEM: 00/c6
SNES test status: IRQ: 5a   PA: 5a   MEM: 00/c7
SNES test status: IRQ: 5a   PA: 5a   MEM: 00/c8
SNES test status: IRQ: 5a   PA: 5a   MEM: 00/c9
SNES test status: IRQ: 5a   PA: 5a   MEM: 00/ca
SNES test status: IRQ: 5a   PA: 5a   MEM: 00/cb
SNES test status: IRQ: 5a   PA: 5a   MEM: 00/cc
SNES test status: IRQ: 5a   PA: 5a   MEM: 00/cd
SNES test status: IRQ: 5a   PA: 5a   MEM: 00/ce
SNES test status: IRQ: 5a   PA: 5a   MEM: 00/cf
SNES test status: IRQ: 5a   PA: 5a   MEM: 00/d0
SNES test status: IRQ: 5a   PA: 5a   MEM: 00/d1
SNES test status: IRQ: 5a   PA: 5a   MEM: 00/d2
SNES test status: IRQ: 5a   PA: 5a   MEM: 00/d3
SNES test status: IRQ: 5a   PA: 5a   MEM: 00/d4
SNES test status: IRQ: 5a   PA: 5a   MEM: 00/d5
SNES test status: IRQ: 5a   PA: 5a   MEM: 00/d6
SNES test status: IRQ: 5a   PA: 5a   MEM: 00/d7
SNES test status: IRQ: 5a   PA: 5a   MEM: 00/d8
SNES test status: IRQ: 5a   PA: 5a   MEM: 00/d9
SNES test status: IRQ: 5a   PA: 5a   MEM: 00/da
SNES test status: IRQ: 5a   PA: 5a   MEM: 00/db
SNES test status: IRQ: 5a   PA: 5a   MEM: 00/dc
SNES test status: IRQ: 5a   PA: 5a   MEM: 00/dd
SNES test status: IRQ: 5a   PA: 5a   MEM: 00/de
SNES test status: IRQ: 5a   PA: 5a   MEM: 00/df
SNES test status: IRQ: 5a   PA: 5a   MEM: 00/e0
SNES test status: IRQ: 5a   PA: 5a   MEM: 00/e1
SNES test status: IRQ: 5a   PA: 5a   MEM: 00/e2
SNES test status: IRQ: 5a   PA: 5a   MEM: 00/e3
SNES test status: IRQ: 5a   PA: 5a   MEM: 00/e4
SNES test status: IRQ: 5a   PA: 5a   MEM: 00/e5
SNES test status: IRQ: 5a   PA: 5a   MEM: 00/e6
SNES test status: IRQ: 5a   PA: 5a   MEM: 00/e7
SNES test status: IRQ: 5a   PA: 5a   MEM: 00/e8
SNES test status: IRQ: 5a   PA: 5a   MEM: 00/e9
SNES test status: IRQ: 5a   PA: 5a   MEM: 00/ea
SNES test status: IRQ: 5a   PA: 5a   MEM: 00/eb
SNES test status: IRQ: 5a   PA: 5a   MEM: 00/ec
SNES test status: IRQ: 5a   PA: 5a   MEM: 00/ed
SNES test status: IRQ: 5a   PA: 5a   MEM: 00/ee
SNES test status: IRQ: 5a   PA: 5a   MEM: 00/ef
SNES test status: IRQ: 5a   PA: 5a   MEM: 00/f0
SNES test status: IRQ: 5a   PA: 5a   MEM: 00/f1
SNES test status: IRQ: 5a   PA: 5a   MEM: 00/f2
SNES test status: IRQ: 5a   PA: 5a   MEM: 00/f3
SNES test status: IRQ: 5a   PA: 5a   MEM: 00/f4
SNES test status: IRQ: 5a   PA: 5a   MEM: 00/f5
SNES test status: IRQ: 5a   PA: 5a   MEM: 00/f6
SNES test status: IRQ: 5a   PA: 5a   MEM: 00/f7
SNES test status: IRQ: 5a   PA: 5a   MEM: 00/f8
SNES test status: IRQ: 5a   PA: 5a   MEM: 00/f9
SNES test status: IRQ: 5a   PA: 5a   MEM: 00/fa
SNES test status: IRQ: 5a   PA: 5a   MEM: 00/fb
SNES test status: IRQ: 5a   PA: 5a   MEM: 00/fc
SNES test status: IRQ: 5a   PA: 5a   MEM: 00/fd
SNES test status: IRQ: 5a   PA: 5a   MEM: 00/fe
SNES test status: IRQ: 5a   PA: 5a   MEM: 00/ff
SNES test status: IRQ: 5a   PA: 5a   MEM: 00/00
SNES test status: IRQ: 5a   PA: 5a   MEM: 01/00
SNES test status: IRQ: 5a   PA: 5a   MEM: 01/01
SNES test status: IRQ: 5a   PA: 5a   MEM: 01/02
SNES test status: IRQ: 5a   PA: 5a   MEM: 01/03
SNES test status: IRQ: 5a   PA: 5a   MEM: 01/04
SNES test status: IRQ: 5a   PA: 5a   MEM: 01/05
SNES test status: IRQ: 5a   PA: 5a   MEM: 01/06
SNES test status: IRQ: 5a   PA: 5a   MEM: 01/07
SNES test status: IRQ: 5a   PA: 5a   MEM: 01/08
SNES test status: IRQ: 5a   PA: 5a   MEM: 01/09
SNES test status: IRQ: 5a   PA: 5a   MEM: 01/0a
SNES test status: IRQ: 5a   PA: 5a   MEM: 01/0b
SNES test status: IRQ: 5a   PA: 5a   MEM: 01/0c
SNES test status: IRQ: 5a   PA: 5a   MEM: 01/0d
SNES test status: IRQ: 5a   PA: 5a   MEM: 01/0e
SNES test status: IRQ: 5a   PA: 5a   MEM: 01/0f
SNES test status: IRQ: 5a   PA: 5a   MEM: 01/10
SNES test status: IRQ: 5a   PA: 5a   MEM: 01/11
SNES test status: IRQ: 5a   PA: 5a   MEM: 01/12
SNES test status: IRQ: 5a   PA: 5a   MEM: 01/13
SNES test status: IRQ: 5a   PA: 5a   MEM: 01/14
SNES test status: IRQ: 5a   PA: 5a   MEM: 01/15
SNES test status: IRQ: 5a   PA: 5a   MEM: 01/16
SNES test status: IRQ: 5a   PA: 5a   MEM: 01/17
SNES test status: IRQ: 5a   PA: 5a   MEM: 01/18
SNES test status: IRQ: 5a   PA: 5a   MEM: 01/19
SNES test status: IRQ: 5a   PA: 5a   MEM: 01/1a
SNES test status: IRQ: 5a   PA: 5a   MEM: 01/1b
SNES test status: IRQ: 5a   PA: 5a   MEM: 01/1c
SNES test status: IRQ: 5a   PA: 5a   MEM: 01/1d
SNES test status: IRQ: 5a   PA: 5a   MEM: 01/1e
SNES test status: IRQ: 5a   PA: 5a   MEM: 01/1f
SNES test status: IRQ: 5a   PA: 5a   MEM: 01/f0
SNES test status: IRQ: 5a   PA: 5a   MEM: 01/20
SNES test status: IRQ: 5a   PA: 5a   MEM: 01/21
SNES test status: IRQ: 5a   PA: 5a   MEM: 01/22
SNES test status: IRQ: 5a   PA: 5a   MEM: 01/23
SNES test status: IRQ: 5a   PA: 5a   MEM: 01/24
SNES test status: IRQ: 5a   PA: 5a   MEM: 01/25
SNES test status: IRQ: 5a   PA: 5a   MEM: 01/26
SNES test status: IRQ: 5a   PA: 5a   MEM: 01/27
SNES test status: IRQ: 5a   PA: 5a   MEM: 01/28
SNES test status: IRQ: 5a   PA: 5a   MEM: 01/29
SNES test status: IRQ: 5a   PA: 5a   MEM: 01/2a
SNES test status: IRQ: 5a   PA: 5a   MEM: 01/2b
SNES test status: IRQ: 5a   PA: 5a   MEM: 01/2c
SNES test status: IRQ: 5a   PA: 5a   MEM: 01/2d
SNES test status: IRQ: 5a   PA: 5a   MEM: 01/2e
SNES test status: IRQ: 5a   PA: 5a   MEM: 01/2f
SNES test status: IRQ: 5a   PA: 5a   MEM: 01/30
SNES test status: IRQ: 5a   PA: 5a   MEM: 01/31
SNES test status: IRQ: 5a   PA: 5a   MEM: 01/32
SNES test status: IRQ: 5a   PA: 5a   MEM: 01/33
SNES test status: IRQ: 5a   PA: 5a   MEM: 01/34
SNES test status: IRQ: 5a   PA: 5a   MEM: 01/35
SNES test status: IRQ: 5a   PA: 5a   MEM: 01/36
SNES test status: IRQ: 5a   PA: 5a   MEM: 01/37
SNES test status: IRQ: 5a   PA: 5a   MEM: 01/38
SNES test status: IRQ: 5a   PA: 5a   MEM: 01/39
SNES test status: IRQ: 5a   PA: 5a   MEM: 01/3a
SNES test status: IRQ: 5a   PA: 5a   MEM: 01/3b
SNES test status: IRQ: 5a   PA: 5a   MEM: 01/3c
SNES test status: IRQ: 5a   PA: 5a   MEM: 01/3d
SNES test status: IRQ: 5a   PA: 5a   MEM: 01/3e
SNES test status: IRQ: 5a   PA: 5a   MEM: 01/3f
SNES test status: IRQ: 5a   PA: 5a   MEM: 01/40
SNES test status: IRQ: 5a   PA: 5a   MEM: 01/41
SNES test status: IRQ: 5a   PA: 5a   MEM: 01/42
SNES test status: IRQ: 5a   PA: 5a   MEM: 01/43
SNES test status: IRQ: 5a   PA: 5a   MEM: 01/44
SNES test status: IRQ: 5a   PA: 5a   MEM: 01/45
SNES test status: IRQ: 5a   PA: 5a   MEM: 01/46
SNES test status: IRQ: 5a   PA: 5a   MEM: 01/47
SNES test status: IRQ: 5a   PA: 5a   MEM: 01/48
SNES test status: IRQ: 5a   PA: 5a   MEM: 01/49
SNES test status: IRQ: 5a   PA: 5a   MEM: 01/4a
SNES test status: IRQ: 5a   PA: 5a   MEM: 01/4b
SNES test status: IRQ: 5a   PA: 5a   MEM: 01/4c
SNES test status: IRQ: 5a   PA: 5a   MEM: 01/4d
SNES test status: IRQ: 5a   PA: 5a   MEM: 01/4e
SNES test status: IRQ: 5a   PA: 5a   MEM: 01/4f
SNES test status: IRQ: 5a   PA: 5a   MEM: 01/50
SNES test status: IRQ: 5a   PA: 5a   MEM: 01/51
SNES test status: IRQ: 5a   PA: 5a   MEM: 01/52
SNES test status: IRQ: 5a   PA: 5a   MEM: 01/53
SNES test status: IRQ: 5a   PA: 5a   MEM: 01/54
SNES test status: IRQ: 5a   PA: 5a   MEM: 01/55
SNES test status: IRQ: 5a   PA: 5a   MEM: 01/56
SNES test status: IRQ: 5a   PA: 5a   MEM: 01/57
SNES test status: IRQ: 5a   PA: 5a   MEM: 01/58
SNES test status: IRQ: 5a   PA: 5a   MEM: 01/59
SNES test status: IRQ: 5a   PA: 5a   MEM: 01/5a
SNES test status: IRQ: 5a   PA: 5a   MEM: 01/5b
SNES test status: IRQ: 5a   PA: 5a   MEM: 01/5c
SNES test status: IRQ: 5a   PA: 5a   MEM: 01/5d
SNES test status: IRQ: 5a   PA: 5a   MEM: 01/5e
SNES test status: IRQ: 5a   PA: 5a   MEM: 01/5f
SNES test status: IRQ: 5a   PA: 5a   MEM: 01/60
SNES test status: IRQ: 5a   PA: 5a   MEM: 01/61
SNES test status: IRQ: 5a   PA: 5a   MEM: 01/62
SNES test status: IRQ: 5a   PA: 5a   MEM: 01/63
SNES test status: IRQ: 5a   PA: 5a   MEM: 01/64
SNES test status: IRQ: 5a   PA: 5a   MEM: 01/65
SNES test status: IRQ: 5a   PA: 5a   MEM: 01/66
SNES test status: IRQ: 5a   PA: 5a   MEM: 01/67
SNES test status: IRQ: 5a   PA: 5a   MEM: 01/68
SNES test status: IRQ: 5a   PA: 5a   MEM: 01/69
SNES test status: IRQ: 5a   PA: 5a   MEM: 01/6a
SNES test status: IRQ: 5a   PA: 5a   MEM: 01/6b
SNES test status: IRQ: 5a   PA: 5a   MEM: 01/6c
SNES test status: IRQ: 5a   PA: 5a   MEM: 01/6d
SNES test status: IRQ: 5a   PA: 5a   MEM: 01/6e
SNES test status: IRQ: 5a   PA: 5a   MEM: 01/6f
SNES test status: IRQ: 5a   PA: 5a   MEM: 01/70
SNES test status: IRQ: 5a   PA: 5a   MEM: 01/71
SNES test status: IRQ: 5a   PA: 5a   MEM: 01/72
SNES test status: IRQ: 5a   PA: 5a   MEM: 01/73
SNES test status: IRQ: 5a   PA: 5a   MEM: 01/74
SNES test status: IRQ: 5a   PA: 5a   MEM: 01/75
SNES test status: IRQ: 5a   PA: 5a   MEM: 01/76
SNES test status: IRQ: 5a   PA: 5a   MEM: 01/77
SNES test status: IRQ: 5a   PA: 5a   MEM: 01/78
SNES test status: IRQ: 5a   PA: 5a   MEM: 01/79
SNES test status: IRQ: 5a   PA: 5a   MEM: 01/7a
SNES test status: IRQ: 5a   PA: 5a   MEM: 01/7b
SNES test status: IRQ: 5a   PA: 5a   MEM: 01/7c
SNES test status: IRQ: 5a   PA: 5a   MEM: 01/7d
SNES test status: IRQ: 5a   PA: 5a   MEM: 01/7e
SNES test status: IRQ: 5a   PA: 5a   MEM: 01/81
SNES test status: IRQ: 5a   PA: 5a   MEM: 01/82
SNES test status: IRQ: 5a   PA: 5a   MEM: 01/83
SNES test status: IRQ: 5a   PA: 5a   MEM: 01/84
SNES test status: IRQ: 5a   PA: 5a   MEM: 01/85
SNES test status: IRQ: 5a   PA: 5a   MEM: 01/86
SNES test status: IRQ: 5a   PA: 5a   MEM: 01/87
SNES test status: IRQ: 5a   PA: 5a   MEM: 01/88
SNES test status: IRQ: 5a   PA: 5a   MEM: 01/89
SNES test status: IRQ: 5a   PA: 5a   MEM: 01/8a
SNES test status: IRQ: 5a   PA: 5a   MEM: 01/8b
SNES test status: IRQ: 5a   PA: 5a   MEM: 01/8c
SNES test status: IRQ: 5a   PA: 5a   MEM: 01/8d
SNES test status: IRQ: 5a   PA: 5a   MEM: 01/8e
SNES test status: IRQ: 5a   PA: 5a   MEM: 01/8f
SNES test status: IRQ: 5a   PA: 5a   MEM: 01/90
SNES test status: IRQ: 5a   PA: 5a   MEM: 01/91
SNES test status: IRQ: 5a   PA: 5a   MEM: 01/92
SNES test status: IRQ: 5a   PA: 5a   MEM: 01/93
SNES test status: IRQ: 5a   PA: 5a   MEM: 01/94
SNES test status: IRQ: 5a   PA: 5a   MEM: 01/95
SNES test status: IRQ: 5a   PA: 5a   MEM: 01/96
SNES test status: IRQ: 5a   PA: 5a   MEM: 01/97
SNES test status: IRQ: 5a   PA: 5a   MEM: 01/98
SNES test status: IRQ: 5a   PA: 5a   MEM: 01/99
SNES test status: IRQ: 5a   PA: 5a   MEM: 01/9a
SNES test status: IRQ: 5a   PA: 5a   MEM: 01/9b
SNES test status: IRQ: 5a   PA: 5a   MEM: 01/9c
SNES test status: IRQ: 5a   PA: 5a   MEM: 01/9d
SNES test status: IRQ: 5a   PA: 5a   MEM: 01/9e
SNES test status: IRQ: 5a   PA: 5a   MEM: 01/9f
SNES test status: IRQ: 5a   PA: 5a   MEM: 01/a0
SNES test status: IRQ: 5a   PA: 5a   MEM: 01/a1
SNES test status: IRQ: 5a   PA: 5a   MEM: 01/a2
SNES test status: IRQ: 5a   PA: 5a   MEM: 01/a3
SNES test status: IRQ: 5a   PA: 5a   MEM: 01/a4
SNES test status: IRQ: 5a   PA: 5a   MEM: 01/a5
SNES test status: IRQ: 5a   PA: 5a   MEM: 01/a6
SNES test status: IRQ: 5a   PA: 5a   MEM: 01/a7
SNES test status: IRQ: 5a   PA: 5a   MEM: 01/a8
SNES test status: IRQ: 5a   PA: 5a   MEM: 01/a9
SNES test status: IRQ: 5a   PA: 5a   MEM: 01/aa
SNES test status: IRQ: 5a   PA: 5a   MEM: 01/ab
SNES test status: IRQ: 5a   PA: 5a   MEM: 01/ac
SNES test status: IRQ: 5a   PA: 5a   MEM: 01/ad
SNES test status: IRQ: 5a   PA: 5a   MEM: 01/ae
SNES test status: IRQ: 5a   PA: 5a   MEM: 01/af
SNES test status: IRQ: 5a   PA: 5a   MEM: 01/b0
SNES test status: IRQ: 5a   PA: 5a   MEM: 01/b1
SNES test status: IRQ: 5a   PA: 5a   MEM: 01/b2
SNES test status: IRQ: 5a   PA: 5a   MEM: 01/b3
SNES test status: IRQ: 5a   PA: 5a   MEM: 01/b4
SNES test status: IRQ: 5a   PA: 5a   MEM: 01/b5
SNES test status: IRQ: 5a   PA: 5a   MEM: 01/b6
SNES test status: IRQ: 5a   PA: 5a   MEM: 01/b7
SNES test status: IRQ: 5a   PA: 5a   MEM: 01/b8
SNES test status: IRQ: 5a   PA: 5a   MEM: 01/b9
SNES test status: IRQ: 5a   PA: 5a   MEM: 01/ba
SNES test status: IRQ: 5a   PA: 5a   MEM: 01/bb
SNES test status: IRQ: 5a   PA: 5a   MEM: 01/bc
SNES test status: IRQ: 5a   PA: 5a   MEM: 01/bd
SNES test status: IRQ: 5a   PA: 5a   MEM: 01/be
SNES test status: IRQ: 5a   PA: 5a   MEM: 01/bf
SNES test status: IRQ: 5a   PA: 5a   MEM: 01/c0
SNES test status: IRQ: 5a   PA: 5a   MEM: 01/c1
SNES test status: IRQ: 5a   PA: 5a   MEM: 01/c2
SNES test status: IRQ: 5a   PA: 5a   MEM: 01/c3
SNES test status: IRQ: 5a   PA: 5a   MEM: 01/c4
SNES test status: IRQ: 5a   PA: 5a   MEM: 01/c5
SNES test status: IRQ: 5a   PA: 5a   MEM: 01/c6
SNES test status: IRQ: 5a   PA: 5a   MEM: 01/c7
SNES test status: IRQ: 5a   PA: 5a   MEM: 01/c8
SNES test status: IRQ: 5a   PA: 5a   MEM: 01/c9
SNES test status: IRQ: 5a   PA: 5a   MEM: 01/ca
SNES test status: IRQ: 5a   PA: 5a   MEM: 01/cb
SNES test status: IRQ: 5a   PA: 5a   MEM: 01/cc
SNES test status: IRQ: 5a   PA: 5a   MEM: 01/cd
SNES test status: IRQ: 5a   PA: 5a   MEM: 01/ce
SNES test status: IRQ: 5a   PA: 5a   MEM: 01/cf
SNES test status: IRQ: 5a   PA: 5a   MEM: 01/d0
SNES test status: IRQ: 5a   PA: 5a   MEM: 01/d1
SNES test status: IRQ: 5a   PA: 5a   MEM: 01/d2
SNES test status: IRQ: 5a   PA: 5a   MEM: 01/d3
SNES test status: IRQ: 5a   PA: 5a   MEM: 01/d4
SNES test status: IRQ: 5a   PA: 5a   MEM: 01/d5
SNES test status: IRQ: 5a   PA: 5a   MEM: 01/d6
SNES test status: IRQ: 5a   PA: 5a   MEM: 01/d7
SNES test status: IRQ: 5a   PA: 5a   MEM: 01/d8
SNES test status: IRQ: 5a   PA: 5a   MEM: 01/d9
SNES test status: IRQ: 5a   PA: 5a   MEM: 01/da
SNES test status: IRQ: 5a   PA: 5a   MEM: 01/db
SNES test status: IRQ: 5a   PA: 5a   MEM: 01/dc
SNES test status: IRQ: 5a   PA: 5a   MEM: 01/dd
SNES test status: IRQ: 5a   PA: 5a   MEM: 01/de
SNES test status: IRQ: 5a   PA: 5a   MEM: 01/df
SNES test status: IRQ: 5a   PA: 5a   MEM: 01/e0
SNES test status: IRQ: 5a   PA: 5a   MEM: 01/e1
SNES test status: IRQ: 5a   PA: 5a   MEM: 01/e2
SNES test status: IRQ: 5a   PA: 5a   MEM: 01/e3
SNES test status: IRQ: 5a   PA: 5a   MEM: 01/e4
SNES test status: IRQ: 5a   PA: 5a   MEM: 01/e5
SNES test status: IRQ: 5a   PA: 5a   MEM: 01/e6
SNES test status: IRQ: 5a   PA: 5a   MEM: 01/e7
SNES test status: IRQ: 5a   PA: 5a   MEM: 01/e8
SNES test status: IRQ: 5a   PA: 5a   MEM: 01/e9
SNES test status: IRQ: 5a   PA: 5a   MEM: 01/ea
SNES test status: IRQ: 5a   PA: 5a   MEM: 01/eb
SNES test status: IRQ: 5a   PA: 5a   MEM: 01/ec
SNES test status: IRQ: 5a   PA: 5a   MEM: 01/ed
SNES test status: IRQ: 5a   PA: 5a   MEM: 01/ee
SNES test status: IRQ: 5a   PA: 5a   MEM: 01/ef
SNES test status: IRQ: 5a   PA: 5a   MEM: 01/f0
SNES test status: IRQ: 5a   PA: 5a   MEM: 01/f1
SNES test status: IRQ: 5a   PA: 5a   MEM: 01/f2
SNES test status: IRQ: 5a   PA: 5a   MEM: 01/f3
SNES test status: IRQ: 5a   PA: 5a   MEM: 01/f4
SNES test status: IRQ: 5a   PA: 5a   MEM: 01/f5
SNES test status: IRQ: 5a   PA: 5a   MEM: 01/f6
SNES test status: IRQ: 5a   PA: 5a   MEM: 01/f7
SNES test status: IRQ: 5a   PA: 5a   MEM: 01/f8
SNES test status: IRQ: 5a   PA: 5a   MEM: 01/f9
SNES test status: IRQ: 5a   PA: 5a   MEM: 01/fa
SNES test status: IRQ: 5a   PA: 5a   MEM: 01/fb
SNES test status: IRQ: 5a   PA: 5a   MEM: 01/fc
SNES test status: IRQ: 5a   PA: 5a   MEM: 01/fd
SNES test status: IRQ: 5a   PA: 5a   MEM: 01/fe
SNES test status: IRQ: 5a   PA: 5a   MEM: 01/ff
SNES test status: IRQ: 5a   PA: 5a   MEM: 01/00
SNES test status: IRQ: 5a   PA: 5a   MEM: 5a/00

TEST SUMMARY
============

flash check:   1111-4-33b04504-dfb09a7f-08-11-0
Test      Result
----------------
SD        Passed
USB       not implemented
RTC       FAILED
CIC       no run
FPGA      Passed
RAM       Passed
SD DMA    Passed
CLK       Passed
DAC       not implemented
SNES IRQ  Passed
SNES RAM  Passed
SNES PA   Passed
```

bitrot-alpha, 2023-07-31:
Board photos

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

bitrot-alpha, 2023-07-31:
Aliexpress seller suggested I solder the USE_BATT jumper (JP402 on this version of the board) then set the time, and then unsolder the jumper. This didn't do anything useful.

mrehkopf, 2023-07-31:
USE_BATT has nothing to do with that, in fact it has no effect at all. Looks like the seller has no idea what they're talking about 😁 RTC failure seems commonplace for those carts, I once fixed one by replacing the load caps on the RTC crystal (C408+C409), they're supposed to be 15pF but you might want to try 12pF or 10pF as well.

But in all honesty it should be the seller's responsibility, not yours nor mine ;)

mrehkopf, 2023-07-31:
Also yikes, what's with the cracked coil on the switching regulator? 😬

bitrot-alpha, 2023-07-31:
Thanks for getting back to me! I'll try ordering some SMD caps I guess. 0608 size?

They shipped the cart in a pretty thin bubble mailer. When I opened the cart up for the first time, I wondered why a tiny little piece fell out, turns out it was that missing chunk of the coil haha.

mrehkopf, 2023-07-31:
Looks like 0603.
Oh dear. Good luck. 🥲

bitrot-alpha, 2023-08-08:
Received my replacement caps today. I tried the 10pf and that didn't fix it.

15pf did work though! I wish I had an ESR meter to check the ones I removed..

Closed 2023-08-08.

Thread 239 (2023-08-15):

SGB: in-game hook reset can cause save corruption

redacted173, 2023-08-15:
Using the in-game hook reset in the Pokemon Gold start menu where it shows the current time can occasionally cause save corruption.  When the corruption happens the game freezes without a successful reset.  Resetting a second time is successful, but the save data is corrupted and saves are gone on next boot.  It's not clear what causes this.  Possibly related to:
- using in-game reset
- save states using overlapping X+R button combination
- SGB to SNES transfers going on in the background

It's difficult to hit as most times the reset works.  Creating an issue to document since it's a particularly bad bug.  I'll have to figure out the cause and fix it.

Thread 243 (2023-10-12):

New MSU-1 Autosave problem

CrispyBuns, 2023-10-12:
So when I enable MSU-1 Auto save aswell as normal auto save after manually compiling and assembling the sd2snes firmware. after saving in a MSU-1 Game and reseting it deletes my save. The game in question is Final Fantasy Adventure.
No other features SGB and non related SGB features are enabled.

Thread 244 (2023-11-20):

SA-1 Timing Regression in 1.11.0

GooberScotsman, 2023-11-20:
I was testing out this version of the firmware and noticed some slowdown during parts of Super Mario RPG. The earliest tell was the opening when Peach is captured by Bowser. When the butterflies leave, the game slows down and desyncs with the music. Mario is suppose to jump with the music sting but now jumps after. I tested with a real Japanese cartridge to confirm my findings and there was no slowdown with the butterflies. Firmware 1.10.3 doesn't have this issue when tested on the SD2SNES, but 1.11.0 does. I even tested 1.11.0 on the FX Pak Pro and the same slowdown issue occurred. This is present when playing both Japanese and North American versions. I currently don't know what other SA-1 games/hacks may be affected at this time.

redacted173, 2023-11-30:
There was a post regarding this on a forum: https://krikzz.com/forum/index.php?topic=12501.0

mrehkopf, 2025-06-20:
This is a regression caused by introduction of the more robust bus strobe sampling (SNES_PULSE generation), leaving fewer time slots for the SA-1 apparently. A quick fix reverting the PULSE logic for the SA-1 core proved unreliable - games running in FastROM (*before* enabling the SA-1) would crash. Closer investigation is underway.

Thread 245 (2023-12-02):

SGB: Keitai Denjuu Telefang - Sound issues on title screen

Blaziken257, 2023-12-02:
### Summary

When playing Keitai Denjuu Telefang (a dual GB/GBC game) on SGB on an FXPAK Pro cart, the title screen has issues with the voice sample; there is a buzzing sound that drowns out the sample. This issue is not present on any stock Nintendo hardware.

### Hardware/Firmware/Software versions used

- Super NT on stock firmware 5.3 and JB 7.2 (possibly earlier firmwares as well, but untested)
- FXPAK Pro firmware 1.11.0
- Retail Japanese versions of Keitai Denjuu Telefang - Power/Speed Versions
- English fan translation patches of Keitai Denjuu Telefang (most recent patches can be found [here](https://github.com/telefang/telefang/releases/tag/patch-v156); they contain a custom voice sample, but the issue is the exact same nevertheless)
- Occurs in both SGB1 and SGB2 BIOSes

Was not able to test on a stock SNES, since my SNES doesn't seem to want to boot my FXPAK Pro cart (even though it boots licensed carts just fine).

### Details

Telefang has a voice sample shouting the game's name on the title screen (the English patch replaces this with "Let's Telefang" instead). This works fine on real hardware (including DMG, SGB, SGB2, GBC, and all GBA variants), but when running this on an FXPAK Pro, there is a loud buzzing noise, and the actual voice sample is largely drowned out and difficult to hear.

The English patch also contains SGB enhancements not present in the retail Japanese game, which provides additional incentive to play the patch on an SGB.

The voiceover has a timing-dependent blocking routine and has been notoriously [difficult to emulate](https://github.com/telefang/telefang/issues/33); many emulators (as well as Analogue Pocket) have historically had difficulty playing this voiceover correctly.

Pokémon Yellow, which also has voice samples, does not appear to have any issues on FXPAK Pro after quickly testing that game. It is unknown if other games compatible with the SGB have voice samples.

Thread 246 (2023-12-09):

clock is running late and issue186 version

mistepien, 2023-12-09:
Hi,

I'm using https://github.com/mrehkopf/sd2snes/files/10778271/issue186-try2.zip,
and it works like a charm.
I have FXPAK PRO from Stone Age Gamer.
On PCB I got this:
SD2SNES MK.III
REV. B / 2019-02-13

and clock is running late. I replaced battery but it did not work.
I do not remember I had such problem with 1.11 beta.

Do you have any clue what is going on here?

mrehkopf, 2023-12-10:
Hi!
Hmm, technically it's not possible for the firmware alone to cause RTC drift. Does it go away when you go back the the previous firmware?

Thread 248 (2024-03-12):

Character Conversion DMA issues on SA1

blackmagemathie, 2024-03-12:
upon upload/conversion using CCDMA (type 1 (BW-RAM to I-RAM), 2bpp mode, VRAM horizontal character size set to 2^0), graphics are garbled and/or duplicated [(see forum thread for more details)](https://krikzz.com/forum/index.php?topic=12880.0).
- in-game hooks, savestates, etc. were all disabled during testing
- issue occurs on more than one flashcart/console
- issue occurs with more than one CCDMA system
- randomised writes/reads test suggests issue occurs during actual Character Conversion (or when setting it up), and Bitmap Access Area is not responsible
- further tests suggest issue may be buffer-related

mrehkopf, 2024-03-13:
Thanks for the greatly detailed report on the forum and test ROMs. Hope to be able to look into it soon :)

Thread 249 (2024-03-24):

Green led doesnt bright in 1.11.0 version

zarkon0, 2024-03-24:
Hi.

I've an sd2snes rev. X2 and the on green led doesnt bright in 1.11.0 version.
Back to 1.30.0 version and the green light work ok.

Ramsis-SNES, 2024-08-13:
Duplicate of #186.

Feel free to try [the ZIP file ikari provided](https://github.com/mrehkopf/sd2snes/issues/186#issuecomment-1434480057).

Thread 250 (2024-03-24):

Super game boy 2 doesnt work.

zarkon0, 2024-03-24:
Hi.

In my sd2snes rev. X2 super game boy 2 doesnt work. The screen come
to pink when I try to load a gameboy game.

Super Game boy 1 works fine.

zarkon0, 2024-05-06:
Hi.

Yes, it's a PAL console with the "region free" and 60Hz mods.
I've tried all combinations (pal/50Hz, pal 60Hz, region free 50Hz and region free 60Hz) and it doesn't work.

actraiser30, 2024-06-04:
Is sd2snes rev. X2 a chinese clone??

zarkon0, 2024-06-04:
My sd2snes rev. X2 is made in China.

actraiser30, 2024-06-04:
It's a Chinese clone that's why sgb2 not working try sgb1
In the original is working fine.

jamieshaw, 2024-06-05:
My experience using SGB2 was also using a Rev. X cart and had no issues. That said, variance between Chinese "clones" is going to vary.

That said, I had other issues regarding SuperCIC pair mode and have since moved to an official FXPAK PRO. So yeah, quality amongst carts is not great.

DoctorDan1986, 2024-06-05:
Well....the harsh truth is that you get what you pay for.  Sometimes the clones are just as good, but usually, clones run the gamut from "pretty okay" to "steaming pile of moist garbage".Sent from my iPhoneOn Jun 5, 2024, at 2:35 AM, Jamie Shaw ***@***.***> wrote:
My experience using SGB2 was also using a Rev. X cart and had no issues. That said, variance between Chinese "clones" is going to vary.
That said, I had other issues regarding SuperCIC pair mode and have since moved to an official FXPAK PRO. So yeah, quality amongst carts is not great.

—Reply to this email directly, view it on GitHub, or unsubscribe.You are receiving this because you are subscribed to this thread.Message ID: ***@***.***>

actraiser30, 2024-06-05:
I wouldn't recommend the clone unless someone has less money,I would go for X6 anyway,the quality is very low you don't know what you buying by getting a clone.the open source does not mean anything since it uses the os from the authentic sd2snes.

Thread 252 (2024-04-13):

Firmware 1.11.0 Jurassic Park 2 sound corrupted

kscorpionx, 2024-04-13:
After playing 30 minutes or more with the sd2snes and then playing Jurassic Park 2 The sound of the plane in the intro sounds corrupt, this does not happen if you play Jurassic Park for the first few minutes, it was tested with Snes 2chip and a Snes 1chip jr.

Ramsis-SNES, 2024-09-03:
> After playing 30 minutes or more with the sd2snes

You mean, 30+ minutes of _any game?_ Or 30+ minutes of _Jurassic Park 2_, and then resetting the game so it starts from the beginning?

What sd2snes hardware revision do you have? Do you play in 50 or 60 Hz (or PAL/NTSC)? Does the ROM region match your video mode? Also, could you make a video of the scene with the glitched sound effect for reference?

kscorpionx, 2024-09-04:
After playing 10 minutes with any game this problem occurs but I found that if you don't press start and let the intro repeat a few times this problem doesn't happen, I am playing on 60mz ntsc and yes this rom matches my region , I am using an sd2snes. made by ky technologies rev x, i know this is chinese but i want to buy a krikzz so i want to know if this doesn't happen with that one. Here is the video with the failure, the plane sounds distorted.

https://github.com/user-attachments/assets/9476b5c7-d183-4aa1-a9db-909c4aa12ec6

Ramsis-SNES, 2024-09-04:
Sorry, I can't seem to reproduce it.

Then again, I don't know what games you were playing other than the one in question, and how you even got back to the menu (soft reset? Console reset? Power off/power on?). For me, there's too much guesswork involved and too much time to be invested trying again and again, so I'm afraid I'll call it quits on this one.

To be perfectly honest with you, I don't even know I'm actually hearing what you call a "failure" in your video. The sound effect sounds a bit boomy, but I wouldn't really call it a glitch in comparison to my own tests before I would have heard what it sounds like on your setup when it's _not_ glitching out. (You might want to make another video of that but I don't really think it's worth the effort, unfortunately.)

Closed 2025-02-05.

Thread 253 (2024-05-08):

Multiple problems with 1.11.0 version

ZarkonPro, 2024-05-08:
Hi.

I've detect this problems:

- The green led doesn't bright. The option menu to configurate the led bright level does nothing.
- Randomly the screen turns to black. The sound continues working. I've deselected all options of in-game hooks, cheats, patch region...
- Super Game Boy 1 is very unstable. Some games doesn't work (black screen),. Others works after press the reset buttón (I've selected that reset button returns to menu, but in this cases, magically, it doesn't return to menu, it returns to Super Game Boy and then works).

actraiser30, 2024-06-05:
Hi you have an original sd2snes or fxpack or a clone?

Ramsis-SNES, 2024-08-13:
> * The green led doesn't bright. The option menu to configurate the led bright level does nothing.

cf. #186.

Feel free to try [the ZIP file ikari provided](https://github.com/mrehkopf/sd2snes/issues/186#issuecomment-1434480057).

Thread 255 (2024-06-13):

Firmware 1.11.0 Stunt Racer FX

kscorpionx, 2024-06-13:
The red LED is active from the start to the end of a race, this does not happen in the menus.

Ramsis-SNES, 2024-08-13:
> There are occasions where **games use the battery SRAM area as work RAM.** In this case the contents change continuously and the sd2snes will not save every change in order to reduce wear on the card but instead save the SRAM contents periodically every 15-20 seconds. **The red LED (Write) will be permanently on if such a case is detected.**

[Source](https://sd2snes.de/blog/faq) (A10, 6th bullet point)

kscorpionx, 2024-08-15:
> > There are occasions where **games use the battery SRAM area as work RAM.** In this case the contents change continuously and the sd2snes will not save every change in order to reduce wear on the card but instead save the SRAM contents periodically every 15-20 seconds. **The red LED (Write) will be permanently on if such a case is detected.**
>
> [Source](https://sd2snes.de/blog/faq) (A10, 6th bullet point)

Thanks for the answer.

Ramsis-SNES, 2024-08-26:
You're welcome.

Just so you know, you can (and should) close this issue yourself by clicking on the appropriate button down below. :-)

Closed 2024-09-01.

Thread 256 (2024-08-01):

FX Pak Pro does not save system settings

Ronchande, 2024-08-01:
Hi. I have a weird problem with my new SNES FXPak Pro (newest FW).
It works just fine, saving savegames, savestates and the cfg files like favorites or recent games. The clock also runs fine, it just does not want to save my configuration settings, it always resets to default after every restart.
The config yml file is also empty and has 0 kb. What is the problem? Can I download a „filled out" configuration file somewhere which I can copy on the SD card? Thx. Ron

Ronchande, 2024-08-01:
Tried another sd card and it wrote a 4kb config file. Very strange as all other files could be written. But anyway, solved.

mrehkopf, 2024-08-02:
Strange indeed, maybe something was up with the file system... I'd probably have suggested reformatting the card.
Did you see any periodic flashing from the red LED before changing the SD card?

Ronchande, 2024-08-02:
Is there a LED ? 😅 I do not see one? Made me wonder anyway as there is a led light setting but I see no led? I have a solid grey cartridge, maybe it's just visible in transparent cartridges?

mrehkopf, 2024-08-02:
Ah yeah, there are LEDs soldered on the top left side of the board.
Fun fact: My original *original* design (before mass production) had the bulb-type LEDs soldered on with spacers so they would even poke out of the shell but in turn it required shells to have holes drilled for the LEDs. :sweat_smile:

Ronchande, 2024-08-02:
I don't mind TBH, prefer the original snes cartridge color :)

Closed 2024-08-28.

Thread 257 (2024-08-07):

Idea: Transmitting ClockValue via USB

JumpLink, 2024-08-07:
Hi everyone,

I have an idea for a new feature and wanted to ask how difficult it would be to implement. The idea is to transmit the ClockValue of the SNES cartridge via USB. This is just a thought experiment for now, but I'm imagining a homebrew ROM where I can manipulate different memory areas via the USB interface. The ROM could use this to develop a new type of game for the SNES.

A concrete example would be a simple media player where the USB device continuously writes new images to memory. To do this at the right time, it would be helpful to know the ClockValue of the SNES cartridge. The ClockValue could simply be incremented with each clock cycle.

Here is an pseudo example of how the ClockValue could be used on the USB client in typescript:

```typescript
import * as usb from 'usb';

let device: usb.Device | null = null;
let inEndpoint: usb.InEndpoint | null = null;
let outEndpoint: usb.OutEndpoint | null = null;

function usbInit(): boolean {
    device = usb.findByIds(USB_VENDOR_ID, USB_PRODUCT_ID);
    if (!device) {
        console.error('Cannot open device');
        return false;
    }

    device.open();

    const iface = device.interfaces[0];
    if (iface.isKernelDriverActive()) {
        try {
            iface.detachKernelDriver();
        } catch (err) {
            console.error('Cannot detach kernel driver:', err);
            return false;
        }
    }

    iface.claim();

    inEndpoint = iface.endpoints.find(ep => ep.direction === 'in' && ep.transferType === usb.LIBUSB_TRANSFER_TYPE_BULK) as usb.InEndpoint;
    outEndpoint = iface.endpoints.find(ep => ep.direction === 'out' && ep.transferType === usb.LIBUSB_TRANSFER_TYPE_BULK) as usb.OutEndpoint;

    if (!inEndpoint || !outEndpoint) {
        console.error('Could not find both bulk-in and bulk-out endpoints');
        return false;
    }

    return true;
}

function usbCleanup() {
    if (device) {
        const iface = device.interfaces[0];
        iface.release(true, (err) => {
            if (err) {
                console.error('Error releasing interface:', err);
            }
            device?.close();
        });
    }
}

function usbReadClock(): Promise<number> {
    return new Promise((resolve, reject) => {
        if (!inEndpoint) {
            reject('IN endpoint not initialized');
            return;
        }

        inEndpoint.transfer(4, (err, data) => {
            if (err) {
                reject('Error in bulk read: ' + err);
            } else {
                const clockValue = data.readUInt32LE(0);
                resolve(clockValue);
            }
        });
    });
}

async function gameLoop() {
    let previousClockValue = await usbReadClock();
    const clockFrequency = 21477272; // SNES clock frequency in Hz (21.477272 MHz)
    const clockPeriod = 1 / clockFrequency; // Clock period in seconds

    while (true) {
        const currentClockValue = await usbReadClock();
        const elapsedClocks = currentClockValue - previousClockValue;
        const elapsedTime = elapsedClocks * clockPeriod;

        // Update game state based on elapsed time
        updateGameState(elapsedTime);

        // Render the game state
        renderGameState();

        previousClockValue = currentClockValue;

        // Sleep for a short duration to prevent busy-waiting
        await new Promise(resolve => setTimeout(resolve, 1));
    }
}

function updateGameState(elapsedTime: number) {
    // Update the game state based on the elapsed time
    console.log(`Updating game state with elapsed time: ${elapsedTime} seconds`);
}

function renderGameState() {
    // Render the current game state
    console.log('Rendering game state');
}

async function main() {
    if (!usbInit()) {
        return;
    }

    try {
        await gameLoop();
    } catch (err) {
        console.error(err);
    } finally {
        usbCleanup();
    }
}

main();
```

The ClockValue would simply be incremented with each clock cycle, as in this example:

```c
volatile uint32_t clock_counter = 0;

void increment_clock_counter(void) {
    clock_counter++;
}

uint32_t get_snes_clock(void) {
    return clock_counter;
}
```

I don't have any experience with assembler and C yet, but I would like to get more involved with it. I imagine that such a ClockValue would be useful for my idea. What do you think, how difficult would it be to implement this?

Thanks in advance for your help and suggestions!

Cc @RedGuyyyy

JumpLink, 2024-08-08:
Now that I've thought more about it, this could probably also be implemented directly in the ROM and then the corresponding memory area can simply be read out via USB, right? So we probably don't need support for this in SD2SNES directly. My biggest problem will probably be the USB speed, has anyone had any experience with this?

Closed 2024-08-10.

Thread 258 (2024-08-09):

Super Famicom - Wavy line interference using FXPAK Pro

PJSOConnell, 2024-08-09:
Hi all,

I am using an official FXPAK Pro from everdrive.me using 1.11.0.
I am using a Super Famicom with a SuperCIC installed, fully recapped, using [this](https://en.retrogamesupply.com/products/power-supply-for-nintendo-super-famicom) power supply and [this](https://www.retrogamingcables.co.uk/packapunch-super-nintendo-entertainment-system-snes-n64-rgb-av-scart-cable-ntsc-gold-scart) RGB cable with an OSSC.

When using official

https://github.com/user-attachments/assets/3858335b-e3a9-435e-8b68-edba65a443db

cartridges from all regions I have no issues. However, when using the FXPAK Pro, I get a large amount of wavy lines onscreen, almost resembling interference.

I have tried this with SuperCIC enabled and disabled, I have replaced the voltage regulator, and I see no difference. I have disabled in-game-hooks.

I have seen others mention similar issues where people said downgrading to 1.10.2 rectified this issue but I cannot downgrade at all, I just get a black screen.

Any help would be great.

mrehkopf, 2024-08-12:
I just ordered the power supply and cable to check if I can provoke a similar issue. What model is your Super Famicom?

PJSOConnell, 2024-08-12:
@mrehkopf hey there! My model is the Super Famicom SNS-CPU-APU-01.

Ramsis-SNES, 2024-08-13:
Do you have another 9-10V, 1.3A power supply to try and rule out the one you're currently using as a potential source of trouble?

PJSOConnell, 2024-08-13:
Yes I tested it with a different matching PSU and also Component cables instead of SCART, same result unfortunately. On 13 Aug 2024, at 5:40 p.m., Ramsis ***@***.***> wrote:
Do you have another 9-10V, 1.3A power supply to try and rule out the one you're currently using as a potential source of trouble?

—Reply to this email directly, view it on GitHub, or unsubscribe.You are receiving this because you authored the thread.Message ID: ***@***.***>

HLimaVerde, 2025-06-10:
Hi! Any updates about the issue? I have same problem here and no clue how to fix it.

Ramsis-SNES, 2025-06-11:
It's most likely not related to the sd2snes/FXPAK anyway ...

Ramsis-SNES, 2025-06-11:
> > Hi! Any updates about the issue? I have same problem here and no clue how to fix it.
>
> I had my FXPAK Pro replaced and I no longer have the issue. My console was not responsible.

Great to hear that! :-)

Thread 259 (2024-08-11):

weird SD2SNES clone. Help needed

way5, 2024-08-11:
Hello everyone!
I am new to this topic so I'd appreciate an expert opinion. A couple of weeks ago I've acquired chinese SD2SNES (which you may see on the photo).

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

It seems to be well made at first glance, however I immediately started having issues with that.

Input data:
- original SFC (US NTSC). The board is recapped recently.
- tested with different PSU 9V(2A), 12V(2A)
- tested with firmwares 1.10.3 (factory), 1.10.3, 1.10.3 (by furious), 1.11.0 (latest, no video)
- tested with various SD cards (32-128GB). the results are the same

System information:

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

Issues:
1. The most annoying issues is that I am unable to open directories. Once I am trying to open one the cursor jumps back to the first row in the list. So I've moved sfc roms into SD card root to be able to start them. However...
2. Some games work fine, but most of them having issues at the very beginning of execution or shortly after starting the game. Mostly it just freezes. Sometimes I am able to do IGR though, which returns me to game intro.
3. I am not able to change settings via SD2SNES interface. It's possible to edit `config` directly by hand, but I feel there is nothing changing afterwards. Settings are not applied or having no effect.
4. It says `CIC state: Original or no CIC` which doesn't explain a thing to me.
5. Firmware version 1.11.0 gives me no meaningful video image (see image below). I've tried to follow the steps in this [report](https://github.com/mrehkopf/sd2snes/issues/184), but no luck.

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

I've done some reading on Internet about similar issues and possible solutions, but it is not becomes clear to me what is going on to this SD2SNES.

-------------

**Is there any possible solution of the product is faulty?**
Please share your opinion.

~Thanks!

------------

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

mrehkopf, 2024-08-12:
Oh, that's an interesting device I haven't seen before. For issues I think it would be best to contact the dealer/manufacturer :)

Romain80200, 2024-08-12:
Hello, it look like 2 components are missing, R301 and Q301.

way5, 2024-08-12:
> Oh, that's an interesting device I haven't seen before. For issues I think it would be best to contact the dealer/manufacturer :)

I guess this may be sort of a taunt. :) Alright, as I said I am newbie to SFC stuffs.
I have seen this devices on Internet, and the very first time it is in my hands. And despite its well designed look it seems to be in very beta stage yet, am I correct?
The manufacturer/seller gives no support on that, the only way is to return this device, but I wonder if this is an issue of my SFC maybe, or something else.

Thanks

way5, 2024-08-12:
> Hello, it look like 2 components are missing, R301 and Q301.

Thanks! Is there any schematics which I could refer to?

Ramsis-SNES, 2024-08-13:
Assuming it's not a hardware fault (which is likely, unfortunately), how did you format your SD cards? (Hint: Don't use tools like Rufus and GPT mode, as it will mess things up.)

way5, 2024-08-13:
> Assuming it's not a hardware fault (which is likely, unfortunately), how did you format your SD cards? (Hint: Don't use tools like Rufus and GPT mode, as it will mess things up.)

@Ramsis-SNES, Thank you for sharing your opinion.
Cards were formatted with FAT32 format. I had no issues with that method earlier. Last thing to blame is SD card I think.
The problem also is that there is no  structured info on this devices what so ever, I was expecting to find schematics at least for earlier versions.
No data on this sort of problems either. Maybe not many people are using it though.

What does this mean when 'no CIC detected'?

Ramsis-SNES, 2024-08-13:
> The problem also is that there is no structured info on this devices what so ever, I was expecting to find schematics at least for earlier versions.

Those have been up [on this very GitHub repository](https://github.com/mrehkopf/sd2snes/tree/develop/pcb/kicad) for 8+ years.

> What does this mean when 'no CIC detected'?

Don't worry about it, it's perfectly normal with an unmodded console; otherwise, it would say, "SuperCIC-enhanced." :-)

way5, 2024-08-13:
@Ramsis-SNES , darn, I am outdated! :) thanks for the information

Which mod do you mention for CIC?

way5, 2024-08-13:
@Ramsis-SNES , so the board on the photo I've posted is basically somewhat "enhanced" version of the official SD2SNES? And schematics in this repo is the only latest updated version for oficial working device?
That was not clear in the beginning. I thought the device version I purchase is the latest upgraded community version.

Which mod do you mention for CIC?

way5, 2024-08-13:
@Ramsis-SNES , so the board on the photo I've posted is basically somewhat "enhanced" version of the official SD2SNES? And schematics in this repo is the only latest updated version for oficial working device?

That was not clear in the beginning. I thought the device version I purchase is the latest upgraded community version and I just don't know where to find the correct schematics.

Ramsis-SNES, 2024-08-14:
> @Ramsis-SNES , so the board on the photo I've posted is basically somewhat "enhanced" version of the official SD2SNES? And schematics in this repo is the only latest updated version for oficial working device?

I honestly don't know the answer to either of those questions.

What you need to understand though is this: The sd2snes/FXpak is an open source project. As such, anyone can make changes to the design, and offer their product commercially. If you as a buyer want the real thing, you need to make sure to only buy from a reputable seller in order to receive a product that works as advertised.

From what you describe, your cart is very likely faulty, and even if it was fully working, it probably isn't exactly built to spec anyway. If I was in your position, I'd return the non-working item, get a refund from the seller, and invest my money in the real deal. :-)

DCSpecial, 2024-08-23:
> No data on this sort of problems either. Maybe not many people are using it though.

FXPak Pro (formely named sd2SNES) is probably _THE_ go to SNES flashcart -> but i would recommend using a genuine one  produced by krikkz instead of chinese "knock offs" based on old (open source) designs

TharathielCB, 2024-08-23:
Go and buy one by krikkz. In that case ikari (mrehkopf) would get some money for his great work. I would not give any support on a very bad Chinese mock off if I were the developer ;)

Romain80200, 2024-08-24:
R343 is also missing.
I don't know if it matter.

way5, 2024-08-25:
@Ramsis-SNES, really appreciate your opinion on that matter.
I've actually returned this device.
Issue solved.

Thanks

Closed 2024-08-25.

Thread 262 (2024-09-13):

Super FX screen flicker

Sunlitspace542, 2024-09-13:
I am using an SD2SNES Mk. II Rev. J, running this firmware: https://github.com/mrehkopf/sd2snes/files/10765998/issue186.zip
In some Super FX romhacks, the screen can flash solid black for a frame. Booting the ROM over USB with QUSB2SNES fixes this issue.
Apologies for the blurry video, but it should be enough to demonstrate the issue.

https://github.com/user-attachments/assets/44541d40-f0da-4601-bb29-24975aa16371

mrehkopf, 2024-09-13:
Can you check if you have the brightness limit or 1chip transient fix enabled in configuration->in-game settings? They don't work reliably with every game due to differences in how each game programs the blanking/brightness register.
It probably works using qusb2snes because it doesn't set all features when loading a ROM.

Sunlitspace542, 2024-09-13:
> Can you check if you have the brightness limit or 1chip transient fix enabled in configuration->in-game settings?

Just checked, and I don't.

r0g1nh0, 2024-09-13:
With firmware issue186, very thin vertical lines also appear in the Super Mario RPG game and the graphics are of lower quality in others.

Sunlitspace542, 2024-09-13:
The footage is of Star Fox Next Gen, I am on the development team. This one has the worst case of it, though it does happen a bit on the title screen of Star Fox EX.

mrehkopf, 2024-09-13:
Oh, totally missed that fact ^^; The in-game hook is also a possible cause for problems. I am not aware of any issues with Star Fox, however that may or may not be true for ROM hacks depending on the modifications made...

Sunlitspace542, 2024-09-13:
I don't have in-game hooks enabled either. I also haven't been able to reproduce it on any particularly accurate emulators.

Sunlitspace542, 2024-09-13:
I just tried enabling in-game hooks and the flickering is gone.
I enabled in-game hooks, and the associated options "in-game buttons" and "initial holdoff" are disabled. All other in-game settings are disabled.

mrehkopf, 2024-09-13:
Is there a patch available publicly? I'd like to check it out. (Though I'll be gone over the weekend)
I assume that it doesn't happen on a vanilla ROM? (It doesn't for me)

Sunlitspace542, 2024-09-13:
It's still in very early development at the moment.
I haven't had it happen with vanilla Star Fox or Star Fox 2.

Sunlitspace542, 2024-09-13:
Anyway though, as I said enabling in-game hooks is only a partial fix, as it only fixes flicker in the part I showed in the video.
Booting over USB eliminates all flicker.

mrehkopf, 2024-09-13:
Right now I am leaning towards the issue being a "real hardware" issue rather than an sd2snes/FXPAK issue, with the in-game hook being able to mask it somehow (it has an impact on NMI execution timing). Why it works via USB remains a mystery.
Do you have a chance to test it on a SuperFX donor cart with EEPROM/Flash attached?

Sunlitspace542, 2024-09-13:
> Do you have a chance to test it on a SuperFX donor cart with EEPROM/Flash attached?
I don't, but I know someone who can.

Ramsis-SNES, 2024-09-14:
Just for the record, I tried StarFox EX v1.04.3 (both the normal and the FastROM patch) with my sd2snes Mk. II rev. H, firmware v1.11.0/issue186 on an Analogue Super Nt, and there are no glitches/flickering on either the intro sequence or the title screen whatsoever.

Also, I do own a homebrew GSU-2 flash cartridge, but programming the thing is rather tedious, so ... yeah.

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

Sunlitspace542, 2024-09-14:
I tried SFEX 1.10.04 (current public release) and it flickers on the title screen. it's not very frequent though, so it can be easily missed.

Sunlitspace542, 2024-09-17:
> Right now I am leaning towards the issue being a "real hardware" issue rather than an sd2snes/FXPAK issue, with the in-game hook being able to mask it somehow (it has an impact on NMI execution timing). Why it works via USB remains a mystery. Do you have a chance to test it on a SuperFX donor cart with EEPROM/Flash attached?

I just got the video back for the hardware test, no flickering at all.

https://github.com/user-attachments/assets/ca0bc7fd-758c-4d80-ae8c-ac2c77b0072f

Ramsis-SNES, 2024-09-17:
I was able to reproduce the flickering on the title screen of SFEX 1.10.04 tonight. The only thing I changed from the setup mentioned in my previous post was to use a real (2-PPU) PAL SNES (SuperCIC-modded, 60 Hz) hooked up to my Sony PVM-14M2E.

The flickering only appeared after power-cycling and reloading the ROM _twice_, though. Also, it was _extremely_ sporadic. From the looks of it, it could very well be an issue of the hack itself. (It shows garbled graphics for a split second right at the start, even before the kandowontu message, so it doesn't seem to be too polished as of yet.)

I might consider writing the ROM to my GSU-2 flash cart (sigh) to really get to the bottom of this ...

Sunlitspace542, 2024-09-21:
> The garbled graphics also happens with vanilla Starfox v1.2 as well as the Competition ROM, but not with most other SuperFX games. Also, it only ever happens right after loading the game from the menu, but not e.g. after pressing the Reset button when the game was already running.

I believe that just has to do with how Star Fox clears VRAM on first startup. Star Fox 2 runs on the same engine and it doesn't do it, presumably because VRAM gets cleared properly on boot in that game.

Thread 264 (2024-12-18):

v1.11.0 Black Screen

David-Tso, 2024-12-18:
Hi! I've been trying to update my firmware to 1.11.0 but whenever I try to open any game at all it just gives me a black screen. I've tried all resources from #184 but nothing worked for me. Here's the test log:

```
===log opened===
flash check:   1d62b458-b82d6850-c2-11-0
SD test... please insert card
=============================
crc1 = 8a0b9767 crc2 = 8a0b9767   PASSED

RTC Test
========
setting clock to 2019-02-23 00:00:00
2019-02-23 00:00:00
waiting 2 seconds
new time: 2019-02-23 00:00:02
PASSED

FPGA test
=========
configuring fpga...
basic communication test...PASSED

RAM connection test
===================

Testing RAM0.1 (U501)...

Testing RAM0.2 (U502)...

Testing RAM1 (U511)...
PASSED

SD DMA test
===========
clearing RAM - loading test file - verifying -PASSED

Loading SNES test ROM
=====================

sysclk test
===========
measuring SNES clock...
21455136 Hz
21455136 Hz diff = 0  max = 0
21455137 Hz diff = 1  max = 1
21455137 Hz diff = 0  max = 1
   CPUCLK: 3364197
  READCLK: 3043796
 WRITECLK: 160200
  PARDCLK: 160199
  PAWRCLK: 160200
  REFRCLK: 78645
ROMSELCLK: 480599
   CICCLK: 3575856
PASSED

SNES test status: IRQ: 00   PA: 00   MEM: 00/00
SNES test status: IRQ: 5a   PA: 5a   MEM: 5a/00

TEST SUMMARY
============

flash check:   1d62b458-b82d6850-c2-11-0
Test      Result
----------------
SD        Passed
USB       not implemented
RTC       Passed
CIC       no run
FPGA      Passed
RAM       Passed
SD DMA    Passed
CLK       Passed
DAC       not implemented
SNES IRQ  Passed
SNES RAM  Passed
SNES PA   Passed

```

mrehkopf, 2025-06-20:
Sorry I missed out on this. Did you happen to use a customized menu ROM?

Thread 265 (2025-01-09):

Tintin Prisioners of the Sun not working (rapid flashing and broken graphics)

Xylophone4you, 2025-01-09:
I currently am on the latest firmware and I have been having issues with this game. I currently play on an NTSC SNES Mini console, and this game exhibits a lot of flickering and missing objects. It may be perhaps because the game was developed in Europe, but I am not sure if the game can be fixed to run on NTSC consoles even if it is slightly sped up.

mrehkopf, 2025-01-11:
The game is very likely not 60Hz compatible due to video timing. The flash cart is not responsible for fixing the programming of random games :)
However, there seems to be a patch for that game that makes it playable at 60Hz, made by GhostlyDark. https://www.romhacking.net/forum/index.php?topic=23810.0

mrehkopf, 2025-01-12:
Unfortunately the patch only seems to remove the region check but doesn't fix any actual game issues. The game simply spends way too much time in VBlank to read and update VRAM. :(

Xylophone4you, 2025-01-12:
Yeah, I tried using that patch and I wasn't able to get the game running without any major glitches. I hope the SuperCIC will be restocked someday.

Closed 2025-01-11.

Thread 267 (2025-02-27):

Final Fantasy 6 recovery spring graphical glitching

nickretallack, 2025-02-27:
This is what happens when I use a recovery spring:
https://github.com/user-attachments/assets/38bad4fb-552f-4c61-8960-3f399eb2da5d

This was captured using an Elgato HD60 S connected to a Rad2X HDMI adapter.

The graphical glitching is quite strange in that it breaks out of the 4:3 aspect ratio of the image.

Sometimes instead of seeing this glitching, the screen just goes black and there is no sound either, for the duration of the animation.  It comes back afterward.  I can't capture that on my capture device though because my capture device immediately ends the video when that happens.

It's odd since save points should have a similar effect, but they work flawlessly, while this recovery spring does not.
The spring in question is in the caves you escape to on chocobos when Figaro Castle submerges when Kefka is trying to burn it down.

Ramsis-SNES, 2025-03-23:
I suspect this is an issue with your video setup. You might want to try and play around with the brightness limit setting (Main Menu --> Configuration --> In-game settings --> Brightness limit) and report back if/how it affects the Recovery Spring effect.

nickretallack, 2025-04-30:
Good call.  Setting the brightness limit to -1 fixes it.  Is there any way to set this setting but just for this one game?

Ramsis-SNES, 2025-05-02:
I can't answer your questions, but I strongly suggest you change/update/improve your video setup.

Also, please close this issue.

mrehkopf, 2025-05-02:
*If* it's a 1CHIP SNES: these are known to have a somewhat "hot" video output, meaning the output voltage for white is too high. This is also what the brightness limiter is intended to provide a fix for. It is possible to fix in hardware by replacing some parts inside the SNES, which is probably the preferred solution because it doesn't rely on patching register accesses with potential side effects.
I think it should be possible to find some material on that matter by searching for "1chip brightness fix" or "1chip video level fix" or similar.

Closed 2025-05-02.

Thread 269 (2025-05-01):

Mode 7 is messed up

nickretallack, 2025-05-01:
https://imgur.com/a/iP9nWvd

Github image uploads seem to be broken right now, so here's an imgur link.

Mode 7 graphics aren't working on my Fx Pak Pro.  Many scan lines of the mode 7 graphics are randomly not drawn each frame, allowing the background to be seen instead.  So far I've seen the problem affect Mario Kart, Runsaber, even The Flintstones: The Treasure of Sierra Madrock.

I've tried disabling many settings but nothing seems to change this.

I also noticed that in Faceball 2000 the maze walls often don't render.

I'm using the latest firmware (1.11.0) and I've tried disabling settings like in game hooks, but nothing seems to affect this.

Ramsis-SNES, 2025-05-02:
What cart revision do you have? (Something like "revX" should be printed on the PCB somewhere.)

mrehkopf, 2025-05-02:
That's kinda weird. Are you sure your SNES is ok? Do you happen to have any original cartridges of games where Mode 7 is failing on the FXPAK Pro so you could cross-check?
