mrehkopf/sd2snes/cic/supercic/1chip-5060.pdf

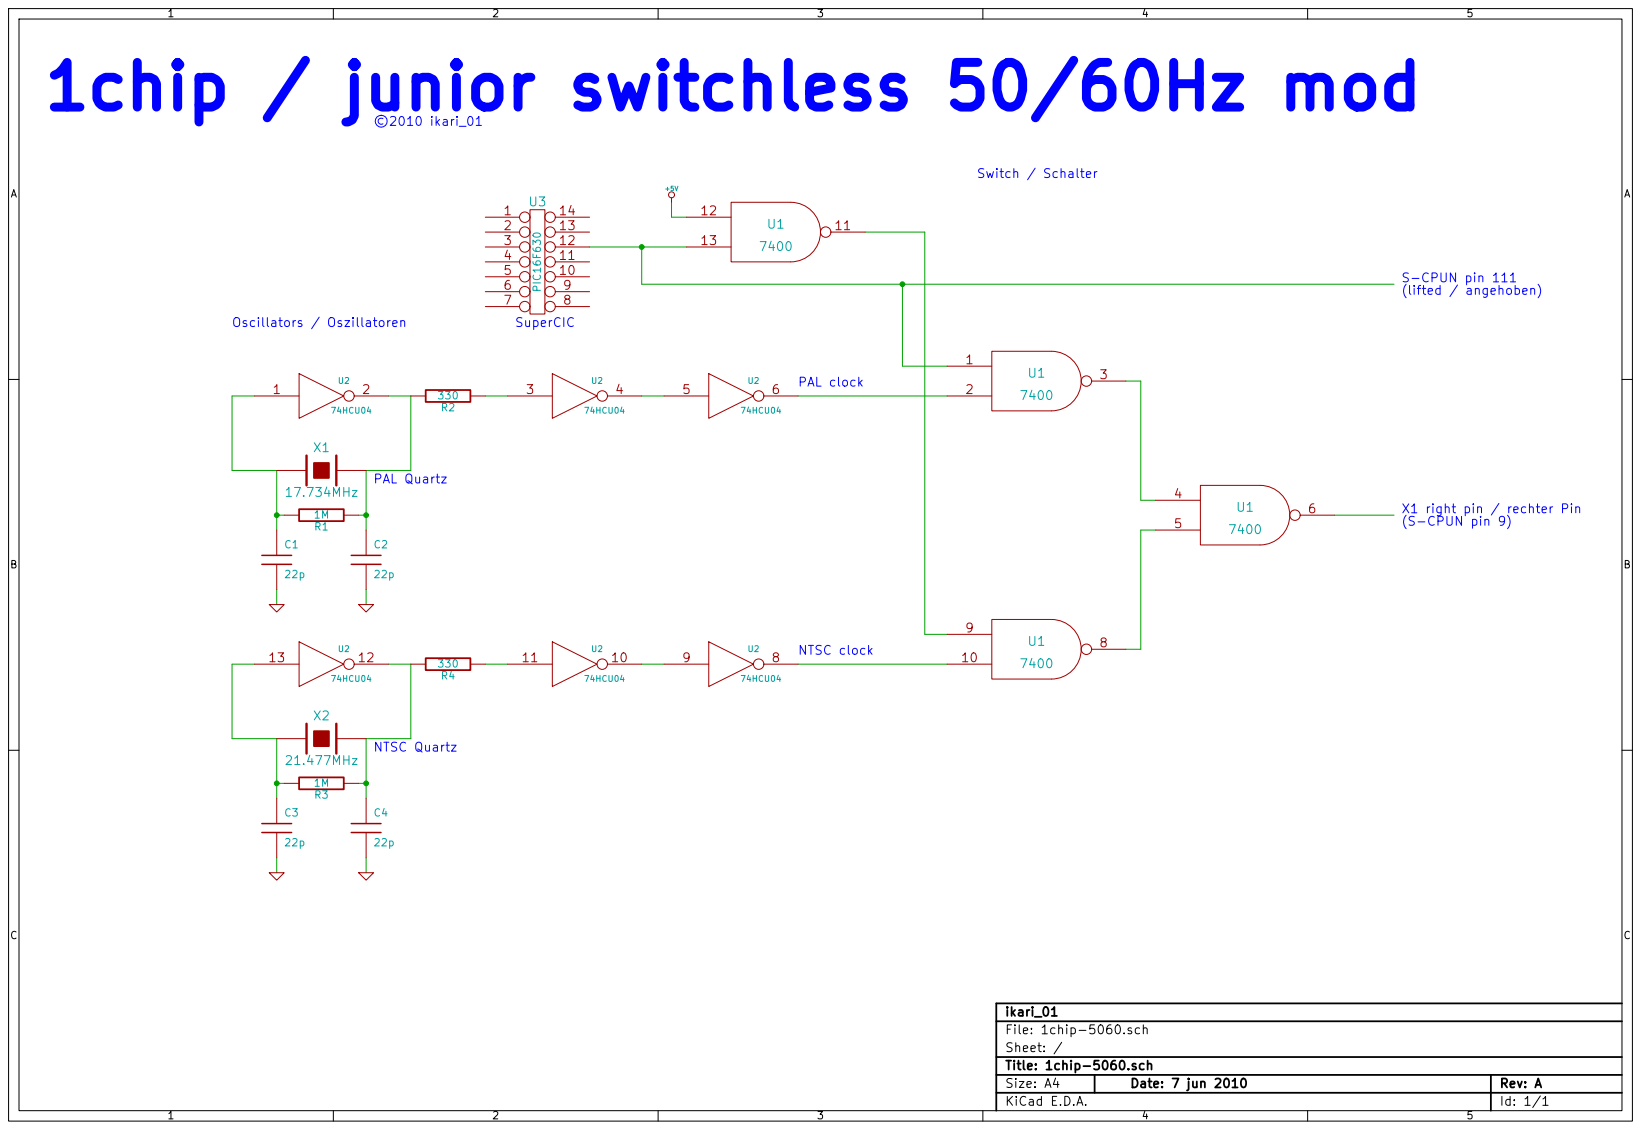
[picture p24: page 1]
