mrehkopf/sd2snes/pcb/test.sch

## KiCad design pcb/test.sch (2009-07-02)

Schematic: test.sch

Parts:
P101, P102: CONN_5X2
