mrehkopf/sd2snes/pcb/kicad/cs4344.sch

## KiCad design pcb/kicad/cs4344.sch (2010-07-05)

Schematic: cs4344.sch

Parts:
C1, C3: 3.3u; SM0805_FIXEDMASK
C2, C5: 3700p; SM0805_FIXEDMASK
C4, C6: 10u; SM0805_FIXEDMASK
C7, C8: 100n; SM0805_FIXEDMASK
C9: 1u; SM0805_FIXEDMASK
P1, P2: CONN_4
R1, R3: 10k; SM0805_FIXEDMASK
R2, R4: 470; SM0805_FIXEDMASK
U1: CS4344; TSSOP10

Notes on the sheet:
Audio DAC
