mrehkopf/sd2snes/pcb/kicad/mic23250.sch

## KiCad design pcb/kicad/mic23250.sch (2010-07-05)

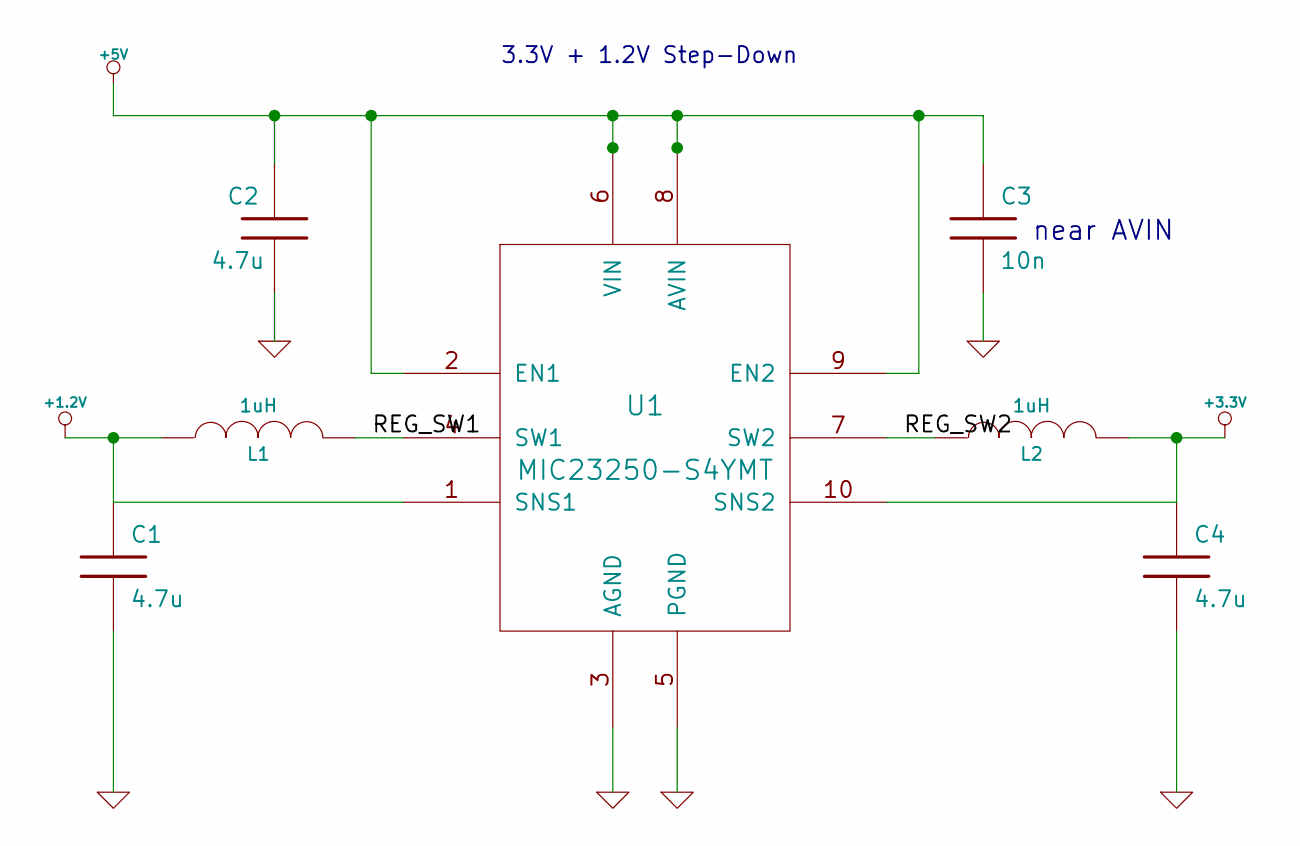
[picture p27: schematic mic23250.sch]

Parts:
C1, C2, C4: 4.7u; SM0805_FIXEDMASK
C3: 10n; SM0805_FIXEDMASK
L1, L2: 1uH; SM1210L
U1: MIC23250-S4YMT; QFN10-2x2

Connections:
+1.2V: C1.1, L1.1, U1.1 (SNS1)
+3.3V: C4.1, L2.2, U1.10 (SNS2)
+5V: C2.1, C3.1, U1.2 (EN1), U1.6 (VIN), U1.8 (AVIN), U1.9 (EN2)
GND: C1.2, C2.2, C3.2, C4.2, U1.3 (AGND), U1.5 (PGND)
REG_SW1: L1.2, U1.4 (SW1)
REG_SW2: L2.1, U1.7 (SW2)

Notes on the sheet:
near AVIN
3.3V + 1.2V Step-Down
