mrehkopf/sd2snes/pcb/kicad/RevA/mcu.sch

## KiCad design pcb/kicad/RevA/mcu.sch (2010-08-09, an earlier design)

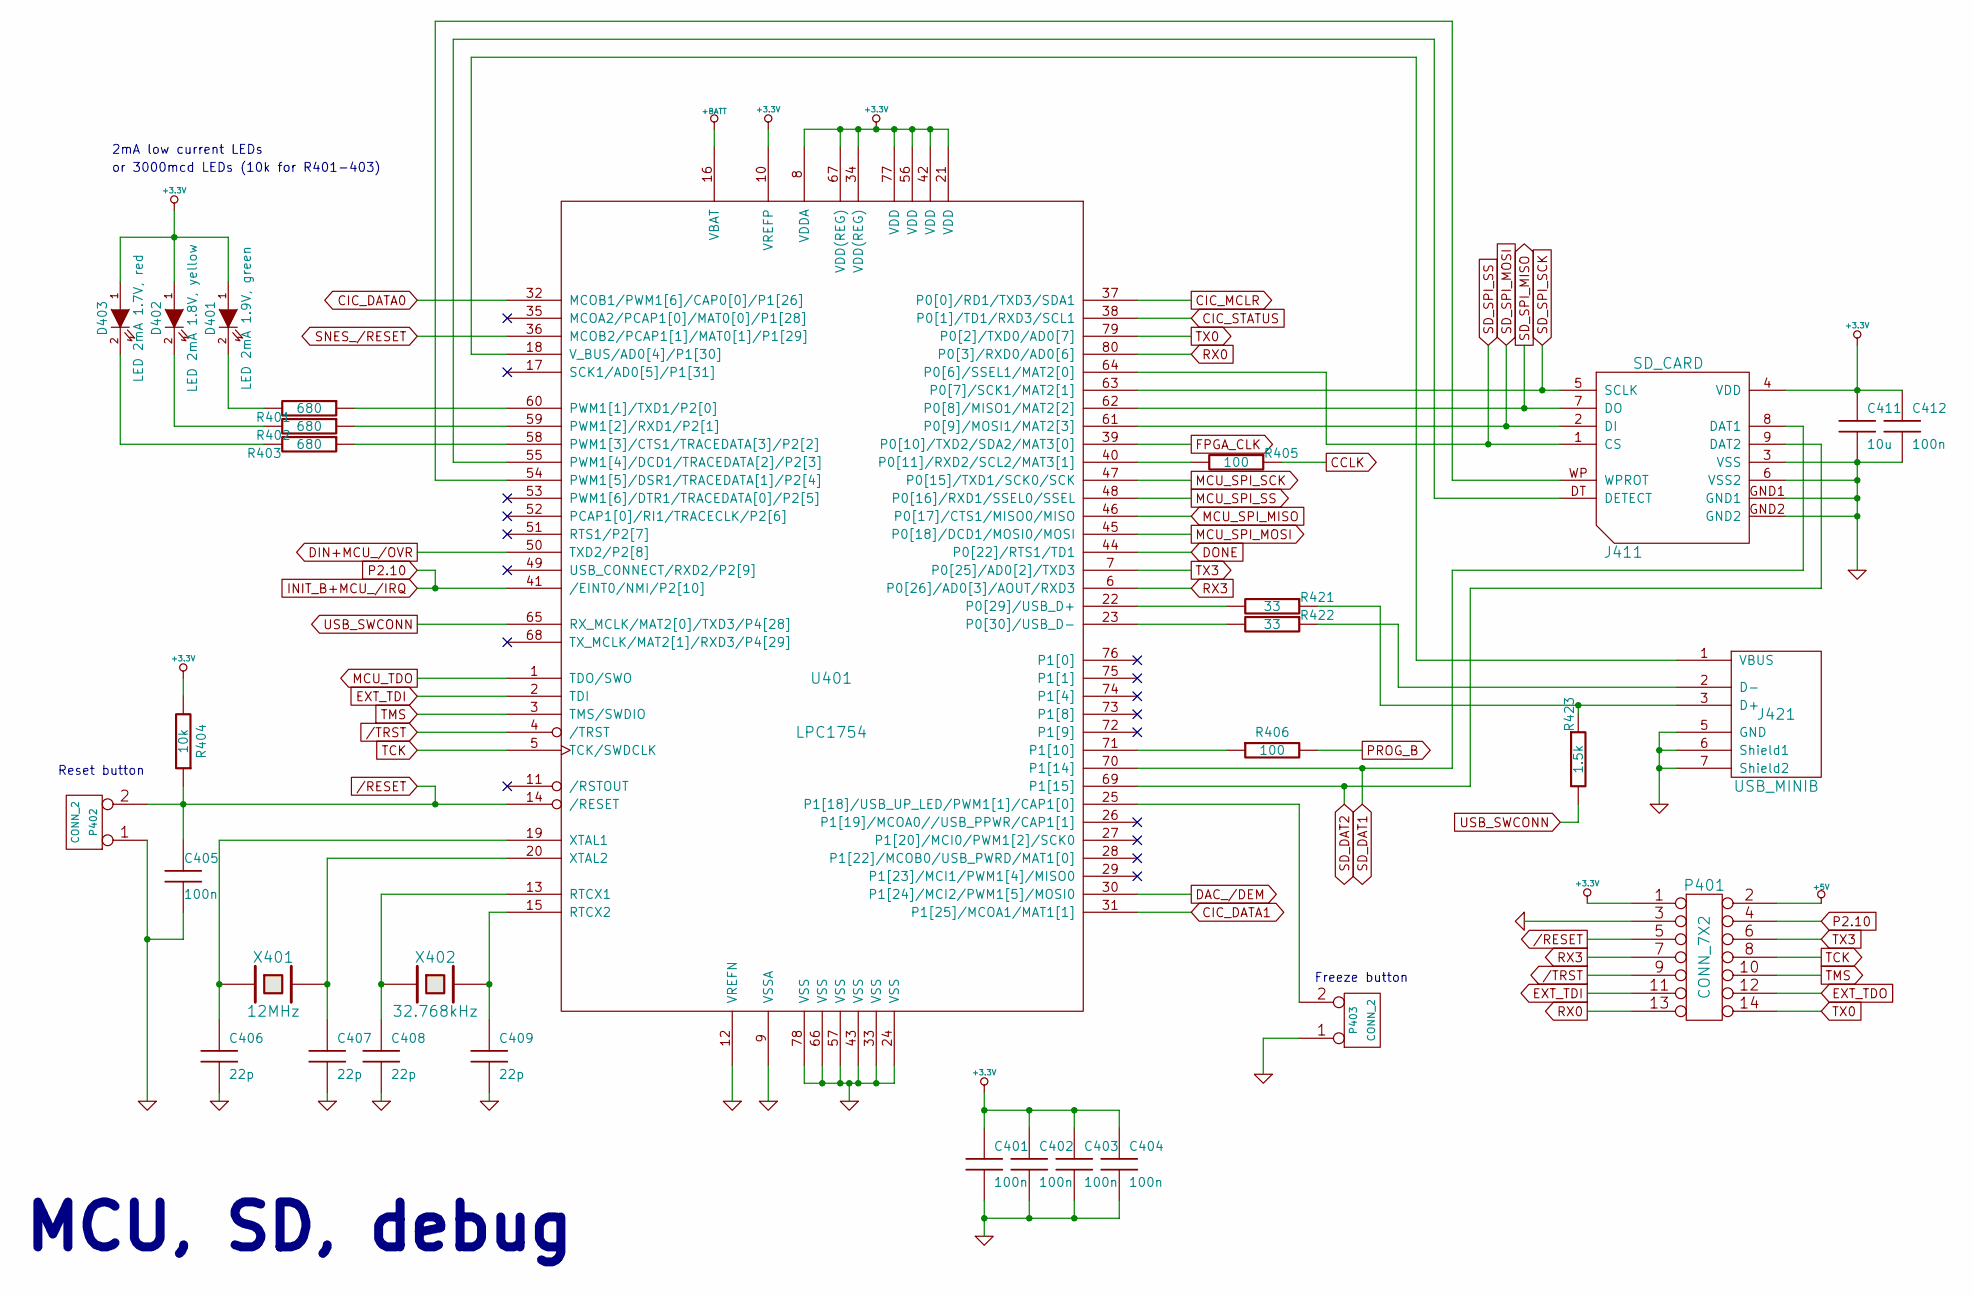
[picture p29: schematic mcu.sch]

Parts:
C401, C402, C403, C404, C405, C412: 100n; SM0805_FIXEDMASK
C406, C407, C408, C409: 22p; SM0805_FIXEDMASK
C411: 10u; SM0805_FIXEDMASK
D401: LED 2mA 1.9V, green; LED-3MM-FIXED
D402: LED 2mA 1.8V, yellow; LED-3MM-FIXED
D403: LED 2mA 1.7V, red; LED-3MM-FIXED
J411: SD_CARD
J421: USB_MINIB; USB-MINIB-THT
P401: CONN_7X2; pin_array_7x2
P402, P403: CONN_2; PIN_ARRAY_2X1
R401, R402, R403: 680; SM0805_FIXEDMASK
R404: 10k; SM0805_FIXEDMASK
R405, R406: 100; SM0805_FIXEDMASK
R421, R422: 33; SM0805_FIXEDMASK
R423: 1.5k; SM0805_FIXEDMASK
U401: LPC1754; LQFP80-.5
X401: 12MHz; XTAL_SMD_05032
X402: 32.768kHz; XTAL_SMD_05019

Connections:
+3.3V: C401.1, C402.1, C403.1, C404.1, C411.1, C412.1, D401.1 (A), D402.1 (A), D403.1 (A), J411.4 (VDD), P401.1, R404.2, U401.8 (VDDA), U401.10 (VREFP), U401.21 (VDD), U401.34 (VDD(REG)), U401.42 (VDD), U401.56 (VDD), U401.67 (VDD(REG)), U401.77 (VDD)
+5V: P401.2
+BATT: U401.16 (VBAT)
/RESET: C405.1, P401.5, P402.2 (PM), R404.1, U401.14 (/RESET)
/TRST: P401.9, U401.4 (/TRST)
CCLK: R405.1
CIC_DATA0: U401.32 (MCOB1/PWM1[6]/CAP0[0]/P1[26])
CIC_DATA1: U401.31 (P1[25]/MCOA1/MAT1[1])
CIC_MCLR: U401.37 (P0[0]/RD1/TXD3/SDA1)
CIC_STATUS: U401.38 (P0[1]/TD1/RXD3/SCL1)
DAC_/DEM: U401.30 (P1[24]/MCI2/PWM1[5]/MOSI0)
DIN+MCU_/OVR: U401.50 (TXD2/P2[8])
DONE: U401.44 (P0[22]/RTS1/TD1)
EXT_TDI: P401.11, U401.2 (TDI)
EXT_TDO: P401.12
FPGA_CLK: U401.39 (P0[10]/TXD2/SDA2/MAT3[0])
GND: C401.2, C402.2, C403.2, C404.2, C405.2, C406.2, C407.2, C408.2, C409.2, C411.2, C412.2, J411.3 (VSS), J411.6 (VSS2), J411.GND1, J411.GND2, J421.5 (GND), J421.6 (Shield1), J421.7 (Shield2), P401.3, P402.1, P403.1, U401.9 (VSSA), U401.12 (VREFN), U401.24 (VSS), U401.33 (VSS), U401.43 (VSS), U401.57 (VSS), U401.66 (VSS), U401.78 (VSS)
INIT_B+MCU_/IRQ: P401.4, U401.41 (/EINT0/NMI/P2[10])
MCU_SPI_MISO: U401.46 (P0[17]/CTS1/MISO0/MISO)
MCU_SPI_MOSI: U401.45 (P0[18]/DCD1/MOSI0/MOSI)
MCU_SPI_SCK: U401.47 (P0[15]/TXD1/SCK0/SCK)
MCU_SPI_SS: U401.48 (P0[16]/RXD1/SSEL0/SSEL)
MCU_TDO: U401.1 (TDO/SWO)
unnamed: C406.1, U401.19 (XTAL1), X401.1
unnamed: C407.1, U401.20 (XTAL2), X401.2
unnamed: C408.1, U401.13 (RTCX1), X402.1
unnamed: C409.1, U401.15 (RTCX2), X402.2
unnamed: D401.2 (K), R401.2
unnamed: D402.2 (K), R402.2
unnamed: D403.2 (K), R403.2
unnamed: J411.DT (DETECT), U401.55 (PWM1[4]/DCD1/TRACEDATA[2]/P2[3])
unnamed: J411.WP (WPROT), U401.54 (PWM1[5]/DSR1/TRACEDATA[1]/P2[4])
unnamed: J421.1 (VBUS), U401.18 (V_BUS/AD0[4]/P1[30])
unnamed: J421.2 (D-), R422.1
unnamed: J421.3 (D+), R421.1, R423.1
unnamed: P403.2 (PM), U401.25 (P1[18]/USB_UP_LED/PWM1[1]/CAP1[0])
unnamed: R401.1, U401.60 (PWM1[1]/TXD1/P2[0])
unnamed: R402.1, U401.59 (PWM1[2]/RXD1/P2[1])
unnamed: R403.1, U401.58 (PWM1[3]/CTS1/TRACEDATA[3]/P2[2])
unnamed: R405.2, U401.40 (P0[11]/RXD2/SCL2/MAT3[1])
unnamed: R406.1, U401.71 (P1[10])
unnamed: R421.2, U401.22 (P0[29]/USB_D+)
unnamed: R422.2, U401.23 (P0[30]/USB_D-)
PROG_B: R406.2
RX0: P401.13, U401.80 (P0[3]/RXD0/AD0[6])
RX3: P401.7, U401.6 (P0[26]/AD0[3]/AOUT/RXD3)
SD_DAT1: J411.8 (DAT1), U401.70 (P1[14])
SD_DAT2: J411.9 (DAT2), U401.69 (P1[15])
SD_SPI_MISO: J411.7 (DO), U401.62 (P0[8]/MISO1/MAT2[2])
SD_SPI_MOSI: J411.2 (DI), U401.61 (P0[9]/MOSI1/MAT2[3])
SD_SPI_SCK: J411.5 (SCLK), U401.63 (P0[7]/SCK1/MAT2[1])
SD_SPI_SS: J411.1 (CS), U401.64 (P0[6]/SSEL1/MAT2[0])
SNES_/RESET: U401.36 (MCOB2/PCAP1[1]/MAT0[1]/P1[29])
TCK: P401.8, U401.5 (TCK/SWDCLK)
TMS: P401.10, U401.3 (TMS/SWDIO)
TX0: P401.14, U401.79 (P0[2]/TXD0/AD0[7])
TX3: P401.6, U401.7 (P0[25]/AD0[2]/TXD3)
USB_SWCONN: R423.2, U401.65 (RX_MCLK/MAT2[0]/TXD3/P4[28])

Notes on the sheet:
or 3000mcd LEDs (10k for R401-403)
Freeze button
MCU, SD, debug
Reset button
2mA low current LEDs
