mrehkopf/sd2snes/pcb/kicad/RevA/memory.sch

## KiCad design pcb/kicad/RevA/memory.sch (2010-08-09, an earlier design)

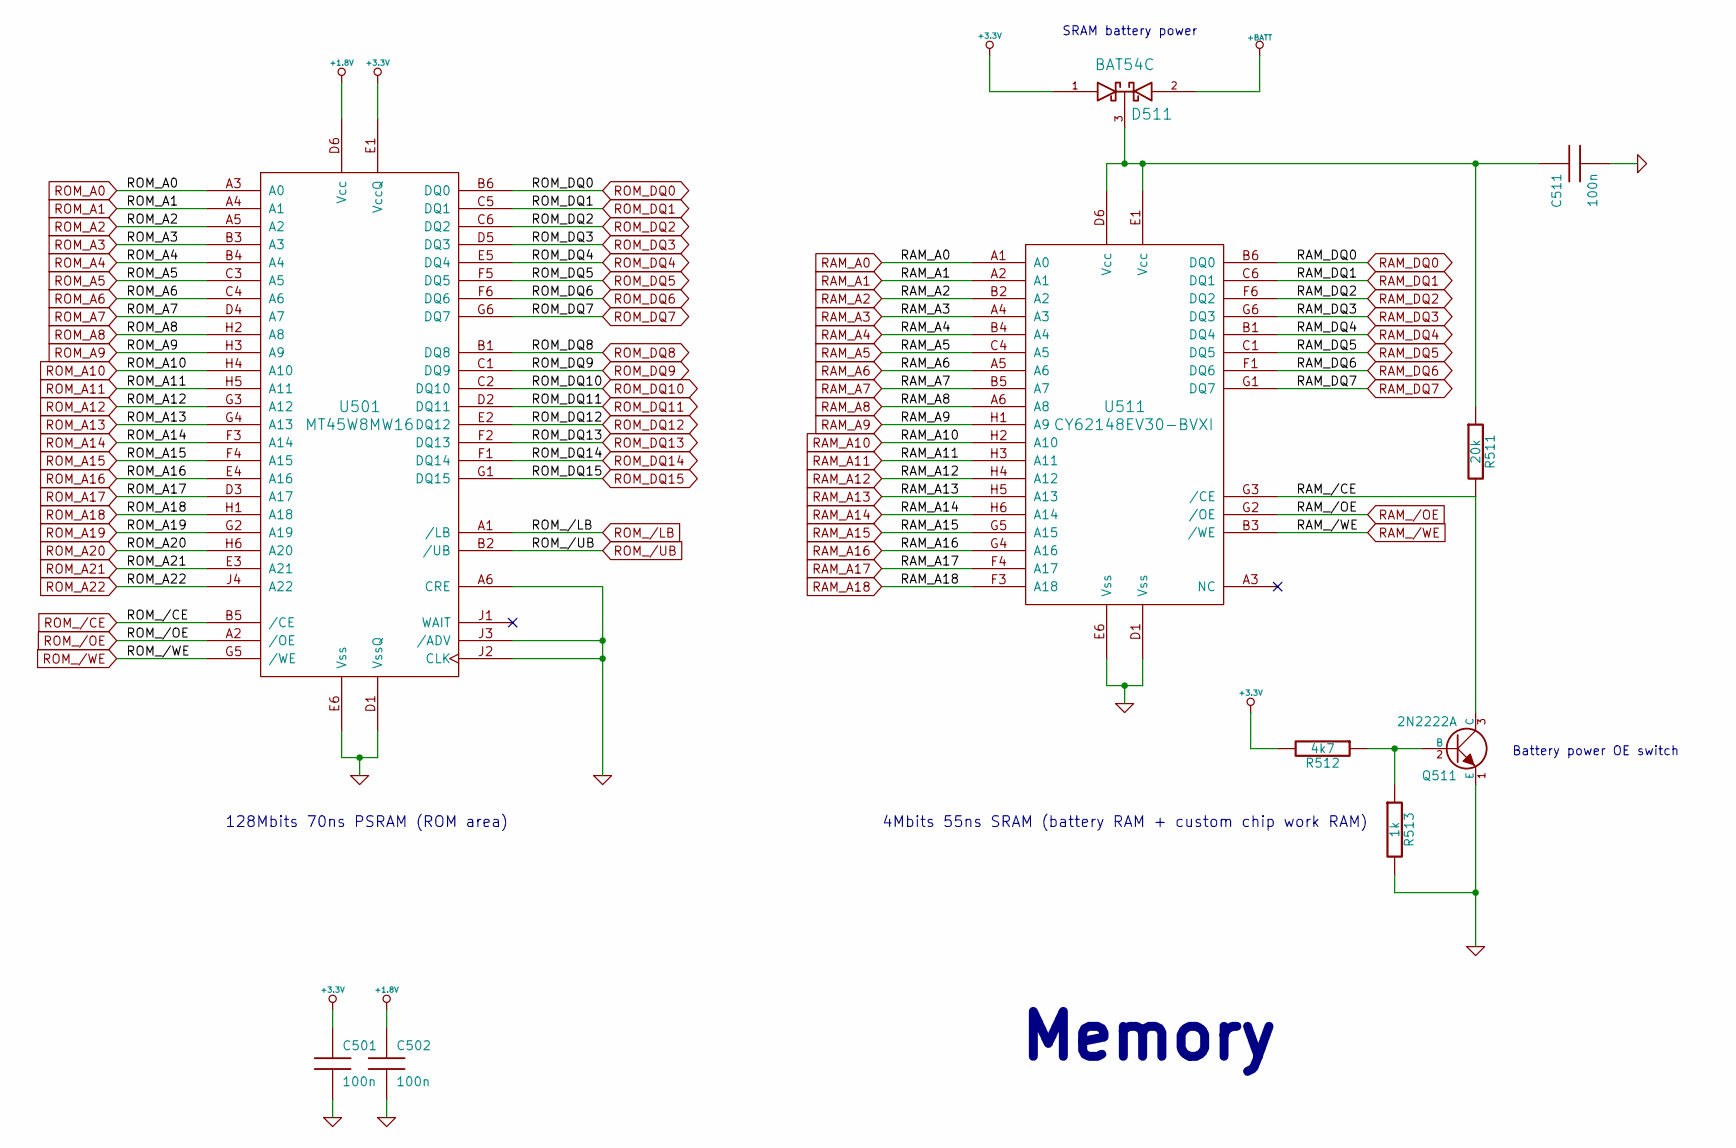
[picture p30: schematic memory.sch]

Parts:
C501, C502, C511: 100n; SM0805_FIXEDMASK
D511: BAT54C; SOT23EBC
Q511: 2N2222A; SOT23EBC
R511: 20k; SM0805_FIXEDMASK
R512: 4k7; SM0805_FIXEDMASK
R513: 1k; SM0805_FIXEDMASK
U501: MT45W8MW16; VFBGA54
U511: CY62148EV30-BVXI; VFBGA36

Connections:
+1.8V: C502.1, U501.D6 (Vcc)
+3.3V: C501.1, D511.1 (Anode), R512.2, U501.E1 (VccQ)
+BATT: D511.2 (cathode)
GND: C501.2, C502.2, C511.2, Q511.1 (E), R513.2, U501.A6 (CRE), U501.D1 (VssQ), U501.E6 (Vss), U501.J2 (CLK), U501.J3 (/ADV), U511.D1 (Vss), U511.E6 (Vss)
unnamed: C511.1, D511.3 (AK), R511.1, U511.D6 (Vcc), U511.E1 (Vcc)
unnamed: Q511.2 (B), R512.1, R513.1
RAM_/CE: Q511.3 (C), R511.2, U511.G3 (/CE)
RAM_/OE: U511.G2 (/OE)
RAM_/WE: U511.B3 (/WE)
RAM_A0: U511.A1 (A0)
RAM_A1: U511.A2 (A1)
RAM_A2: U511.B2 (A2)
RAM_A3: U511.A4 (A3)
RAM_A4: U511.B4 (A4)
RAM_A5: U511.C4 (A5)
RAM_A6: U511.A5 (A6)
RAM_A7: U511.B5 (A7)
RAM_A8: U511.A6 (A8)
RAM_A9: U511.H1 (A9)
RAM_A10: U511.H2 (A10)
RAM_A11: U511.H3 (A11)
RAM_A12: U511.H4 (A12)
RAM_A13: U511.H5 (A13)
RAM_A14: U511.H6 (A14)
RAM_A15: U511.G5 (A15)
RAM_A16: U511.G4 (A16)
RAM_A17: U511.F4 (A17)
RAM_A18: U511.F3 (A18)
RAM_DQ0: U511.B6 (DQ0)
RAM_DQ1: U511.C6 (DQ1)
RAM_DQ2: U511.F6 (DQ2)
RAM_DQ3: U511.G6 (DQ3)
RAM_DQ4: U511.B1 (DQ4)
RAM_DQ5: U511.C1 (DQ5)
RAM_DQ6: U511.F1 (DQ6)
RAM_DQ7: U511.G1 (DQ7)
ROM_/CE: U501.B5 (/CE)
ROM_/LB: U501.A1 (/LB)
ROM_/OE: U501.A2 (/OE)
ROM_/UB: U501.B2 (/UB)
ROM_/WE: U501.G5 (/WE)
ROM_A0: U501.A3 (A0)
ROM_A1: U501.A4 (A1)
ROM_A2: U501.A5 (A2)
ROM_A3: U501.B3 (A3)
ROM_A4: U501.B4 (A4)
ROM_A5: U501.C3 (A5)
ROM_A6: U501.C4 (A6)
ROM_A7: U501.D4 (A7)
ROM_A8: U501.H2 (A8)
ROM_A9: U501.H3 (A9)
ROM_A10: U501.H4 (A10)
ROM_A11: U501.H5 (A11)
ROM_A12: U501.G3 (A12)
ROM_A13: U501.G4 (A13)
ROM_A14: U501.F3 (A14)
ROM_A15: U501.F4 (A15)
ROM_A16: U501.E4 (A16)
ROM_A17: U501.D3 (A17)
ROM_A18: U501.H1 (A18)
ROM_A19: U501.G2 (A19)
ROM_A20: U501.H6 (A20)
ROM_A21: U501.E3 (A21)
ROM_A22: U501.J4 (A22)
ROM_DQ0: U501.B6 (DQ0)
ROM_DQ1: U501.C5 (DQ1)
ROM_DQ2: U501.C6 (DQ2)
ROM_DQ3: U501.D5 (DQ3)
ROM_DQ4: U501.E5 (DQ4)
ROM_DQ5: U501.F5 (DQ5)
ROM_DQ6: U501.F6 (DQ6)
ROM_DQ7: U501.G6 (DQ7)
ROM_DQ8: U501.B1 (DQ8)
ROM_DQ9: U501.C1 (DQ9)
ROM_DQ10: U501.C2 (DQ10)
ROM_DQ11: U501.D2 (DQ11)
ROM_DQ12: U501.E2 (DQ12)
ROM_DQ13: U501.F2 (DQ13)
ROM_DQ14: U501.F1 (DQ14)
ROM_DQ15: U501.G1 (DQ15)

Notes on the sheet:
Memory
SRAM battery power
Battery power OE switch
4Mbits 55ns SRAM (battery RAM + custom chip work RAM)
128Mbits 70ns PSRAM (ROM area)
