mrehkopf/sd2snes/pcb/kicad/RevA/pwr_misc.sch

## KiCad design pcb/kicad/RevA/pwr_misc.sch (2010-08-09, an earlier design)

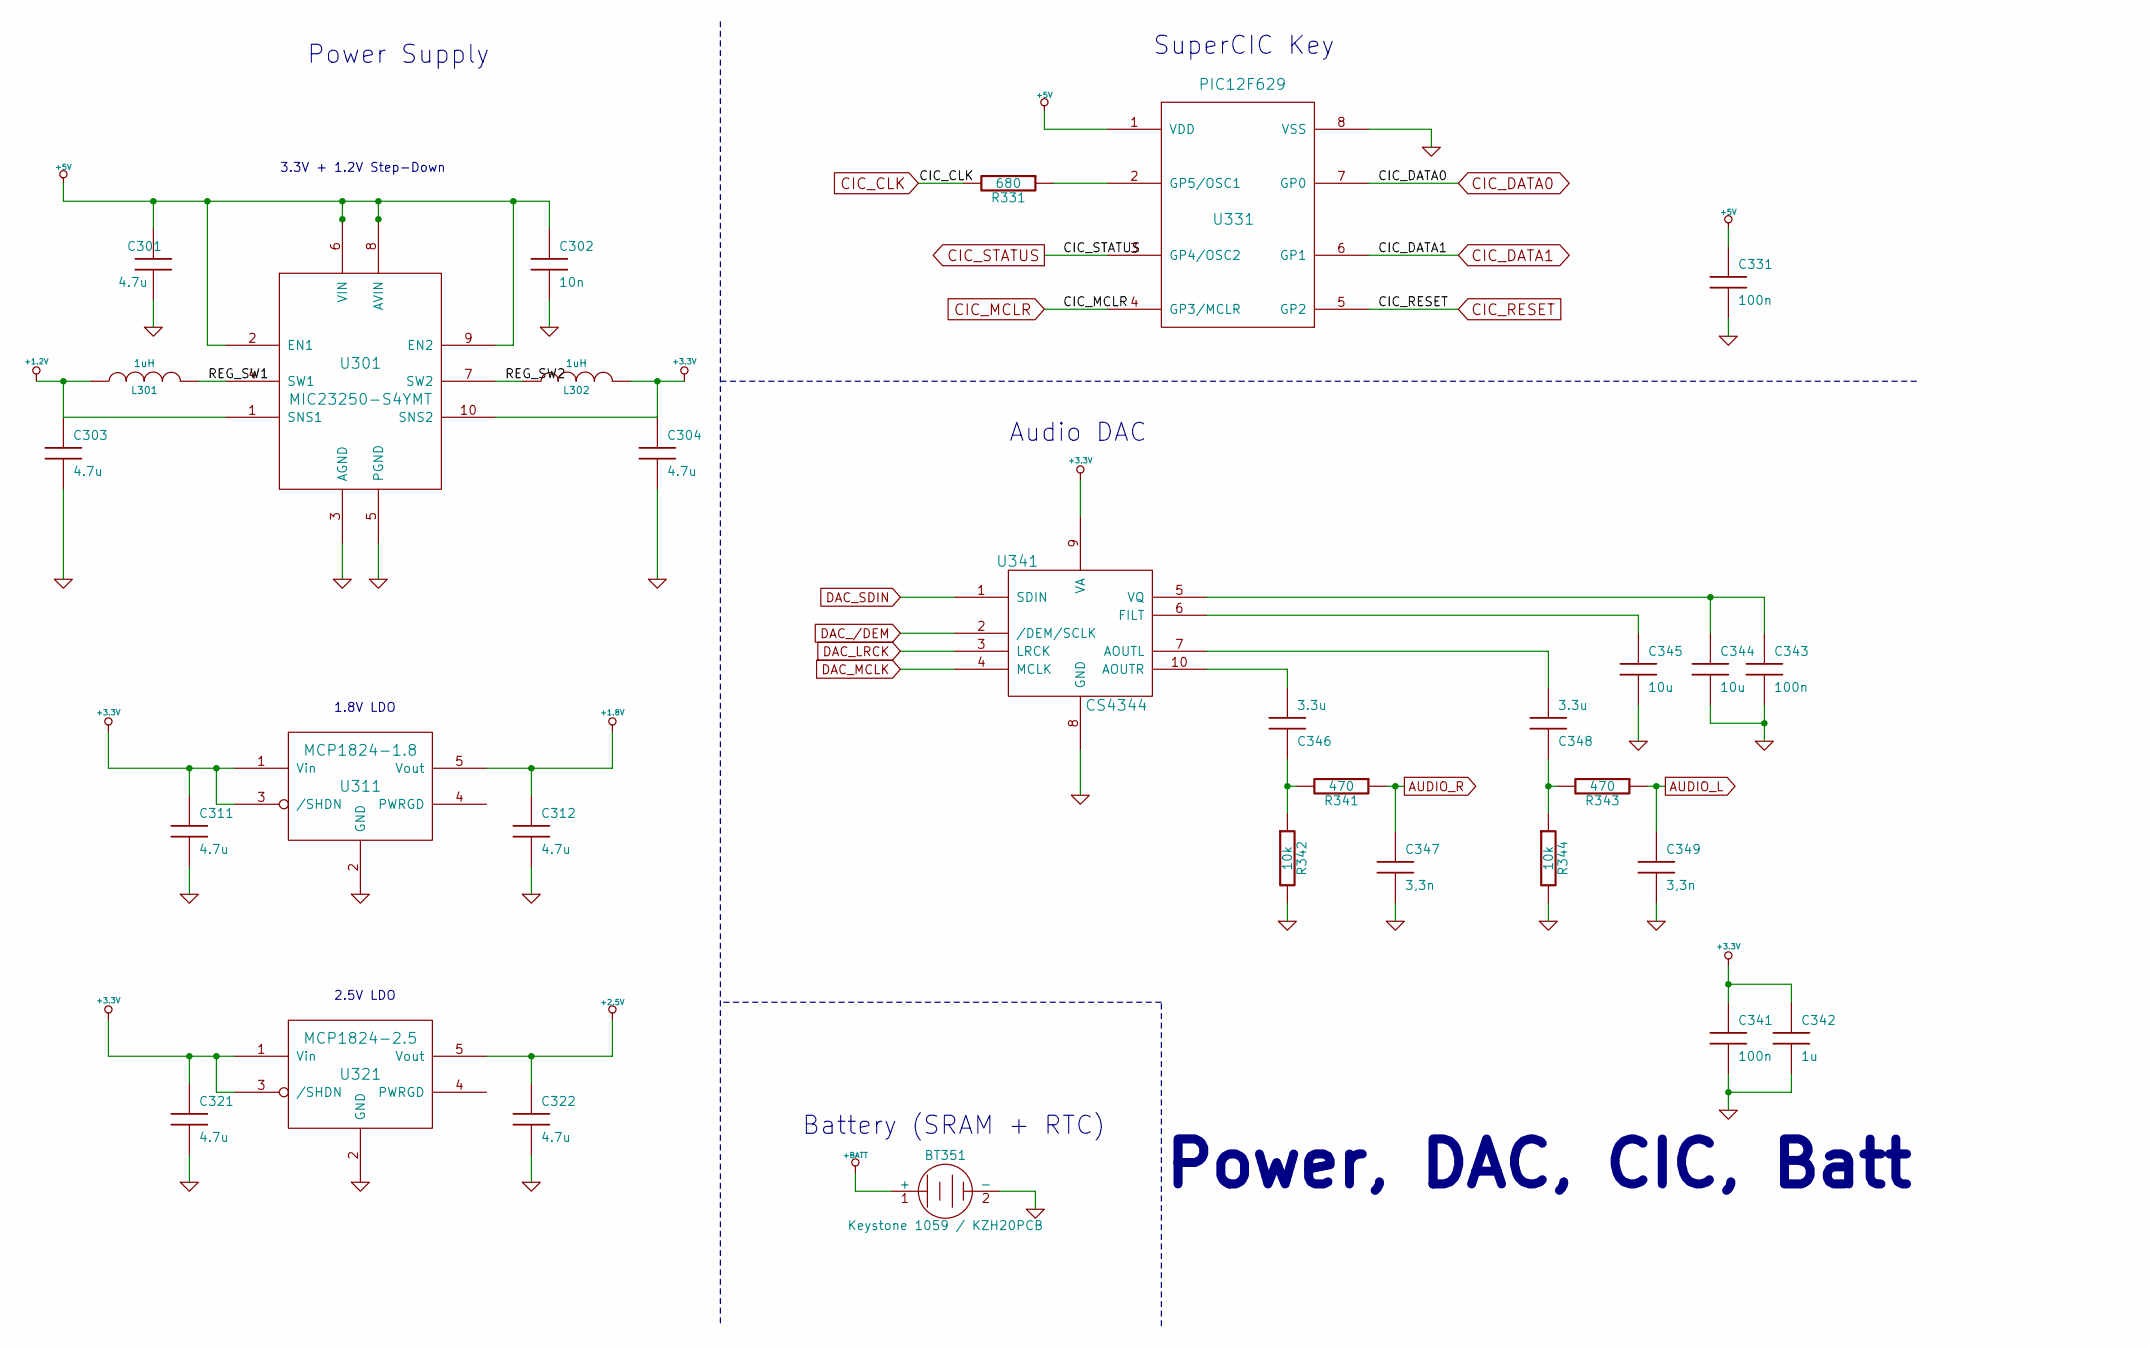
[picture p31: schematic pwr_misc.sch]

Parts:
BT351: Keystone 1059 / KZH20PCB; BT_KEYSTONE_1059_20MM
C301, C303, C304, C311, C312, C321, C322: 4.7u; SM0805_FIXEDMASK
C302: 10n; SM0805_FIXEDMASK
C331, C341, C343: 100n; SM0805_FIXEDMASK
C342: 1u; SM0805_FIXEDMASK
C344, C345: 10u; SM0805_FIXEDMASK
C346, C348: 3.3u; SM0805_FIXEDMASK
C347, C349: 3,3n; SM0805_FIXEDMASK
L301, L302: 1uH; SM1210L
R331: 680; SM0805_FIXEDMASK
R341, R343: 470; SM0805_FIXEDMASK
R342, R344: 10k; SM0805_FIXEDMASK
U301: MIC23250-S4YMT; QFN10-2x2
U311: MCP1824-1.8; SOT23-5
U321: MCP1824-2.5; SOT23-5
U331: PIC12F629; SO8N
U341: CS4344; TSSOP10

Connections:
+1.2V: C303.1, L301.1, U301.1 (SNS1)
+1.8V: C312.1, U311.5 (Vout)
+2.5V: C322.1, U321.5 (Vout)
+3.3V: C304.1, C311.1, C321.1, C341.1, C342.1, L302.2, U301.10 (SNS2), U311.1 (Vin), U311.3 (/SHDN), U321.1 (Vin), U321.3 (/SHDN), U341.9 (VA)
+5V: C301.1, C302.1, C331.1, U301.2 (EN1), U301.6 (VIN), U301.8 (AVIN), U301.9 (EN2), U331.1 (VDD)
+BATT: BT351.1 (+)
AUDIO_L: C349.1, R343.1
AUDIO_R: C347.1, R341.1
CIC_CLK: R331.2
CIC_DATA0: U331.7 (GP0)
CIC_DATA1: U331.6 (GP1)
CIC_MCLR: U331.4 (GP3/MCLR)
CIC_RESET: U331.5 (GP2)
CIC_STATUS: U331.3 (GP4/OSC2)
DAC_/DEM: U341.2 (/DEM/SCLK)
DAC_LRCK: U341.3 (LRCK)
DAC_MCLK: U341.4 (MCLK)
DAC_SDIN: U341.1 (SDIN)
GND: BT351.2 (-), C301.2, C302.2, C303.2, C304.2, C311.2, C312.2, C321.2, C322.2, C331.2, C341.2, C342.2, C343.2, C344.2, C345.2, C347.2, C349.2, R342.2, R344.2, U301.3 (AGND), U301.5 (PGND), U311.2 (GND), U321.2 (GND), U331.8 (VSS), U341.8 (GND)
unnamed: C343.1, C344.1, U341.5 (VQ)
unnamed: C345.1, U341.6 (FILT)
unnamed: C346.1, R341.2, R342.1
unnamed: C346.2, U341.10 (AOUTR)
unnamed: C348.1, R343.2, R344.1
unnamed: C348.2, U341.7 (AOUTL)
unnamed: R331.1, U331.2 (GP5/OSC1)
REG_SW1: L301.2, U301.4 (SW1)
REG_SW2: L302.1, U301.7 (SW2)

Notes on the sheet:
Power, DAC, CIC, Batt
Battery (SRAM + RTC)
2.5V LDO
1.8V LDO
3.3V + 1.2V Step-Down
Audio DAC
Power Supply
SuperCIC Key
