mrehkopf/sd2snes/pcb/kicad/RevB/mcu.sch

## KiCad design pcb/kicad/RevB/mcu.sch (2011-01-14, an earlier design)

Schematic: mcu.sch

Parts:
C401, C402, C403, C404, C405, C412: 100n; SM0805_FIXEDMASK
C406, C407: 33p; SM0805_FIXEDMASK
C408, C409: 22p; SM0805_FIXEDMASK
C411: 10u; SM0805_FIXEDMASK
D401: LED 2mA 1.9V, green; LED-3MM-FIXED
D402: LED 2mA 1.8V, yellow; LED-3MM-FIXED
D403: LED 2mA 1.7V, red; LED-3MM-FIXED
J411: Hirose DM1AA
J421: Molex 54819; USB-MINIB-THT
JP401: JUMPER
P401: CONN_7X2; pin_array_7x2
P402, P403: CONN_2; PIN_ARRAY_2X1
R401, R402, R403: 680; SM0805_FIXEDMASK
R404, R407: 10k; SM0805_FIXEDMASK
R405, R406: 100; SM0805_FIXEDMASK
R421, R422: 33; SM0805_FIXEDMASK
R423: 1.5k; SM0805_FIXEDMASK
U401: LPC1754; LQFP80-.5
X401: 12MHz; XTAL_SMD_05032
X402: 32.768kHz; XTAL_SMD_05019

Notes on the sheet:
open in case of in-circuit PIC programming
or 3000mcd LEDs (10k for R401-403)
Freeze button
MCU, SD, debug
Reset button
2mA low current LEDs
