mrehkopf/sd2snes/pcb/kicad/RevB/snesslot.sch

## KiCad design pcb/kicad/RevB/snesslot.sch (2011-01-14, an earlier design)

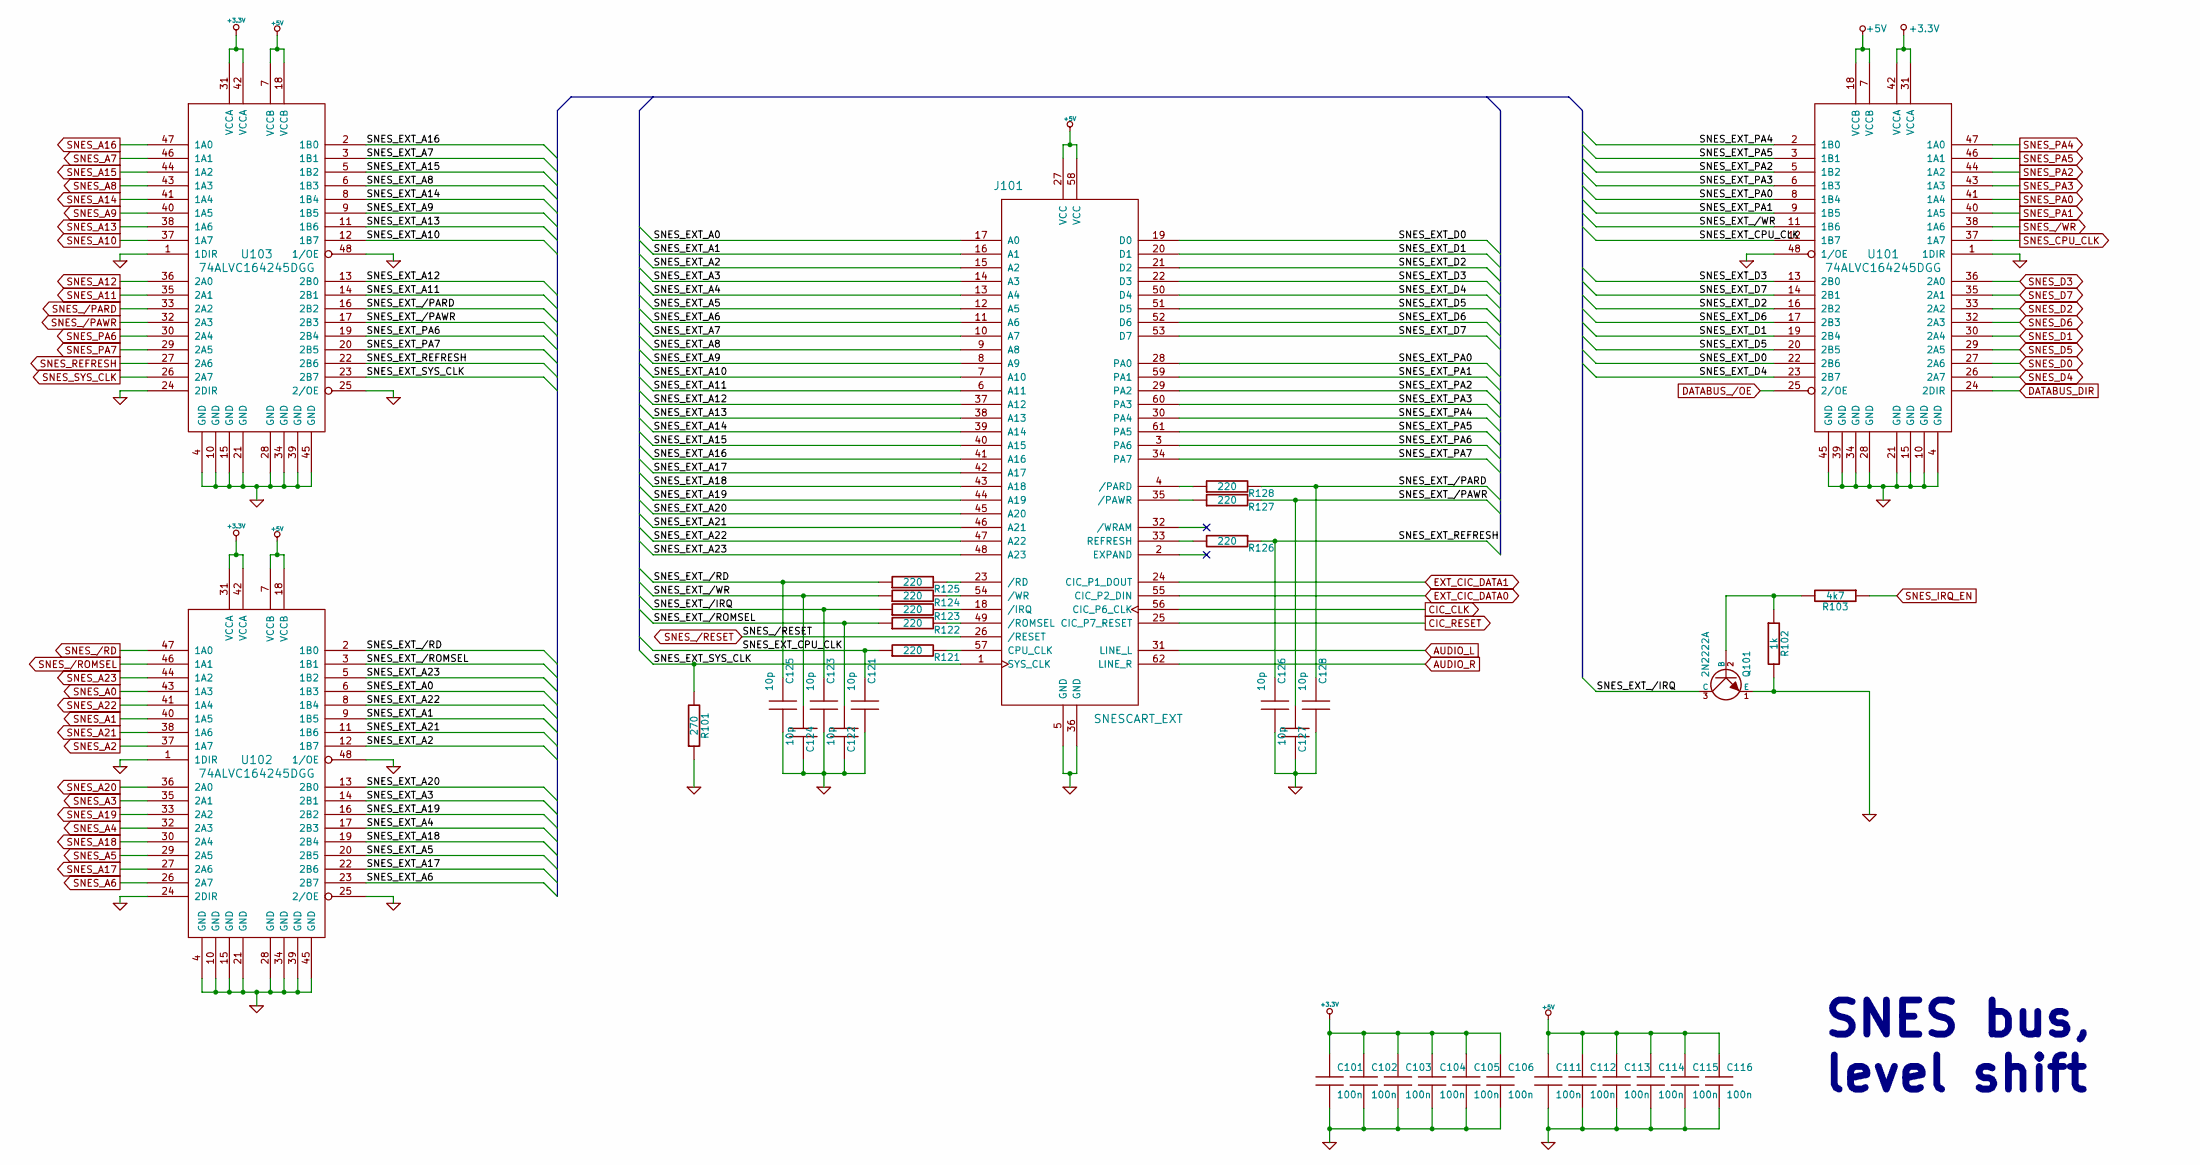
[picture p35: schematic snesslot.sch]

Parts:
C101, C102, C103, C104, C105, C106, C111, C112, C113, C114, C115, C116: 100n; SM0805_FIXEDMASK
C121, C122, C123, C124, C125, C126, C127, C128: 10p; SM0805_FIXEDMASK
J101: SNESCART_EXT
Q101: 2N2222A
R101: 270; SM0805_FIXEDMASK
R102: 1k
R103: 4k7
R121, R122, R123, R124, R125, R126, R127, R128: 220; SM0805_FIXEDMASK
U101, U102, U103: 74ALVC164245DGG; TSSOP48

Connections:
+3.3V: C101.1, C102.1, C103.1, C104.1, C105.1, C106.1, U101.31 (VCCA), U101.42 (VCCA), U102.31 (VCCA), U102.42 (VCCA), U103.31 (VCCA), U103.42 (VCCA)
+5V: C111.1, C112.1, C113.1, C114.1, C115.1, C116.1, J101.27 (VCC), J101.58 (VCC), U101.7 (VCCB), U101.18 (VCCB), U102.7 (VCCB), U102.18 (VCCB), U103.7 (VCCB), U103.18 (VCCB)
AUDIO_L: J101.31 (LINE_L)
AUDIO_R: J101.62 (LINE_R)
CIC_CLK: J101.56 (CIC_P6_CLK)
CIC_RESET: J101.25 (CIC_P7_RESET)
DATABUS_/OE: U101.25 (2/OE)
DATABUS_DIR: U101.24 (2DIR)
EXT_CIC_DATA0: J101.55 (CIC_P2_DIN)
EXT_CIC_DATA1: J101.24 (CIC_P1_DOUT)
GND: C101.2, C102.2, C103.2, C104.2, C105.2, C106.2, C111.2, C112.2, C113.2, C114.2, C115.2, C116.2, C121.2, C122.2, C123.2, C124.2, C125.2, C126.2, C127.2, C128.2, J101.5 (GND), J101.36 (GND), Q101.1 (E), R101.1, R102.2, U101.1 (1DIR), U101.4 (GND), U101.10 (GND), U101.15 (GND), U101.21 (GND), U101.28 (GND), U101.34 (GND), U101.39 (GND), U101.45 (GND), U101.48 (1/OE), U102.1 (1DIR), U102.4 (GND), U102.10 (GND), U102.15 (GND), U102.21 (GND), U102.24 (2DIR), U102.25 (2/OE), U102.28 (GND), U102.34 (GND), U102.39 (GND), U102.45 (GND), U102.48 (1/OE), U103.1 (1DIR), U103.4 (GND), U103.10 (GND), U103.15 (GND), U103.21 (GND), U103.24 (2DIR), U103.25 (2/OE), U103.28 (GND), U103.34 (GND), U103.39 (GND), U103.45 (GND), U103.48 (1/OE)
unnamed: J101.4 (/PARD), R128.1
unnamed: J101.18 (/IRQ), R123.2
unnamed: J101.23 (/RD), R125.2
unnamed: J101.33 (REFRESH), R126.2
unnamed: J101.35 (/PAWR), R127.1
unnamed: J101.49 (/ROMSEL), R122.2
unnamed: J101.54 (/WR), R124.2
unnamed: J101.57 (CPU_CLK), R121.2
unnamed: Q101.2 (B), R102.1, R103.2
SNES_/PARD: U103.33 (2A2)
SNES_/PAWR: U103.32 (2A3)
SNES_/RD: U102.47 (1A0)
SNES_/RESET: J101.26 (/RESET)
SNES_/ROMSEL: U102.46 (1A1)
SNES_/WR: U101.38 (1A6)
SNES_A0: U102.43 (1A3)
SNES_A1: U102.40 (1A5)
SNES_A2: U102.37 (1A7)
SNES_A3: U102.35 (2A1)
SNES_A4: U102.32 (2A3)
SNES_A5: U102.29 (2A5)
SNES_A6: U102.26 (2A7)
SNES_A7: U103.46 (1A1)
SNES_A8: U103.43 (1A3)
SNES_A9: U103.40 (1A5)
SNES_A10: U103.37 (1A7)
SNES_A11: U103.35 (2A1)
SNES_A12: U103.36 (2A0)
SNES_A13: U103.38 (1A6)
SNES_A14: U103.41 (1A4)
SNES_A15: U103.44 (1A2)
SNES_A16: U103.47 (1A0)
SNES_A17: U102.27 (2A6)
SNES_A18: U102.30 (2A4)
SNES_A19: U102.33 (2A2)
SNES_A20: U102.36 (2A0)
SNES_A21: U102.38 (1A6)
SNES_A22: U102.41 (1A4)
SNES_A23: U102.44 (1A2)
SNES_CPU_CLK: U101.37 (1A7)
SNES_D0: U101.27 (2A6)
SNES_D1: U101.30 (2A4)
SNES_D2: U101.33 (2A2)
SNES_D3: U101.36 (2A0)
SNES_D4: U101.26 (2A7)
SNES_D5: U101.29 (2A5)
SNES_D6: U101.32 (2A3)
SNES_D7: U101.35 (2A1)
SNES_EXT_/IRQ: C123.1, Q101.3 (C), R123.1
SNES_EXT_/PARD: C128.1, R128.2, U103.16 (2B2)
SNES_EXT_/PAWR: C127.1, R127.2, U103.17 (2B3)
SNES_EXT_/RD: C125.1, R125.1, U102.2 (1B0)
SNES_EXT_/ROMSEL: C122.1, R122.1, U102.3 (1B1)
SNES_EXT_/WR: C124.1, R124.1, U101.11 (1B6)
SNES_EXT_A0: J101.17 (A0), U102.6 (1B3)
SNES_EXT_A1: J101.16 (A1), U102.9 (1B5)
SNES_EXT_A2: J101.15 (A2), U102.12 (1B7)
SNES_EXT_A3: J101.14 (A3), U102.14 (2B1)
SNES_EXT_A4: J101.13 (A4), U102.17 (2B3)
SNES_EXT_A5: J101.12 (A5), U102.20 (2B5)
SNES_EXT_A6: J101.11 (A6), U102.23 (2B7)
SNES_EXT_A7: J101.10 (A7), U103.3 (1B1)
SNES_EXT_A8: J101.9 (A8), U103.6 (1B3)
SNES_EXT_A9: J101.8 (A9), U103.9 (1B5)
SNES_EXT_A10: J101.7 (A10), U103.12 (1B7)
SNES_EXT_A11: J101.6 (A11), U103.14 (2B1)
SNES_EXT_A12: J101.37 (A12), U103.13 (2B0)
SNES_EXT_A13: J101.38 (A13), U103.11 (1B6)
SNES_EXT_A14: J101.39 (A14), U103.8 (1B4)
SNES_EXT_A15: J101.40 (A15), U103.5 (1B2)
SNES_EXT_A16: J101.41 (A16), U103.2 (1B0)
SNES_EXT_A17: J101.42 (A17), U102.22 (2B6)
SNES_EXT_A18: J101.43 (A18), U102.19 (2B4)
SNES_EXT_A19: J101.44 (A19), U102.16 (2B2)
SNES_EXT_A20: J101.45 (A20), U102.13 (2B0)
SNES_EXT_A21: J101.46 (A21), U102.11 (1B6)
SNES_EXT_A22: J101.47 (A22), U102.8 (1B4)
SNES_EXT_A23: J101.48 (A23), U102.5 (1B2)
SNES_EXT_CPU_CLK: C121.1, R121.1, U101.12 (1B7)
SNES_EXT_D0: J101.19 (D0), U101.22 (2B6)
SNES_EXT_D1: J101.20 (D1), U101.19 (2B4)
SNES_EXT_D2: J101.21 (D2), U101.16 (2B2)
SNES_EXT_D3: J101.22 (D3), U101.13 (2B0)
SNES_EXT_D4: J101.50 (D4), U101.23 (2B7)
SNES_EXT_D5: J101.51 (D5), U101.20 (2B5)
SNES_EXT_D6: J101.52 (D6), U101.17 (2B3)
SNES_EXT_D7: J101.53 (D7), U101.14 (2B1)
SNES_EXT_PA0: J101.28 (PA0), U101.8 (1B4)
SNES_EXT_PA1: J101.59 (PA1), U101.9 (1B5)
SNES_EXT_PA2: J101.29 (PA2), U101.5 (1B2)
SNES_EXT_PA3: J101.60 (PA3), U101.6 (1B3)
SNES_EXT_PA4: J101.30 (PA4), U101.2 (1B0)
SNES_EXT_PA5: J101.61 (PA5), U101.3 (1B1)
SNES_EXT_PA6: J101.3 (PA6), U103.19 (2B4)
SNES_EXT_PA7: J101.34 (PA7), U103.20 (2B5)
SNES_EXT_REFRESH: C126.1, R126.1, U103.22 (2B6)
SNES_EXT_SYS_CLK: J101.1 (SYS_CLK), R101.2, U103.23 (2B7)
SNES_IRQ_EN: R103.1
SNES_PA0: U101.41 (1A4)
SNES_PA1: U101.40 (1A5)
SNES_PA2: U101.44 (1A2)
SNES_PA3: U101.43 (1A3)
SNES_PA4: U101.47 (1A0)
SNES_PA5: U101.46 (1A1)
SNES_PA6: U103.30 (2A4)
SNES_PA7: U103.29 (2A5)
SNES_REFRESH: U103.27 (2A6)
SNES_SYS_CLK: U103.26 (2A7)

Notes on the sheet:
SNES bus, level shift
