mrehkopf/sd2snes/pcb/kicad/RevE2/memory.sch

## KiCad design pcb/kicad/RevE2/memory.sch (2012-01-14, an earlier design)

Schematic: memory.sch

Parts:
C501, C502, C511: 100n; SM0805_FIXEDMASK
D511: BAT54C; SOT23EBC
Q511: 2N2222A; SOT23EBC
R511: 20k; SM0805_FIXEDMASK
R512: 4k7; SM0805_FIXEDMASK
R513: 100k; SM0805_FIXEDMASK
U501: MT45W8MW16; VFBGA54
U511: CY62148EV30-ZSXI

Notes on the sheet:
Memory
SRAM battery power
Battery power OE switch
4Mbits 45ns SRAM (battery RAM + custom chip work RAM)
128Mbits 70ns PSRAM (ROM area)
