mrehkopf/sd2snes/pcb/kicad/RevE2/pwr_misc.sch

## KiCad design pcb/kicad/RevE2/pwr_misc.sch (2012-01-14, an earlier design)

Schematic: pwr_misc.sch

Parts:
BT351: Keystone 1059 / KZH20PCB; BT_KEYSTONE_1059_20MM
C301, C302, C303, C304, C311, C312, C321, C322: 4.7u; SM0805_FIXEDMASK
C331, C341, C343: 100n; SM0805_FIXEDMASK
C332, C333: 100p; SM0805_FIXEDMASK
C342: 1u; SM0805_FIXEDMASK
C344, C345: 10u; SM0805_FIXEDMASK
C346, C348: 3.3u; SM0805_FIXEDMASK
C347, C349: 10n; SM0805_FIXEDMASK
FB341, FB342: FILTER
L301, L302: 4.7uH
Q301: IRLML6402PbF
R301: 20k; SM0805_FIXEDMASK
R331, R332, R333: 680; SM0805_FIXEDMASK
R341, R343: 470; SM0805_FIXEDMASK
R342, R344: 10k; SM0805_FIXEDMASK
U301: MCP1603T-120I/OS
U302: MCP1603T-330I/OS
U311: MCP1824-1802E/OT; SOT23-5
U321: MCP1824-2502E/OT; SOT23-5
U331: PIC12F629-I/P; SO8N
U341: CS4344; TSSOP10

Notes on the sheet:
3.3V Step-Down
Power, DAC, CIC, Batt
inverse polarity protection
Battery (SRAM + RTC)
2.5V LDO
1.8V LDO
1.2V Step-Down
Audio DAC
Power Supply
SuperCIC Key
