mrehkopf/sd2snes/cic/supercic/1chip-5060.sch

## KiCad design cic/supercic/1chip-5060.sch (2010-07-20)

Schematic: 1chip-5060.sch

Parts:
C1, C2, C3, C4: 22p
R1, R3: 1M
R2, R4: 330
U1: 7400
U2: 74HCU04
U3: PIC16F630
X1: 17.734MHz
X2: 21.477MHz

Notes on the sheet:
S-CPUN pin 111 (lifted / angehoben)
X1 right pin / rechter Pin (S-CPUN pin 9)
NTSC clock
PAL clock
SuperCIC
©2010 ikari_01
1chip / junior switchless 50/60Hz mod
NTSC Quartz
PAL Quartz
Switch / Schalter
Oscillators / Oszillatoren
