mrehkopf/sd2snes/savestate/savestate_fixes.yml

---
# Savestate Game Fixes
# Games sometimes store a flag in WRAM that is the current index of the APU state at $214x.  That gets out of sync when you reload the game (because $214x doesn't get updated). 
# This forces the WRAM copy to be updated.
# Alternatively small code snippets may be specified to perform the necessary fixing.
#
# Fixes are applied both after saving and loading a save state.
#
# Format:
# CKSUM: DST,SRC[OPERATION][;PCADDR,PATCH] # game name/comments
#  * OR *
# CKSUM: @OPCODES
#
# YAML multi-line lists are supported, e.g.:
# 1234: # My game (US)
#   - 7E0000,2140^FF;C0FF00,EA
#   - 7E0001,2141
#
# CKSUM: 16-bit game checksum from ROM header (7FDE/FFDE)
# DST: target WRAM address to update
# SRC: APU address contents (2140-2143) or immediate value (0000-00FF) to write to TGT
# OPERATION: consists of operator and operand, e.g. ^80 = XOR $80
#            performs an optional operation on the value read from SRC
#            before writing it to the DST address.
#            Currently supported operations:
#              ^: XOR   |: OR   &: AND
# PCADDR: ROM address to patch
# PATCH:  byte value to write to ROM address (PCADDR)
# OPCODES: code to be executed verbatim. A=8 bits, X=16 bits.
#          e.g. "@AFFFFF7E8F0100E7" - lda @$7effff : sta @$7e0001
#          up to 64 bytes are supported

648D: 0002F5,2140 # super ghouls and ghosts (US)
FE0F: 0002F5,2140 # super ghouls and ghosts (JP)
4044: 0002F5,2140 # super ghouls and ghosts (EU)
C8FB: 0002F5,2140 # super ghouls and ghosts (US MSU-1)
B6D4: 7EFFFB,2140 # final fight (US)
3288: 7EFFFB,2140 # final fight guy (US)
959E: 7EFFFB,2140 # final fight guy (JP)
A227: 7EFFFF,2140 # un squadron (US)
5B5A: 7EFFFF,2140 # un squadron/area88 (JP)
C47D: 7FFFFE,2142 # demon's crest (US)
2D7D: 7FFFFE,2142 # demon's crest (JP)
FE92: 7EFFFE,2142 # rockman & forte (JP)
F199: 7EFFFE,2142 # mm7 (US)
44D1: 7EFFFE,2142 # mm7 (JP)
4CC2: 7EFFFE,2142 # mmx1 v1.1 (US)
6569: 7EFFFE,2142 # mmx1 v1.0 (JP)
4BD7: 7EFFFE,2142 # mmx1 v1.1 (JP)
09B7: 7EFFFE,2142 # mmx2 (US)
8560: 7EFFFE,2142 # mmx2 (JP)
4055: 7EFFFE,2142 # mmx3 (US)
6BE2: 7EFFFE,2142 # mmx3 (JP)
060A: 000002,2142 # aladdin (US)
5B9A: 000002,2142 # aladdin (JP)
0B11: 7EFFFB,2142 # breath of fire 1 (US)
7C7D: 7EFFFC,2142 # breath of fire 2 (US)
A109: 000000,2140 # dkc1 v1.0 (EU)
53B7: 000000,2140 # dkc1 v1.1 (EU)
EF80: 000000,2140 # dkc1 v1.0 (US)
D17C: 000000,2140 # dkc1 v1.1 (US)
2BCC: 000000,2140 # dkc1 v1.2 (US)
0C17: 000000,2140 # dkc1 v1.0 (JP)
83EC: 000000,2140 # dkc1 v1.0 timer (US)
1202: 000000,2140 # dkc2 v1.0 (US)
9860: 000000,2140 # dkc2 v1.1 (US)
FC78: 000000,2140 # dkc2 v1.0 (JP)
35CE: 000000,2140 # dkc2 v1.1 (JP)
7129: 000000,2140 # dkc2 v1.0 timer (JP)
AA88: 000000,2140 # dkc2 v1.1 timer (JP)
B28C: 000006,2140 # dkc3 v1.0 (US)
E545: 000006,2140 # dkc3 v1.0 (JP)
B8F9: 000006,2140 # dkc3 v1.1 (JP)
C4A8: 000006,2140 # dkc3 v1.0 timer (US)
0ADF: 000006,2140 # dkc3 v1.0 timer (JP)
BF6D: 000006,2140 # dkc3 v1.1 timer (JP)
AD7F: 000000,2143 # aliens 3 (US)
119A: 001CAD,2142 # sf2 turbo - hyper fighting (US)
610A: 001D6B,2142 # sf2 turbo - the new challenger (US)
3A88: 7F7F7E,2142 # sf2 - world fighter (US)
0A7D: 000676,2140 # shaq-fu (US)
8C2C: 7EFFF8,2140 # super offroad - baja (US)
F50C: 00001E,2143 # zombies ate my neighbors (US)
5CBE: 001BFF,2140 # super smash tv (US)
1B25: 000B0C,2143 # super turrican 2 (US)
142F: # lost vikings 2 (US)
  - 00031B,0000
  - 00031C,0000
CAE6: # might and magic 3 (US)
  - 000624,2140
  - 000625,2141
5AD0: 7FFF09,2142 # goof troop (US)
614A: 00000A,2142 # mickey's magical quest (US)
24DD: 7E0176,2140 # nosferatu (US) ; Something w/ interrupts going on in this game.
4D73: 7E0871,2140 # clock tower (JP)
986E: 7E004C,2140 # animaniacs (US)
311B: 7E004C,2140 # animaniacs (JP)
64E9: 7E174B,2142 # ultimate mortal kombat 3 (US)
9A43: 7E04F4,2141;02816A,81 # puzzle bubble (US)
45C0: 7E17DC,2140 # killer instinct (US)
5327: 7E0462,2140 # top gear 3000 (US)
9CFC: 7E004C,2140 # batman returns (JP)
13B8: @AF402100CF402100D0F6498029808F4A0000 # Star Ocean (uncompressed+DeJap)
B856: 7E1D15,2141 # Bahamut Lagoon (J)
695F: 7E1D15,2141 # Bahamut Lagoon (T+Eng1.3_DeJap)
0E46: 7E1D15,2141 # Bahamut Lagoon (T+Eng1.0_Near)
ACCC: 7E1D15,2141 # Bahamut Lagoon (T+Eng1.1_Near)
414C: 7E1D15,2141 # Bahamut Lagoon (T+Eng1.2_Near)
F5E1: 0000B1,2140 # Super Morph (E)
C971: 0000FE,2143 # Captain America and the Avengers (US)
3703: 0000F6,2140 # The Terminator (US)
17F9: 000000,2143 # T2 - The Arcade Game (US)
D7A6: 000000,2143 # T2 - The Arcade Game (JP)
F834: 001D00,2140 # Shadowrun (US)
2E40: 001D00,2140 # Shadowrun (JP)
7473: 7E96A2,2140 # Dragon Quest III (JP, T+Eng1.1_DQT)
E3DA: # Dragon Quest V (T+Eng 2.01F)
  - 002140,00
  - 0008D8,00
  - 0008DA,00
  - 0008DC,00
BAF9: # Dragon Quest V (JP)
  - 002140,00
  - 0008D8,00
  - 0008DA,00
  - 0008DC,00
01A3: 0003F7,2140 # Death and Return of Superman (US)
19EF: 001C15,2141 # Seiken no Densetsu 3 (JP,T+Eng)
FED6: 0000EA,2140 # James Bond Jr (US)
3EB3: 000000,2140 # Addams Family Values (US)
B304: 7F0316,2140 # Aero Fighters (US)
C1A1: # Aero theh Acro-Bat (US)
  - 001F1E,2140
  - 001F1F,2141
5949: 000000,2143 # Batman Forever (US)
A910: 00189A,2140 # Battle Cars (US)
2843: 000008,2143 # Battletoads-Double Dragon (US)
ECC5: 000000,2143 # Beauty and the Beast (US)
FEB3: 000000,2143 # Bram Stoker's Dracula (US)
D5F1: 00000A,2143 # Breakthru! (US)
24AE: 001C1F,2141 # Casper (US)
8C86: 0000D5,2140 # Champions World Class Soccer (US)
7751: 001F34,2141 # Choplifter II (US)
C6A6: 000200,2143 # Chuck Rock (US)
FEF2: 7EFFF6,2140 # Circuit USA (US)
80F5: 7EFFF6,2140 # Double Dragon V - The Shadows Fall (US)
F78C: 000000,2140 # Frantic Flea (US)
42CB: # Frogger (US)
  - 001C1E,2140
  - 001C1F,2141
5E4E: 7EFFF6,2140 # Fun 'n Games (US)
02BF: # Home Improvement (US)
  - 001C30,2140
  - 001C31,2141
5402: 000000,2143 # The Hurricanes (US)
8D67: 0000F6,2140 # Incredible Crash Dummies (US)
C3CF: 0015B8,2143 # Indiana Jones' Greatest Adventure (US)
E93F: 0000FC,2140 # Jammit (US)
514C: 000000,2143 # Judge Dredd (US)
CFE5: 000013,2143 # Lemmings (US)
2F85: 001F5D,2140 # Mechwarrior (US)
53F6: 00001C,2143 # Metal Warriors (US)
2E97: 00172B,2142 # Mortal Kombat 2 (US)
7149: 00174B,2142 # Mortal Kombat 3 (US)
7799: 001877,2140 # New Horizons (US)
3592: 001877,2140 # Nobunaga's Ambition (US)
8A02: 000000,2143 # Obitus (US)
673C: 000000,2143 # The Pagemaster (US)
6721: 000EC9,2140 # Paperboy 2 (US)
4140: 00008E,2140 # Pinball Dreams (US)
8F91: 001353,2140 # Pit-Fighter (US)
720F: 00005E,2143 # Q-Bert 3 (US)
CD51: # Ren & Stimpy Show - The Buckeroos (US)
  - 001C1E,2140
  - 001C1F,2141
828F: 0000F1,2140 # Ren & Stimpy Show - The Veediots! (US)
81D7: 0000FE,2143 # Skuljagger (US)
3DA4: 001042,2140 # Sim City 2000 (US)
6213: 001E04,2140 # SOS (US)
DC9A: 00053A,2143 # Star Trek: The Next Generation (US)
2C72: 000000,2143 # Stargate (US)
D30E: 0000F5,2140 # Steel Talons (US)
22ED: # Super Battletank 2 (US)
  - 001D1E,2140
  - 001D1F,2141
BF96: 001D83,2140 # Super High Impact (US)
5DBC: 000093,2140 # Super Troll Islands (US)
6073: 001A4F,2140 # True Lies (US)
10BE: 00000E,2142 # Virtual Bart (US)
0000: 000000,2143 # Virtual Soccer (US)
0B07: 000059,2143 # Warlock (US)
A608: 0000F6,2140 # Wayne's World (US)
FF49: 0000D4,2143 # Wings 2 - Aces High (US)
1B63: 000200,2143 # Wolf Child (US)
788C: 001E84,2140 # Chrono Trigger (US)
