mrehkopf/sd2snes/src/cheat.c

#include "config.h"
#include "fileops.h"
#include "uart.h"
#include "memory.h"
#include "fpga_spi.h"
#include "snes.h"
#include "cheat.h"
#include "yaml.h"
#include "cfg.h"
#include "sgb.h"

#include <string.h>
#include <stdlib.h>

extern cfg_t CFG;
extern sgb_romprops_t sgb_romprops;
extern snes_romprops_t romprops;

uint8_t rom_index;
uint8_t wram_index;
uint8_t enable_mask;

uint8_t cheat_is_wram_cheat(uint32_t code) {
  return ((code & 0xfe000000) == 0x7e000000)
        || (!(code & 0x40000000)
            && ((code & 0xffff00) < 0x200000));
}

void cheat_init(void) {
  rom_index = 0;
  wram_index = 0;
  enable_mask = 0;
  snescmd_writebyte(ASM_RTS, SNESCMD_WRAM_CHEATS);
}

void cheat_program() {
  cheat_record_t cheat;
  uint32_t cheat_record_addr = SRAM_CHEAT_ADDR;
  int cheat_count;
  int cheat_index;

  cheat_count = sram_readshort(SRAM_NUM_CHEATS);
  if(cheat_count > CHEAT_MAX_CHEATS) {
    cheat_count = CHEAT_MAX_CHEATS;
  }

  printf("cheat_program: %d cheats present\n", cheat_count);
  /* get list of activated cheats from menu */
  cheat_init(); /* reset counters and state */
  for(cheat_index = 0; cheat_index < cheat_count; cheat_index++) {
    sram_readblock(&cheat, cheat_record_addr, sizeof(cheat_record_t));
    if(cheat.flags & CHEAT_FLAG_ENABLE) {
      for(int patch_index = 0; patch_index < cheat.numpatches
                               && patch_index < CHEAT_NUM_CODES_PER_CHEAT; patch_index++) {
        cheat_program_single(cheat.patches+patch_index);
      }
    }
    cheat_record_addr += CHEAT_RECORD_STRIDE;
  }
  /* put number of WRAM cheats + enable flag */
  snescmd_writebyte(wram_index, SNESCMD_NMI_WRAM_PATCH_COUNT);
  printf("enable mask=%02x\n", enable_mask);
  fpga_write_cheat(6, enable_mask);
  cheat_enable(CFG.enable_cheats);
  //cheat_nmi_enable(romprops.has_gsu ? 0 : CFG.enable_irq_hook);
  cheat_nmi_enable(CFG.enable_ingame_hook);
  //cheat_irq_enable(romprops.has_gsu ? 0 : CFG.enable_irq_hook);
  cheat_irq_enable((romprops.has_gsu && !strncmp((char *)romprops.header.name, "DOOM", strlen("DOOM"))) ? 0 : CFG.enable_ingame_hook);
  cheat_holdoff_enable(CFG.enable_hook_holdoff);
  cheat_buttons_enable(CFG.enable_ingame_buttons);
  cheat_wram_present(wram_index);

  sgb_cheat_program();
}

void cheat_program_single(cheat_patch_record_t *cheat) {
  uint8_t is_wram_cheat;
  /* determine ROM or WRAM cheat */
  is_wram_cheat = cheat_is_wram_cheat(cheat->code);
  /* apply cheat to FPGA / NMI hook */
  if(is_wram_cheat) {
    /* more would run into the snescmd variables after the cheat code */
    if(wram_index < CHEAT_NUM_WRAM_PATCHES) {
      cheat_program_ram_cheat(wram_index++, cheat);
    }
  } else if(rom_index < CHEAT_NUM_ROM_PATCHES) {
    enable_mask |= (1 << rom_index);
    cheat_program_rom_cheat(rom_index++, cheat);
  }
}

void cheat_program_rom_cheat(int index, cheat_patch_record_t *cheat) {
  uint32_t code = cheat->code;
  printf("ROM cheat #%d: %04lx\n", index, cheat->code);
  fpga_write_cheat(index, code);
}

void cheat_program_ram_cheat(int index, cheat_patch_record_t *cheat) {
  uint16_t address = SNESCMD_WRAM_CHEATS + 6 * index;
  fpga_set_snescmd_addr(address);
  fpga_write_snescmd(ASM_LDA_IMM);
  fpga_write_snescmd(cheat->fields.patchvalue);
  fpga_write_snescmd(ASM_STA_ABSLONG);
  fpga_write_snescmd(cheat->fields.patchaddr & 0xff);
  fpga_write_snescmd(cheat->fields.patchaddr >> 8);
  fpga_write_snescmd(cheat->fields.patchbank);
  fpga_write_snescmd(ASM_RTS);
  printf("RAM cheat #%d: %02x%04x %02x\n", index, cheat->fields.patchbank, cheat->fields.patchaddr, cheat->fields.patchvalue);
}

void cheat_load_to_menu(int index, cheat_record_t *cheat) {
  uint32_t offset = SRAM_CHEAT_ADDR + CHEAT_RECORD_STRIDE * index;
  sram_writeblock(cheat, offset, sizeof(cheat_record_t));
}

void cheat_save_from_menu(int index, cheat_record_t *cheat) {
  uint32_t offset = SRAM_CHEAT_ADDR + CHEAT_RECORD_STRIDE * index;
  sram_readblock(cheat, offset, sizeof(cheat_record_t));
}

void cheat_enable(int enable) {
  uint16_t flags;
  /* switch ROM cheats */
  printf("cheat_enable->%d\n", enable);
  flags = (enable ? 0x0001 : 0x0100);
  fpga_write_cheat(7, flags);
  /* switch WRAM cheats */
  snescmd_writebyte(enable ? 0 : 1, SNESCMD_NMI_DISABLE_WRAM);
}

void cheat_nmi_enable(int enable) {
  uint16_t flags;
  printf("nmi_enable->%d\n", enable);
  flags = (enable ? 0x0002 : 0x0200);
  fpga_write_cheat(7, flags);
}

void cheat_irq_enable(int enable) {
  uint16_t flags;
  printf("irq_enable->%d\n", enable);
  flags = (enable ? 0x0004 : 0x0400);
  fpga_write_cheat(7, flags);
}

void cheat_holdoff_enable(int enable) {
  uint16_t flags;
  printf("holdoff_enable->%d\n", enable);
  flags = (enable ? 0x0008 : 0x0800);
  fpga_write_cheat(7, flags);
}

void cheat_buttons_enable(int enable) {
  uint16_t flags;
  printf("buttons_enable->%d\n", enable);
  flags = (enable ? 0x0010 : 0x1000);
  fpga_write_cheat(7, flags);
}

void cheat_wram_present(int enable) {
  uint16_t flags;
  printf("wram_present->%d\n", enable);
  flags = (enable ? 0x0020 : 0x2000);
  fpga_write_cheat(7, flags);
}

/* read cheats from YAML file to ROM for menu usage */
int cheat_yaml_load(uint8_t* romfilename) {
  yaml_token_t token;
  char line[256] = CHEAT_BASEDIR;
  cheat_record_t cheat;
  int cheat_idx = 0;
  int res;

  append_file_basename(line, (char*)romfilename, ".yml", sizeof(line));
  check_or_create_folder(CHEAT_BASEDIR);
  printf("Cheat YAML file: %s\n", line);
  yaml_file_open(line, FA_READ);
  if(file_res) {
    printf("no cheat list YML found\n");
    /* a missing file just means no cheats yet */
    res = (file_res == FR_NO_FILE || file_res == FR_NO_PATH) ? FR_OK : file_res;
    sram_writeshort(0, SRAM_NUM_CHEATS);
    file_res = 0; /* soft fail, suppress LED blink */
    return res;
  }
  /* read cheat entries */
  while(cheat_idx < CHEAT_MAX_CHEATS && yaml_next_item()) {
    int i=0;
    /* missing keys must not leave values from the previous entry */
    memset(&cheat, 0, sizeof(cheat));
    if(yaml_get_itemvalue("Name", &token)) {
      strncpy(cheat.description, token.stringvalue, CHEAT_NAME_MAXLEN);
      cheat.description[CHEAT_NAME_MAXLEN] = 0;
    }
    printf("%s\n", cheat.description);
    if(yaml_get_itemvalue("Enabled", &token)
       && token.type == YAML_BOOL && token.boolvalue) {
      cheat.flags = CHEAT_FLAG_ENABLE;
    }
    printf("  enabled: %d\n", cheat.flags & CHEAT_FLAG_ENABLE ? 1 : 0);
    if(!yaml_get_itemvalue("Code", &token)) {
      /* empty "Code:" at the end of the file */
      token.type = YAML_NONE;
    }
    if(token.type == YAML_LIST_START) {
      for(i=0; i < CHEAT_NUM_CODES_PER_CHEAT; i++) {
        if(!yaml_get_next(&token)) break;
        if(token.type == YAML_LIST_END) break;
        cheat.patches[i].code = cheat_str2bin(token.stringvalue, &cheat.codefmt[i]);
      }
      cheat.numpatches = i;
    } else if (token.type != YAML_NONE) {
      cheat.patches[0].code = cheat_str2bin(token.stringvalue, &cheat.codefmt[0]);
      cheat.numpatches = 1;
    } else {
      /* empty list */
      cheat.numpatches = 0;
    }
    printf("  num codes: %d\n", cheat.numpatches);
    for(i=0; i<cheat.numpatches; i++) {
      printf("  - %08lX\n", cheat.patches[i].code);
    }
    /* a single cheat + codes have been read, put in RAM */
    cheat_load_to_menu(cheat_idx, &cheat);
    cheat_idx++;
  }
  sram_writeshort((uint16_t)cheat_idx, SRAM_NUM_CHEATS);
  yaml_file_close();
  file_res = 0; /* soft fail, suppress LED blink */
  printf("Total number of cheats: %d\n", cheat_idx);
  return FR_OK;
}

/* check whether a cheat file was written by the firmware */
static int cheat_yaml_is_generated(char *filename) {
  char buf[32];
  int generated;
  file_open((uint8_t*)filename, FA_READ);
  if(file_res) {
    /* no file, nothing to keep */
    file_res = 0;
    return 1;
  }
  generated = f_gets(buf, sizeof(buf), &file_handle)
              && !strncmp(buf, "---", 3)
              && f_gets(buf, sizeof(buf), &file_handle)
              && !strncmp(buf, CHEAT_YAML_SIGNATURE, strlen(CHEAT_YAML_SIGNATURE));
  file_close();
  file_res = 0;
  return generated;
}

/* save cheats to YAML file from ROM/menu */
int cheat_yaml_save(uint8_t *romfilename) {
  cheat_record_t cheat;
  char line[256] = CHEAT_BASEDIR;
  char bak[sizeof(line) + 4];
  int numcheats = sram_readshort(SRAM_NUM_CHEATS);
  int backup = 0;
  int res;

  if(numcheats > CHEAT_MAX_CHEATS) {
    numcheats = CHEAT_MAX_CHEATS;
  }
  append_file_basename(line, (char*)romfilename, ".yml", sizeof(line));
  check_or_create_folder(CHEAT_BASEDIR);
  printf("Cheat YAML file: %s\n", line);

  /* writing drops comments and formatting, so keep a hand-written
     file as .bak; files written by the firmware are just replaced */
  strcpy(bak, line);
  strcat(bak, ".bak");
  if(!cheat_yaml_is_generated(line)) {
    f_unlink(bak);
    res = f_rename(line, bak);
    printf("backup to %s: %d\n", bak, res);
    if(res) {
      return res;
    }
    backup = 1;
  }

  file_open((uint8_t*)line, FA_WRITE | FA_CREATE_ALWAYS);
  if(file_res) {
    res = file_res;
    file_res = 0;
    if(backup) {
      /* don't leave the cheats only in the backup */
      f_rename(bak, line);
    }
    return res;
  }
  f_puts("---\n# Generated by sd2snes\n", &file_handle);
  for(int cheat_idx = 0; cheat_idx < numcheats; cheat_idx++) {
    cheat_save_from_menu(cheat_idx, &cheat);
    cheat.description[CHEAT_NAME_MAXLEN] = 0;
    /* the YAML parser has no escapes, so no double quotes in names */
    for(char *c = cheat.description; *c; c++) {
      if(*c == '"') *c = '\'';
    }
    if(cheat.numpatches > CHEAT_NUM_CODES_PER_CHEAT) {
      cheat.numpatches = CHEAT_NUM_CODES_PER_CHEAT;
    }
    f_printf(&file_handle, "- Name: \"%s\"\n", cheat.description);
    f_printf(&file_handle, "  Enabled: %s\n", cheat.flags & CHEAT_FLAG_ENABLE ? "true" : "false");
    f_printf(&file_handle, "  Code:\n");
    for(int i = 0; i < cheat.numpatches; i++) {
      uint32_t code = cheat.patches[i].code;
      uint32_t gg_code = cheat_raw2gg(code);
      if(cheat.codefmt[i] & CHEAT_CODEFMT_GG) {
        /* keep Game Genie codes in the form the user entered them */
        f_printf(&file_handle, "  - \"%04lX-%04lX\"   # PAR code: %08lX\n",
                 gg_code >> 16, gg_code & 0xffff, code);
      } else {
        f_printf(&file_handle, "  - \"%08lX\"    ", code);
        if(cheat_is_wram_cheat(code)) {
          f_printf(&file_handle, "# GG code: N/A (WRAM cheat)\n");
        } else {
          f_printf(&file_handle, "# GG code: %04lX-%04lX\n", gg_code >> 16, gg_code & 0xffff);
        }
      }
    }
  }
  res = f_error(&file_handle) ? FR_DISK_ERR : FR_OK;
  file_close();
  if(!res) {
    res = file_res;
  }
  file_res = 0;
  return res;
}

/* get the file the menu's cheat editor works on into file_lfn.
   The menu keeps MCU_PARAM unchanged while the editor is open. */
static void cheat_menu_get_filename(uint8_t source) {
  switch(source) {
    case CHEAT_SRC_RECENT:
      cfg_get_listed_game(LAST_FILE, file_lfn, snes_get_mcu_param() & 0xff);
      break;
    case CHEAT_SRC_FAVORITE:
      cfg_get_listed_game(FAVORITES_FILE, file_lfn, snes_get_mcu_param() & 0xff);
      break;
    default:
      get_selected_name(file_lfn);
      break;
  }
  printf("cheat file for: %s\n", file_lfn);
}

void cheat_menu_load(uint8_t source) {
  uint8_t status = CHEAT_STATUS_OK;
  char *name;

  cheat_menu_get_filename(source);
  if(cheat_yaml_load(file_lfn)) {
    status = CHEAT_STATUS_ERR;
  }
  /* file name without path for the menu's window title */
  name = strrchr((char*)file_lfn, '/');
  name = name ? name + 1 : (char*)file_lfn;
  sram_writestrn(name, SRAM_CHEAT_ROMNAME, 255);
  sram_writebyte(status, SRAM_CHEAT_STATUS);
}

void cheat_menu_save(uint8_t source) {
  uint8_t status = CHEAT_STATUS_OK;

  cheat_menu_get_filename(source);
  if(cheat_yaml_save(file_lfn)) {
    status = CHEAT_STATUS_ERR;
  }
  sram_writebyte(status, SRAM_CHEAT_STATUS);
}

uint32_t cheat_str2bin(char *string, uint8_t *fmt) {
  char code[9];
  uint32_t patch;
  *fmt = 0;
  if(string[4] == '-') {
    *fmt = CHEAT_CODEFMT_GG;
    /* GG code */
    printf("GG code: %s\n", string);
    memcpy(code, string, 4);
    strncpy(code+4, string+5, 4);
    code[8] = 0;
    patch = (uint32_t)strtoul(code, NULL, 16);
    patch = cheat_gg2raw(patch);
  } else {
    /* PAR/RAW code */
    patch = (uint32_t)strtoul(string, NULL, 16);
    printf("PAR code: %08lX\n", patch);
  }
  return patch;
}

uint32_t cheat_gg2raw(uint32_t patch) {
  uint8_t gg2raw_tab[16] = {
    0x4, 0x6, 0xd, 0xe,
    0x2, 0x7, 0x8, 0x3,
    0xb, 0x5, 0xc, 0x9,
    0xa, 0x0, 0xf, 0x1
  };
  uint32_t decrypt = 0;
  /* translate nibbles */
  for(int i=0; i<8; i++) {
    decrypt = ((decrypt >> 4) & 0x0fffffff)
            | ((uint32_t)(gg2raw_tab[patch & 0xf]) << 28);
    patch >>= 4;
  }
  /* remap bits: VVVVVVVVAAAABBBBCCDDDDEEEEFFFFGG
              => DDDDFFFFAAAAGGCCBBBBEEEEVVVVVVVV */
  decrypt = ((decrypt & 0xff000000) >> 24)
          |  (decrypt & 0x00f00000)
          | ((decrypt & 0x000f0000) >> 4)
          | ((decrypt & 0x0000c000) << 2)
          | ((decrypt & 0x00003c00) << 18)
          | ((decrypt & 0x000003c0) << 2)
          | ((decrypt & 0x0000003c) << 22)
          | ((decrypt & 0x00000003) << 18);
  return decrypt;
}

uint32_t cheat_raw2gg(uint32_t patch) {
  uint8_t raw2gg_tab[16] = {
    0xd, 0xf, 0x4, 0x7,
    0x0, 0x9, 0x1, 0x5,
    0x6, 0xb, 0xc, 0x8,
    0xa, 0x2, 0x3, 0xe
  };
  uint32_t encrypt = 0;
  /* remap bits: AAAABBBBCCCCDDEEFFFFGGGGVVVVVVVV
              => VVVVVVVVCCCCFFFFEEAAAAGGGGBBBBDD */
  patch = ((patch & 0xf0000000) >> 18)
        | ((patch & 0x0f000000) >> 22)
        |  (patch & 0x00f00000)
        | ((patch & 0x000c0000) >> 18)
        | ((patch & 0x00030000) >> 2)
        | ((patch & 0x0000f000) << 4)
        | ((patch & 0x00000f00) >> 2)
        | ((patch & 0x000000ff) << 24);
  /* translate nibbles */
  for(int i=0; i<8; i++) {
    encrypt = ((encrypt >> 4) & 0x0fffffff)
            | ((uint32_t)(raw2gg_tab[patch & 0xf]) << 28);
    patch >>= 4;
  }
  return encrypt;
}
