mrehkopf/sd2snes/snes/savestate.asm

; Savestate handler based on practice ROM save state code by acmlm, total, Myria
; adapted for usb2snes / sd2snes hardware support by RedGuy
; modified for standalone operation from USB EXE (2C00) + dedicated PSRAM
; space by FURiOUS
; Ported to snescom and further modified for standalone operation from in-game
; hook and default menu ROM space and IRQ support by ikari_01

; Currently this code is heavily optimized for size and not necessarily CPU
; cycle count.

; TODO do not execute from Bank C0 anymore; HDMA can fetch while handler is mapped,
; causing glitches or crashes (Notably Star Fox)

.text "SAVESTATE_START"
savestate_handler:
; * = $FE1000

; print "Savestate Bank Starting at: ", pc
	php
	rep #$30
	.al
	.xl
	pha
	; nmihook already handled button input
	lda @l NMI_PAD
	sta @l CS_INPUT_NEXT
savestate_start:
	jmp ss_init

save_write_table:
	; Disable DMA
	.word $1000|$420B, $0000
	.word $1000|$420C, $0000
	; Turn PPU off
	.word $1000|$2100, $0080
	; temp
	.word $0000|$2116, $0000  ; VRAM address >> 1.
	.word $8000|$2139, $0000  ; VRAM dummy read.
	; Done
	.word $0000, <>save_return

load_write_table:
	; Disable DMA
	.word $1000|$420B, $00
	.word $1000|$420C, $00
	; Turn PPU off
	.word $1000|$2100, $80
	; Single address, A bus -> B bus.  B address = reflector to WRAM ($2180).
	.word $0000|$4310, $8000  ; direction = A->B, B addr = $2180
	; Copy F00000-F0FFFF to WRAM 7E0000-7EFFFF.
	.word $0000|$4312, $0000  ; A addr = $xx0000
	.word $0000|$4314, $00F0  ; A addr = $F0xxxx, size = $xx00
	.word $0000|$4316, $0000  ; size = $00xx ($0000), unused bank reg = $00.
	.word $0000|$2181, $0000  ; WRAM addr = $xx0000
	.word $1000|$2183, $00    ; WRAM addr = $7Exxxx  (bank is relative to $7E)
	.word $1000|$420B, $02    ; Trigger DMA on channel 1
	; Copy F10000-F1FFFF to WRAM 7F0000-7FFFFF.
	.word $0000|$4312, $0000  ; A addr = $xx0000
	.word $0000|$4314, $00F1  ; A addr = $F1xxxx, size = $xx00
	.word $0000|$4316, $0000  ; size = $00xx ($0000), unused bank reg = $00.
	.word $0000|$2181, $0000  ; WRAM addr = $xx0000
	.word $1000|$2183, $01    ; WRAM addr = $7Fxxxx  (bank is relative to $7E)
	.word $1000|$420B, $02    ; Trigger DMA on channel 1
	; Address pair, A bus -> B bus.  B address = VRAM write ($2118).
	.word $0000|$4310, $1801  ; direction = A->B, B addr = $2118
	.word $1000|$2115, $80    ; VRAM address increment mode.
	; Copy F20000-F2FFFF to VRAM 0000-FFFF.
	.word $0000|$2116, $0000  ; VRAM address >> 1.
	.word $0000|$4312, $0000  ; A addr = $xx0000
	.word $0000|$4314, $00F2  ; A addr = $F2xxxx, size = $xx00
	.word $0000|$4316, $0000  ; size = $00xx ($0000), unused bank reg = $00.
	.word $1000|$420B, $02    ; Trigger DMA on channel 1
	; TODO: add audio
	; Copy F40000-F401FF to CGRAM 000-1FF.
	.word $1000|$2121, $00    ; CGRAM address
	.word $0000|$4310, $2200  ; direction = A->B, byte reg, B addr = $2122
	.word $0000|$4312, $0000  ; A addr = $xx0000
	.word $0000|$4314, $00F4  ; A addr = $F4xxxx, size = $xx00
	.word $0000|$4316, $0002  ; size = $02xx ($0200), unused bank reg = $00.
	.word $1000|$420B, $02    ; Trigger DMA on channel 1
	; Copy F40200-F4041F to OAM 000-21F.
	.word $0000|$2102, $0000  ; OAM address
	.word $0000|$4310, $0400  ; direction = A->B, byte reg, B addr = $2104
	.word $0000|$4312, $0200  ; A addr = $xx0200
	.word $0000|$4314, $20F4  ; A addr = $F4xxxx, size = $xx20
	.word $0000|$4316, $0002  ; size = $02xx ($0220), unused bank reg = $00.
	.word $1000|$420B, $02    ; Trigger DMA on channel 1
	; Done
	.word $0000, <>load_return

; general register restore
register_restore_return:
	sep #$20
	.as
	rep #$10
	.xl

; restore $21XX
	ldx #$0002
	ldy #$0001

- cpy #$0002
  beq +
	cpy #$0003
	beq +
	cpy #$0004
	beq +
	cpy #$0018
	beq +
	cpy #$0019
	beq +
	cpy #$0022
	beq +

	lda @l SRAM_PPU_BANK,x
	sta $2100,y
	inx
	lda @l SRAM_PPU_BANK,x
	sta $2100,y
	dex

+ inx
  inx
	iny
	cpy #$0034
	beq +
	bra -

; restore $420X
+ ldx #$0001

- cpx #$0001
  beq +
	cpx #$000B
	beq +
	cpx #$000C
	beq +
	lda @l SRAM_OTH_BANK,x
	sta $4200,x

+ inx
	cpx #$000E
	bne -

	rep #$30
	.al
	.xl
	ply
	plx
	pla
	pld
	plb

	sep #$20
	.as

return_align:
	; align back with the NMI/IRQ
; TODO persistent entry flag ("entered hook via NMI or IRQ when saving the state?")
;      when saving state, then restore when loading and align with correct
;      type of interrupt when resuming game.
	lda @l BRAM_RETURN_VECTOR ; HACK read back FPGA injected return vector low byte
	cmp #$EA  ; entered via NMI?
	beq return_enable_nmi
return_enable_irq:
	cli
	lda @l $004211 ; ack IRQ
	lda #$31       ; mask off NMI enable
	bra +
return_enable_nmi:
	lda @l $004210 ; ack NMI
	lda #$81       ; mask off IRQ enables
+
	and @l SRAM_OTH_BANK ; stored $4200 flags
	sta @l $4200
return_wait_irq:
- lda @l CS_STATE
	cmp #$2
	bne -

	; reset picture
	lda @l SRAM_PPU_BANK
	sta @l $2100

	; re-enable all interrupts
	lda @l SRAM_OTH_BANK
	sta @l $4200
	;lda !SRAM_OTH_BANK|$C
	;stz $420C

; Code to run before returning back to the game
ss_exit:
  rep #$30
  .al
  .xl
  pla
  plp
	rtl ; go back to in-game hook

; SMC (Self Modifying Code) to init on first pass
ss_init:
	rep #$30
	.al
	.xl
	pha
	phx
	phy

	lda #<>ss_start
	sta @l savestate_start+1

	sep #$20
	.as
	; save/load state machine
	lda #$00
	sta @l CS_STATE

	rep #$20
	.al

; removed game specific controller RAM location injection here:
; 1. with IRQ support it now works OOTB without specific workarounds
; 2. should a workaround be required it will be prepared by firmware before runtime

	lda #$0000
	sta @l CS_SAVE_REQ
	ply
	plx
	pla

ss_start:
	sep #$20
	.as

	lda @l CS_STATE
	beq +
	cmp #$01
	bne ss_start_skip

	; THIS PART (ss_irq_inc) MUST NEVER BE REACHED OUTSIDE A NESTED NMI/IRQ!
	; It expects to RTI to the calling handler, NEVER to the game!
ss_irq_inc:
	;signal flag
	lda @l CS_STATE
	inc a
	sta @l CS_STATE

	; remove 9 bytes from stack to return from this nested NMI/IRQ
	; and rti to wait loop in function register_restore_return
	; 3 from 'pha : php'             in savestate_handler
	; 3 from 'jsl savestate_handler' in nmihook
	; 3 from 'pha : php'             in nmihook
	; this puts us back in the wait loop for CS_STATE to become #$02
	; after load/save.
	; the fpga needs to be careful and not treat the nested NMI as an exit.
	rep #$21       ; and clear carry
	.al
	tsc
	adc #$0009
	tcs
	sep #$20
	.as
	lda @l $4210 ; load $4210 and $4211 to ack NMI+IRQ
	lda @l $4211
	; TODO this isn't optimal because the nested IRQ architecture makes it
	;      impossible to align with IRQ without altering the IRQ pending flag
	;      in $4211. ISRs that depend on the $4211 result will have altered
	;      behaviour. Ideally get rid of the nested interrupts entirely
	;      and wait for IRQ+NMI by WAI+polling the VBlank flag respectively.
ss_rti:
	rti

ss_start_skip:
	inc a
	; skip 16 additional frames after last save to avoid blowing out the stack on nested handlers
	; FIXME: get controls working where we don't repeat when holding buttons
	and #$0F
	sta @l CS_STATE

; input handling
+ rep #$30
  .al
  .xl
	;%cgram()

	lda @l CS_INPUT_CUR
	sta @l CS_INPUT_PREV
controller_reg:
	lda @l CS_INPUT_NEXT
	sta @l CS_INPUT_CUR

	sep #$20
	.as
	lda @l CS_SLOT
	rep #$30
	.al
	.xl
	beq skipslot
	bpl checkslot
	jmp ss_exit

checkslot:
; loadstate input check
	lda @l CS_INPUT_CUR
	and @l CS_SLOT_INPUT
	cmp @l CS_SLOT_INPUT
	bne skipslot
	sep #$20
	.as
	lda @l CS_INPUT_CUR+1
	bit #$08
	beq +
	lda #$01
	bra loadslot
+ bit #$04
  beq +
  lda #$03
  bra loadslot
+ bit #$02
  beq +
  lda #$04
  bra loadslot
+ bit #$01
  beq skipslot
  lda #$02
loadslot:
	; load last savestate slot
	sta @l MCU_PARAM
	ora #$80
	sta @l CS_SLOT
	lda #CMD_LOADSTATE
	sta @l MCU_CMD
skipslot:
	rep #$30
	.al
	.xl

; savestate input check
	lda @l CS_INPUT_CUR
	and @l CS_SAVE_INPUT
	cmp @l CS_SAVE_INPUT
	beq save_state

; loadstate input check
	lda @l CS_INPUT_CUR
	and @l CS_LOAD_INPUT
	cmp @l CS_LOAD_INPUT
	bne +
	jmp load_state

	; check programmable trigger
+ lda @l CS_SAVE_REQ     ; loads both
	beq save_state_jump_exit
	phx
	tax
	lda #$0000
	sta @l CS_SAVE_REQ
	txa
	plx
	and #$00FF
	bne save_state
	jmp load_state

save_state_jump_exit:
	jmp ss_exit

save_state:
	; check if this is SM
	rep #$20
	.al
	lda @l $00FFDE
	cmp #$F8DF
	bne +
	; if SM, check return address and make sure it's not in the sound loading code $808059-$808110
	lda 10,s
	cmp #$8059
	bcc +
	cmp #$8111
	bcs +
	sep #$20
	.as
	bra save_state_jump_exit

+ sep #$20
  .as

	lda @l CS_STATE
	bne save_state_jump_exit
	inc a
	sta @l CS_STATE

	; disable interrupts
	lda @l $F90700|$0000
	sta @l SRAM_OTH_BANK
	and #$01
	sta @l $004200

	phb
	phd
	rep #$30
	.al
	.xl
	pha
	phx
	phy

	sep #$20
	.as
	; wait until release save input
	;--
	;- bit $4212 : bpl -
	;- bit $4212 : bmi -
	;lda @$4219
	;and @CS_INPUT_CUR
	;cmp @CS_INPUT_CUR
	;beq --

	; disable DMA
	lda @l $F90700|$000C
	sta @l SRAM_OTH_BANK|$C
	lda #$00
	sta @l $00420B
	sta @l $00420C

	; save $21XX
	sep #$20
	.as
	ldy #$0000
	tyx

- lda @l $F90500|$0000,x
  sta @l SRAM_PPU_BANK,x
  inx
	lda @l $F90500|$0000,x
	sta @l SRAM_PPU_BANK,x
	inx
	iny
	cpy #$0040
	bne -

	; save $420X
	sep #$20
	.as
	ldx #$0001

- lda @l $F90700|$0000,x
	sta @l SRAM_OTH_BANK,x
ss_skip420c:
	inx
	cpx #$000C
	beq ss_skip420c
	cpx #$0010
	bne -

	; save DMA registers
	sep #$20
	.as
	ldy #$0000
	tyx

- lda @l $004300,x
	sta SRAM_DMA_BANK,x
	inx
	iny
	cpy #$000B
	bne -
	cpx #$007B
	beq +
	inx
	inx
	inx
	inx
	inx
	ldy #$0000
	bra -

+ rep #$30
  .al
  .xl
	ldy #<>save_write_table

	; run the unified VM. This covers save/load and all ROM mode types
run_vm:
	pea SS_BANK
	plb
	plb
	jmp vm

save_return:
	rep #$30
	.al
	.xl

	; copy region
	lda #$F5F0    ; srcBank:dstBank
	sta @l $002020
	lda #$0000    ; srcOffset
	sta @l $002022
	lda #$0000    ; dstOffset
	sta @l $002024
	lda #$0500    ; length[15:0]
	sta @l $002026
	sep #$20
	.as
	lda #$04  ; length[23:16]
	sta @l $002028
	; opcode[4:0], loop, dir, enable
	lda #$05
	sta @l $002029

	rep #$20
	.al
	tsc
	sta @l SRAM_SAVED_SP

	;%cgram()

	sep #$20
	.as
	pea $0000
	plb
	plb

	; wait until release save input
saveinputloop:
- bit $4212
	bpl -
- bit $4212
	bmi -
	lda @l $4218
	and @l CS_SAVE_INPUT
	cmp @l CS_SAVE_INPUT
	beq saveinputloop

	; send cmd to write the state inside the sd
	lda @l CS_SLOT
	bne +
	lda #$01
+ sta @l MCU_PARAM
	; there is a race with saving twice and then changing the slot
	; before the second save writes to SD, but it seems unlikely to hit.
	; the following commented code protects against it, however, it
	; also delays the save->load time which users may not like
;	ora #$80
;	sta @CS_SLOT
	lda #CMD_SAVESTATE
	sta @l MCU_CMD

	;rep #$20 : .al

	;lda $2B00|$004E
	;sta @SRAM_SAVED_40

	jmp audio_fix

load_state_jump_exit:
	jmp ss_exit

load_state:
	; check if this is SM
	rep #$20
	.al
	lda @l $00FFDE
	cmp #$F8DF
	bne +
	; if SM, check return address and make sure it's not in the sound loading code $808159-$808110
	lda 10,s
	cmp #$8059
	bcc +
	cmp #$8111
	bcs +
	sep #$20
	.as
	bra load_state_jump_exit

+ sep #$20
  .as

	lda @l CS_STATE
	bne load_state_jump_exit
	inc a
	sta @l CS_STATE

	; disable interrupts
	lda @l $F90700|$0000
	and #$01
	sta @l $4200

	phb
	phd
	rep #$30
	.al
	.xl
	pha
	phx
	phy

	pea $0000
	plb
	plb

+ ldy #<>load_write_table
	jmp run_vm

load_return:
	rep #$30
	.al
	.xl
	lda @l SRAM_SAVED_SP
	tcs

	pea $0000
	plb
	plb

	; wait delay frames
	sep #$20
	.as
	lda CS_DELAY
ss_frameloop:
- bit $4212
	bpl -
- bit $4212
	bmi -
	dec a
	bpl ss_frameloop

audio_fix:
	jsl CS_FIXES
	jmp load_dma_regs_start

load_dma_regs_start:
	sep #$20
	.as
	ldx #$0000
	txy

- lda @l SRAM_DMA_BANK,x
	sta $4300,x
	inx
	iny
	cpy #$000B
	bne -
	cpx #$007B
	beq +
	inx
	inx
	inx
	inx
	inx
	ldy #$0000
	bra -

	; Restore registers and return.
+ jmp register_restore_return

vm:
	; Data format: xx xx yy yy
	; xxxx = little-endian address to write to .vm's bank
	; yyyy = little-endian value to write
	; If xxxx has high bit set, read and discard instead of write.
	; If xxxx has bit 12 set ($1000), byte instead of word.
	; If xxxx is $0000, end the VM.

	rep #$20      ;
	.al
	; Read address to write to
	lda $0000,y
	beq vm_done
	iny
	iny
	; Check for read mode (high bit of address)
	; Save off in carry flag for use later
	cmp #$8000
	and #$7FFF
	tax
	; Check for byte mode
	bit #$1000
	beq vm_word_mode
	and #$EFFF
	tax
	sep #$20
	.as
vm_word_mode:
	; Read value
	lda $0000,y
	iny
	iny
vm_write:
	bcs vm_read
	sta @l $000000,x
	bra vm
vm_read:
	lda @l $000000,x
	bra vm

vm_done:
	; A, X and Y are 16-bit at exit.
	; Return to caller.  The word in the table after the terminator is the
	; code address to return to.
	tyx
	jmp ($0002,k,x)
.text "SAVESTATE_END"

; print "Savestate Bank Ending at: ", pc
