mrehkopf/sd2snes/src/cheat.h

#ifndef CHEAT_H
#define CHEAT_H

/* sd2snes cheat capabilities:
 *  -  6 ROM patches
 *  - 32 WRAM patches
 *  - in-game button shortcuts to en/disable cheats
 */

/* cheat area in PSRAM (shared with the SNES menu, see snes/memmap.inc):
 *  SRAM_NUM_CHEATS: 16-bit number of cheat records
 *  SRAM_CHEAT_ADDR: cheat records, one every CHEAT_RECORD_STRIDE bytes
 */

/* cheat record structure (cheat_record_t):
 *  +0   1 byte : flags (bit 7: cheat enabled; bit 6-0: reserved)
 *  +1 254 bytes: cheat description, NUL terminated
 * +255  1 byte : number of patches (codes) for this cheat
 * +256 40 x 4 bytes: patches: value, address low, address high, bank
 * +416 40 bytes: format per patch as given by the user
 *                (bit 0: Game Genie code, written back as such)
 */

#include CONFIG_MCU_H
#include <stddef.h>

#define CHEAT_BASEDIR   ("/sd2snes/cheats/")
/* second line of cheat files written by the firmware */
#define CHEAT_YAML_SIGNATURE ("# Generated by sd2snes")

/* where the menu took the file from (MCU_PARAM+8 of SNES_CMD_*_CHT) */
#define CHEAT_SRC_BROWSER         (0)
#define CHEAT_SRC_RECENT          (1)
#define CHEAT_SRC_FAVORITE        (2)

/* result of SNES_CMD_LOAD_CHT/SAVE_CHT in SRAM_CHEAT_STATUS */
#define CHEAT_STATUS_OK           (0)
#define CHEAT_STATUS_ERR          (1)

#define CHEAT_FLAG_ENABLE         (0x80)
#define CHEAT_CODEFMT_GG          (0x01)

#define CHEAT_MAX_CHEATS          (2048)
#define CHEAT_RECORD_STRIDE       (512)
#define CHEAT_NUM_CODES_PER_CHEAT (40)
#define CHEAT_NUM_ROM_PATCHES     (6)
#define CHEAT_NUM_WRAM_PATCHES    (32)
/* longest name that still fits a 256 byte YAML line when saved */
#define CHEAT_NAME_MAXLEN         (240)

typedef union _cheat_patch_record {
  struct __attribute__ ((__packed__)) _patch_fields {
    uint8_t  patchvalue;
    uint16_t patchaddr;
    uint8_t  patchbank;
  } fields;
  uint32_t code;
} cheat_patch_record_t;

typedef struct __attribute__ ((__packed__)) _cheat_record {
  uint8_t flags;
  char description[254];
  uint8_t numpatches;
  cheat_patch_record_t patches[CHEAT_NUM_CODES_PER_CHEAT];
  uint8_t codefmt[CHEAT_NUM_CODES_PER_CHEAT];
} cheat_record_t;

/* the SNES menu relies on this layout */
_Static_assert(offsetof(cheat_record_t, description) == 1, "cheat_record_t layout");
_Static_assert(offsetof(cheat_record_t, numpatches) == 255, "cheat_record_t layout");
_Static_assert(offsetof(cheat_record_t, patches) == 256, "cheat_record_t layout");
_Static_assert(offsetof(cheat_record_t, codefmt) == 416, "cheat_record_t layout");
_Static_assert(sizeof(cheat_record_t) <= CHEAT_RECORD_STRIDE, "cheat_record_t size");

/* deploy all cheats to SNES code / FPGA */
void cheat_program(void);

/* deploy a single cheat record */
void cheat_program_single(cheat_patch_record_t *cheat);

/* deploy ROM cheat to FPGA */
void cheat_program_rom_cheat(int index, cheat_patch_record_t *cheat);

/* deploy WRAM cheat to SNES code */
void cheat_program_ram_cheat(int index, cheat_patch_record_t *cheat);

/* load CHT file to RAM */
void cheat_load_to_menu(int index, cheat_record_t *cheat);
void cheat_save_from_menu(int index, cheat_record_t *cheat);

/* enable/disable ROM cheats + hooks */
void cheat_enable(int enable);
void cheat_nmi_enable(int enable);
void cheat_irq_enable(int enable);
void cheat_holdoff_enable(int enable);
void cheat_buttons_enable(int enable);
void cheat_wram_present(int enable);

/* read cheats from YAML file and convert to SNES structure;
   a missing file yields zero cheats. Returns 0 or an FRESULT */
int cheat_yaml_load(uint8_t *romfilename);
/* save SNES structure as YAML file. Returns 0 or an FRESULT */
int cheat_yaml_save(uint8_t *romfilename);

/* menu commands: load the cheats of the file selected in the menu
   (source: CHEAT_SRC_*) and save them back after editing.
   Both write a CHEAT_STATUS_* code to SRAM_CHEAT_STATUS. */
void cheat_menu_load(uint8_t source);
void cheat_menu_save(uint8_t source);

/* convert cheat code in string format to binary;
   sets *fmt to CHEAT_CODEFMT_GG for Game Genie codes, 0 otherwise */
uint32_t cheat_str2bin(char *string, uint8_t *fmt);

/* convert between raw/PAR and GG codes */
uint32_t cheat_gg2raw(uint32_t code);
uint32_t cheat_raw2gg(uint32_t code);

#endif
