mrehkopf/sd2snes/src/stm32f4xx/sdnative.c

#include <stdio.h>
#include <string.h>
#include "config.h"
#include "crc.h"
#include "crc16.h"
#include "diskio.h"
#include "spi.h"
#include "timer.h"
#include "uart.h"
#include "led.h"
#include "sdnative.h"
#include "fileops.h"
#include "bits.h"
#include "fpga_spi.h"
#include "memory.h"
#include "snes.h"
#include "fileops.h"
#include "usbinterface.h"

#define MAX_CARDS 1

// SD/MMC commands
#define GO_IDLE_STATE           0
#define SEND_OP_COND            1
#define ALL_SEND_CID            2
#define SEND_RELATIVE_ADDR      3
#define SWITCH_FUNC             6
#define SELECT_CARD             7
#define SEND_IF_COND            8
#define SEND_CSD                9
#define SEND_CID               10
#define STOP_TRANSMISSION      12
#define SEND_STATUS            13
#define GO_INACTIVE_STATE      15
#define SET_BLOCKLEN           16
#define READ_SINGLE_BLOCK      17
#define READ_MULTIPLE_BLOCK    18
#define WRITE_BLOCK            24
#define WRITE_MULTIPLE_BLOCK   25
#define PROGRAM_CSD            27
#define SET_WRITE_PROT         28
#define CLR_WRITE_PROT         29
#define SEND_WRITE_PROT        30
#define ERASE_WR_BLK_STAR_ADDR 32
#define ERASE_WR_BLK_END_ADDR  33
#define ERASE                  38
#define LOCK_UNLOCK            42
#define APP_CMD                55
#define GEN_CMD                56
#define READ_OCR               58
#define CRC_ON_OFF             59

// SD ACMDs
#define SD_SET_BUS_WIDTH           6
#define SD_STATUS                 13
#define SD_SEND_NUM_WR_BLOCKS     22
#define SD_SET_WR_BLK_ERASE_COUNT 23
#define SD_SEND_OP_COND           41
#define SD_SET_CLR_CARD_DETECT    42
#define SD_SEND_SCR               51

// R1 status bits
#define STATUS_IN_IDLE          1
#define STATUS_ERASE_RESET      2
#define STATUS_ILLEGAL_COMMAND  4
#define STATUS_CRC_ERROR        8
#define STATUS_ERASE_SEQ_ERROR 16
#define STATUS_ADDRESS_ERROR   32
#define STATUS_PARAMETER_ERROR 64


/* Card types - cardtype == 0 is MMC */
#define CARD_SD   (1<<0)
#define CARD_SDHC (1<<1)

/*
                Rev.A    Rev.C
    1 DAT3/SS   P0.6     P2.3
    2 CMD/DI    P0.9     P0.9
    5 Clock     P0.7     P0.7
    7 DAT0/DO   P0.8     P2.0
    8 DAT1/IRQ  P1.14    P2.1
    9 DAT2/NC   P1.15    P2.2
*/

/* SD init procedure
   =================
    - initial clock frequency: ~100kHz
    - cycle the clock for at least 74 cycles (some more may be safer)
    - send CMD0
    - send CMD8 (SEND_OP_COND); if no response -> HCS=0; else HCS=1
    - send ACMD41 until OCR[31] (busy) becomes 1 (means: ready)
    - if OCR[30] (CCS) set -> SDHC; else SDSC
    - send CMD2 (read CID) (maybe log some stuff from the CID)
    - send CMD3 (read RCA), store RCA
== end of initialisation ==
    - send CMD9 (read CSD) with RCA, maybe do sth with TRAN_SPEED
    - send CMD7 with RCA, select card, put card in tran
    - maybe send CMD13 with RCA to check state (tran)
    - send ACMD51 with RCA to read SCR (maybe, to check 4bit support)
    - increase clock speed
    - send ACMD6 with RCA to set 4bit bus width
    - send transfer cmds
*/

/*
    static CMD payloads. (no CRC calc required)
    -  CMD0: 0x40 0x00 0x00 0x00 0x00 0x95
    -  CMD8: 0x48 0x00 0x00 0x01 0xaa 0x87
    -  CMD2: 0x42 0x00 0x00 0x00 0x00 0x4d
    -  CMD3: 0x43 0x00 0x00 0x00 0x00 0x21
    - CMD55: 0x77 0x00 0x00 0x00 0x00 0x65
*/

uint8_t cmd[6]={0,0,0,0,0,0};
uint8_t rsp[17];
uint8_t csd[17];
uint8_t cid[17];
diskinfo0_t di;
uint8_t ccs=0;
uint32_t rca;

enum trans_state { TRANS_NONE = 0, TRANS_READ, TRANS_WRITE, TRANS_MID };
enum cmd_state { CMD_RSP = 0, CMD_RSPDAT, CMD_DAT };

int during_blocktrans = TRANS_NONE;
uint32_t last_block = 0;
uint16_t last_offset = 0;

volatile int sd_changed;

#ifdef CONFIG_SD_HWSDIO_SELFTEST
/* route MCU-side transfers through bit-banging (self tests);
   without CONFIG_SD_HWSDIO everything is bit-banged anyway */
uint8_t sd_force_bb = 0;
#endif

#ifdef CONFIG_SD_HWSDIO
/*
   Hardware SDIO host:
   ===================
   Use dedicated SDIO controller for MCU-owned access (DMA2 stream 3 channel 4)
   Card init and FPGA-side SD DMA (via sd_offload) stay bitbanged for now
   to keep compatibility with current FPGA cores

   SD pins are switched between GPIO and AF12 (SDIO host) on demand.
   CMD18/25 may be handed over.

   Use the PWRSAV flag to make sure the SDIO-host generated SD clock is
   stopped to make hand-over to sd_offload / bitbanging possible.
*/

#define SD_HW_RETRIES       (3)
#define SD_HW_DTIMER        (12000000)    /* data timeout in SDIO_CK cycles */
#define SD_HW_LOOP_GUARD    (20000000)    /* polling loop limit */
#define SD_R1_ERRORS        (0xfdffe008)  /* error bits of the R1 card status */

#define SDIO_CMD_RESP_SHORT (SDIO_CMD_WAITRESP_0)

#define SDIO_STA_CMD_DONE   (SDIO_STA_CMDREND | SDIO_STA_CCRCFAIL | SDIO_STA_CTIMEOUT)
#define SDIO_STA_DATA_ERR   (SDIO_STA_DCRCFAIL | SDIO_STA_DTIMEOUT | SDIO_STA_RXOVERR \
                             | SDIO_STA_TXUNDERR | SDIO_STA_STBITERR)
#define SDIO_ICR_CMD_FLAGS  (SDIO_ICR_CCRCFAILC | SDIO_ICR_CTIMEOUTC | SDIO_ICR_CMDRENDC \
                             | SDIO_ICR_CMDSENTC)
#define SDIO_ICR_ALL_FLAGS  (SDIO_ICR_CMD_FLAGS | SDIO_ICR_DCRCFAILC | SDIO_ICR_DTIMEOUTC \
                             | SDIO_ICR_TXUNDERRC | SDIO_ICR_RXOVERRC | SDIO_ICR_DATAENDC \
                             | SDIO_ICR_STBITERRC | SDIO_ICR_DBCKENDC)

enum sd_bus_mode { SD_BUS_GPIO = 0, SD_BUS_HOST };
enum sd_stream_owner { SD_OWNER_BB = 0, SD_OWNER_HOST };

sd_hw_stats_t sd_hw_stats;

/* whether MCU-side (not offloaded) transfers go through the SDIO host */
static inline int sd_use_host(void) {
#ifdef CONFIG_SD_HWSDIO_SELFTEST
  return !sd_force_bb;
#else
  return 1;
#endif
}

static uint8_t sd_bus_mode = SD_BUS_GPIO;
static uint8_t sd_stream_owner = SD_OWNER_BB;
static uint8_t sd_host_clk_idle = 0;   /* SDIO_CK level while gated */
static uint32_t sd_hw_bounce[128];     /* word aligned block buffer for DMA */

/* SDIO registers must not be written again within 3 SDIOCLK + 2 PCLK2 cycles */
static inline void sdio_reg_delay(void) {
  for(volatile int i = 0; i < 8; i++);
}

/* hand the SD pins to the bit-banging code */
static void sd_bus_gpio(void) {
  if(sd_bus_mode == SD_BUS_GPIO) return;
  /* keep SD_CLK at its current level so the switch creates no clock edge */
  OUT_BIT(SD_CLKREG, SD_CLKBIT, BITBAND(SD_CLKREG->GPIO_I, SD_CLKBIT));
  SET_BIT(SD_CMDREG, SD_CMDBIT);
  GPIO_MODE_OUT(SD_CLKREG, SD_CLKBIT);
  GPIO_MODE_OUT(SD_CMDREG, SD_CMDBIT);
  GPIO_MODE_IN(SD_DAT0REG, SD_DAT0BIT);
  GPIO_MODE_IN(SD_DAT1REG, SD_DAT1BIT);
  GPIO_MODE_IN(SD_DAT2REG, SD_DAT2BIT);
  GPIO_MODE_IN(SD_DAT3REG, SD_DAT3BIT);
  sd_bus_mode = SD_BUS_GPIO;
}

/* hand the SD pins to the SDIO host */
static void sd_bus_host(void) {
  if(sd_bus_mode == SD_BUS_HOST) return;
  /* move SD_CLK to the host's idle level first */
  OUT_BIT(SD_CLKREG, SD_CLKBIT, sd_host_clk_idle);
  GPIO_MODE_AF(SD_CLKREG, SD_CLKBIT);
  GPIO_MODE_AF(SD_CMDREG, SD_CMDBIT);
  GPIO_MODE_AF(SD_DAT0REG, SD_DAT0BIT);
  GPIO_MODE_AF(SD_DAT1REG, SD_DAT1BIT);
  GPIO_MODE_AF(SD_DAT2REG, SD_DAT2BIT);
  GPIO_MODE_AF(SD_DAT3REG, SD_DAT3BIT);
  sd_bus_mode = SD_BUS_HOST;
}

static void sdio_dma_start(const void *buf, int to_card) {
  uint32_t guard = 100000;
  DMA2_Stream3->CR = 0;
  while((DMA2_Stream3->CR & DMA_SxCR_EN) && --guard);
  DMA2->LIFCR = DMA_LIFCR_CTCIF3
              | DMA_LIFCR_CHTIF3
              | DMA_LIFCR_CTEIF3
              | DMA_LIFCR_CDMEIF3
              | DMA_LIFCR_CFEIF3;
  DMA2_Stream3->PAR  = (uint32_t)&SDIO->FIFO;
  DMA2_Stream3->M0AR = (uint32_t)buf;
  DMA2_Stream3->NDTR = 0;                               // ignored: SDIO is flow controller
  DMA2_Stream3->FCR  = DMA_SxFCR_DMDIS | DMA_SxFCR_FTH; // FIFO mode, threshold full
  DMA2_Stream3->CR   = (4 << DMA_SxCR_CHSEL_Pos)        // DMA channel 4 selects SDIO
                     | (0 << DMA_SxCR_MBURST_Pos)       // single (memory): buffers are
                                                        // only word aligned, a burst
                                                        // could cross a 1KB boundary
                     | (1 << DMA_SxCR_PBURST_Pos)       // INCR4 burst (peripheral)
                     | (2 << DMA_SxCR_MSIZE_Pos)        // mem data size = word
                     | (2 << DMA_SxCR_PSIZE_Pos)        // periph data size = word
                     | (3 << DMA_SxCR_PL_Pos)           // very high priority
                     | (1 << DMA_SxCR_MINC_Pos)         // increment memory address
                     | ((to_card ? 1 : 0) << DMA_SxCR_DIR_Pos) // 01: memory to peripheral
                     | (1 << DMA_SxCR_PFCTRL_Pos)       // flow governed by peripheral
                     | (1 << DMA_SxCR_EN_Pos);          // enable stream
}

/* stop any data transfer of the host and its DMA */
static void sdio_abort(void) {
  uint32_t guard = 100000;
  SDIO->DCTRL = 0;
  DMA2_Stream3->CR &= ~DMA_SxCR_EN;
  while((DMA2_Stream3->CR & DMA_SxCR_EN) && --guard);
  SDIO->ICR = SDIO_ICR_ALL_FLAGS;
}

/* send a command through the host; resp = 0 (none) or SDIO_CMD_RESP_SHORT */
static int sdio_cmd(uint8_t index, uint32_t arg, uint32_t resp, uint32_t *r1) {
  uint32_t sta, guard = SD_HW_LOOP_GUARD;
  uint32_t done = resp ? SDIO_STA_CMD_DONE : SDIO_STA_CMDSENT;
  SDIO->ICR = SDIO_ICR_CMD_FLAGS;
  SDIO->ARG = arg;
  SDIO->CMD = (index & SDIO_CMD_CMDINDEX) | resp | SDIO_CMD_CPSMEN;
  while(!((sta = SDIO->STA) & done) && --guard);
  SDIO->ICR = SDIO_ICR_CMD_FLAGS;
  if(!guard || (sta & SDIO_STA_CTIMEOUT)) {
    sd_hw_stats.cmd_timeout++;
    DBG_SD printf("SDIO: CMD%d timeout\n", index);
    return -1;
  }
  if(sta & SDIO_STA_CCRCFAIL) {
    sd_hw_stats.cmd_crcfail++;
    DBG_SD printf("SDIO: CMD%d response CRC error\n", index);
    return -1;
  }
  if(r1) {
    *r1 = SDIO->RESP1;
  }
  return 0;
}

/* arm the data path for len bytes in 512 byte blocks */
static void sdio_dpsm_start(uint32_t len, int to_card) {
  SDIO->DTIMER = SD_HW_DTIMER;
  SDIO->DLEN = len;
  SDIO->DCTRL = (9 << SDIO_DCTRL_DBLOCKSIZE_Pos)   // 2^9 = 512 byte blocks
              | SDIO_DCTRL_DMAEN
              | (to_card ? 0 : SDIO_DCTRL_DTDIR)
              | SDIO_DCTRL_DTEN;
}

/* wait for the end of a data transfer; returns 0 on success */
static int sdio_data_wait(int to_card) {
  uint32_t sta, guard = SD_HW_LOOP_GUARD;
  while(!((sta = SDIO->STA) & (SDIO_STA_DATAEND | SDIO_STA_DATA_ERR)) && --guard);
  if(guard && !(sta & SDIO_STA_DATA_ERR)) {
    if(to_card) {
      /* FIFO empty; release the stream if it has not stopped yet */
      DMA2_Stream3->CR &= ~DMA_SxCR_EN;
    }
    /* reads: DMA drains its FIFO and then disables the stream */
    guard = SD_HW_LOOP_GUARD;
    while((DMA2_Stream3->CR & DMA_SxCR_EN) && --guard);
    if(DMA2->LISR & (DMA_LISR_TEIF3 | DMA_LISR_DMEIF3)) {
      sd_hw_stats.dma_error++;
    } else if(guard) {
      SDIO->ICR = SDIO_ICR_ALL_FLAGS;
      return 0;
    } else {
      sd_hw_stats.dma_timeout++;
    }
  } else {
    if(!guard)                  sd_hw_stats.data_timeout++;
    if(sta & SDIO_STA_DCRCFAIL) sd_hw_stats.data_crcfail++;
    if(sta & SDIO_STA_DTIMEOUT) sd_hw_stats.data_timeout++;
    if(sta & SDIO_STA_RXOVERR)  sd_hw_stats.rx_overrun++;
    if(sta & SDIO_STA_TXUNDERR) sd_hw_stats.tx_underrun++;
    if(sta & SDIO_STA_STBITERR) sd_hw_stats.startbit_err++;
  }
  DBG_SD printf("SDIO: data error, STA=%08lx\n", sta);
  sdio_abort();
  return -1;
}

/* wait until the card releases DAT0 (busy); keep the clock running meanwhile.
   Only call this with no read stream open, or the card would stream data. */
static void sdio_wait_busy(void) {
  tick_t timeout = getticks() + MS_TO_TICKS(1000);
  SDIO->CLKCR &= ~SDIO_CLKCR_PWRSAV;
  sdio_reg_delay();
  while(!(BITBAND(SD_DAT0REG->GPIO_I, SD_DAT0BIT))) {
    if(time_after(getticks(), timeout)) {
      sd_hw_stats.busy_timeout++;
      break;
    }
  }
  SDIO->CLKCR |= SDIO_CLKCR_PWRSAV;
  sdio_reg_delay();
}

/* end any open CMD18/CMD25 stream through the host */
static void sdio_stop_transmission(void) {
  sd_bus_host();
  sdio_abort();
  /* response ignored: card might set OUT_OF_RANGE after its last block */
  sdio_cmd(STOP_TRANSMISSION, 0, SDIO_CMD_RESP_SHORT, NULL);
  sdio_wait_busy();
  sd_hw_stats.stream_stops++;
  during_blocktrans = TRANS_NONE;
}

static int sdio_read_once(uint8_t *buf, uint32_t sector, uint32_t count) {
  uint32_t r1;
  int newstream = 1;
  int aligned = !((uint32_t)buf & 3);
  sd_bus_host();
#ifdef CONFIG_SD_HWSDIO_CONTINUE
  if(during_blocktrans == TRANS_READ && last_block == sector - 1) {
    newstream = 0;
    sd_hw_stats.stream_continues++;
  }
#endif
  if(newstream && during_blocktrans) {
    sdio_stop_transmission();
  }
  for(uint32_t blk = 0; blk < count; ) {
    /* aligned buffers get all blocks in one go, others one by one */
    uint32_t n = aligned ? count : 1;
    sdio_dma_start(aligned ? (void*)buf : (void*)sd_hw_bounce, 0);
    /* arm the data path first; data may start during the response */
    sdio_dpsm_start(n * 512, 0);
    if(newstream) {
      /* from here on a stream may be open, even if the command fails */
      during_blocktrans = TRANS_READ;
      if(sdio_cmd(READ_MULTIPLE_BLOCK, ccs ? sector : sector << 9, SDIO_CMD_RESP_SHORT, &r1)) {
        sdio_abort();
        return -1;
      }
      if(r1 & SD_R1_ERRORS) {
        sd_hw_stats.r1_error++;
        DBG_SD printf("SDIO: CMD18 R1=%08lx\n", r1);
        sdio_abort();
        return -1;
      }
      newstream = 0;
    }
    if(sdio_data_wait(0)) {
      return -1;
    }
    if(!aligned) {
      memcpy(buf + blk * 512, sd_hw_bounce, 512);
      sd_hw_stats.bounce_blocks++;
    }
    blk += n;
  }
  during_blocktrans = TRANS_READ;
  sd_stream_owner = SD_OWNER_HOST;
  last_block = sector + count - 1;
  last_offset = 0;
  sd_offload_partial = 0;
#ifndef CONFIG_SD_HWSDIO_CONTINUE
  sdio_stop_transmission();
#endif
  return 0;
}

static DRESULT sdio_read(uint8_t *buf, uint32_t sector, uint32_t count) {
  sd_hw_stats.read_calls++;
  for(int attempt = 0; attempt <= SD_HW_RETRIES; attempt++) {
    if(attempt) {
      sd_hw_stats.read_retries++;
    }
    if(!sdio_read_once(buf, sector, count)) {
      return RES_OK;
    }
    sdio_stop_transmission();
  }
  sd_hw_stats.read_failures++;
  printf("SDIO: reading sector %08lx (+%lu) failed\n", sector, count);
  return RES_ERROR;
}

#if defined(CONFIG_SD_HWSDIO_WRITE)
static int sdio_write_once(const uint8_t *buf, uint32_t sector, uint32_t count) {
  uint32_t r1;
  int newstream = 1;
  int aligned = !((uint32_t)buf & 3);
  sd_bus_host();
#ifdef CONFIG_SD_HWSDIO_CONTINUE
  if(during_blocktrans == TRANS_WRITE && last_block == sector - 1) {
    newstream = 0;
    sd_hw_stats.stream_continues++;
  }
#endif
  if(newstream && during_blocktrans) {
    sdio_stop_transmission();
  }
  sdio_wait_busy();
  if(newstream) {
    /* from here on a stream may be open, even if the command fails */
    during_blocktrans = TRANS_WRITE;
    if(sdio_cmd(WRITE_MULTIPLE_BLOCK, ccs ? sector : sector << 9, SDIO_CMD_RESP_SHORT, &r1)) {
      return -1;
    }
    if(r1 & SD_R1_ERRORS) {
      sd_hw_stats.r1_error++;
      DBG_SD printf("SDIO: CMD25 R1=%08lx\n", r1);
      return -1;
    }
  }
  sd_stream_owner = SD_OWNER_HOST;
  for(uint32_t blk = 0; blk < count; ) {
    /* aligned buffers go out in one go, others one by one */
    uint32_t n = aligned ? count : 1;
    if(!aligned) {
      if(blk) {
        sdio_wait_busy();
      }
      memcpy(sd_hw_bounce, buf + blk * 512, 512);
      sd_hw_stats.bounce_blocks++;
    }
    sdio_dma_start(aligned ? (const void*)buf : (const void*)sd_hw_bounce, 1);
    sdio_dpsm_start(n * 512, 1);
    if(sdio_data_wait(1)) {
      return -1;
    }
    blk += n;
  }
  last_block = sector + count - 1;
#ifndef CONFIG_SD_HWSDIO_CONTINUE
  sdio_stop_transmission();
#endif
  return 0;
}

static DRESULT sdio_write(const uint8_t *buf, uint32_t sector, uint32_t count) {
  sd_hw_stats.write_calls++;
  for(int attempt = 0; attempt <= SD_HW_RETRIES; attempt++) {
    if(attempt) {
      sd_hw_stats.write_retries++;
    }
    if(!sdio_write_once(buf, sector, count)) {
      return RES_OK;
    }
    sdio_stop_transmission();
  }
  sd_hw_stats.write_failures++;
  printf("SDIO: writing sector %08lx (+%lu) failed\n", sector, count);
  return RES_ERROR;
}
#endif

/* configure the host for the initialized card (4 bit bus, card selected) */
static void sdio_host_setup(void) {
  SDIO->CLKCR = (CONFIG_SD_HWSDIO_CLKDIV << SDIO_CLKCR_CLKDIV_Pos)
              | SDIO_CLKCR_WIDBUS_0    // 4 bit bus
              | SDIO_CLKCR_PWRSAV      // gate SDIO_CK while the host is idle
              | SDIO_CLKCR_CLKEN;
  sdio_reg_delay();
  /* measure the gated clock level so later mode switches create no clock edge */
  sd_bus_host();
  sdio_reg_delay();
  uint8_t samples = 0;
  /* sample the clock 8 times */
  for(int i = 0; i < 8; i++) {
    samples = (samples << 1) | BITBAND(SD_CLKREG->GPIO_I, SD_CLKBIT);
    sdio_reg_delay();
  }
  /* validate */
  if(samples != 0x00 && samples != 0xff) {
    printf("SDIO host: WARNING: SDIO_CK idle level unstable (samples %02x), assuming low\n", samples);
    samples = 0;
  }
  sd_host_clk_idle = samples & 1;
  sd_stream_owner = SD_OWNER_BB;
  printf("SDIO host: SDIO_CK=%dkHz, idle level %d\n",
         48000 / (CONFIG_SD_HWSDIO_CLKDIV + 2), sd_host_clk_idle);
}

void sdn_hw_printstats(void) {
  printf("SDIO host: SDIO_CK=%dkHz idle=%d bus=%s stream=%d owner=%s\n",
         48000 / (CONFIG_SD_HWSDIO_CLKDIV + 2), sd_host_clk_idle,
         sd_bus_mode == SD_BUS_HOST ? "host" : "gpio", during_blocktrans,
         sd_stream_owner == SD_OWNER_HOST ? "host" : "bb");
  printf("calls: read %lu write %lu; retries: read %lu write %lu; failed: read %lu write %lu\n",
         sd_hw_stats.read_calls, sd_hw_stats.write_calls,
         sd_hw_stats.read_retries, sd_hw_stats.write_retries,
         sd_hw_stats.read_failures, sd_hw_stats.write_failures);
  printf("streams: continued %lu, stopped %lu; bounce blocks %lu\n",
         sd_hw_stats.stream_continues, sd_hw_stats.stream_stops, sd_hw_stats.bounce_blocks);
  printf("errors: cmd timeout %lu, cmd crc %lu, r1 %lu, data crc %lu, data timeout %lu,\n"
         "        rx overrun %lu, tx underrun %lu, start bit %lu, dma %lu, busy %lu\n",
         sd_hw_stats.cmd_timeout, sd_hw_stats.cmd_crcfail, sd_hw_stats.r1_error,
         sd_hw_stats.data_crcfail, sd_hw_stats.data_timeout, sd_hw_stats.rx_overrun,
         sd_hw_stats.tx_underrun, sd_hw_stats.startbit_err, sd_hw_stats.dma_timeout,
         sd_hw_stats.busy_timeout);
  printf("        dma error %lu\n", sd_hw_stats.dma_error);
}

#define SD_BB_ENTRY() sd_bus_gpio()
#else
#define SD_BB_ENTRY() do {} while(0)
#endif

/**
 * getbits - read value from bit buffer
 * @buffer: pointer to the data buffer
 * @start : index of the first bit in the value
 * @bits  : number of bits in the value
 *
 * This function returns a value from the memory region passed as
 * buffer, starting with bit "start" and "bits" bit long. The buffer
 * is assumed to be MSB first, passing 0 for start will read starting
 * from the highest-value bit of the first byte of the buffer.
 */
static uint32_t getbits(void *buffer, uint16_t start, int8_t bits) {
  uint8_t *buf = buffer;
  uint32_t result = 0;

  if ((start % 8) != 0) {
    /* Unaligned start */
    result += buf[start / 8] & (0xff >> (start % 8));
    bits  -= 8 - (start % 8);
    start += 8 - (start % 8);
  }
  while (bits >= 8) {
    result = (result << 8) + buf[start / 8];
    start += 8;
    bits -= 8;
  }
  if (bits > 0) {
    result = result << bits;
    result = result + (buf[start / 8] >> (8-bits));
  } else if (bits < 0) {
    /* Fraction of a single byte */
    result = result >> -bits;
  }
  return result;
}

void sdn_checkinit(BYTE drv) {
  if(disk_state == DISK_CHANGED) {
    disk_initialize(drv);
  }
}

uint8_t* sdn_getcid() {
  sdn_checkinit(0);
  return cid;
}
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
