mrehkopf/sd2snes/(commit log)

2009-07-06 begin work on cartridge pcb
    [sd2snes1.brd, sd2snes1.sch]
2009-09-04 new SRAM access (SPI)
2009-09-04 new files (SPI)
2009-09-11 cleanup schematic, edge triggered cycle start detection, debug output cleanup
    [sd2snes17.sch]
2009-09-15 fix timing; misc cleanup
    [address.v, main.c, main.v, memory.c, memory.h, snes.c, uart.c, uart.h]
2009-10-08 New board layout
    [sd2snes18.brd, sd2snes18.sch]
2009-10-08 bugfix map detect, configurable work address
    [fileops.c, filetypes.c, main.c, memory.h, smc.c]
2009-10-14 display logo gfx, misc gfx related helpers
    [sd2snes18.sch]
2009-10-22 Adjustments for board rev.B
    [sd2snes18.brd, sd2snes18.sch]
2009-10-30 brainfuck workaround for byte swapping. also cocks
    [avr_cmd.v, filetypes.c, main.c, main.v, memory.c, memory.h]
2009-11-04 menu progress, led pwm, db tweaks
2009-11-06 fix mirroring for menu
    [main.c]
2009-11-09 db fix (may still need serious fixing)
    [filetypes.c, filetypes.h, led.c, main.c]
2009-11-15 reset detection
    [sd2snes18.sch]
2009-11-19 448i mode (select button), sram reliability checking
2009-11-29 menu nav update, improve autosave, fix db creation (bankswitch), SRAM size, SPI speed fix in shared mode, soft reset, mapper detect
    [filetypes.c, fpga.c, led.c, main.c, memory.c, memory.h, smc.c, smc.h]
2009-12-02 misc stuff, preparation hack for autonomous clock (needs to be reverted)
    [config.h, dcm.v, fpga.c, main.c, main.v, spi.c]
2009-12-05 new pcb with autonomous clock
    [sd2snes19.brd, sd2snes19.sch]
2009-12-19 fix strange inverted address line bug, lots of other stuff
    [sd2snes19.brd]
2009-12-22 SPI offloading -> 5x loading speed (needs code cleanup)
2009-12-24 bugfixes for SD card compatibility in DMA mode
    [ff.c, main.c, memory.c, sdcard.c]
2009-12-28 dedicated mapper for menu, new logo gfx, TODO: fix avr mem access again also minor cleanups.
    [address.v, avr_cmd.v, ff.c, fileops.c, filetypes.c, fpga.c]
2009-12-29 fix snes timing, stable operation
    [ff.h, fpga.c, main.c, main.v, memory.c, sdcard.c]
2010-01-25 lots of wip, tests, incoming redesign
    [sd2snes19.sch, sd2snes20.brd, sd2snes20.sch, vfbga48breakout.brd, vfbga48breakout.sch]
2010-02-09 switch to kicad
    [$savepcb.brd, fpga.sch, mcu.sch, pwr_misc.sch, sd2snes.brd, sd2snes.sch, sd2snes20.brd, sd2snes20.sch]
2010-03-16 Fix pin mapping to better match CICLONE pinout
    [snescic-key.asm]
2010-03-24 clean up AVR code(deprecated), kicad libs, pcb WIP
    [fpga.sch, mcu.sch, pwr_misc.sch, sd2snes.brd, sd2snes.sch, snesslot.sch]
2010-03-27 kicad wip
    [$savepcb.brd, fpga.sch, mcu.sch, pwr_misc.sch, sd2snes.brd, sd2snes.sch, snesslot.sch]
2010-04-15 more time for clock to stabilize; disable reset pullup (may be bogus)
    [snescic-lock.asm]
2010-04-17 Schematics+PCB WIP
    [$savepcb.brd, fpga.sch, mcu.sch, memory.sch, pwr_misc.sch, sd2snes.brd, sd2snes.sch, snesslot.sch]
2010-04-18 Schematics: connect PSRAM
    [$savepcb.brd, fpga.sch, mcu.sch, memory.sch, pwr_misc.sch, sd2snes.brd, sd2snes.sch, snesslot.sch]
2010-04-21 Revert to last working SRAM configuration (for AM2010)
    [main.v]
2010-04-22 pcb wip
    [fpga.sch, mcu.sch, memory.sch, pwr_misc.sch, sd2snes.sch, snesslot.sch]
2010-05-07 SuperCIC pair mode disable switch
2010-05-09 SuperCIC: change D4 behaviour, add region timeout trick enable switch
2010-05-13 SuperCIC: LED polarity switch
2010-05-13 SuperCIC: LED polarity switch, fix pair mode detection
    [supercic-key.asm, supercic-lock.asm]
2010-05-27 pcb wip + mod fix
    [$savepcb.brd, fpga.sch, mcu.sch, memory.sch, pwr_misc.sch, sd2snes.brd, sd2snes.sch, snesslot.sch]
2010-05-27 pcb wip?
    [sd2snes.brd]
2010-06-02 pcb wip (use switching regulator?)
    [fpga.sch, mcu.sch, memory.sch, pwr_misc.sch, sd2snes.brd, sd2snes.sch, sd2snes_ldo.brd, sd2snes_ldo.sch]
2010-06-03 pcb+schem wip
    [fpga.sch, mcu.sch, memory.sch, pwr_misc.sch, sd2snes.sch, snesslot.sch]
2010-06-07 supercic/1chip schematics/documentation
    [1chip-5060.sch, supercic.sch]
2010-07-05 mic23250 test pcb
    [$savepcb.brd, mic23250.brd, mic23250.sch]
2010-07-05 cs4344 test pcb
    [cs4344.brd, cs4344.sch]
2010-07-20 update 1chip 50/60 schematic
    [1chip-5060.sch]
2010-07-23 SuperCIC lock: reset doubletap
    [supercic-lock.asm]
2010-07-23 pcb wip (final?)
    [$savepcb.brd, fpga.sch, mcu.sch, memory.sch, pwr_misc.sch, sd2snes.brd, sd2snes.sch, snesslot.sch]
2010-07-26 new SD card socket, 3M part was discontinued
    [sd2snes.brd]
2010-07-26 pcb wip (new SD card slot: Hirose DM1AA)
    [$savepcb.brd, sd2snes.brd]
2010-07-26 pcb wip (final?!)
    [$savepcb.brd, sd2snes.brd]
2010-07-28 pcb wip (snes sysclk to clk buffer)
    [$savepcb.brd, fpga.sch, mcu.sch, memory.sch, pwr_misc.sch, sd2snes.brd, sd2snes.sch, snesslot.sch]
2010-07-28 pcb wip (resistors for FPGA JTAG)
    [$savepcb.brd, fpga.sch, mcu.sch, memory.sch, pwr_misc.sch, sd2snes.brd, sd2snes.sch, snesslot.sch]
2010-07-30 pcb wip (redo switcher circuit)
    [$savepcb.brd, sd2snes.brd]
2010-07-31 pcb wip (change zone spacing)
    [sd2snes.brd]
2010-08-02 pcb wip (USB resistors)
    [$savepcb.brd, fpga.sch, mcu.sch, memory.sch, pwr_misc.sch, sd2snes.brd, sd2snes.sch, snesslot.sch]
2010-08-03 pcb wip (dummy)
    [fpga.sch, mcu.sch, memory.sch, pwr_misc.sch, sd2snes.sch, snesslot.sch]
2010-08-03 pcb wip (cleanup silk screen)
    [fpga.sch, mcu.sch, memory.sch, pwr_misc.sch, sd2snes.brd, sd2snes.sch, snesslot.sch]
2010-08-04 pcb wip (relabel components)
    [$savepcb.brd, fpga.sch, mcu.sch, memory.sch, pwr_misc.sch, sd2snes.brd, sd2snes.sch, snesslot.sch]
2010-08-05 pcb Rev.A finished
    [$savepcb.brd, fpga.sch, mcu.sch, memory.sch, pwr_misc.sch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]
2010-09-06 new rev.B, several fixes
    [fpga.sch, mcu.sch, memory.sch, pwr_misc.sch, sd2snes.brd, sd2snes.sch, snesslot.sch]
2010-09-06 archive Rev.A
    [fpga.sch, mcu.sch, memory.sch, pwr_misc.sch, sd2snes.brd, sd2snes.sch, snesslot.sch]
2010-09-06 begin ARM firmware
    [flash.cfg, lpc1754.cfg]
2010-09-07 Rev.B WIP
    [fpga.sch, mcu.sch, memory.sch, pwr_misc.sch, sd2snes.brd, sd2snes.sch, snesslot.sch]
2010-09-16 mk2 fw wip
    [lpc1754.cfg]
2010-09-16 Rev.B PCB WIP
    [fpga.sch, mcu.sch, memory.sch, pwr_misc.sch, sd2snes.brd, sd2snes.sch, snesslot.sch]
2010-11-23 SD native write support (still needs error handling), DB creation update (display file sizes)
    [config.h, ff.c, filetypes.c, fpga_spi.c, fpga_spi.h, main.c, sdnative.c, snes.c]
2010-12-05 LED PWM
2010-12-12 SD DMA, early status messages, DAC
2010-12-18 mk2 Rev.B pcb wip
    [fpga.sch, mcu.sch, memory.sch, pwr_misc.sch, sd2snes.brd, sd2snes.sch, snesslot.sch]
2010-12-29 MSU1 video player frame rate support
2010-12-31 memory access bugfix (broke resetting after MSU1 usage)
    [avr_cmd.v, cli.c, config.h, fpga_spi.c, main.c, memory.c, snes.c, snes.h]
2010-12-31 MSU1 video player update (framerate support)
    There is now a small header for the MSU video files:
    uint16_t framecount;
    uint8_t std_frameduration;
    uint8_t alt_frameduration;
    uint8_t alt_durfreq;
    framecount is the number of frames in the video.
    std_frameduration is the usual duration of a video frame in SNES video frames.
    alt_frameduration is an alternate duration
    alt_durfreq specifies after how many frames the alternate duration should be used for a single video frame. The frame counter is reset afterwards.
    This allows to use simple pulldown patterns.
    e.g. for a 29.97fps video you need 2:2 pulldown (display every video frame for two SNES video frames).
    In this case, std_frameduratio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
2011-01-06 Mk.II PCB Rev.B RC
    [fpga.sch, mcu.sch, memory.sch, pwr_misc.sch, sd2snes.brd, sd2snes.sch, snesslot.sch]
2011-01-07 Mk.II PCB Rev.B RC2
    [fpga.sch, mcu.sch, memory.sch, pwr_misc.sch, sd2snes.brd, sd2snes.sch, snesslot.sch]
2011-01-07 Mk.II PCB Rev.B RC2 Gerber files
    [sd2snes-Component.gtl, sd2snes-Copper.gbl, sd2snes-Mask_Back.gbs, sd2snes-Mask_Front.gts, sd2snes-PCB_Edges.gbr, sd2snes-SilkS_Back.gbo, sd2snes-SilkS_Front.gto, sd2snes-noplate.drl]
2011-01-14 Mk.II Rev.B RC3 (add bypass caps, S/N field)
    [fpga.sch, mcu.sch, memory.sch, pwr_misc.sch, sd2snes.brd, sd2snes.ods, sd2snes.sch, snesslot.sch]
2011-01-16 Mk.II Rev.B logo artwork
    [sd2snes.brd, sd2snes.ods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]
2011-02-02 kicad libs update
2011-02-02 begin Rev.C (cheaper SRAM, one less BGA part)
    [fpga.sch, mcu.sch, memory.sch, pwr_misc.sch, sd2snes.brd, sd2snes.sch, snesslot.sch]
2011-02-04 MkII Rev.C PCB WIP (inverse polarity protection)
    [fpga.sch, mcu.sch, memory.sch, pwr_misc.sch, sd2snes.brd, sd2snes.sch, snesslot.sch]
2011-02-04 kicad libs update (CY62158EV30, TSOPII-44 (not used...))
2011-02-07 firmware: initial power management
2011-02-08 PCB: Rev.C alternatives (for reference only)
    [$savepcb.brd, fpga_62148.sch, fpga_62158.sch, memory_62148.sch, memory_62158.sch, sd2snes_62148.brd, sd2snes_62158.brd]
2011-02-08 PCB: Rev.C RC1
    [fpga.sch, mcu.sch, memory.sch, pwr_misc.sch, sd2snes.sch, snesslot.sch]
2011-02-12 FPGA: RTC fixes + calculate day of week
    [bsx.v, main.v, rtc.v]
2011-02-17 firmware: bootloader with firmware upgrade
    [erase.cfg, flash.cfg, lpc1754.cfg]
2011-02-19 PCB: Mk.II Rev.C finalized and ready for prod
    [$savepcb.brd, fpga.sch, mcu.sch, memory.sch, pwr_misc.sch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]
2011-02-22 Firmware: reduce bootloader size (8k), LED error codes
    [config.h, crc32.c, crc32.h, faulthandler.c, ff.c, ffconf.h, fileops.c, iap.c]
2011-03-14 FPGA: fix BS-X mapping, S-RTC interface
    [address.v, main.v, mcu_cmd.v, rtc.v, srtc.v]
2011-04-10 firmware: fix early status messages
    [fileops.c, main.c, memory.c, snesboot.h]
2011-04-10 PCB: add RAs in SNES bus
    [$savepcb.brd, fpga.sch, mcu.sch, memory.sch, pwr_misc.sch, sd2snes.brd, sd2snes.sch, snesslot.sch]
2011-04-25 PCB: separate GND for DAC
    [$savepcb.brd, fpga.sch, mcu.sch, memory.sch, pwr_misc.sch, sd2snes.brd, sd2snes.sch, snesslot.sch]
2011-04-25 PCB: update libs (add 0804 RA)
2011-04-25 PCB: update TODO list; use relative library path
    [fpga.sch, mcu.sch, memory.sch, pwr_misc.sch, sd2snes.sch, snesslot.sch]
2011-05-30 uPD77C25 (DSP1-4) (preliminary) (missing source)
    [upd77c25.v]
2011-06-11 Firmware: uPD77c25 program download, reset
    [config.h, fpga_spi.c, fpga_spi.h, iap.c, led.c, main.c, memory.c, memory.h]
2011-06-11 FPGA: add test fixtures
    [main_tf.v]
2011-06-16 FPGA: Fix upd77c25 for 1chip consoles
    [address.v, main.v, upd77c25.v]
2011-06-16 Firmware: add SNES reset CLI command
    [cli.c]
2011-06-16 PCB: add GPIO header
    [$savepcb.brd, fpga.sch, mcu.sch, memory.sch, pwr_misc.sch, sd2snes.brd, sd2snes.sch, snesslot.sch]
2011-06-16 PCB: add changes missing from previous commit
    [sd2snes.brd]
2011-06-19 FPGA: peripheral enable switch, SRAM access inhibit for games with no SaveRAM
2011-06-20 Firmware: ST0010 support + peripheral enable switches
2011-06-22 FPGA: fix ST0010 glitches
    [address.v, upd77c25.v]
2011-07-03 PCB: Rev.D - GPIO port, add mechanical compatibility with non-customchip cases
    [fpga.sch, mcu.sch, memory.sch, pwr_misc.sch, sd2snes.brd, sd2snes.sch, snesslot.sch]
2011-07-05 PCB: Rev.D minor cleanups
    [sd2snes.brd]
2011-08-16 Firmware: re-enable bootloader logging
    [lpc1754.cfg]
2011-08-16 Firmware/build: Be more OpenOCD 0.4.0 friendly
    [lpc1754.cfg]
2011-08-16 PCB: Rev.E
    [fpga.sch, mcu.sch, memory.sch, pwr_misc.sch, sd2snes.brd, sd2snes.sch, snesslot.sch]
2011-08-16 PCB/Libs: add some voltage regulators (unused)
2011-08-30 firmware/bootloader: prevent premature entry of SuperCIC pair mode
    [main.c]
2011-08-30 firmware/bootloader: be more OpenOCD 0.4.0 friendly
    [lpc1754.cfg]
2011-10-07 FPGA: sync SPI to external SCK (allow 48MHz SCK)
2011-10-07 FPGA: rework shared memory access
    [address.v, dcm.v, main.v, mcu_cmd.v]
2011-10-08 FPGA: replace unneeded MCU_OVR signal
    [address.v, main.v]
2011-10-08 Firmware/SPI: move status register bit constants to spi.h
2011-10-08 Firmware/CIC: do more to prevent unsolicited pair mode entry
    [main.c]
2011-10-08 Firmware: correct LED PWM initialization
    [led.c]
2011-10-09 FPGA: clean up (port size mismatches, unused regs/wires, ...)
2011-10-09 Firmware: clear has_msu1 flag on ROM load (fixes SaveRAM polling after reset)
    [memory.c]
2011-10-10 Add DIP36 footprint (not used)
2011-10-13 FPGA: prevent erasure of first ROM byte on reconfiguration
    [sd_dma.v]
2011-10-23 FPGA/cx4: rework CPU FSM (ALU still missing)
    [cx4.v]
2011-10-29 FPGA/Cx4: fully operational except reset vector area
    [cx4.v, main.v]
2011-11-01 FPGA/cx4: implement reset vector access
    [address.v, cx4.v, main.v]
2011-11-01 FPGA/cx4: fix memory sharing
    [main.v]
2011-11-10 firmware, FPGA: fix for some SD cards
    [sd_dma.v, sdnative.c]
2011-11-10 firmware: fix db entry linking on bank switch
    [filetypes.c]
2011-11-10 FPGA: fix occasional erroneous write inhibit
    [main.v]
2011-11-10 PCB Rev.E: add BOM
    [sd2snes-BOM-with-supplier.ods]
2011-12-02 PCB/Rev.E: component layout diagrams
2011-12-02 PCB/Rev.E: update schematic, PCB and component diagram with recent changes
    [fpga.sch, mcu.sch, memory.sch, pwr_misc.sch, sd2snes.brd, sd2snes.sch, snesslot.sch]
2011-12-18 SuperCIC/key: fix unreliable pair mode entry (sync with lock)
    [supercic-key.asm]
2011-12-19 Firmware: add test suite
    [flash.cfg, lpc1754.cfg, reset.cfg]
2011-12-27 PCB: Rev.E2 (replace elusive Micrel regulator)
    [fpga.sch, mcu.sch, memory.sch, pwr_misc.sch, sd2snes.brd, sd2snes.sch, snesslot.sch]
2011-12-27 PCB: very basic solder paste pad reduction script
2012-01-02 SNES: insert debug marker
2012-01-10 PCB Rev.E: update BOM (-> RA103, RA104 pending)
    [sd2snes-BOM-with-supplier.ods]
2012-01-13 PCB Rev.E: update BOM (RA103, RA104 final)
    [sd2snes-BOM-with-supplier.ods]
2012-01-14 Firmware/bootldr: size reduction and stability measures
    [clock.c, config.h, ffconf.h, iap.c, timer.c, uart.c]
2012-01-14 Firmware: optimize non-sector-aligned SD DMA reads
2012-01-14 FPGA: optimize non-sector-aligned SD DMA reads
2012-01-14 FPGA/Cx4: optimize non-sector-aligned SD DMA reads
2012-01-14 SNES menu: swap A and B buttons
2012-01-14 Firmware: optimize non-sector-aligned SD DMA reads (bugfix)
    [ff.c, sdnative.c]
2012-01-14 PCB: Rev.E2 WIP
    [fpga.sch, mcu.sch, memory.sch, pwr_misc.sch, sd2snes.brd, sd2snes.sch, snesslot.sch]
2012-01-14 PCB: update Rev.E assembly diagrams
2012-02-27 bootldr: properly chain from vector table entry
2012-02-29 firmware: add some FPGA sanity checks; fix led_panic behavior
    [fpga.c, led.c]
2012-02-29 firmware: query reset button in timer ISR
2012-02-29 firmware/timer: move constants to header files
2012-02-29 PCB/Rev.E: minor updates
    [sd2snes.brd]
2012-02-29 PCB: Finalize Rev.E2
    [sd2snes.brd]
2012-04-16 add missing files cfg.[ch] and sysinfo.[ch]
    [cfg.c, cfg.h, sysinfo.c]
2012-05-02 PCB: add logo to Rev.E2
    [sd2snes.brd]
2012-05-02 FPGA/Cx4: introduce wait states (fix MMX2 attract mode)
    [cx4.v]
2012-05-02 FPGA: slightly tighten timing constraints
2012-05-02 Firmware: add words of wisdom in README after switching from Ubuntu to Fedora Core ;-)
2012-05-02 Firmware: set BS region override correctly
    [smc.c]
2012-06-09 firmware: case-insensitive system directory hiding
2012-06-09 firmware: fix sort order (force parent dir at top of list)
    [sort.c]
2012-06-10 firmware: adjust SNES reset pulse
    [main.c]
2012-06-10 firmware/SPC: zero echo buffer to avoid artifacts
    [memory.c]
2012-06-10 firmware: correct number of files/dirs in system information
    [filetypes.c]
2012-06-10 FPGA/embedded config: slightly tighten timing constraints
2012-06-10 firmware: change filesystem footprint calculation (order of files doesn't matter)
    [filetypes.c]
2012-06-10 firmware: speedup filesystem footprinting
2012-07-01 Firmware: refactor SNES reset pulse
    [cli.c, main.c, memory.c, snes.c, snes.h]
2012-07-01 Firmware: remove SPI speed switching
2012-07-01 Firmware: load database using DMA
2012-07-01 Firmware/SD: implement FatFs CTRL_SYNC ioctl (issue #4)
    [diskio.h, sdnative.c, sdnative.h]
2012-07-01 Firmware: Change ROM size detection for broken headers
    [smc.c]
2012-07-03 menu: speed up print routine, move tilemap buffers to bank $7E
2012-07-03 menu: remove redundant code from DMA macro
2012-07-05 Correct baudrate on normal application.
    [config.h]
2012-07-08 Firmware: adjust to SPI changes
2012-07-08 FPGA: simple SNES address input filtering
2012-07-08 FPGA/sd2sneslite: add missing file mcu_cmd.v; remove avr_cmd.v
    [avr_cmd.v, mcu_cmd.v]
2012-07-09 FPGA/BSX: fix checksum registers
    [bsx.v, main.v]
2012-07-09 FPGA: debug wires
2012-07-09 FPGA: rework shared memory access FSM
    [cx4.v, main.v]
2012-07-09 FPGA/SPI: detect end of byte via MSB toggle instead of constant compare of async input
2012-07-09 FPGA: implement MSU1 "audio error" status bit
    [msu.v]
2012-07-09 FPGA/SDDMA: fix clock glitch, adjust RAM write timings
    [sd_dma.v]
2012-07-09 Firmware: do not turn off write LED in case of periodic SRAM saving
2012-07-14 menu: fix DMA initialization (sprite glitches in some games)
2012-08-06 PCB/Rev.E2: Add BOM
    [sd2snes-bom.ods]
2012-09-24 menu: fix #26: first note cut off on S-APU SNESes
2012-11-07 Firmware: fix compile errors with newer gccs
    [cli.c, filetypes.c, memory.c, msu1.c]
2012-11-07 Firmware/CLI: list short file name and file size in ls command; print file name when saving SRAM
    [cli.c, snes.c]
2012-11-07 Firmware: clean up clock/timer init
2012-11-07 Firmware/FPGA: replace magic numbers with constants
    [fpga_spi.c, fpga_spi.h, msu1.c]
2012-11-07 Firmware: fix MSU1 main loop behaviour
    [main.c]
2012-11-07 Firmware: fix big SRAM handling
    [smc.c]
2012-11-07 FPGA: add BS-X "hole" (regs 09-0b)
2012-11-18 FPGA: fix large SRAM mapping
    [address.v]
2012-11-18 Firmware: fix FPGA DMA call
    [fpga_spi.c]
2013-06-26 FPGA: fix BSX PSRAM mapping
    [address.v]
2013-06-30 Correct LoROM SRAM mapping for smaller ROMs
    SRAM is sometimes mapped not just to 70:0000-7fff but also to
    70:8000-ffff if ROM size permits it (i.e. the ROM is small enough
    to avoid overlap).
    Map SRAM to 8000-ffff if the ROM mask denotes a ROM <= 16 MBits.
    [address.v]
2013-10-18 Bootloader: fix flash buffer alignment
    [fileops.h, iap.c]
2013-10-18 Firmware: timeouts for FPGA configuration; LED flash codes for various FPGA related errors
    [fpga.c, led.c, led.h, main.c]
2013-10-18 Adjust OpenOCD configuration for more recent versions
    [lpc1754.cfg]
2013-10-18 Firmware: fix loading of partial-size BS dumps
    [memory.c, smc.c, smc.h]
2014-03-21 firmware: properly initialize Save RAM area
    The need to save is determined based on a CRC change of the contents of the save RAM area.
    However the first CRC sample was taken shortly after running the console. Thus, if software writes to save RAM very early we won't notice.
    Save RAM is now zeroed before attempting to load an existing SRM file and the initial checksum is taken BEFORE running the game.
    [memory.c, snes.c]
2014-05-10 Firmware: fix mapper scoring (wrong header offsets in one part)
    [smc.c]
2014-05-14 revert some whitespace (actually tab) damage
    [fpga_spi.c, main.c, memory.c, sdnative.c, snes.c]
2014-05-14 update KiCAD modules
2014-05-15 Firmware/diagnostics: commit some changes that added up over time * Match clock speeds * Add SD DMA test * Match baud rates * update FPGA interface
2014-05-17 reliable detection of igrs dbl reset using snes_reset(int state)
    [snes.c]
2014-06-17 firmware/bootloader: properly flush UART (bootldr doesn't use IRQ because it throws off IAP functions)
    [uart.c]
2014-06-19 menu/bootscreen: do not init unused DMA registers
2014-06-19 menu: disable NMI early; switch to FastROM in a single place
2014-07-27 menu: L+R buttons to move to top/botton of file list; snap to end of list on page browsing
2014-08-05 Firmware: SNES in-game command interface; on-demand-only early FPGA config (error msg)
    [fpga.c, fpga_spi.c, fpga_spi.h, main.c, memory.c, memory.h, sdnative.c, snes.c]
2014-08-05 Firmware: LED blink codes for file system errors; retry saving on error
    [led.c, led.h, memory.c, snes.c, timer.c]
2014-08-05 Firmware: correct error constant value
    [memory.c]
2014-08-05 FPGA: fix BS-X/Satellaview support for new memory sharing
    [address.v, bsx.v]
2014-08-07 Small refactoring on uIGR-code: - general improvement: - change to S-CIC-mode with reset button iff S-CIC changes his mode (in pairmode a manual longreset does not force the uIGR switching to S-CIC-m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
2014-09-18 Move status line up a few pixels
    The status line (currently displaying button mapping and clock) is moved
    up a bit to avoid cutoff due to overscan
2014-09-18 minor menu handshake corrections
    [memory.c]
2014-09-18 Firmware: support on-the-fly card swapping
    [fileops.c, main.c, sdnative.c, timer.c, timer.h]
2014-09-18 Firmware: fix on-demand early FPGA configuration from second boot onward
    [main.c]
2014-09-18 Embed table ROM in Cx4 core (cx4.bin no longer required);
    Add long missing mcu_cmd.v to cx4 tree
    [cx4.v, main.v, mcu_cmd.v, memory.c, smc.c, smc.h]
2014-09-18 Firmware: install NMI hook, deploy cheats, add button for temp hook kill
    Introduce another button combination to temporarily (~10s) kill the NMI
    hook routine. Some games have certain passages where the NMI routine
    introduces glitches.
    [memory.c, memory.h, snes.c, snes.h]
2014-09-18 FPGA: new memory sharing for all sub configurations; Cx4 speed switch
2014-09-19 fix mapper detection for 96Mbit SO
    [smc.c]
2014-09-24 in game hook optimizations/fixes (space, time, realtime vectors)
    Original ROM vectors are now determined at runtime by momentarily
    disabling the vector patching and copying them to the jump statements.
    To potentially save raster time, joypad is not read manually when auto
    joypad read is in place - the results of auto joypad read are used
    instead.
    Also controller is only read every 8 hook calls to further improve
    compatibility.
    Addresses are adjusted for space optimizations.
    [cheat.v, snes.c, snes.h]
2014-09-24 make cfg struct packed (to make cfg file size match number of fields);
    revert to defaults on version mismatch
    (fix accidentally disabled region patching on upgrade)
    [cfg.c, cfg.h]
2014-09-24 BSX: fix PSRAM mapping, emulate Type 1 memory pack instead of Type 2
    A bug in the BS-X BIOS keeps it from working with HiROM games marked as
    "run from PSRAM" used together with Type 2 memory packs. Thus memory
    pack Type 1 is now used (different command set).
    PSRAM was incorrectly mirrored to banks 00-3f in HiROM mode.
    [address.v, bsx.v, cli.c]
2014-09-24 Add missing cheat.v for cx4 and obc1
    [cheat.v]
2014-09-24 FPGA: Auto-choose NMI/IRQ vector depending on usage by SNES;
    also do not switch vector patching while vectors are being read
2014-10-07 Implement temporary hook disable after SNES reset
    As was observed with the help of a number of users, many games trip over
    the in-game hooks especially at boot-up. This feature keeps the hooks
    disabled for 10 seconds after SNES startup or reset.
    [cheat.c, cheat.h, cheat.v]
2014-10-07 FPGA: reconstitute more aggressive SNES control signal filtering; unify edge detection and data buffering
2014-10-17 Fix BSX detection for games with 2 startups left
    "0x8c" was missing in the list of valid startup codes.
    [smc.c]
2014-10-17 fix directory browsing after setting the clock.
    properly mask cwd address to 24 bits
    [main.c]
2014-10-17 lazy FPGA reconfiguration
    save a couple of ms on warm reset if the FPGA does not need to be
    reconfigured.
    [fpga.c, fpga.h, main.c, smc.c, smc.h]
2014-10-17 only load configuration on initial powerup
2014-10-17 FPGA/DSPx: fix MMIO write priority
    [upd77c25.v]
2014-10-21 Reduce number of polls at the reset line dramatically
    [snes.c]
2014-10-22 "de-initialize" DMA channel 0 target after WRAM pre-game init
    This actually triggered a sort of copy protection scheme by performing
    DMA to an uninitialized destination address (by game code), which in
    fact WAS initialized by the sd2snes menu, overwriting WRAM data
    including the stack.
2014-12-08 MSU1: make sure to stop audio playback on reset
    Users reported static noise after soft resetting MSU software
    [main.c, msu1.c]
2014-12-08 No longer manually process medium change in cli
    Medium change is now handled properly by disk_status/fatfs
    [cli.c]
2014-12-09 Print card space usage on system information screen
2015-02-01 Update OpenOCD config (ft2232 driver is deprecated)
    Use the ftdi driver instead. Makes programming twice as fast as a neat
    side effect.
2015-02-01 in-game hooks: more time efficient Auto Joypad Read snooping
    This is a bit of a fire-and-forget strategy. After NMI/IRQ read the AJR
    result register as fast as possible to catch the readout from last
    frame.
    In some occasions AJR has already JUST started (its starting point is
    variable) in which case the readout is #$0000. For IRQ hooks this might
    lead to unusable readouts depending on the time of the IRQ.
    Also don't compare controller button mappings when no buttons are
    pressed.
2015-02-01 in-game hooks: replace WRAM cheat loop with rolled-out patching code
    MCU fills the WRAM patch area with CPU code instead of just the patch
    addresses+data. That way no controlling loop is necessary to apply the
    WRAM patches, it can just be executed. Results in faster WRAM patching.
    [cheat.c, cheat.h, snes.h]
2015-02-15 Add PCB Rev.F
    [fpga.sch, mcu.sch, memory.sch, pwr_misc.sch, sd2snes.kicad_pcb, sd2snes.sch, snesslot.sch]
2015-04-16 MSU1/video demo: Do not init DMA (due to the known effects)
    SNES likes to omit subsequent DMA transfers at random when you
    initialize DMA channels but never use them and then reset the console.
    So do not init any DMA channels anymore.
2015-04-28 menu/NMIHook: remove no longer used controller read skip
    [snes.c, snes.h]
2015-04-28 FPGA: change address sampling to obtain valid address on cycle end
    This makes the old MSU address increment work again and hopefully fixes
    stability problems that occurred since 0.1.7pre1.
    [main.v, msu.v]
2015-04-28 firmware: back to 921600bps for UART
    uploading at 115200 is a pain
2015-04-28 firmware/msu1: properly re-initialize page pointers after reset
    Avoid extra unnecessary reads
    [msu1.c]
2015-04-28 firmware: fix reset state polling (no long delays)
    Fixed MSU1 performance issues
    [snes.c]
2015-05-01 Prefer an asynchronous /rst-rst polling iff a reset from somewhere else was detected
    [snes.c, snes.h]
2015-05-01 make sure that ‚banksel‘ takes two cycles where needed Some assemblers make one instruction out of the ‚banksel‘ for the PIC 12F629. However, the code assumes two cycles. The initialization of the CI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
    (banksel not bangels :P - stupid spelling-correction in commit 7b36cb22dd6b84255981ab42f27bbd6a2e43ec45)
    [snescic-key.asm, snescic-lock-resync.asm, snescic-lock.asm]
2015-05-05 Small refactoring on the reset routine Now it should be more intuitive to read and understand ‚what happened when?‘
    [snes.c]
2015-07-09 add button combinations for locking the uIGR (German file was wrong)
2015-07-09 remove firmware.img with ‚make clean‘ to have the obj/-folder completely empty before removing it
2015-08-02 finish YAML parser for cheats, load+save cheat YML
    It is now possible to load cheat files from
    /sd2snes/cheats/<romname>.yml. Files will be re-saved in a unified
    format.
    GUI portion is still missing.
    [cheat.c, cheat.h, fileops.c, fileops.h, memory.c, yaml.c, yaml.h]
2015-08-03 Add Rev.F BOM
    [sd2snes-BOM.ods]
2015-08-06 backup the current uIGR code (code update pending)
2015-08-06 code update for uIGR: improved data sampling, combined code for with(out) lock option - data sampling on falling clock edge - last value taken right before the edge detection - support of third party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
    This update is due to some reports of problems with party controllers. This is hopefully solved now.
    [snes_uigr_684.asm]
2015-08-06 remove typo in folder name -> I’m sorry for that
    Here are the notes of the previous commits:
    commit 41d85e28890731e06d1495eed0f4f24300a77c20
    >>
    code update for uIGR: improved data sampling, combined code for with(out) lock option
    - data sampling on falling clock edge
    - last value taken right before the edge detection
    - support of third party controllers like micros UWRC(V2)
    - a few minor improvements
    <<
    commit f2a76be145c031ab8c194e4ace9dc48d728cfdeb
    >>
    move uIGR manuals to the uIGR-folder
    <<
    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
    [snes_uigr_684.asm]
2015-08-07 Minor improvement I forgot about the SGB support. With the SGB specific controller reading the validity test fails if RAIF is cleared after the reading button B.
    [snes_uigr_684.asm]
2015-08-12 Some adaptations for Ultra16 - show firmware version in ROM-name - change ROM-region to USA (Ultra16 in shown in ROM-region if ‚Auto‘ is the selected video mode)
2015-08-13 upgrade FatFS version; do not rely on FSINFO block for free clusters
    FatFS version upgraded to 0.11 to make use of the NOFSINFO option. Free
    space calculation depended on the FSINFO block before, sometimes giving
    incorrect results. With NOFSINFO the FatFS driver performs a full FAT
    scan to determine free disk space. (can be slow on huge cards but is
    only used in the system information screen anyway)
    Also some potential file system corrupting bugs were fixed in FatFS in
    the meantime.
    [diskio.h, ff.c, ff.h, ffconf.h, fileops.c, sdnative.c, sdnative.h]
2015-08-13 CLI: reset errno before calling strtoul
    Function parse_unsigned actually uses errno so it should be cleared
    beforehand.
    [cli.c]
2015-08-13 Heed user settings for IRQ hooks, in-game buttons, and hook holdoff
2015-08-13 Whoops, forgot something from the "enable in-game buttons" commit
2015-08-13 Create new romname.yml instead of softfail: Soft fail to suppress LED blink does not work for me (borti4938). I simply create a new file if sd2snes/cheats/romname.yml while loading if the file does n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
    [cheat.c, yaml.c]
2015-08-13 Soft fail in cheat_yaml_load: Back to Ikair’s implementation. The LED constantly blinks if the directory /sd2snes/cheats/ does not exist. Maybe one should think about a test of directory existence.
    [cheat.c, yaml.c]
2015-08-14 Set CFG.num_recent_games on first boot. Due to the new introduced config.yml, which does not include the num_recent_games, the list of recent games was not present as long as no game was startet (com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
2015-08-29 Correct BOM for Rev.F (FB391 -> L391, correct package for resistor arrays)
    [sd2snes-BOM.ods]
2015-08-29 Sample SNES data input to reliably get valid data on writes
2015-09-03 Reorder DMA channels, avoid SNES DMA bug, reintroduce DMA init
    This fixes sprite corruption on some consoles again (#61). Re-ordering
    channels makes the explicit "de-init" of channel 0 obsolete (previously
    introduced in 3f5a18d).
    Also rename two HDMA data tables to be more descriptive.
2015-09-07 Init APU RAM to "known good" state
    Soul Blader's title tune plays incorrectly on some consoles (not only
    1CHIP contrary to popular belief) due to the player routine relying on
    uninitialized RAM.
    The APU RAM is now filled with a pattern resembling that of a console
    where playback was found to work well (an SNES with S-SMP/S-DSP on
    board, using 2x SHARP LH5P832N-12 SRAMs with Date Code 9115).
2015-09-20 [TEST] extend reset time if Autoboot of U16 is enabled The Ultra16 has an Autoboot option. If this option is enabled, the BIOS menu is skipped and the game is directly started. By pressing a certain 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
    [main.c, memory.c, snes.c, snes.h, sysinfo.c]
2015-09-22 First draft of the MSU-1 resume prototype on the SD2SNES, not tested because I can't get the firmware to link on either Linux or OS X
2015-09-27 Again an update for the controller reading strategy back to the roots, data clock is now used as follows: - use interrupt on falling edge for changing the button bit - sample ~1.5us after rising edge
2015-10-08 Huge code clean up with minor improvements: - clean up code - set interrupt flags on demand - start controller reading using global interrupt - revert small mistake introduced with last commit at pre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
    [snes_uigr_684.asm]
2015-10-08 increase reset time (U16, Autoboot enabled) on startup only if it is not the first boot
    [main.c]
2015-10-15 Describe how to use an alternative gcc-arm-none-eabi compiler
2015-10-18 removing bugs: - Auto Mode with SuperCIC detection (line 910 and below) - delay_05ms caused NTSC mode (line 1004)
    [snes_uigr_684.asm]
2015-10-18 remove SuperCIC code for PIC 16F676 I don’t know the reason why the PIC changes the state at pin 3 (cartridge region) while changing between the modes (recognized with PAL cartridges).
2015-10-20 menu: tweak DMA init again
    This hopefully fixes all uninitialized DMA issues with games (Nightmare
    Busters, Pocky & Rocky US) while also not causing sprite issues with
    SGnG and SSF2.
2015-10-22 Replace ALL ‚banksel’ instructions with bcf/bsf STATUS, RP0 and a nop. SuperCIC-lock can be compiled for the PIC16F676 by setting the flag use_16f676. This commit is related to commits 7b36cb22dd6b84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
    [snescic-key.asm, snescic-lock-resync.asm, snescic-lock.asm, supercic-key.asm, supercic-lock.asm]
2015-10-22 Add ‚last modified‘ note
2015-10-22 Precompiled GCC-ARM-NONE-EABI V4.9 tested on MacOSX 10.11
2015-11-15 Same uIGR version as in the upper folder, but with other startup defaults: - 60Hz, Reg.Patch off, Reg.Timeout on
2015-11-15 [U16] do not show the sd2snes in 60Hz in U16 consoles (reverts commit 998ae8a43d93057311e15979bd10c98e78f3752d); switch off the U16’s region patch
2015-11-26 update diagnostic firmware source
    [lpc1754.cfg]
2015-12-18 support of retro-bit wireless controllers and minor updates - details can be found here: - 20c10b01674433d3d994b37fbc8ccf8563cb8018 - d44f9097eb5de53e074ba6f4d0f867c5054625d6 - d444092f6ad2f6f32ac510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
2015-12-18 remove .DS_Store with ‚make clean‘
2015-12-18 Revert a ‚stupid’ mistake which stops assembly with zero program code lines. I’m really sorry for that!!!
    [snes_uigr_684.asm]
2016-01-26 Fix a small type in config file generation
    [cfg.c]
2016-02-11 Validity check to the recent games list on each power cycle. This commit tackles issue #68.
    [cfg.c, cfg.h, main.c]
2016-02-12 print correct srm-file; changed due to common saves-folder
    [memory.c]
2016-02-16 Do not use LED PWM mode unnecessarily
2016-02-16 Fix order of time records wrt SNES interworking
    [rtc.c, snes.c]
2016-02-19 Update CIC pseudocode to reflect current state
2016-02-22 Declare "Rev.F" in BOM for Rev.F
    [sd2snes-BOM.ods]
2016-02-22 update misc KiCAD files
2016-02-22 bootldr: update OpenOCD config files
    [lpc1754.cfg]
2016-02-22 FPGA: fix MSB truncation of MSU status
    [msu.v]
2016-02-23 Add missing MSB of MSU status
    [msu.v]
2016-02-23 add missing crc16.c and crc16.h in src/tests/
    [crc16.c, crc16.h]
2016-03-21 backup lastfile.cfg on startup (just in case new file is corrupted) Actually a friend and I had a case where at least one of the ‚new’ was written as „??????????“ but I wasn’t able to reconstruct tha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
2016-03-30 Fix load_sram regression (move file migration outside)
    load_sram is a generic function to load a file to the sd2snes onboard
    RAM (which was SRAM in Mk.I)
    Move file migration outside the function so loadraw works again from the
    CLI.
    [memory.c, memory.h]
2016-04-01 DAC: improve audio quality (nearest neighbor -> CIC filter), fix playback rate
    [dac.v, main.v]
2016-04-01 fix save_sram regression (see 5f76cea)
    There is now an ugly name collision (save_sram and save_srm) so the
    "sram" names will like be renamed "memory" or similar in the future.
    [memory.c, memory.h, snes.c]
2016-04-14 fix early boot message display
    [snes.c]
2016-04-15 Fix ROM corruption (ROM gets overwritten with save data)
    [memory.c]
2016-04-17 Make more room for fadeloop/de-init and fix truncation
    Fadeloop grew with the new DMA de-init and was not copied to BRAM
    completely. This resulted in a deadlock when running certain sequences
    of ROMs.
2016-04-17 Fix garbled BS-X default time entry
    Date record was backwards.
    [cfg.c]
2016-04-17 Fix wrong data type for auto region patch setting (value didn't save correctly)
    [cfg.c]
2016-04-18 Init BS-X mapper to power-on state after soft reset
    [memory.c]
2016-04-18 Reset DAC filter state on soft reset
    [main.c]
2016-04-23 Avoid filename corruption from CLI usage
    [cli.c]
2016-04-23 rework external DAC control (play+reset)
    [dac.v, fpga_spi.c, main.c, mcu_cmd.v, memory.c]
2016-04-23 Discard superfluous registers in DAC interpolation filter
2016-04-23 Remove obsolete OBC1 enable flag (resolve #73)
    [address.v]
2016-06-23 Create required folders on demand
    Instead of failing silently, create /sd2snes/saves and /sd2snes/cheat if
    they are missing.
    [cheat.c, fileops.c, fileops.h, memory.c]
2016-06-23 Prevent flickering letters on system information screen
    [sysinfo.c]
2016-06-23 New option: hide file extensions in browser
    currently ineffective on recent games list
2016-06-23 MSU1: avoid missed control register reads on rapid rewrites
    [msu1.c]
2016-06-23 Fix DSP1 HiROM detection
    Fix Ballz 3D (Japan)
    [smc.c]
2016-08-10 Revised in-game hook (SNES+firmware side)
    * implicit unlocking by FPGA (and by mapper ID for menu operation)
    * automatic return vector filling by FPGA, no more duplicate hooks
    * do not perform manual read when manual read in progress by game
    * map button combination -> command using FPGA (no costly loop in hook)
2016-08-16 Revised in-game hook (FPGA side)
    Significant improvements on the hook's CPU footprint and "stealthiness".
    * reset hook support
    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
    [address.v, cheat.v, fpga_spi.c, fpga_spi.h, main.v, memory.c]
2016-08-16 Cx4: make multiplier multicycle
    Also it doesn't seem to set any flags. This change relaxes place and
    route a bit.
    [cx4.v]
2016-09-13 Another in-game hook overhaul
    - Offload any flow control to FPGA to shave off some more CPU cycles
    - Blank screen on reset to menu to avoid graphical artifacts
    [address.v, cheat.c, cheat.h, cheat.v, main.v]
2016-09-13 Recent games: fix hard fault on long path names
    (read past mapped memory)
    [cfg.c, memory.c, memory.h]
2016-09-27 Fix lockup when disabling file ext. hiding and selecting a file without reload
    [snes.c]
2016-09-27 Fix hook/cheat flag init for new hooks
    [main.c]
2016-09-27 Fix BS-X PSRAM mapping (WRAM writes corrupt PSRAM)
    [address.v]
2016-09-27 Reset hook must only be unlockable right after system reset
    [cheat.v]
2016-09-27 Revert to previous I2S timing for DAC (hopefully helps with Rev.G issues)
    [dac.v]
2016-09-28 Inhibit "blind" hook area writes unless unlocked
    Magic value writes are no longer necessary for unlocking
    [main.v]
2016-09-28 Properly name ROMSEL signal, filter like other control signals
2016-09-28 Tweak Cx4 "normal" speed timing a bit
    Of course this is still off until the revised Cx4 core with the reverse
    engineered timings is done, the core was slowed down a bit too much with
    0.1.7c though.
    [cx4.v]
2016-09-28 Update embedded FPGA config with ROMSEL filtering
2016-10-03 Reset PPU2 H/V counter odd/even flag before launching game
    Soft reset does not reset this counter because PPU2 cannot be reset from
    the cartridge slot.
    This fixes games that rely on an initialized state of the $213c/$213d
    read counters (dual-read registers). Games leaving the read counter at
    the 2nd byte can break those. Notably this fixes Super Punch-Out when
    run after Fushigi no Dungeon 2: Fuurai no Shiren without power-cycling
    or hard resetting the SNES.
2016-10-03 Correct wrong USB connector in Rev.F BOM (fix #74)
    THT -> SMT
    [sd2snes-BOM.ods]
2016-10-24 MSU1: clear play/repeat flags on track change
2016-11-30 FatFS: fix a little code formatting quirk
    [ff.c]
2017-02-22 init SRAM to 0xff instead of zero
    fixes Ken Griffey Jr., Ou-chan, possibly other games that handle
    checksums badly
    [memory.c]
2017-03-09 MSU1 player: fix for SNES DMA/HDMA layout quirk
    Also output map files
2017-03-09 Fix DAC timing for Rev.E,F,H
    Previous fix for Rev.G broke timing for all other revisions resulting in
    nasty distortion. Hopefully still works with all Rev.Gs ;)
    [dac.v]
2017-03-09 MSU1: avoid unaligned SD reads (MCU side)
    (slight performance bump)
    [fpga_spi.c, fpga_spi.h, main.c, memory.c, msu1.c]
2017-04-30 Add a missing optimization for SD data streaming
    Transmission status was not set to TRANS_MID after the first partial
    read of a sector following a seek.
    Thus on reading after every seek one unnecessary stop and sector re-read
    was issued.
    [sdnative.c]
2017-04-30 MSU1: avoid unaligned SD reads (FPGA side)
    [dac.v, main.v, mcu_cmd.v]
2017-04-30 Fix SD clock glitch on FPGA->MCU handoff after partial DMA
    [sd_dma.v]
2017-04-30 Add missing change for eda3909
    [main.v]
2018-03-15 Fixed issues with breakpoints. Added data watchpoints.
    [gsu.v]
2018-03-18 Fixed several execute bugs.
    [gsu.v]
2018-03-18 Fixed multiplies. Fixed flags being incorrectly set after NOP. Fixed timing with flag writes.
    [gsu.v]
2018-03-18 Added support for hardcoded interrupt vectors. Fixed snes and gsu bus arbitration so both account for RON and RAN.
    [gsu.v, main.v]
2018-03-19 Fixed compile bug with vector return data. Updated plot/rpix implementation. WIP (and will probably be rewritten).
    [gsu.v, main.v]
2018-03-19 Fixed minor formatting and redundant interface issues.
    [gsu.v, main.v]
2018-03-23 Fixed snes->gsu ram addressing bug. Fixed several plot and rpix bugs.
    [address.v, gsu.v]
2018-03-24 Fixed PLOT dest register number. Fixed some timing problems.
    [address.v, gsu.v]
2018-03-24 Fixed bugs introduced by timing changes. Basic PLOT/RPIX works.
    [gsu.v]
2018-03-25 Fixed FETCH pipe bug where it went one byte too far and corrupted next work launch.
    [gsu.v]
2018-03-25 Fixed register write bug. Control logic needs to be rewritten. Added SmartExplorer based optimizations. Needs to be rerun on separate checkouts. Added back Stop on STOP instruction breakpoint code.
    [address.v, gsu.v]
2018-03-25 Fixed several PLOT color bugs. WIP.
    [gsu.v]
2018-03-26 Fixed LMULT R4 result. Fixed bitmap address generation logic.
    [gsu.v]
2018-03-26 Fixed dumb bug with GETC using wrong data return bus. Fixed (hopefully) some timing problems with multiplies.
    [gsu.v]
2018-03-26 Fixed GETB bug. Removed unnecessary register masking logic. Added temporary parameters for latency.
    [gsu.v]
2018-03-27 Fixed register file and other reg writes by rewriting the pipeline. Clears up weird graphical glitches and some crashes on SF.
    [gsu.v]
2018-03-29 Added L1I cache support. Currently disabled due to bug. Update L1I cache width to 8bit.
    [gsu.v]
2018-03-29 Fixed PLOT x/y precision bug.
    [gsu.v]
2018-03-29 Fixed bad timing bug with synchronization logic. Enabled L2I cache which now works.
    [gsu.v]
2018-03-29 Fixed snes->gsu address mapping. Thanks to megari for the changes. Added reset values for ROMBR and RAMBR.
    [address.v, gsu.v]
2018-03-29 Fixed bug introduced by prior checkin. First 8K is mirrored throughout and not stacked 8K regions. Yoshi's Island starts.
    [address.v]
2018-03-29 Fixed RPIX condition code generation. Fixed RPIX/PLOT state bit clears.
    [gsu.v]
2018-03-30 Fixed setting of cache valid bits from MMIO write.
    [gsu.v]
2018-03-31 Fixed random crash caused by race between PPU IRQ and GO bit being cleared. Fixed some timing problems.
    [gsu.v, main.v]
2018-03-31 Fixed cache injection addressing bug. Fixed multiplication timing problems again. The fix isn't ideal, but this is the only way it worked. Removed some commented out code as a minor cleanup.
    [address.v, gsu.v]
2018-04-01 Added store buffer. Somehow this fixed Winter Gold... Fixed DEBUG define to remove the majority of the debugging support.
    [dac.v, gsu.v, main.v, msu.v]
2018-04-02 Added better bitmap pipeline with write buffering and nonblocking flushes. Seems to introduce a transparency bug.
    [gsu.v]
2018-04-03 Fixed RPIX double op bug. This fixes tunnels in Yoshi's Island.
    [gsu.v]
2018-04-03 Added necessary firmware files to load gsu fpga file. Fixed timing problem in MCU. In 0.1.7e firmware. Disabled in-game saving to SD card for gsu games. Hold reset button to save. Disabled gsu DEBUG 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
    [dac.v, fpga.h, fpga_spi.c, gsu.v, msu.v, smc.c, snes.c]
2018-04-03 Fixed in-game hook problem by disabling when gsu rom is present.
    [cheat.c]
2018-04-04 Fixed one cycle hole in prefetcher. Fixed unset save variable in firmware.
    [dac.v, gsu.v, main.v, msu.v, smc.c]
2018-04-05 Fixed lack of ROMB and RAMB synchronization with the prefetcher and store buffer, respectively. Fixes doom and maybe other stuff.
    [gsu.v]
2018-04-05 Changed DEBUG/MSU/DAC defines to disable debug mode in checkin. Updated version number. Fixed FWVER generation bug.
    [dac.v, gsu.v, msu.v]
2018-04-07 Fixed PBR write to only use 7b of data bus. Voxel demo works with this change.
    [gsu.v]
2018-04-07 Fixed CBR reset bug where SFR write would unconditionally reset it to 0.
    [gsu.v]
2018-04-07 Fixed embarrasing bug introduced by me where stale psram rom data is read rather than the actual header. This fixes a lot. Added flops for some address module state to improve timing. Added back peri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
    [address.v, gsu.v, main.v, smc.c, smc.h, snes.c]
2018-04-08 Reverted some of the timing changes for the address enables. Added full bus access for gsu when it has both ran and ron set.
    [address.v, main.v]
2018-04-09 Fixed CBR write/cache flush bug. Fixed potential PBR write bug.
    [gsu.v, main.v]
2018-04-09 Added comment about icache flush problem.
    [gsu.v]
2018-04-10 Changed save to sd to only operate when it detects a carttype that has saveram. Fixed sram init bug. Reverted cache invalidation change. Looks like it's not the cause of problems.
    [gsu.v, memory.c, smc.c, smc.h, snes.c]
2018-04-16 Fixed ram timing for more ram chips with worse timing by adding additional fpga clock. Fixed menu config save bug with gsu speed option.
    [cfg.c, main.v]
2018-04-20 FPGA: experimental brightness patching for 1CHIP systems
    This applies a simple rule set to patch CPU writes to the PPU2
    brightness register ($2100), avoiding brightness DAC voltage changes
    when switching to/from forced blanking, also substituting brightness 0
    when the picture is to be darkened momentarily.
    This fixes, on 1CHIP consoles:
    - darkening of picture along the top edge on Capcom games
    - distorted scanlines+garbage on Rudra no Hihou dialogue boxes
    - invisible shadow in A.S.P. Air Strike Patrol
    [address.v, main.v]
2018-04-21 Added support for second ram chip. Fixed ram word accesses to do serialized byte transfers. Cleaned up some code and warnings.
    [gsu.v, main.v]
2018-04-22 Fixed timing to improve match with rea carts. Thanks to all the people that contributed. Fixed 8b multiplies to support 0 cycles of additional latency.
    [cheat.c, cheat.v, gsu.v, main.v]
2018-05-03 Fixed powerslide demo by reverting sram init change.
    [memory.c]
2018-05-05 Fixed few cycle hole where IRQ and GO bit can make 1->0->1 transition when it should be 1->0.
    [gsu.v]
2018-05-05 Fixed plot bug in starfox by use non-dithered color to test for transparency.
    [gsu.v]
2018-07-14 Enhance menu visually (disabled entries, change hooks)
    Menu entries can now be printed in grey when some condition is (not)
    met. A function call is used to determine the status with the carry flag
    as a boolean return value. Disabled menu entries can still be changed
    for when they become active again.
    Also a change hook function can now be used in the menu structure. It is
    called whenever the value is changed _during setting_.
2018-07-14 Notify menu of SuperCIC availability
    In order to properly print the SuperCIC configuration entries as
    disabled or enabled, pass a value to the menu system to signal SuperCIC
    availability.
2018-07-14 UART: Add hexdump routine for strings
2018-07-16 Option to go back to menu on short reset
    [cfg.c, cfg.h, snes.c]
2018-07-16 Fix SuperCIC pair mode detection for consoles with slower CIC clocks
    [cic.h]
2018-07-23 Initialize S-RTC on reset inside MSU1 loop too
    [main.c, msu1.c]
2018-07-30 Fix a silly buffer overrun hazard (only 99 to go...)
    [cfg.c]
2018-08-07 Fix menu lockup after reconfiguration (databus glitch)
    To support multiple custom chips the FPGA is reconfigured at ROM loading
    time while the menu is running.
    After reconfiguration the initial state of all synchronizing shift
    registers was 0 which led the FPGA to believe the SNES is actively
    accessing the bus, writing to peripheral address $00 (CPU address $2100
    - brightness register). This invalid state persists for a couple of FPGA
    cycles until the SNES control signals have been clocked into the shift
    registers.
    The recently introduced brightness patch partly reacts to this pattern,
    momentarily forcing the sd2snes data bus drivers active. Depending on
    the SNES CPU's current position in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
    [main.v]
2018-08-08 Added missing reset for psram access signal. Added qualifiers for gsu_enable bus OE. Removed commented out code.
    [gsu.v, main.v]
2018-08-24 Added experimental reset check for clock alignment. Fixed some inconsistent snescmd addressing. Useful if snescmd bram is expanded.
    [cli.c, snes.c, snes.h]
2018-09-03 Feature: LED brightness
2018-09-04 fixup! 82d30ed Feature: LED brightness
    replace hard coded value from testing with actual configuration setting.
    [main.c]
2018-09-04 Added sa1 branch based off of develop. Fixed led brightness assignment in main outer loop.
    [address.v, bsx.v, cheat.v, dac.v, dcm.v, fpga.h, main.c]
2018-09-04 CIC emulator: Fix data directions, initial state, add stream ID select
    [mangle.c]
2018-09-04 SuperCIC key: timing adjustment, fixes
    * Fix broken timing resulting from replacing banksel macros with 2 instructions (this code did not assume 2 clocks per banksel yet)
    * Make the data output pulse a bit longer and appear a bit later to better mimic original key behaviour
    * Change EEPROM definition to be GPASM compatible
    [supercic-key.asm]
2018-09-05 Added dedicated snes reset loop.
    [main.c, memory.c, msu1.c, snes.c, snes.h]
2018-09-06 Changed sram match from checksum16 to crc32 to decrease chance of false positive. Fixed issue with crc and non-multiple of 2 sizes.
    [memory.c, snes.c, snes.h]
2018-09-07 Fixed rom hash size and added some comments. Changed hash check to cover all files and not just gsu/sa1.
    [memory.c, snes.c]
2018-09-11 Added menu option for reset hook patch. Fixed dead timeout delay to match frequency.
    [cfg.c, cfg.h, main.v, memory.c, snes.c, snes.h]
2018-09-12 Added arbitrary rom crc calc delay as a temporay workaround for problem games.
    [snes.c]
2018-09-24 Added branch for usb changes. Merged with 1.8.0+. Updated save state patch to use exe hook. Patch must be re-applied if non-base FPGA is loaded. Only works on base FPGA file. Fixed bug in exe portion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
    [address.v, bsx.v, cdc.h, cdcuser.c, cdcuser.h, cfg.c, cfg.h, cheat.c]
2018-09-24 Fixed exe region bug when applied in the menu.
    [cheat.v, main.v]
2018-09-26 Fixed terrible bug that created a race between initial context state and the initial clear.
    [ctx.v, memory.c]
2018-09-28 Fixed some formatting issues.
    [main.c]
2018-10-03 Fixed messy space/tab formatting in ctx block.
    [ctx.v]
2018-10-10 Added option to choose which controllers to use for Savestates inputs Added config.yml option to choose the button to change slots Game fixes are now loaded correctly to memory And other minor fixes
    [cfg.c, cfg.h, savestate.c, savestate.h]
2018-10-10 Including custom savestate assembly code and updated README
2018-11-03 Fix brightness patching for DMA and SA1 IRAM
    [main.v]
2018-11-18 Timeout for reset hook phase correction response
    Continue with timeout if the phase correction loop is enabled but
    doesn't respond, i.e. isn't executed for a while. This fixes operation
    on Ultra16 consoles
    [snes.c]
2018-11-18 fixup! Timeout for reset hook phase correction response
    add missing changes in snes.h
    [snes.h]
2018-11-21 Show current video mode in system information
2018-12-08 Fix timing for auto region patching
    [main.v]
2018-12-08 Correct 1ms idle timeout for GSU
    [main.v]
2018-12-15 Fixed ingame hook call when $2C00 hook is enabled. Ingame hook will need to be rewritten or the hooks need to be reordered for buttons to work.
    [cheat.v, fpga.h, smc.c]
2019-02-28 Print loading message on boot if FPGA is already configured
    (Otherwise don't waste time configuring it just for the message)
2019-02-28 Add missing SRTC state reset on one occasion
    [memory.c]
2019-02-28 Simplify System Information printing
2019-03-01 Actually use the MENU_FILENAME placeholder everywhere m(
    Fixes boot on Mk.III
    [memory.c]
2019-03-26 Avoid memory corruption on MCU writes
    (address invalid before end of write strobe)
    [main.v]
2019-03-26 S-DD1: avoid memory corruption on SRAM writes
    Fixes saving not working in Star Ocean on some occasions
    [main.v]
2019-03-28 Workaround for Super Nt not booting when CICs enter pair mode successfully
    [main.c, timer.c]
2019-03-29 SuperCIC: fix previous fix, increase tolerance, make lock work with every key
    [supercic-key.asm, supercic-lock.asm]
2019-04-04 correct PINMODE assignment for CIC data lines
    This doesn't fix anything because the lines' modes are always switched
    both at a time. But the assignment was still vice versa.
    [config.h]
2019-04-04 separate status into fields governed by MCU and by SNES
    Avoid status getting overwritten by race conditions
    [cfg.c, main.c, memory.c, memory.h, snes.c, snes.h, sysinfo.c]
2019-04-04 move pair mode detection outside of reset (to enable Super Nt operation)
    Still needs some work because Super Nt has a very long initial boot
    delay (about 4 seconds) but it works after a warm boot at least...
    [main.c]
2019-04-04 Explicitly set pair mode data directions when setting game video mode
    In case pair mode wasn't successfully detected/engaged before
2019-04-04 Fix inverted logic for SA1/GSU RAM writes. 🤦‍♂️
    This broke SA1+SuperFX in 1.10.2...
    [main.v]
2019-04-06 Fix a stupid, stupid, stupid copy&paste error corrupting SuperFX saves.
    [main.v]
2019-04-22 Added incremental CRC computation for SaveRAM bounds to provide better QOS for reset and USB.
    [memory.c, memory.h, snes.c]
2019-04-30 Added enable qualifiers for OE. Doesn't fix any known bugs, but avoids using invalid addresses.
    [main.v]
2019-05-18 Changed addressing to support version. lda $002BB0 should open bus to 0. FW writes version. Fixed hard reset to force romslot 0 when short. Fixed bug reading ramslot from sram.
    [address.v, main.c, main.v, memory.c, snes.c, snes.h]
2019-05-18 Fixed MAP unlock for reads. Gives proper open bus values and supports read unlocking without write unlocking. Fixed typos in FW with combo version register.
    [main.v, memory.c, snes.h]
2019-05-19 Added support for more mappers to slot 0.
2019-05-19 Revise project structure
    Makefile based build for FPGA configurations, firmware, SuperCIC,
    release packaging. Probably needs more polishing.
    [lpc1754.cfg, lpc175x.cfg]
2019-05-20 Fixed combo bug where smc code would overwrite file pointer position causing wrong header to be read.
    [memory.c, smc.c, smc.h]
2019-06-30 Fixed bug where combo saveram slot was written for non-base FPGA files. The bug could cause problems with special chip games - known cases only happen on mk3.
    [memory.c, snes.c]
2019-07-04 Fixed missing DSP chip bug for mk3. Also present in master source code.
    [main.v]
2019-07-05 FPGA: fix missing DSPx instantiation for mk3 base config
    [main.v]
2019-07-15 MSU1: auto-save when card usage allows and during short reset
    [msu1.c]
2019-10-13 Fixup fixup, bump version numbers
    [snes.c, usbcore.c]
2020-03-02 Basic Favorite games list, with context menu in the file selector to add games (#134)
    Context menu is accessed with the Y button
    Favorites list is accessed with the SELECT button or via the main menu
    Adds new menu option type FUNC_CLOSE, which closes the current menu after RTL
    Extends menu_select to support multiple buttons to select an item
2020-06-27 - Fixed window overlay to be per-pixel rather than per-tile. Addresses window graphics problems with CAW bosses and likely many other games. - Fixed several dynamic range and popping/clicking APU bug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
    [address.v, cfg.c, cfg.h, cheat.c, cheat.v, dac.v, dcm.v, filetypes.c]
2020-06-28 - Added serial link transfer interrupt.
2020-07-01 - Fixed RETI setting of IME by adding bypass. Exposes bugs in some games. - Changed PPU pipeline to remove DRN wait. - Changed interrupts to clean up code a bit.
2020-07-03 - Fixed popping noises and some other APU bugs by rewriting output and handling unsigned->signed conversion better. Hopefully this is better than before. - Updated wave sample buffer to only update o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
2020-07-03 - Fixed stack overflows due to delayed interrupts by masking OAM STAT interrupt when sprites are disabled. - Updated STAT interrupt code to make match/oam coincident. - Updated initial state of just 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
2020-07-04 - Fixed unsigned underflow bug in GB RTC subtraction. - Updated config files to current version.
    [rtc.c]
2020-07-05 - Fixed end of frame line match interrupt. - Added extra line of OAM interrupt. - Fixed problem with hidden sprites still getting rendered.
2020-07-08 Fixed some cases of partially flashing scanlines by masking OAM LUT reads/writes when DMA is active.
2020-07-09 - Fixed interrupt related problems by rewriting STAT interrupt generation logic. Removed hack where OAM interrupt was masked using sprite disable flag.
2020-07-10 - Fixed a RTC bug where invalid state was read on reset to menu. - Updated config files.
    [sgb.c, snes.c]
2020-07-12 - Added another envelope register write side effect. - Updated audio CIC rates and precision. Removed hack to filter one case of noise which is now handled by CIC.
    [dac.v, main.v]
2020-07-12 - Fixed duplicate interrupts by removing double trigger on LYC==0 in favor of STAT write spurious int during V-Blank (and other conditions). - Added single cycle H-Blank status update on LY==0.
2020-07-13 - Added back envelope register write side effect with fix.
    [dac.v]
2020-07-14 SGB: Support RAM size 0x04 (128kB)
    Fixes LSDj, Chou Gals Kotobuki Ran, Gameboy Wars 3 et al.
    [sgb.c]
2020-07-18 - Added config value to allow SGB ingame hooks without needing to enable the existing ingame hooks. - Added a few more hashes of supported boot and bios files to avoid disabling hooks. - Changed BOOT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
    [cfg.c, cfg.h, sgb.c]
2020-07-19 - Added DMA from VRAM support.
2020-07-21 - Added DMA stall on HALT. - Updated REG logic to separate read and write buffers.
    [main.v]
2020-07-22 - Updated reset state of P1 to handle code that relies on uninitialized value.
    [main.v, sgb.c]
2020-07-25 - Fixed joypad data bus bug when both lines asserted. - Fixed hole where joypad interrupt can miss 1->0 trigger.
2020-08-09 - Added support for SGB1 frequency. - Fixed row buffer read/write conflict at SGB1 frequency.
    [dcm.v, main.v]
2020-08-16 - Fixed partially flashing scanline by giving SNES early notification of a scanline and row buffer completing. - Removed checks for disabling in-game hooks and associated override cfg option. User re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
    [cfg.c, cfg.h, sgb.c]
2020-08-24 [SA1] glitch-filter address lines as done on other cores
    This should avoid accidental yielding of SNES IRAM cycles to the MCU
    that caused graphical glitches.
    [main.v]
2020-09-08 Added SGB menu settings, new option to choose which SGB firmware to use Bug fixes ARM crash on mk3 when loading savestate fixes
    [cfg.c, cfg.h, savestate.c, sgb.c, sgb.h, sysinfo.c]
2020-09-23 Rearrange and fix USB initialization
    USB clock div must be set before connecting PLL1
    USB can be inited independent of PLL0 connection erratum.
    [clock.c, main.c, usbhw.c]
2020-09-23 FPGA: Remap DMA1 feature bit to avoid clash
    Reported by the TASBot community, who was immensely helpful in tracking it down.
    DMA1 feature bit in the USB enabled firmware was mapped to the same bit as the brightness limit LSB. This lead to falsely enabled DMA1 feature (i.e. active address spaces where a normal game would expect open bus) which in turn broke an arbitrary code execution TAS movie.
    [address.v, fpga_spi.c]
2020-09-28 Reorder OpenOCD config a bit, add example cables
    [lpc175x.cfg]
2020-09-29 Interleave RAM chips to avoid bit rot on Mk3
    [main.v]
2020-09-29 Remove wrong comment on BSX memory mapping
    [address.v]
2020-10-03 Fixed SaveRAM CRC computation to only run on partial and not full memory for each region. Fixed missing base on MSU SaveRAM check and save.
    [msu1.c, snes.c]
2020-10-10 MSU1: Fix buffer hit optimization
    Data request inside a pre-filled buffer could result in an extra
    buffering event, displacing the buffered data by 8192 bytes,
    or filling with zero bytes in case of read past EOF.
    [msu1.c]
2020-10-13 Make the SNES assembler Makefile a bit smarter
    Actually only run targets when required files change
2020-10-13 update savestate memory map
    steer clear of memory map used by USB save states
2021-02-22 Update OpenOCD config
    * Bump configs for OpenOCD 0.10.0 (with prep for 0.11.0)
    * Use built-in OpenOCD scripts where possible
    * Add Makefile variable for switching programming interfaces
    [ae-ft2232.cfg, getenv.cfg, oocdlink.cfg, usb-blaster.cfg, usbjtag.cfg]
2021-07-18 SuperCIC: Add SuperCIC Lock with RGB LED support (common cathode)
2021-07-20 Detect end of cycle based on longest enable pulse
    CPU_CLK is substantially shorter than RD# during DMA transfers.
    Access cycle end was previously based on falling edge of CPU_CLK.
    This resulted in premature yielding of RAM access to the bus and in
    consequence incorrect values leaking onto the bus.
    [main.v]
2021-07-20 FPGA: Mask data line toggling before data ready
    On some occasions data output can be enabled before data is valid.
    This results in needless data line toggling which in turn can cause
    coupling into other signals, thereby potentially altering the ROM address
    and putting wrong data on the bus, etc.
    Use a narrowed output enable signal for SNES read cases to prevent this
    effect.
    [main.v]
2021-07-22 Savestates: Do not attempt to snoop anything coming from cart
    Databus direction was reversed according to the ROMSEL signal, not
    taking into account SRAM that is mapped outside of active ROMSEL areas.
    Instead take into account anything where data is sourced from the
    cartridge (ROM_HIT).
    [address.v, main.v]
2021-07-22 YAML parser: fix parsing of comment signs after list start items
    [yaml.c]
2021-07-22 Savestate patches: generate fixes as 65816 code
    [savestate.c, savestate.h, snes.h]
2021-07-22 Savestate patches: add operator+operand to simple fix format
    [savestate.c, savestate.h, snes.h]
2021-07-22 Savestates: fix enabling/disabling based on configuration
    [savestate.c, savestate.h]
2021-07-22 Savestates: Fix compiler aliasing warning
    [savestate.c]
2021-07-23 change internal representation for button combinations
    Data format changed from string to bitfield. We expect to store a lot
    more button combinations for various things so using two instead of 13
    bytes saves a considerable amount of config memory space and also eases
    internal handling a bit.
2021-07-26 Fix compilation with -fno-common (gcc 10 default)
    [fileops.c, fileops.h, fpga.c, fpga.h, rle.c, rle.h, sgb.c, sgb.h]
2021-07-27 fix packed attribute compiler warnings in USB code
    [usbhw.c]
2021-07-27 Give full access to banks C0-FF during in-game hook
    This allows for savestate handler execution directly from the menu ROM
    bank without having to copy it to block RAM or similar.
    (this seems to be causing unresolvable issues with HDMA interrupting
    NMI/IRQ so it will be due for an overhaul)
    [address.v, cheat.v, main.v]
2021-07-27 Increase reset loop timeout
    (increase chance of finding a good CPU/PPU phase relation)
    [snes.h]
2021-07-27 Add missing button bitfield definitions
    [snes.h]
2021-07-28 FPGA: fix ROM address detection to exclude WRAM
    (simply use /ROMSEL from SNES instead of manual decoding)
    [address.v, main.v]
2021-07-28 Allow OpenOCD parameters from environment+configs
    [getenv.cfg]
2021-07-29 [FPGA/GSU] correct NMI/IRQ vector injection cycle count
    [cheat.v]
2021-08-02 Misc SGB notes and fixes (#153)
    * - Fixed missing line 0 OAM STAT interrupt.
    * - Added some notes.
    * - Added support for (non save state) MCU write of SC to assert interrupt
    request.
    * - Removed trailing white space from several files and updated some
    comments.
    * Updated notes.
    [memory.c, sgb.c]
2023-02-03 Build: Generate ELF output with baked-in firmware header
    Necessary for debug probes used with gdb, e.g. Black Magic Probe
2023-02-03 Build: new version handling
    Version is now generally pulled from the RELEASE_VERSION variable in
    `src/VERSION`.
    `VERSION=...` can be passed to make to override RELEASE_VERSION. The
    special value `VERSION=*` will use the current timestamp as the version
    (`YYmmddHHMMSS`). If neither VERSION nor RELEASE_VERSION are specified,
    `SNAPSHOT` is used as the version.
2023-02-03 Add missing .fwhdr sections
    [main.c]
2023-02-03 Add support for Rev.D hardware (STM32 platform)
2023-02-03 USB: fix some whitespace damage in usbinterface.c
    [usbinterface.c]
2023-02-03 FPGA: fix occasional crash on save/load state
    Savestate hook requires re-entry from NMI/IRQ, but lack of detected button
    presses can preempt that and jump back to the game instead, corrupting
    the stack and disrupting savestate hook execution flow.
    A force_entry flag is added that is set when the FPGA enables the branch
    to the savestate handler, and does not disable it before hook mapping
    is disabled by the unlock_disable register ($2BFD).
    [cheat.v]
2023-02-03 FPGA: Change MK3 FPGA clock input from 24MHz to 8MHz
    Required to support STM32 clock output (MCO1) which cannot be fed and
    prescaled from the CPU clock
2023-02-03 Update savestates YAML files
    - Correct Checksums for DKC1, reported by limefiasco
    - Add Super Morph (E)
    [savestate_fixes.yml]
2023-02-03 Add microSD/microUSB footprints
2023-02-12 Fix compile error (missing include)
    Still worked at some point probably due to compile order.
    [sgb.c]
2023-02-13 Tolerate missing CIC clock (for freak mods)
    SuperCIC key never starts running when no CIC clock is supplied from
    SNES; since STM32 has no pull-ups enabled on reset, the CIC status can
    be CIC_FAIL on power-up and never change.
    Enable pullup on the CIC_STATUS pin to enable boot (CIC_OK) despite
    missing CIC clock.
    [main.c]
2023-02-16 SA-1 quick fix: increase execution speed (1.10.0 regression)
    [main.v]
2023-02-16 Fix for SGB controller multitap on SD2SNES mk2 (classic) (#168)
    [main.v]
2023-02-19 Use correct alternate function number for LED PWM on LPC
    AF number was set to 2 for all LED outputs; however, on Mk.II, the
    "Ready" and "Read" LEDs are connected to a different GPIO which has PWM
    mapped to AF number 1.
    [led.c]
2023-02-19 Fix: wrong video mode in SuperCIC pair mode
    In pair mode, CIC data lines are supposed to be outputs from the POV of the MCU.
    During operation they could be switched back to inputs by the SysTick handler,
    resetting the video mode/region back to NTSC regardless of settings.
    [cic.c, cic.h, main.c]
2023-02-19 Fixed combo ROM bug caused by merge with SGB which resulted in bad romprops offset.
    [fpga_spi.h, memory.c]
2023-02-19 Fix firmware header magic for Mk.3 builds
    Copy&paste error overwrote this with the STM32 magic (Mk.3 Rev.D)
2023-02-19 Fix refresh/cursor issues in "Favorite games" menu Fixes #156
    UI stuff is always the most painful...
    - There was no way to return outside of the submenu system whether a
    function was executed so a `listsel_dirty` flag was introduced to force
    refresh
    - Same for the `listsel_backup` variable
    - Redrawing the list after removing a favorite resulted in some flickering so
    an additional `screen_dma_disable` flag was introduced to inhibit
    screen refresh (WRAM->VRAM DMA) until the redraw was finished.
    This feature can be useful for other redraw operations.
2023-02-25 Fix boot ROM source for recent snescom assembler versions
2023-02-25 Add capability to print FATFS error strings
    [fileops.c, fileops.h]
2023-02-25 SNES boot ROM (early error message display) fixes
    - Do not erase text buffer from SNES side but from MCU side to prevent
    SNES overwriting text already written by MCU on delayed boot.
    - Display up to 24 lines of text instead of 1.
    - Show more detailed messages including FS error description
    - Display firmware version
    [main.c, printf.c, snes.c, snes.h, snesboot.h]
2023-02-25 Unify FS error display
    Use error names from FatFS for printing file system operation results,
    not just error numbers.
    [cli.c, fileops.c, fileops.h, memory.c, printf.c]
2023-02-25 Fix flickering message on write protected cards, cleanup
    Also give the ROM some time to clear the screen between updates and
    pad printed lines with spaces to prevent residual characters
    [main.c, snes.c]
2023-02-25 Fix centering in hardware string
    [snes.c]
2023-02-26 Slight facelift for the early boot messages
    - Update with current font from menu
    - Tweak palette for antialiasing and border
    - graphical underline to replace row of dashes
    [main.c, snesboot.h]
2023-03-07 Build: Add option for extra OpenOCD script search path
    - Eliminate duplicate OpenOCD scripts
    - enable bootloader to build again
    [flash.cfg, lpc1754.cfg]
2023-03-24 fix: string termination for character format
    Temp string was not zero-terminated after writing the character when using the %c format specifier, leading to extra characters being printed.
    [printf.c]
2023-03-24 Workaround S-CPU A DMA silicon bug
    The SNES's CPU revision A occasionally does not carry out DMA transfers when a HDMA channel is configured to use $2100 as a B-Bus target, i.e. $00 must not be written to any DMA channel's B-Bus address register at any time.
    The fix sets $21ff (unmapped) as a target address instead and configures the DMA channel to write two registers, thereby wrapping around to $2100 on the second write.
2023-03-28 Add LoROM flavors of MSU1 demo player
    Add two LoROM flavors of the MSU1 demo video player:
    * A direct adaptation of the HiROM variant with identical behavior
    * A slight variant that takes a data offset and track number from RAM; may be used to support playback of different videos from a caller
2023-03-30 Ensure MSU-1 data address increment at end of DMA (#208)
    * Ensure MSU-1 data address increment at end of DMA
    * fix MSU1 address increment for rest of the FPGA cores
    * update generated files
    [msu.v]
2023-04-12 Fixed CTX DMA write snoops in CT by blocking concurrent PARD assertion.
    [main.v]
2023-06-21 Add config toggles for Autosave & MSU1 Autosave
    Since MSU1 auto saving may lead to undesired delays on track changes for quirky hacks, add a config option to turn it off.
    In the process, a global autosave disable option is also introduced.
    MSU1 autosave is automatically disabled when global autosave is disabled.
2023-06-21 Avoid static buzzing noise on MSU1 track change
    Some games do not pause playback before changing the audio track. Normally this is not a problem since the track change handling stops playback implicitly; however after adding MSU1 SRAM checks the playback stop had moved after the SRAM check so there was an opportunity for the FPGA continuing playback without refilling the audio buffer.
    Playback is now stopped before performing the SRAM check on track change.
    [msu1.c]
2023-06-21 MSU1: speed up bulk PCM file scanning by some games
    Some games, notably ALTTP Randomizer, perform a full scan of all PCM tracks on startup. After adding MSU1 SRAM checks, this led to a full SRAM check per track scanned (because it was considered a safe opportunity to always do an SRAM check on track change), resulting in 7+ seconds of one-time startup time for the game which was considered unacceptable.
    SRAM check is now relaxed to at most once per second on track change; startup time is reduced to about 600ms.
2023-06-21 Fixed savestate slot bug where a load didn't wait for a slot change to complete. Added Chrono Trigger savestate audio fix.
    [savestate.c, savestate_fixes.yml]
2023-06-21 Fixed branch latency and readjusted memory latencies which were compensating for it. Added some performance counters available in DEBUG mode.
    [gsu.v]
2023-06-21 Fix CIC shutdown when saving settings on unmodded consoles
    Regression caused by fffe499:
    When saving the config, to set the video mode, CIC data lines were switched to outputs regardless of whether pair mode was detected or enabled. This caused an unmodded console with original CIC to shut down and require a power cycle.
    [cic.c]
2023-08-14 Fixed SGB RTC by adding dummy write to account for data buffer.
    [fpga_spi.c, sgb.c]
2023-08-19 OpenOCD: Use soft instead of hard reset
    LPC17xx likes to lock up on nSRST reset, requiring a power cycle which is inconvenient for development
2023-08-21 SuperFX: Revert to previous bus sampling timing
    This seems to have caused random access glitches for the GSU core.
    [main.v]
2024-07-04 Revert pulse end strobe based time sharing
    Seems to have caused problems on a number of units; reverting until further analysis/refinement
    [main.v]
2024-08-17 menu map: also cut warning messages before parsing
    avoids number conversion errors during memory map listing creation.
2024-08-17 MSU1 video player: compensate for A/V desync
    When the MSU1 audio sample rate was locked at exactly 44100Hz in 829953b, some A/V desync was introduced in videos played by the example video player.
    Audio sample rate had previously been set to a slightly higher rate to match the slightly higher vertical refresh rate of the SNES.
    This commit repeats a video frame occasionally, based on a phase accumulator, to keep video playback from running ahead of audio.
2024-08-19 Correct error logging for console `mv` command
    Change logging from "oldname, newname" to "oldname", "newname"
    [cli.c]
2025-06-22 Fix BS bytecode ROM loading (e.g. Magazines)
    Allow invalid reset vector when the ROM looks like a Satellaview bytecode (interpreted) ROM.
    [smc.c]
2025-06-22 Clarify that card must be MBR+FAT32 formatted
    Newer pre-formatted cards come with GPT partitioning which won't be detected even if the partition is re-formatted FAT32.
    [main.c]
2025-06-22 Fix detection of S-DD1 ROMs bigger than 48Mbits
    [smc.c]
2025-08-06 Make FPGA feature flags / FW config available to USB interface
    * Expand current_features to 16 bits and move to main
    * Expose current_features via USB INFO opcode
    * Add `CFG` space to USB to directly access YAML config values
2025-08-07 Add missing change from 2d0424c
    [usbinterface.c]
2026-03-11 Upgrade UART file transfer (XMODEM->YMODEM)
    Greatly speeds up transfers and supports exact file size without trailing EOF bytes.
    Batch transfers are not supported. (Any extra files will be appended to the output file)
2026-03-30 fix: amend pad state when clearing autoboot
    When coming in from a cleared pad state, when the user holds START to disable autoboot the first occurence of read_pad *afterwards* will immediately bring up the Recent Games list because the pad handler detects a state change of the START button.
    Therefore set the START button bit in the previous controller state (pad1mem) to avoid triggering.
    This becomes unnecessary if autoboot_start_poll uses read_pad instead of polling the pad register manually.
2026-03-30 Autoboot: use existing read_pad routine to check buttons
    Doing so automatically tracks the pad1mem state so we need not patch it up later
2026-03-30 Autoboot: fix occasional memory corruption (LOADROM_WAIT_SNES is mandatory)
    In about 5% of cases, autobooting a ROM would either boot to a black screen or crash after a while.
    This is caused by the menu ROM crashing after issuing the autoboot command, resulting in potential spurious write accesses by the SNES CPU.
    load_rom() cuts off ROM access from the SNES but does not hold the CPU in reset all the time (to enable returning from a faulty load, let the menu fade out while loading the ROM in parallel, etc.)
    Therefore the SNES CPU must stay away from the cartridge bus during load_rom (-> WRAM_ROUTINE). WRAM_ROUTINE also carries out some important initialization work to get the SNES in a sta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
    [main.c]
2026-04-27 Cosmetics: visual feedback when card inserted on early error screen
    [main.c]
2026-04-27 fix: SA-1 bus sampling
    Do not yield bus to MCU too late in cycle; this was a byproduct of too late ROMSEL sampling leading to setup violations for SNES CPU reads
    [main.v]
2026-04-27 SA-1 speed enhancements
    Make the execution (=CPU core) state machine advance without alignment constraint on sa1_clock_en.
    sa1_clock_en would fire every 8 cycles without taking into account ROM fetches et al., resulting in an execution step taking 9 cycles requiring 16 cycles worst case.
    Instead a commit counter is kept that will immediately advance the execution pipeline if it has consumed /at least/ 8 cycles.
    Also do not blanket halt the CPU during DMA but try keeping it running as much as possible when DMA src/tgt and CPU execution source do not fight. (Fixes measurements on page 4 of SA1 Speed Test by Vitor Vilela, seems inconsequential otherwise.)
2026-05-14 Change BS-X Season back to Spring (bsxpage.bin) The main reason is that Autumn is not really the standard for it, so I want to switch back to the default.
2026-05-16 Autoboot: speed up autobooting
    Holding START during boot doesn't really need a 1s time frame
2026-05-16 Fix: Prevent interrupts during autoboot handshake (Fixes #295)
    Do this by simply resorting to the existing game handshake function.
2026-05-16 Fix: move interrupt disable after game_handshake_error branch
    This actually makes it possible to bail out of ROM loading on error. Previously would hang indefinitely due to disabled interrupts.
2026-06-19 CIC: Fix lock-resync timing
    Adjust the PIC CIC lock routine timing, update HEX file
    Fixes various stuff with CIC dependent cartridges not working on OSCR, Ultra16 et al.
    [snescic-lock-resync.asm]
2026-07-22 Unify test firmwares for all HW revisions
    Mk.2, Mk.3, Mk.3-STM32
    [ae-ft2232.cfg, getenv.cfg, lpc1754.cfg, lpc175x.cfg, oocdlink.cfg, usb-blaster.cfg, usbjtag.cfg]
2026-08-01 Update STM32 header
2026-08-01 CLI: Fix parameter type in cheat command
    [cli.c]
2026-08-01 Fix: do not return uninitialized file size
    [memory.c]
2026-08-01 Fix SNESCMD BRAM mapping
    2A00-2DFF only
    [address.v]
2026-08-01 Harden vector hijacking against interjecting HDMA
    Instead of a simple read cycle countdown, wait for both bytes of a vector to be read before re-locking the hijacked area. Fixes various occasions of crashing when exiting in-game hook, predominantly occurring in Seiken Densetsu 3.
    [cheat.v, main.v]
2026-08-01 Fix: Map LoROM DSPx in 30-3f:8000-ffff area always
    This overlaps with potentially mapped ROM for games >12Mbits but works with expanded ROMs which steer clear of the mapped DSP area. No commercial LoROM games used more than 12Mbits.
    [address.v]
2026-08-01 SA-1: avoid bus fighting when SNES tries to write to ROM
    [main.v]
2026-08-14 Fixed volatile issue + reordered ls2
    [usbinterface.c]
2026-08-14 Avoid duplicate code
    Use a flag to control OPCODE_LS operation
    [usbinterface.c]
2026-08-15 USB: fix TIME command (do not fall through into MV)
    [usbinterface.c]
2026-09-14 Wire SD_DMA PSRAM usage to PSRAM_CE helper
2026-10-06 Fix CFG address for autosave/MSU1
    Mismatch with the ARM firmware structs caused the setting to potentially not be used/saved correctly
2026-10-09 tass64 port: structured stack frames, BCDTime type
2026-10-09 64tass port: move menu_measure into show_menu's frame
2026-10-09 Refactor window stack
    Use reentrant DP frame instead of stack pointer dependent offsets
2026-10-11 STM32: Use hardware SDIO host for MCU-side SD transfers
    new config keys: CONFIG_SD_HWSDIO, CONFIG_SD_HWSDIO_WRITE,
    CONFIG_SD_HWSDIO_CONTINUE, CONFIG_SD_HWSDIO_CLKDIV.
2026-10-11 STM32: Add SD self tests for the SDIO host (CONFIG_SD_HWSDIO_SELFTEST)
2026-10-11 prevent SNES writes from interrupting SD DMA cycles
    edge case but might happen during development (normally SNES must stay away from ROM during SD DMA or it would crash anyway)
2026-10-17 Menu: Add .unparam to remove call parameters from the stack
    The caller pulls the parameters of a re-entrant routine itself, so far
    with a hand-counted series of pla/plx. .unparam takes the number of
    bytes from the callee's Frame, like .call does for the check, and
    adjusts S directly.
2026-10-17 Menu: Add re-entrant print_text, make hiprint a wrapper
    hiprint takes its parameters in globals (print_x, print_y, ...) and uses
    globals as work space, so it can't be called again while it runs, e.g.
    from an interrupt. print_text takes them on the stack, keeps its state in
    its stack frame and doesn't depend on D or DB. It returns the number of
    characters printed and the character after them instead of setting
    print_done/print_over.
    hiprint now calls print_text with the globals, with the same results as
    before, until all callers use print_text directly.
2026-10-17 Menu: Add re-entrant bin2dec, make bin2dec16 a wrapper
    bin2dec16 uses the CPU's hardware divider, which can't be shared with an
    interrupt, and always writes to stringbuf. bin2dec subtracts powers of
    ten instead and writes to a buffer given by the caller. It produces the
    same text: 5 digits, leading zeros as spaces, then a NUL.
    bin2dec16 now calls bin2dec for stringbuf until its callers are
    converted.
2026-10-17 Menu: Remove unused loprint
    loprint (a low-res print to bank $7F) has no callers.
2026-10-17 Menu: Make draw_window re-entrant
    draw_window built each row in stringbuf and printed it through the
    print_* globals. It now builds the rows in its stack frame and prints
    them with print_text, so it neither uses nor changes stringbuf and the
    print_* globals; the window to draw is still described by window_*.
    draw_loading_window prints with print_text too.
2026-10-17 Menu: Make rendertime, printtime and the time editor re-entrant
    rendertime wrote its text to stringbuf through DB; it now writes to a
    buffer given by the caller. printtime and time_init keep the text in
    their stack frames and print it with print_text. render_rtc_time, only
    used by printtime, is gone.
    time_init printed with whatever print_count was left from earlier calls;
    it now prints the 19 characters of the time.
    gettime still reads the S-RTC into the time_* globals, so printtime
    can't run in an interrupt while the main loop uses the S-RTC.
2026-10-17 Menu: Make show_sysinfo re-entrant
    show_sysinfo kept the text position on the stack between loop passes
    and built the system line in the global snes_system_config. It now has
    a stack frame for both and prints with print_text.
2026-10-17 Menu: Print the SPC player texts with print_text
    The texts of the SPC player have constant positions and palettes. The
    new .print_at macro (print.inc) pushes such parameters, calls print_text
    and removes them again.
    The artist field is now checked with a long read instead of through
    longptr, which needed D=0.
2026-10-20 Menu: Print the file browser with print_text
    print_direntry gets a stack frame for the row, the palette and the
    length of the name, which it used to keep in the print_* globals between
    its three prints. The recent games and favorites lists share the new
    print_game_list instead of looping over print_src/print_y. The other
    prints pass their parameters directly.
    setup_224 printed the last row twice; once is enough.
2026-10-20 Menu: Print menu entries and value dialogs with print_text
    menu_print_entries passed the row to menu_print_opt_string in print_y
    and the values were rendered into stringbuf. The row is now a parameter,
    numbers and times are rendered into a buffer in the stack frame
    (bin2dec, rendertime), and one helper right-aligns and prints all value
    types. The u8, u16 and kv8 dialogs do the same in the frame of
    menu_edit_value; the number dialogs printed with whatever print_count was
    left and now print the five characters of the number.
    right_align returns the column instead of setting print_x.
2026-10-20 Menu: Remove hiprint, bin2dec16 and their globals
    All callers use print_text and bin2dec now. Remove the wrappers, the
    print_* parameter globals, stringbuf, and window_tmp and longptr, which
    have no users left either.
2026-10-20 Menu: Keep the carry in .unparam
    .unparam removed the parameters with tsc/clc/adc/tcs, which clears the
    carry, so a routine with stack parameters couldn't return a flag in the
    carry like the routines without parameters do. Pull the parameters into
    A instead: pla leaves the carry alone, and the code is shorter when A is
    8-bit, as it is after most print_text calls.
    A routine with a frame returns a flag with .leave followed by sec or
    clc; .leave restores the caller's P.
2026-10-20 Menu: Add .param_dp to pass Frame members by address
    Routines with a frame keep their buffers in it. .param_dp pushes the
    long address of such a member (bank 0, where the stack is, D + offset)
    as a parameter, so a routine can have another one write into its
    buffer.
2026-10-20 Menu: Add cheat editor helpers (records, patch counting, GG conversion)
    Groundwork for the cheat editor: routines to access the cheat records in
    the cheat area, count the ROM and WRAM patches of a cheat (the same way
    the firmware does when it programs them), convert between raw/PAR and
    Game Genie codes and describe codes, plus status bar messages and a
    message box.
    The routines keep their state in their stack frames and take their
    parameters on the stack. The windows of the editor will start their
    frames with a CheatWindow (a line buffer and where to print); the print
    and line helpers run in the frame of the window that calls them and use
    it.
    wram_mcu_cmd sends a command to the MCU and wai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
2026-10-20 Menu: Polish the cheat editor windows
    - A window opened over another one greys that one out, as show_menu
    does for its submenus, so the window in use stands out.
    - The cheat list and the editor have a separator below their table
    header. The patches used and the warnings moved to the bottom of the
    list, below another separator.
    - The editor takes the changes with START and discards them with B (or
    X), like the name keyboard and the code pad; B means cancel or back
    almost everywhere else.
    - The keys of the name keyboard and the code pad have a frame. The code
    pad window is smaller, and both say A:Type.
2026-10-20 Menu: Edit cheats with A, switch them on/off with X
    A opens or confirms the selected item everywhere else in the menu, so in
    the cheat list it now opens the editor (on "Add new cheat..." it adds a
    cheat), and X switches a cheat on or off. To fit the status bar, the
    help text calls Y "More", in the editor as well.
    The name keyboard clears the whole name with SELECT.
2026-10-20 Menu: Lay out VRAM for skins
    The skin assets need room in VRAM: a 4bpp font with 16x8 characters
    (for button graphics), and sprite tiles for a background image behind
    the text area, which mode 5 cannot show on a BG layer.
    - $0000 logo, $1C00/$2000 BG1/BG2 tilemaps (32x32 instead of 32x64),
    $2400-$5FFF sprite tiles 64-255 and three pages for tiles 256-511,
    $6000 font.
    - Both BG layers read the font at $6000: BG1 (4bpp) as tile 2 * char,
    BG2 (2bpp) as tile 4 * char, which yields bitplanes 0+1 of the left
    half. In mode 3, BG1 (8bpp) reaches the logo tiles $100-$1DF at $0000
    through the VRAM address wrap-around.
    - Sprites are 16x16/32x32 with the tiles at $2000. The logo's 8x8
    sprit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
2026-10-20 Menu: Build the HDMA tables from per-line data
    Skins describe the background gradient, the sprite pages and the
    selection bar per scanline, and the menu builds the HDMA tables from
    that. A skin file then cannot produce a broken table (a missing end or
    a zero line count), and the file format does not depend on the HDMA
    channel layout.
    - Channel 1 writes CGADD twice and CGDATA twice on every line (one
    channel instead of two), from 224 records [CGADD, CGADD, color].
    - Channel 2 switches the sprite pages for tiles 256-511 (OBSEL). The
    table has one entry per run of lines on the same page, and the last
    run gets a single line (OBSEL keeps its value after the table ends),
    so without page c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
2026-10-20 Menu: Load skins from the SD card
    The firmware loads the skin named by the new config.yml entry SkinName
    (a file in /sd2snes/skins/ or a full path) to $F00000 after every menu
    load, followed by a zero word. The menu applies the chunks it finds
    there on top of the default skin. Files of 64 KB or more are not
    loaded, so no chunk crosses a bank boundary. Without a skin, or if it
    cannot be read completely, only the zero word is written, so nothing
    stale or partial is applied. SkinName is empty by default.
    A skin can make the menu unusable (unreadable text), so holding SELECT
    at power-on skips it. The menu reads the controllers directly before
    the graphics setup for that, and a SELECT held from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
2026-10-20 Menu: Document the skin file format
    snes/skin-format.md describes how skins are selected and loaded, the
    chunk format and its validation, the screen layout the per-line data
    refers to, how the menu uses CGRAM, and every payload. skin.asm keeps
    a short overview and points there.
    The CGRAM map reserves colors 36-47, 52-63 and 64-79 for the button
    graphics that a later menu version will use.
2026-10-20 Menu: Move the logo colors out of the button palettes
    The button graphics of the planned font need their own BG1 palettes:
    colors 4-15 of palettes 2 and 3 (CGRAM 36-47, 52-63) and all of
    palette 4 (64-79), which can't be a text palette of its own anyway
    (its BG2 copy overlaps BG1 palette 1, so it always equals text palette
    1). skin-format.md reserves these ranges.
    The 36 logo colors there move to entries no layer shows: color 0 of
    BG2 palettes 1-7 and of BG1 palettes 2-7, and sprite palettes 2-3
    (169-191, unused by the default sprites). The logo looks the same; the
    freed entries are black for now.
2026-10-20 Theme tool: Convert themed menus to skin files
    Menus with skin support can't be patched in place, so the theme
    migration page gets a second step: it converts a themed menu.bin or
    m3nu.bin of any version it detects (offsets table or _GFXPTR_) into a
    .skin file. skinconv.js does the conversion and also runs under node.
    - Palette, logo, font, gradient, selection bar (both variants, from
    the HDMA table and the bar colors) and sprites become CGEN, LOGO,
    FONT, GRAD, CRSR and OAMT chunks. The 8x8 logo sprites are regrouped
    into 16x16 sprites as in the menu's default skin.
    - Logo colors in the CGRAM ranges reserved for button graphics move to
    free entries, merging the most similar colors wh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
2026-10-20 Menu: Leave color 64 out of the reserved button palette range
    Color 64 is color 0 of BG1 palette 4, which is transparent there, so
    the button graphics don't use it; the default logo already does.
2026-10-20 Theme tool: Move logo colors to every free palette entry
    The converter moved the logo colors out of the reserved button ranges
    only into the 40 entries the new menu's default logo uses for that, and
    treated every sprite palette the theme's sprites use as taken. Most
    themed logos use fewer colors than the default one, and the sprites
    only a few colors of their palettes, so after those 40 entries it now
    also takes any entry that neither text, the logo nor the sprites show.
    Of the 31 themes on the site, 10 instead of 22 still need colors
    merged: SFCSD2SNES, StarFox (three variants, menu and m3nu),
    StarmanSmaaash, som and stars, whose logos use 198-213 colors. The
    stock menus still convert to e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
2026-10-20 Menu: Let FONT chunks replace a range of characters
    A FONT payload now starts with the first character and the number of
    characters, like CGEN, and a skin may contain several. A skin that
    only changes the text font then keeps the button graphics that
    characters 0-15 will hold. Converted themes replace characters
    16-255: the old menus never showed 0-15.
2026-10-20 Menu: Add the button graphics to the default skin
    Characters 0-15 of the default skin hold the controller buttons: A, B,
    X and Y in the colored SFC/PAL style and in the purple US style, L, R,
    START, SELECT and the four D-pad directions, each 16x8 pixels in 4bpp.
    They come in their own FONT chunk, next to the text font, with CGEN
    chunks for their BG1 palettes: 2 (SFC A and X), 3 (US buttons and the
    rest) and 4 (SFC B and Y).
    buttons.py makes buttons.chr and buttons.asm from the font art (a PNG
    export of gfx/fontz-16x8-withtees.aseprite). The menu doesn't print
    the buttons yet.
2026-10-20 Menu: Show controller buttons in the help texts
    A string can now contain a button: BUTTON_CODE ($90, no character in
    CP1252), then a code for the button (never 0 or 1, so string ends stay
    unambiguous). In the sources, .edef escapes such as "{A}" or "{START}"
    produce these. print_text shows the button graphics (16 pixels, 4bpp)
    on BG1, so only on an odd column; the right half covers the next
    column, which gets a space. On an even column it prints two letters
    instead ("A ", "ST"). Either way a button takes two columns, the same
    as its two bytes, so string lengths and right alignment still work.
    The new "Buttons" setting (Configuration -> Skin, ButtonStyle in
    config.yml, cfg_t.button_style) ch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
2026-10-20 Menu: Switch to the CP1252 font
    The default text font is the new one from the font art: shaded, and
    laid out as CP1252, the code page the firmware converts file names to.
    font.py (formerly buttons.py) converts the whole art; the text font is
    a FONT chunk for characters 16-255. Text characters are 8 pixels wide
    (BG2 shows only the left half of a font character); font.py cuts wider
    ones and warns.
    The menu's ellipsis is two characters, now $81 and $8D (before 127 and
    128): they are undefined in CP1252, so they never occur in file names,
    and the menu's ellipsis can look different from the CP1252 one (133).
    The bullet moved from 129 to 149, as in CP1252. The sources write
    "…" (.edef) and "•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
2026-10-20 Menu: Use the redrawn ellipsis and trademark characters
    133 (…) and 153 (™) are 8 pixels wide in the font art now, like all
    text characters, so font.py no longer cuts them.
2026-10-21 Menu: Multiply with the CPU, not the PPU
    show_menu, menu_select and push_window multiplied with the PPU's
    mode 7 registers ($211B twice, then $211C). Their write-twice latch is
    shared with BG1HOFS/BG1VOFS, which HDMA channel 4 writes on a few lines
    per frame. An HDMA write between the two $211B writes turned the first
    factor into the scroll value: the product came out 0, so a menu window
    got a height of 2, drew 65535 rows (wrapping through the tile buffers
    and past them for a long time) and left the screen garbled. Whether the
    multiplication met that HDMA line depended on timing, so it happened
    only sometimes.
    The CPU's multiplier ($4202/$4203, result in $4216) has no latch and
    HDMA doesn't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
2026-10-21 Menu: Switch the sprite pages with a timer IRQ
    On hardware, the HDMA writes to OBSEL garbled sprite tiles at random.
    The PPU fetches the sprite tiles of the next line during HBlank, when
    HDMA runs, and takes the register value during the whole write cycle,
    before the data is valid. What it saw then depended on the bus value
    the CPU had left, so the glitches changed with the program flow, even
    for writes that don't change the value (every 127 lines of a run).
    An H/V timer IRQ now writes OBSEL in the middle of the line before each
    change, where the PPU fetches no sprite tiles. build_obsel makes a list
    of the changes (OBSEL value, VTIME of the next change), the NMI writes
    the value for line 0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
2026-10-21 Menu: Keep the sprite pages going while a skin loads
    While the MCU loads a skin by SD DMA, the menu must not touch the cart,
    which holds the interrupt vectors, so it waits with interrupts off. The
    sprite pages stood still meanwhile. The H/V timer still sets its flag
    without the IRQ, and RDNMI marks the start of VBlank without the NMI:
    wram_mcu_cmd_pages polls both from WRAM and does the work of irq_obsel
    and the NMI, now shared as obsel_change and obsel_start in irqcode. It
    returns at the start of VBlank, so the interrupts come back at a frame
    boundary.
    Polling can read the timer flag right after it is set. Mesen then sets
    it again a moment later, so obsel_change reads it once more after
    se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
2026-10-21 Menu: Let the sprite page chain run by itself
    The NMI started each frame's sprite page changes, so they stopped
    whenever the NMI was off, and skin loads needed a polling loop that
    also watched RDNMI. The chain now starts the frame itself: its first
    entry, at VTIME 225 (VBlank), writes OBSEL for line 0 and sets the
    timer for the first change, and every entry holds the address of the
    next one, the last leading back to the first. Skins without page
    changes get one IRQ per frame. setup_hdma leaves VTIME to build_obsel.
    During a skin load the CPU waits with interrupts masked; WAI still
    wakes up on the H/V timer, so wram_mcu_cmd_pages now sleeps until the
    next change and makes it right away (obse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
2026-10-21 Menu: Keep the sprite pages going while an SPC file loads
    The SPC player loaded with all interrupts off because its burst
    transfer was timed: the SPC700 read the next four bytes a fixed time
    after its acknowledgement, about 17 us, and an H/V timer IRQ takes
    about 40 us. So the sprite pages stood still for the whole load.
    The burst is now handshaked: each chunk carries one byte for each third
    of $0200-$FFFF (85 pages each from $0200, $5700 and $AB00; the last two
    overlap on page $AB, which gets the same bytes twice) and a counter in
    port 3, written last. The SPC700 reads a chunk when the counter shows
    up and echoes it once it has read the ports; the S-CPU prepares the
    next chunk meanwhile. A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
2026-10-21 Menu: Don't miss the MCU's echo of a skin command
    wram_mcu_cmd_pages wrote the command, compared SNES_CMD with it and
    then waited for the next H/V timer event before it wrote the command
    again. With a skin that doesn't change the sprite page, that event comes
    once per frame. When the MCU echoed the command and was done with it
    before then, the menu missed the echo and wrote the command once more,
    and the MCU ran it again: canceling a skin preview reloaded the old
    skin over and over, for seconds or for good.
    While it waits for the echo, the loop now polls the timer flag instead
    of waiting for the timer, so it sees the echo within a few
    microseconds, like wram_mcu_cmd. The register saves move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
2026-10-21 Menu: Wait for skin loads without WAI
    wram_mcu_cmd_pages waited for the H/V timer with WAI while it waited
    for the MCU to be ready, while the MCU loaded the skin, and until
    VBlank. The FPGA starts an MCU memory access at the end of a CPU bus
    cycle, or once the SNES has been silent for 1 ms, which also gives a
    reset strobe when the CPU comes back. If WAI holds off the CPU's bus
    cycles, the MCU's accesses wait for the next timer event. Poll the
    timer flag in a loop instead, as the wait for the echo does already.
2026-10-23 Build: add Black Magic Probe programming interface
2026-10-24 Firmware: STM32: Keep IN_AHBRAM data out of the flash image
    stm32f401.ld had no rule for the .ahbram section, so the linker placed
    it as an orphan in main RAM with a load image in flash: 8,992 bytes of
    zeros (ptrcache, the MSU-1 cluster tables) that nothing ever copies,
    since neither startup.S initialises the section. It is now NOLOAD in main
    RAM after .bss, as the LPC parts keep it NOLOAD in their AHB bank, and
    the heap start follows it.
    firmware.stm: 157,512 -> 148,520 bytes. RAM use is unchanged.
2026-10-31 Menu: Give the message box a title and an OK button
    The message box of the cheat editor, which the skin selection uses as
    well, had no title, left the windows behind it as they were and said
    "Press A to continue". It now has the title "Error", greys out the
    browser area behind it (the cheat list did that itself when saving
    failed) and shows "OK" with the selection bar on it, which A or B
    confirm as in a menu. It is one line shorter, without the empty line at
    the bottom.
2026-10-31 Menu: Make menu windows wide enough for their title
    show_menu took the window width from the entries unless the title was
    longer, but a title takes its length plus 6 columns: draw_window puts
    a tee, a border piece and a corner on each side of it. With a longest
    entry as long as the title, or one character longer, the right tee
    landed on the corner or right next to it, as in the skin context menu
    ("Selected skin"). The window is now at least as wide as its title
    needs; of the current menus, only that one changes.
2026-10-31 Menu: Show buttons on even text columns
    Even text columns were on BG2 and odd ones on BG1, which was scrolled
    8 hi-res pixels to the right. The 4bpp button graphics exist only on
    BG1, so a button could start only on an odd column: help lines led
    with a space and began one column right of the text above them, and
    the cheat list's help line ran straight into the clock.
    Swap the layers: BG1 holds the even columns at scroll 0, and BG2 the
    odd ones, scrolled instead. Plain text stays where it was. The help
    lines drop their leading space. The code pad moves one column left and
    grows by two, so its text column is even and it stays centered; a
    check keeps the code pad and keyboard help columns even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
2026-10-31 Firmware: Print the menu's ellipsis in the system information
    The system information screen showed a Euro sign after "Calculating
    disk space" and "measuring": sysinfo.c still wrote the ellipsis of the
    old font (127 + 128), and 128 is the Euro sign in the CP1252 font.
    Write the menu's ellipsis ($81 + $8D) instead.
2026-11-01 Build: Add the gdb script for Black Magic Probe programming
    96b87d0e added `make program INTERFACE=bmp`, which runs src/bmp.gdb,
    but left the script itself out, so the target failed in a fresh clone.
2026-11-01 Menu: Name the button colors in the skin palette table
    The palette table still called colors 36-47, 52-63 and 65-79 reserved
    for button graphics of a later menu version, but the menu draws its
    buttons with them now (see "Buttons" in the same file).
2026-11-12 Firmware: Program the USB OUT endpoint's size before enabling it
    After an OUT transfer completed, the STM32 USB interrupt enabled the
    endpoint again (CNAK and EPENA in DOEPCTL) and only then wrote its
    transfer size and packet count to DOEPTSIZ. A packet arriving in
    between could prevent the endpoint from working.
