mrehkopf/sd2snes/(notices)

Notices in the files:
mk1-src/config.h:
This program is free software; you can redistribute it and/or modify
it under the terms of the GNU General Public License as published by
the Free Software Foundation; version 2 of the License only.
LICENSE: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
pcb/kicad/sd2snes_ldo.brd:
©2009, 2010 M. Rehkopf
pcb/kicad/RevD/sd2snes.brd:
©2009 - 2011 M. Rehkopf
pcb/kicad/RevE/sd2snes.brd:
©2009 - 2012 ikari_01
pcb/kicad/RevF/sd2snes.kicad_pcb:
©2009 - 2014 ikari_01
